zht043/MicroMouse-Team1/README.md

# MicroMouse-Team1

************************************************************************************************************************************

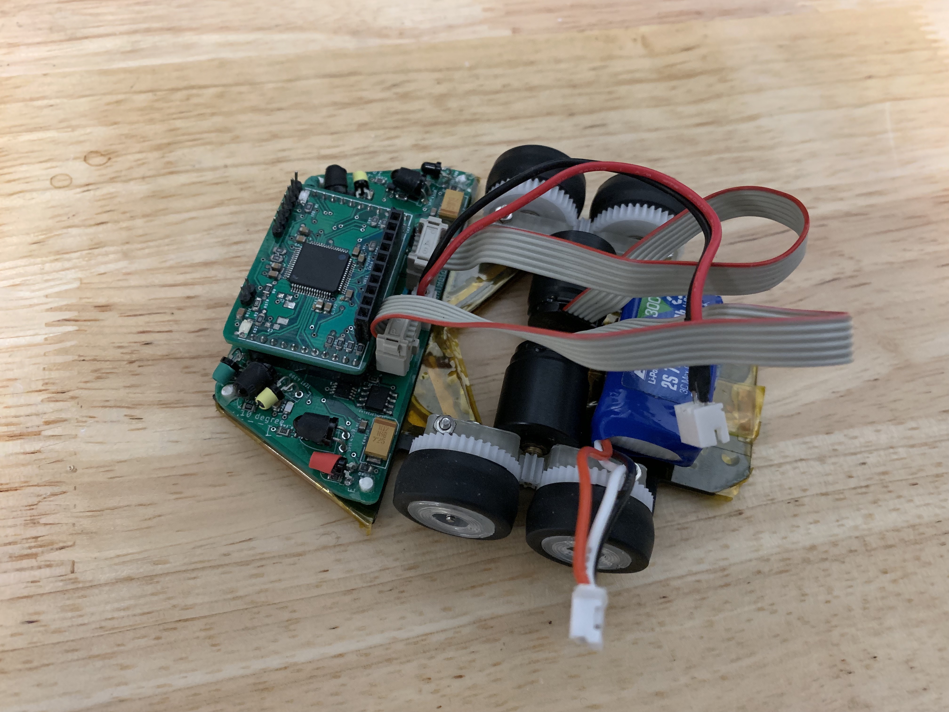
[picture p1: MicromouseRobot.jpg]
Micromouse Robot
