zht043/MicroMouse-Team1/Electrical Hardware/Datasheet/DOWN_ALL.PNG

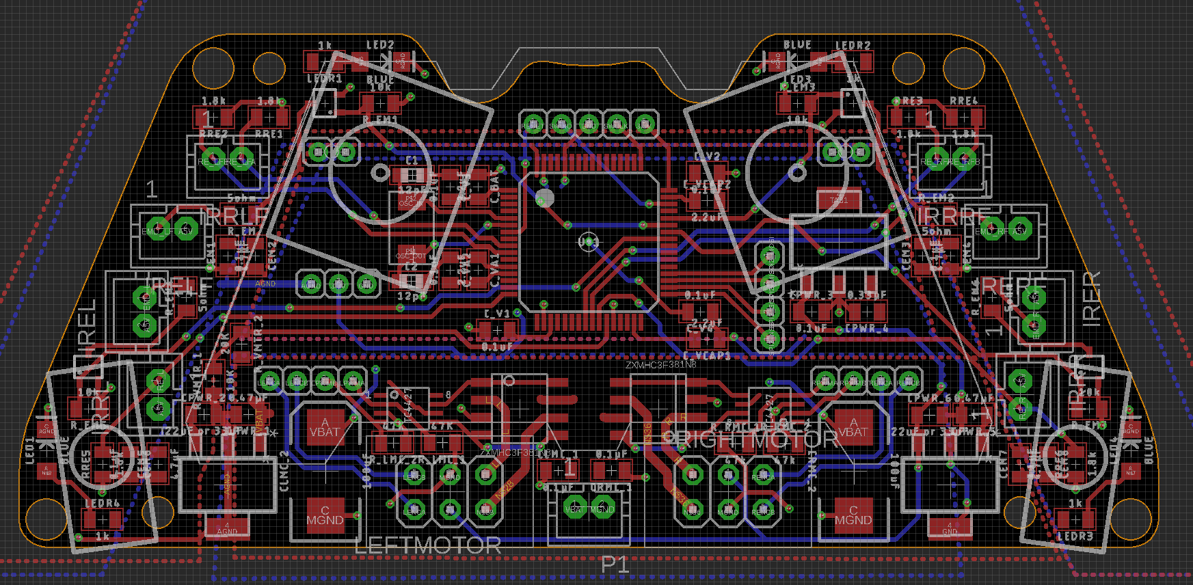
Electrical Hardware/Datasheet/DOWN_ALL.PNG
