zht043/MicroMouse-Team1/Electrical Hardware/Datasheet/DOWN_REST2.PNG

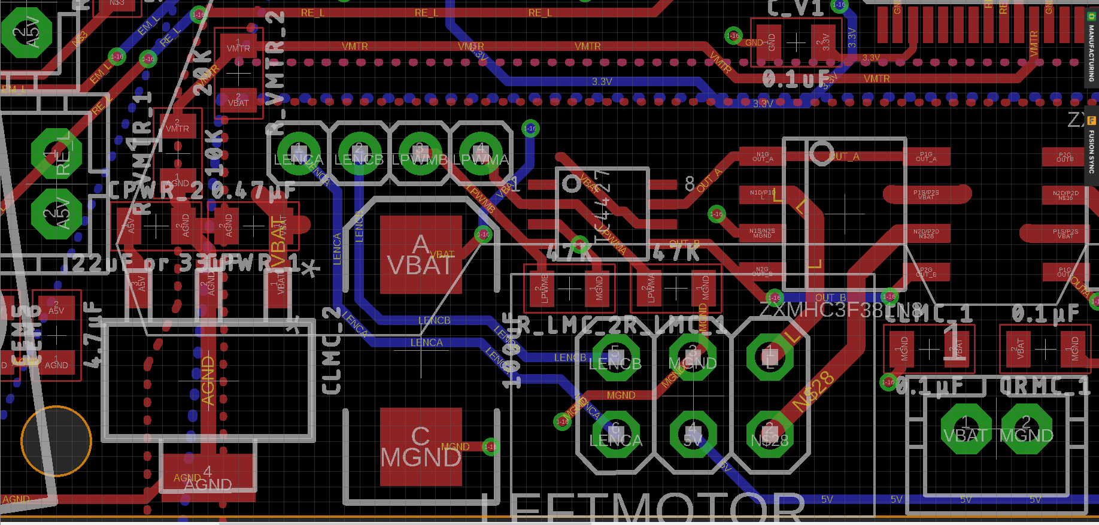
Electrical Hardware/Datasheet/DOWN_REST2.PNG
