zht043/MicroMouse-Team1/Electrical Hardware/Datasheet/DOWN_REST3.PNG

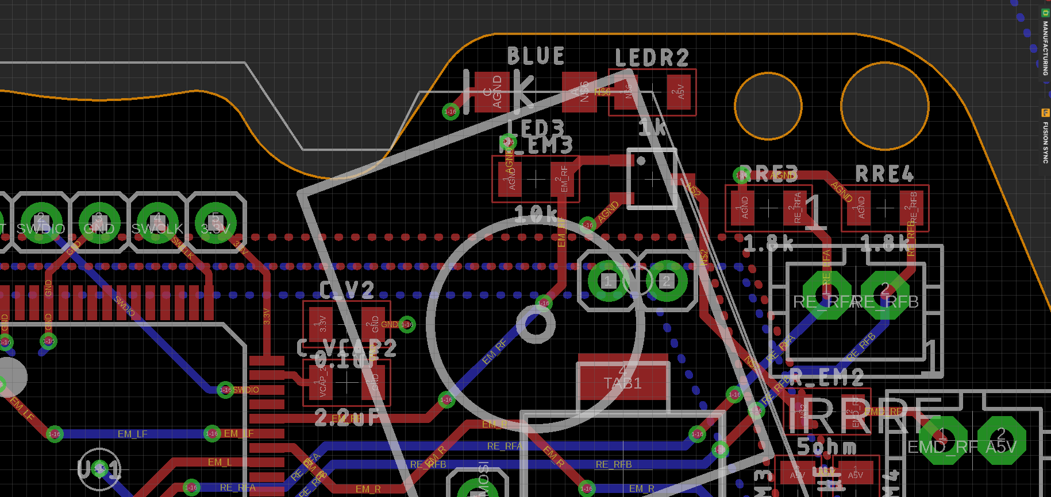
Electrical Hardware/Datasheet/DOWN_REST3.PNG
