zht043/MicroMouse-Team1/Electrical Hardware/Datasheet/DOWN_REST.PNG

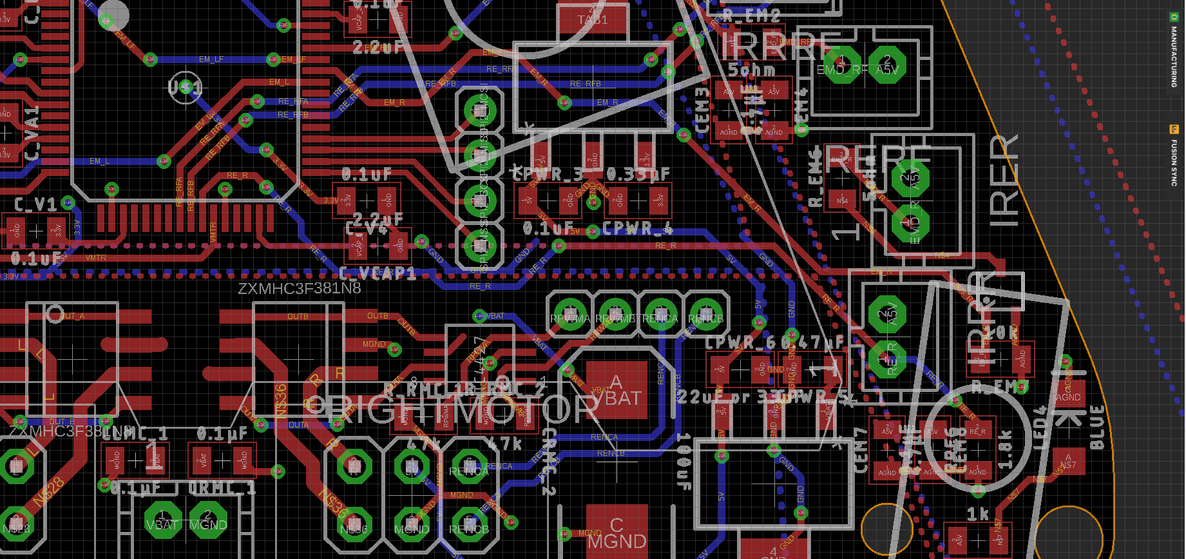
Electrical Hardware/Datasheet/DOWN_REST.PNG
