zht043/MicroMouse-Team1/Electrical Hardware/Datasheet/DOWN_uC.PNG

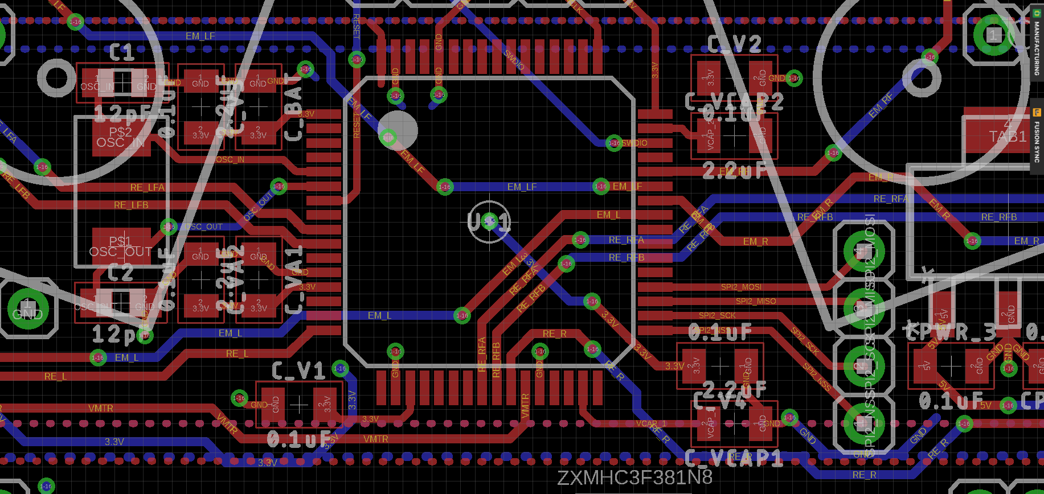
Electrical Hardware/Datasheet/DOWN_uC.PNG
