zht043/MicroMouse-Team1/Electrical Hardware/Datasheet/UP.PNG

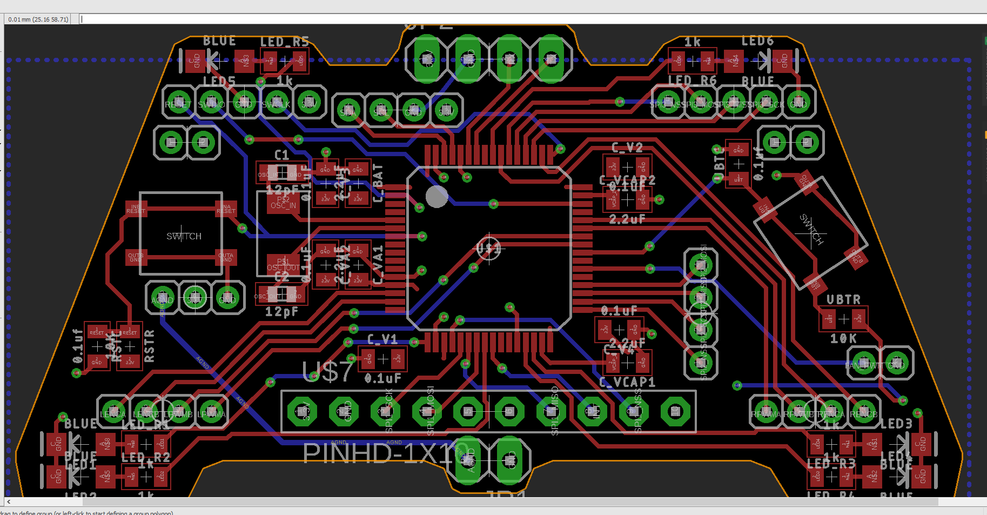
Electrical Hardware/Datasheet/UP.PNG
