zht043/MicroMouse-Team1/Electrical Hardware/Datasheet/UP_SCH.PNG

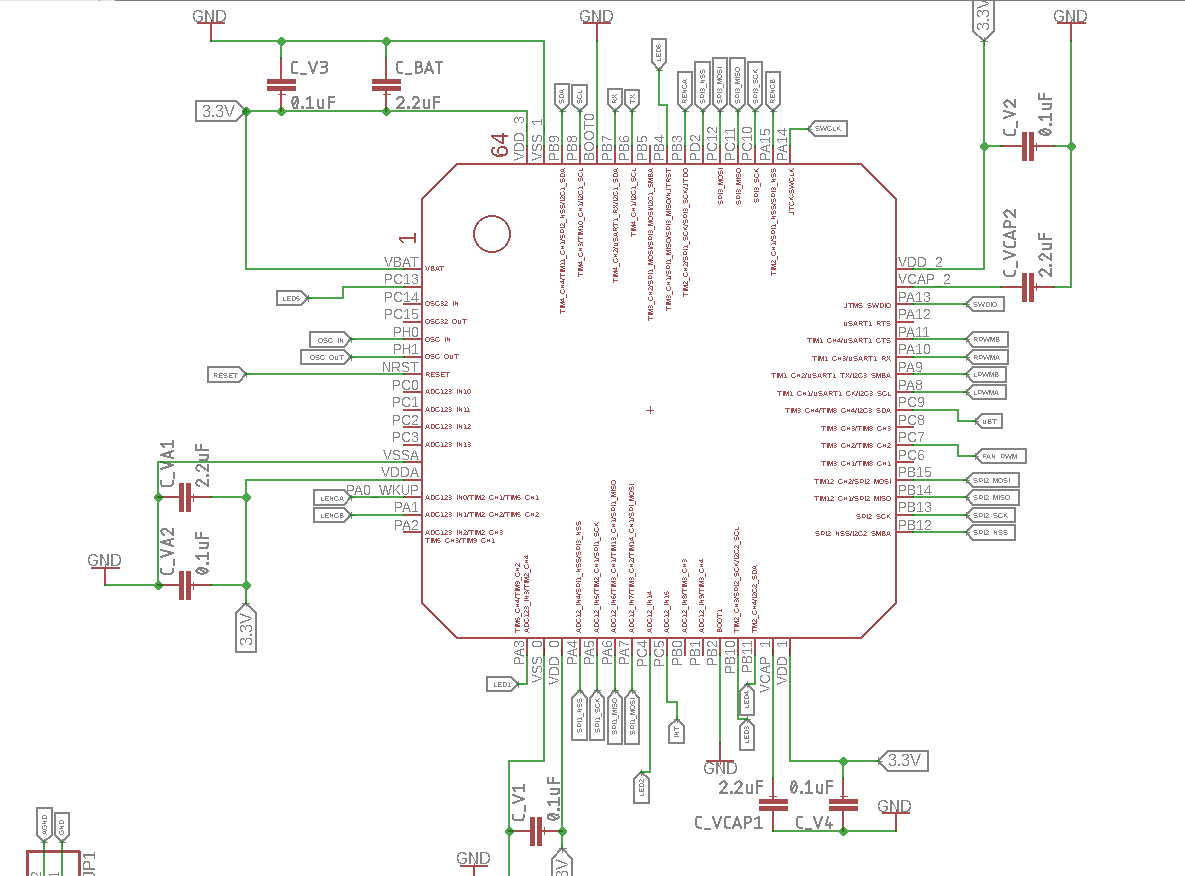
Electrical Hardware/Datasheet/UP_SCH.PNG
