zht043/MicroMouse-Team1/Reference materials/STM32 F4 block diagram.docx

Reference: STM32F40x Datasheet (Doc ID 022152 Rev 3) p. 18

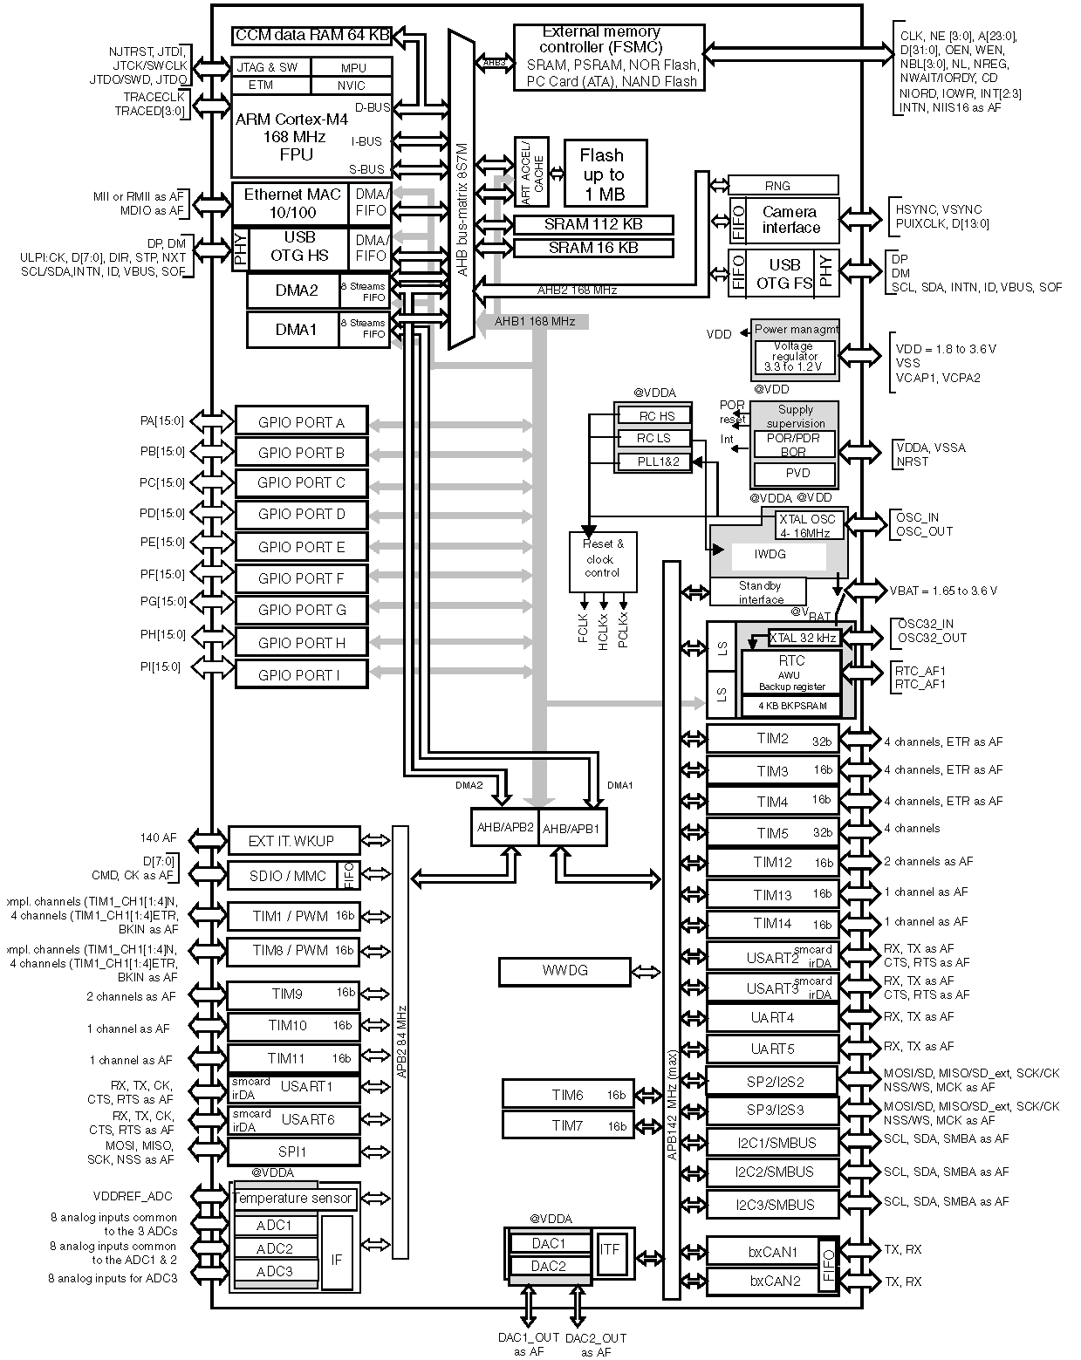
[picture p9: figure]
stm32f40x_block_diagram
