zht043/MicroMouse-Team1/Reference materials/Futura/week-1-lec-2-Peripherals-Intro.pptx

## Lecture 2

Peripharals Hardware Introduction

## IR Emitter Single

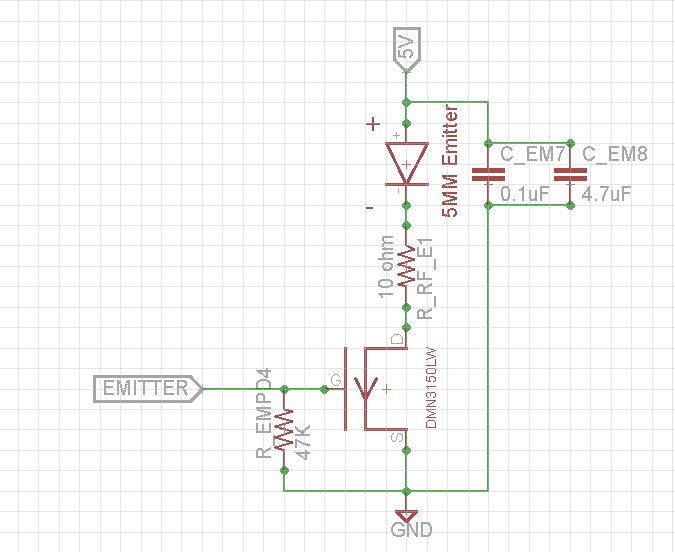
[picture p54: figure]

## Emitter Serial

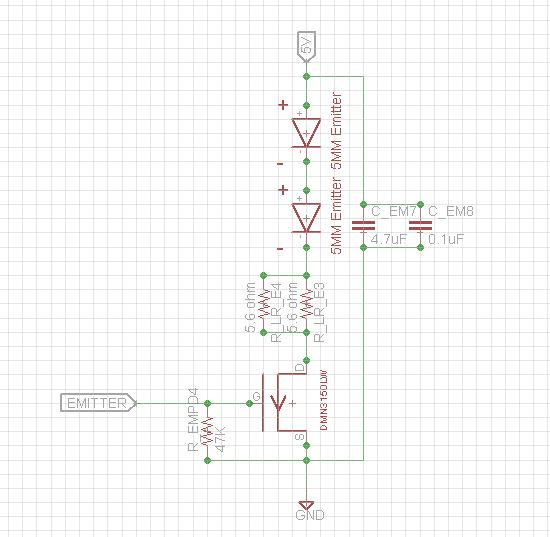
[picture p55: figure]

## IR Receiver

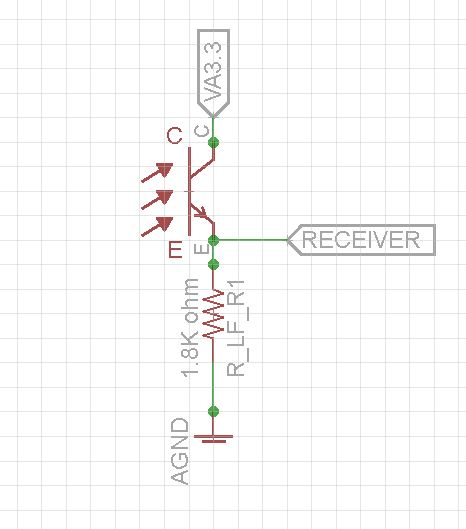
[picture p56: figure]

## IR Sensor Pulsing Timing

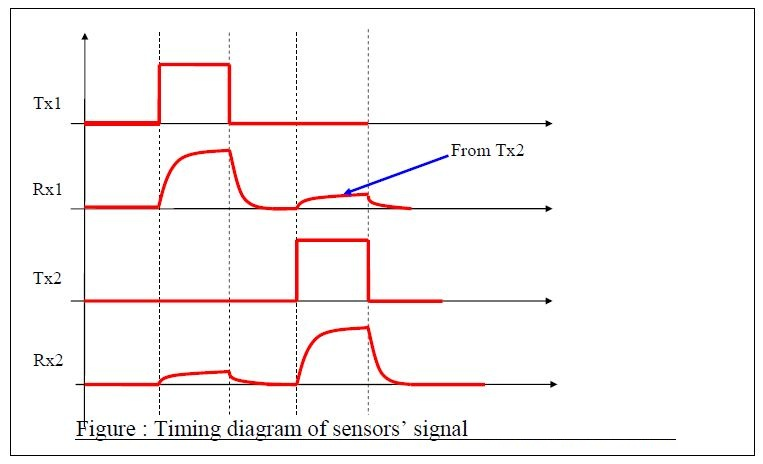
[picture p57: figure]

Delay between each sensor reading until all residues are gone

## Gyro

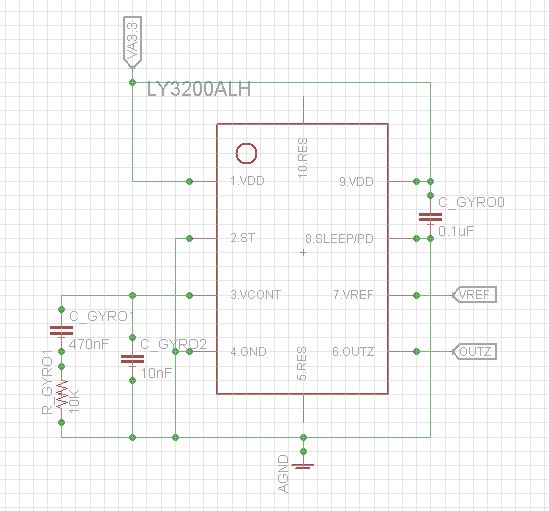
[picture p58: figure]

## Gyro Zero Point Drift

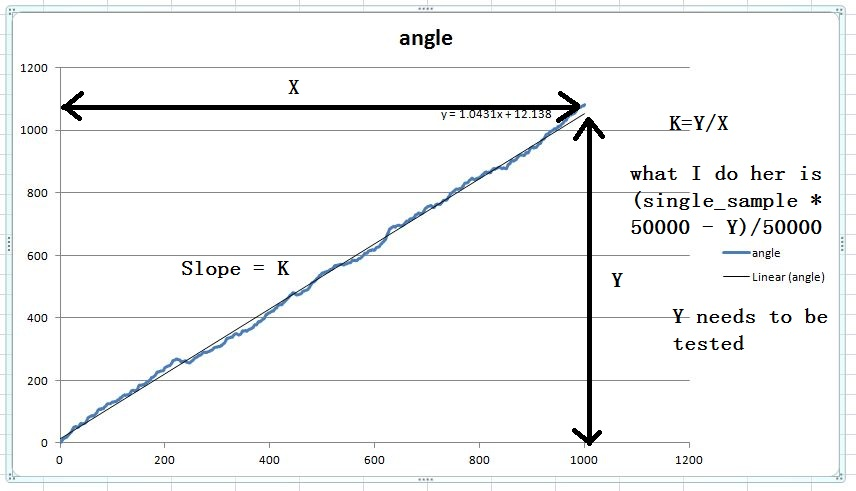
[picture p59: figure]

The accumulated angled when mouse is mouse moving with gyro zero point drifting is increased linearly

## Buzzer

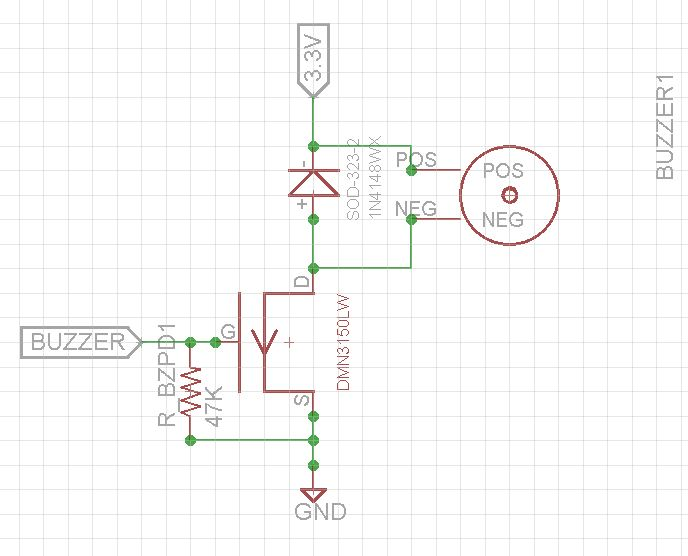
[picture p60: figure]

## Display

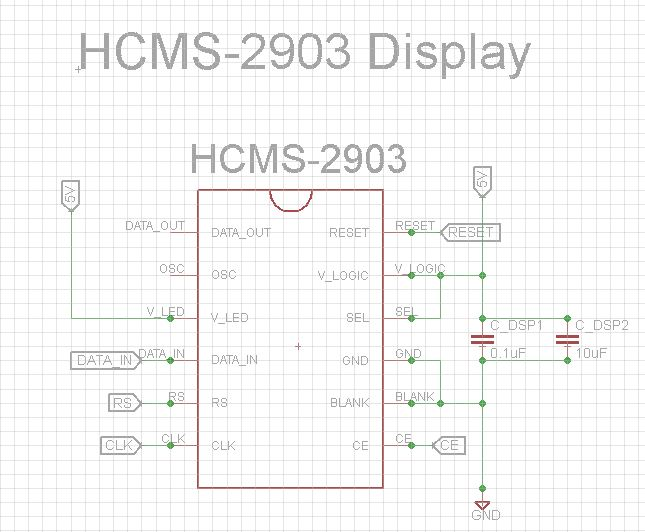
[picture p61: figure]

## Motor Driver

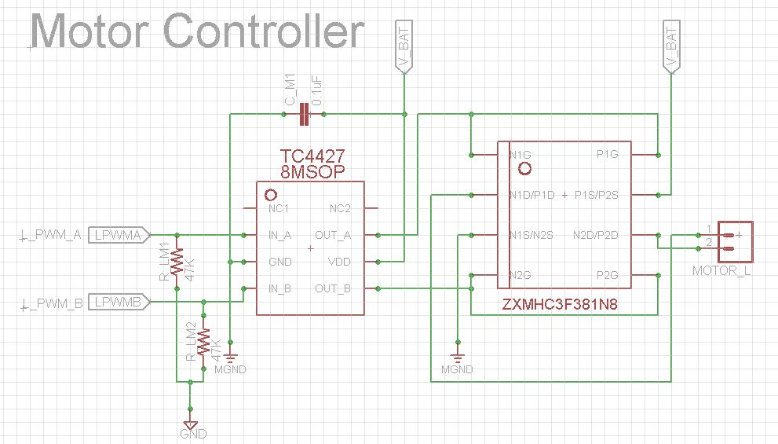
[picture p62: figure]

## Voltage Meter

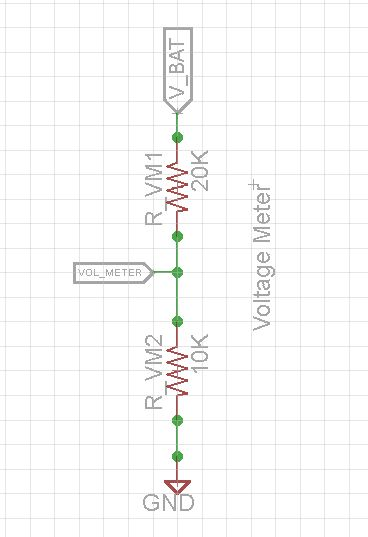
[picture p63: figure]

Keep track of the battery voltage to protect the batter from over discharging

## Power V_bat

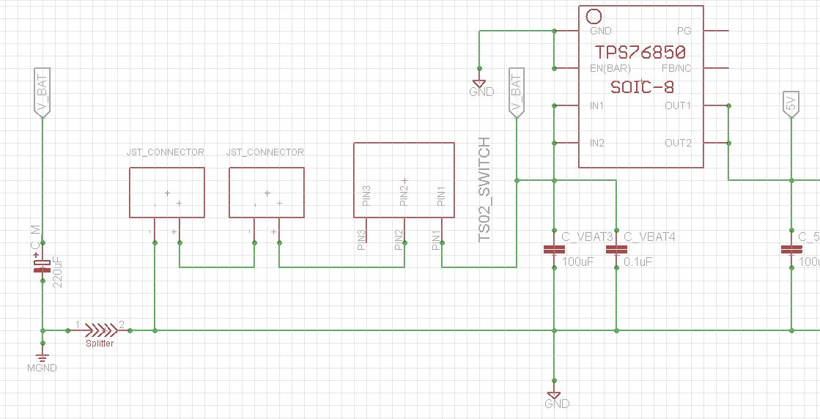
[picture p64: figure]

## Power 5V

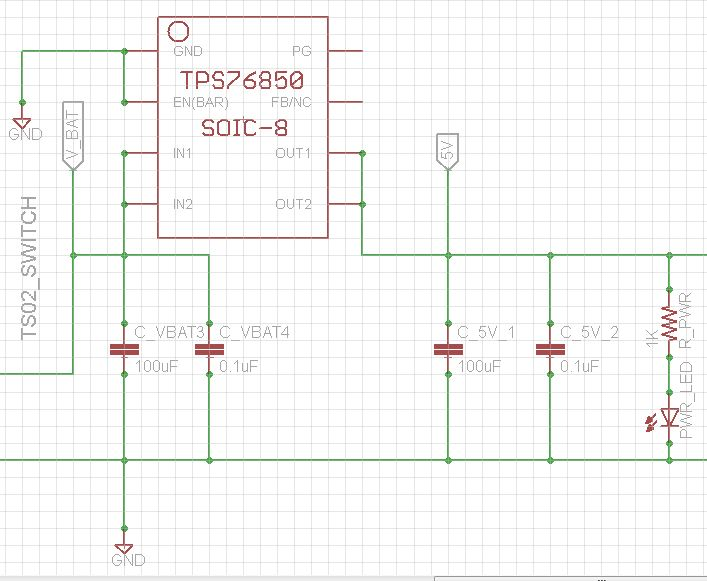
[picture p65: figure]

## Power 3.3V

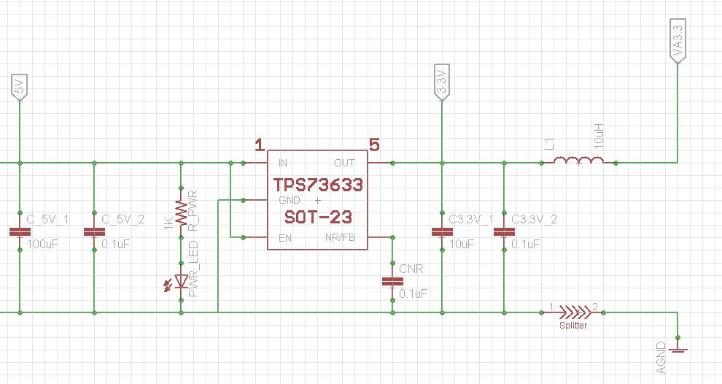
[picture p66: figure]
