zht043/MicroMouse-Team1/Reference materials/DMA Mapping.docx

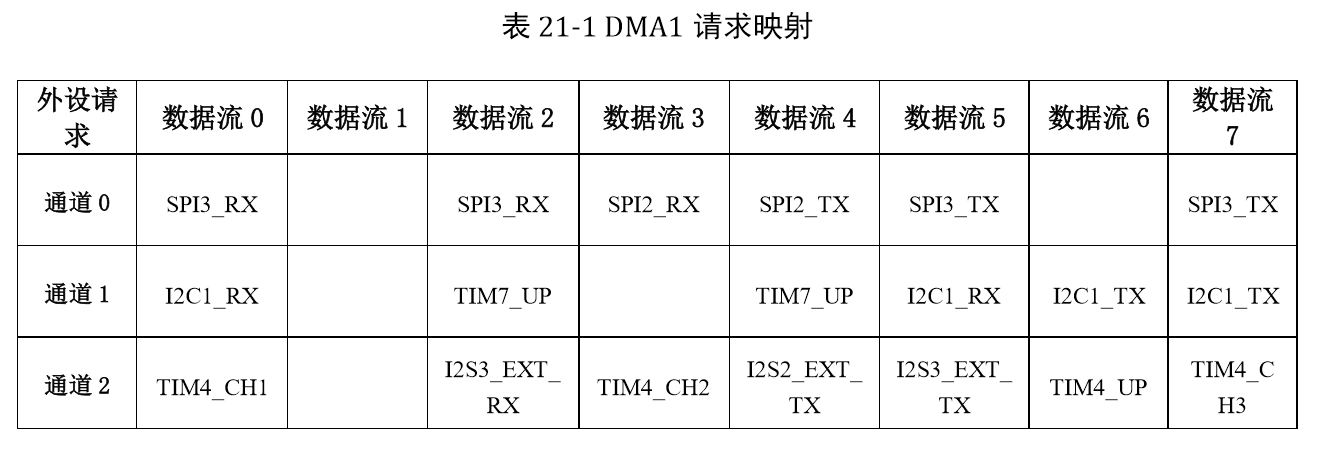
[picture p67: figure]
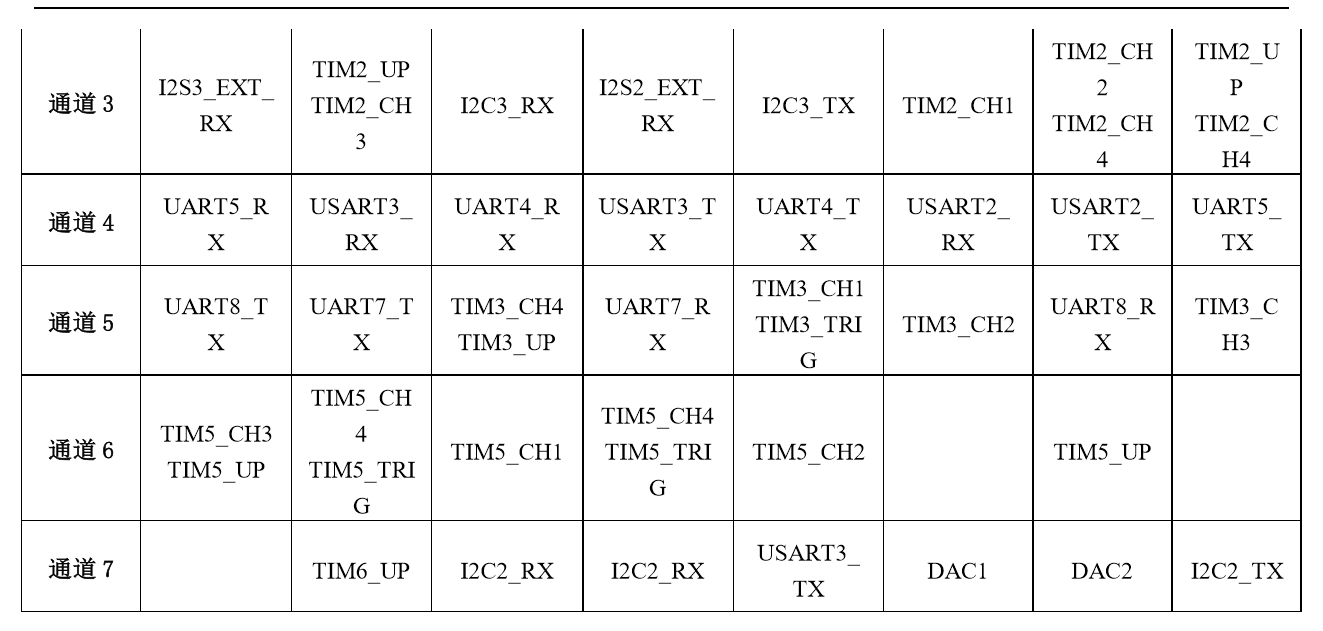
[picture p68: figure]
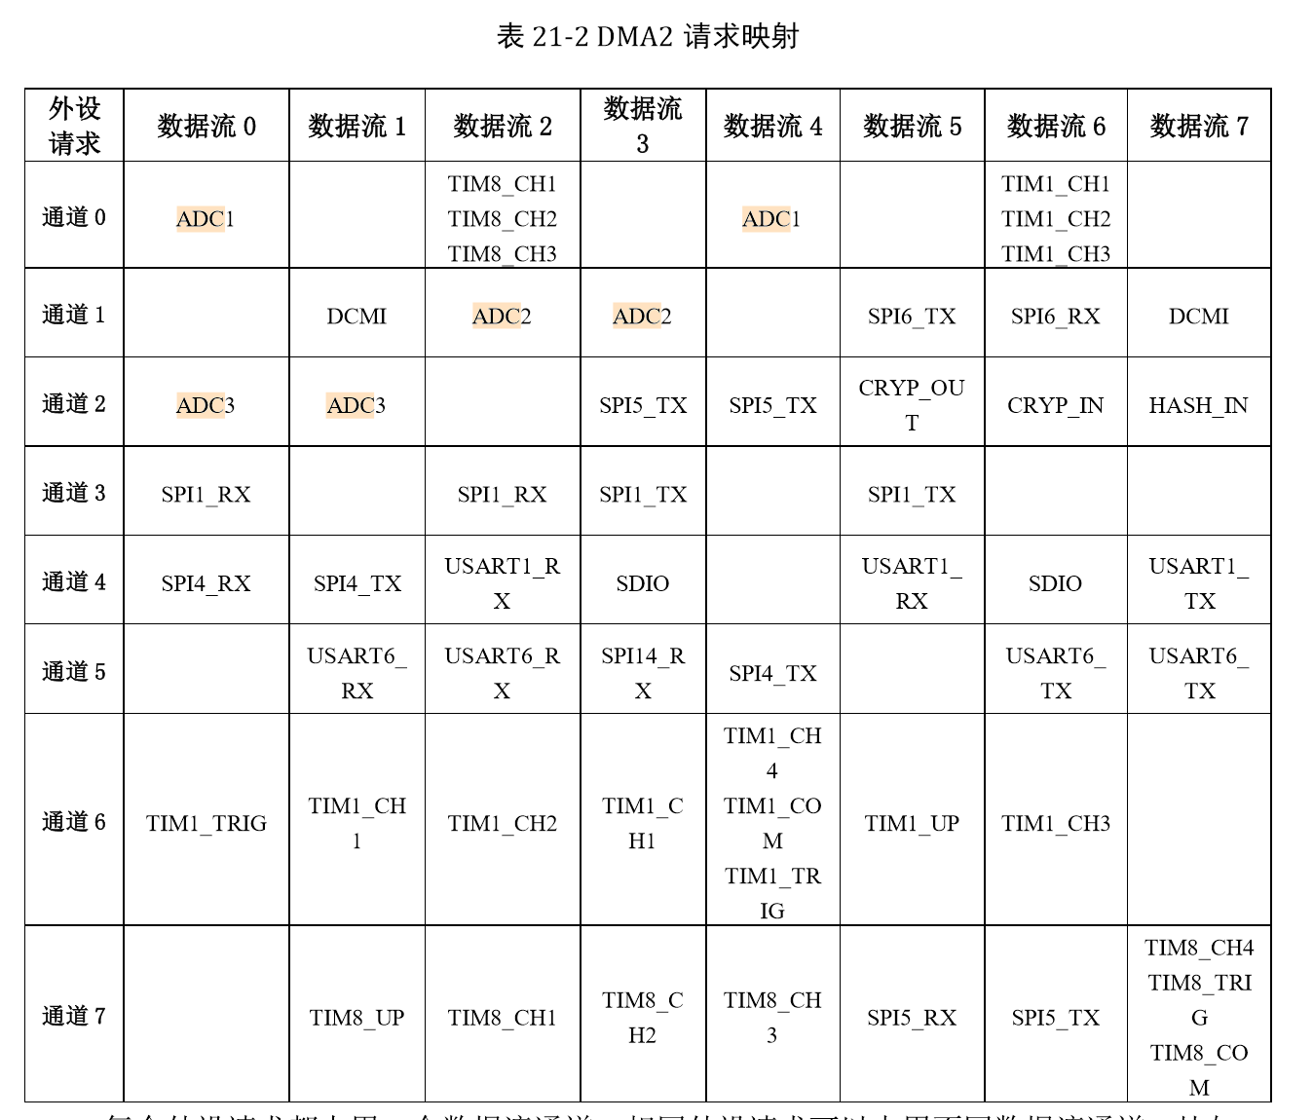
[picture p69: figure]
