zht043/MicroMouse-Team1/Reference materials/Capture2.PNG

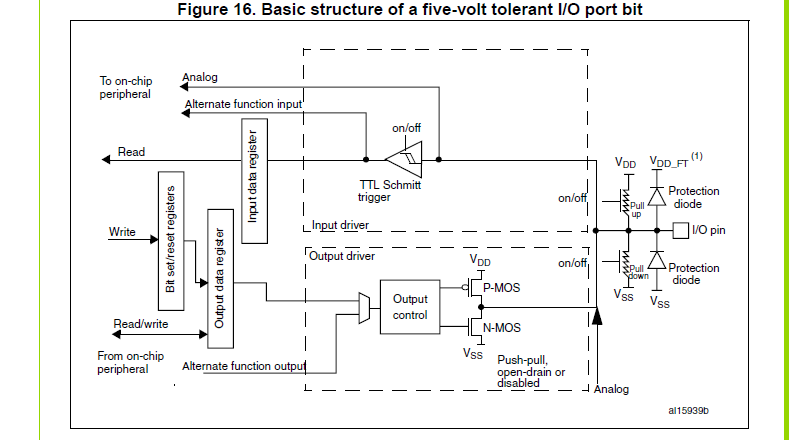
Reference materials/Capture2.PNG
