zht043/MicroMouse-Team1/Reference materials/Capture3.PNG

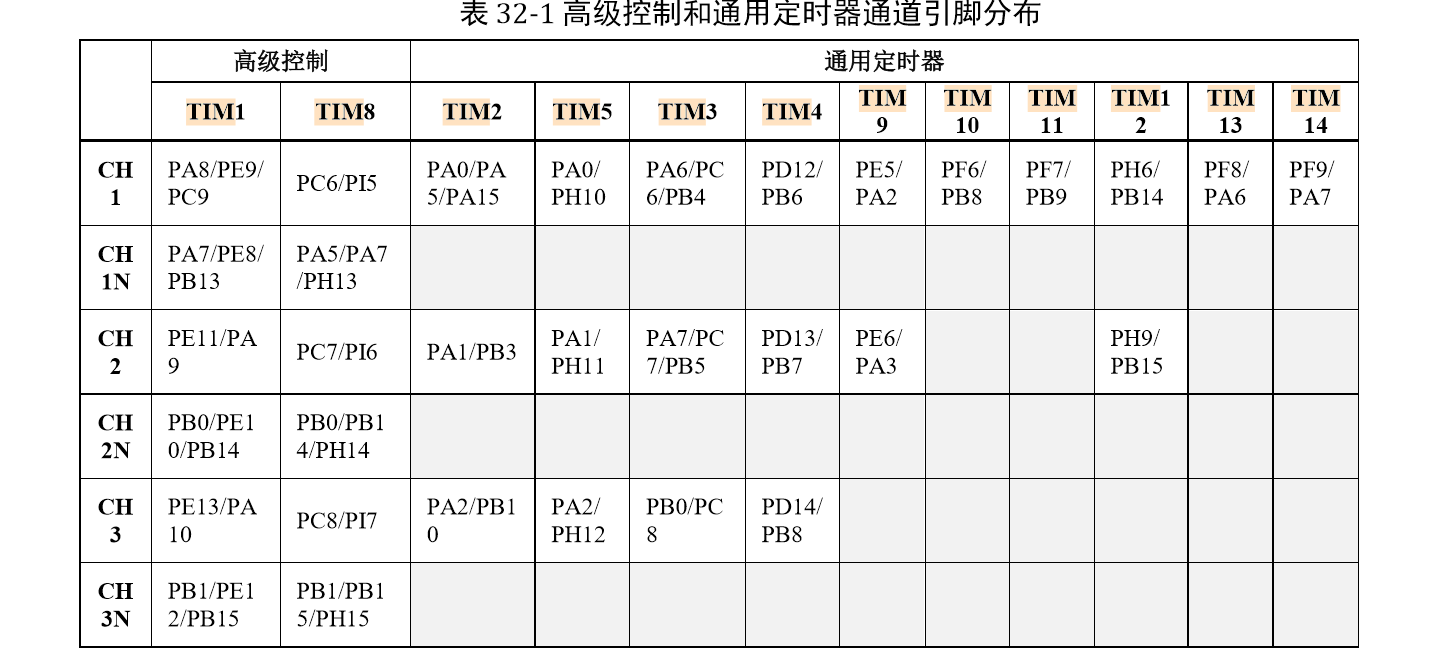
Reference materials/Capture3.PNG
