zht043/MicroMouse-Team1/Reference materials/Capture4.PNG

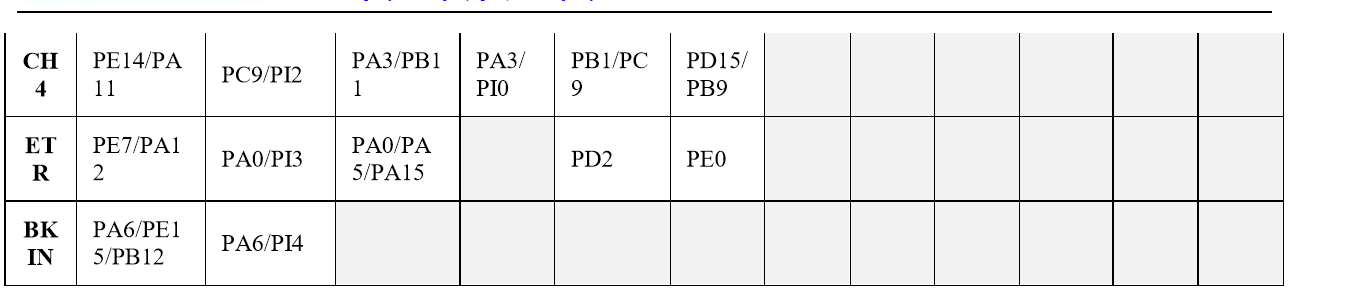
Reference materials/Capture4.PNG
