zht043/MicroMouse-Team1/Reference materials/Capture.PNG

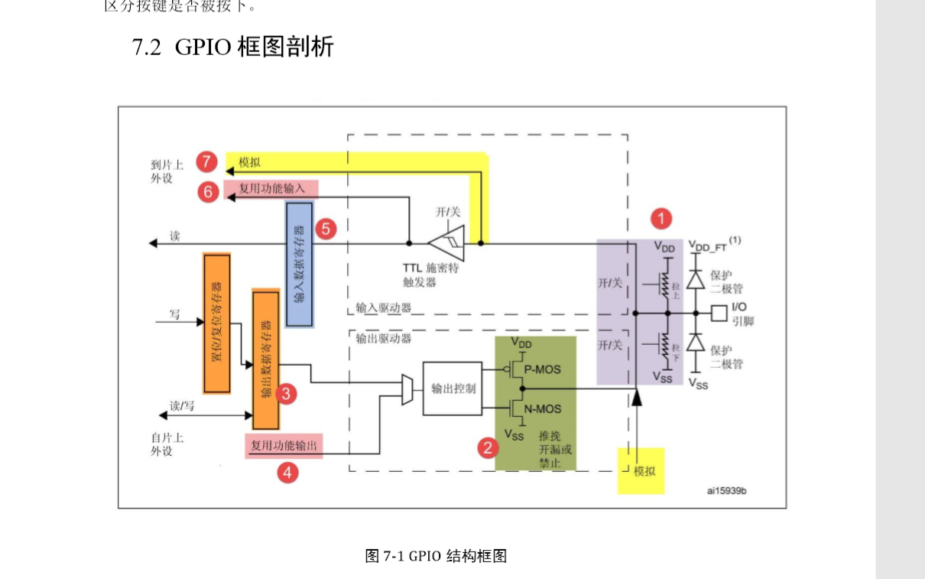
Reference materials/Capture.PNG
