zht043/MicroMouse-Team1/Reference materials/Pin_reference.jpg

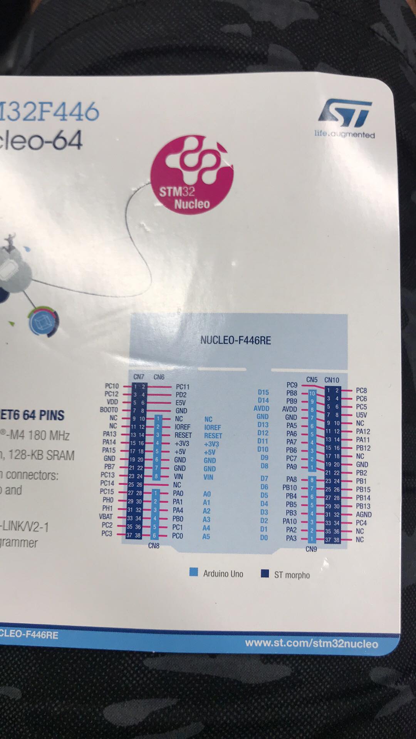
Reference materials/Pin_reference.jpg
