zht043/MicroMouse-Team1/Reference materials/stlink2.png

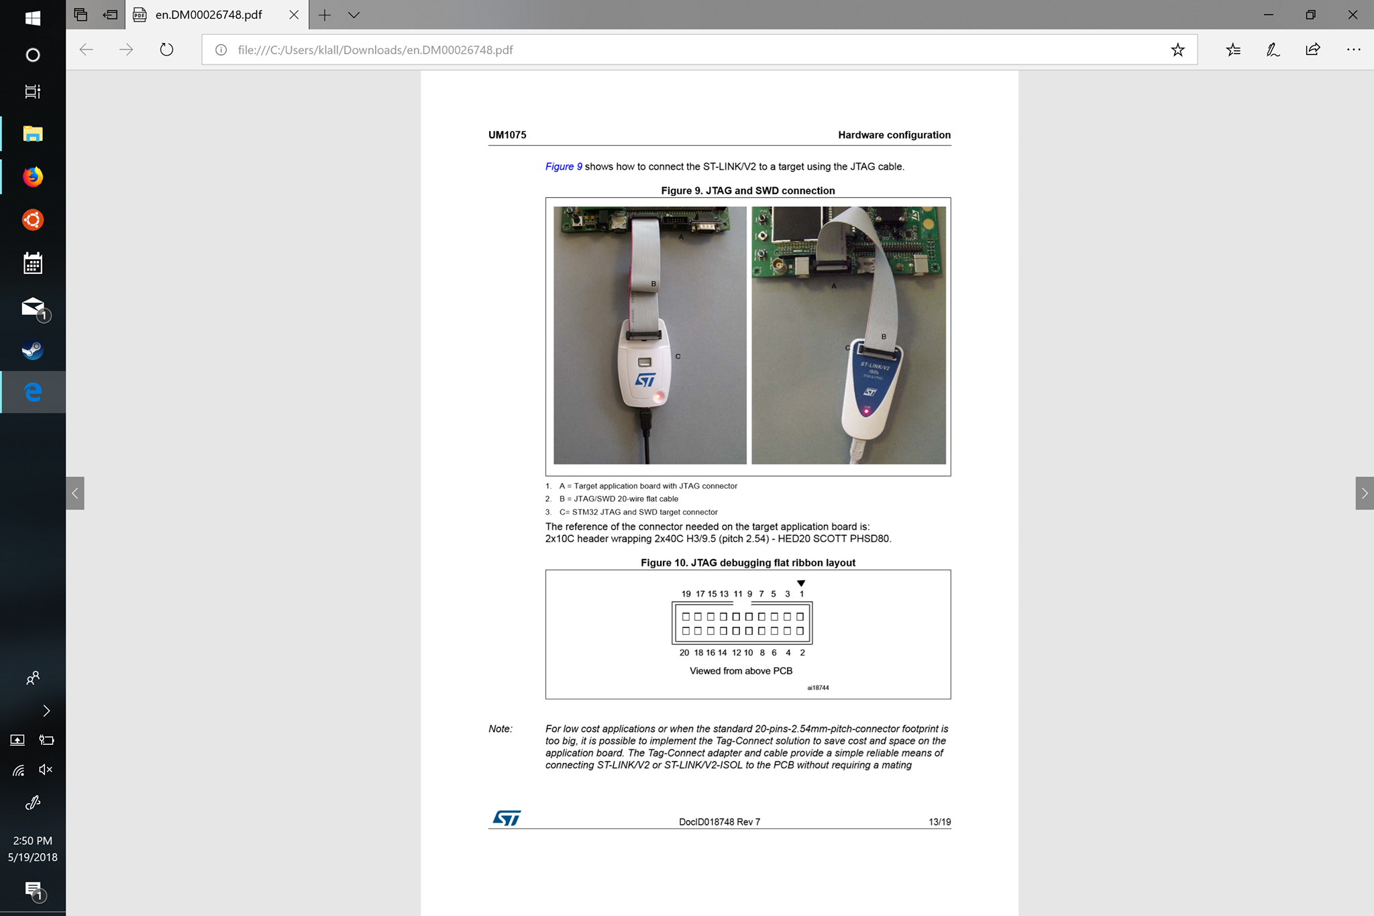
Reference materials/stlink2.png
