zht043/MicroMouse-Team1/Reference materials/stlink.png

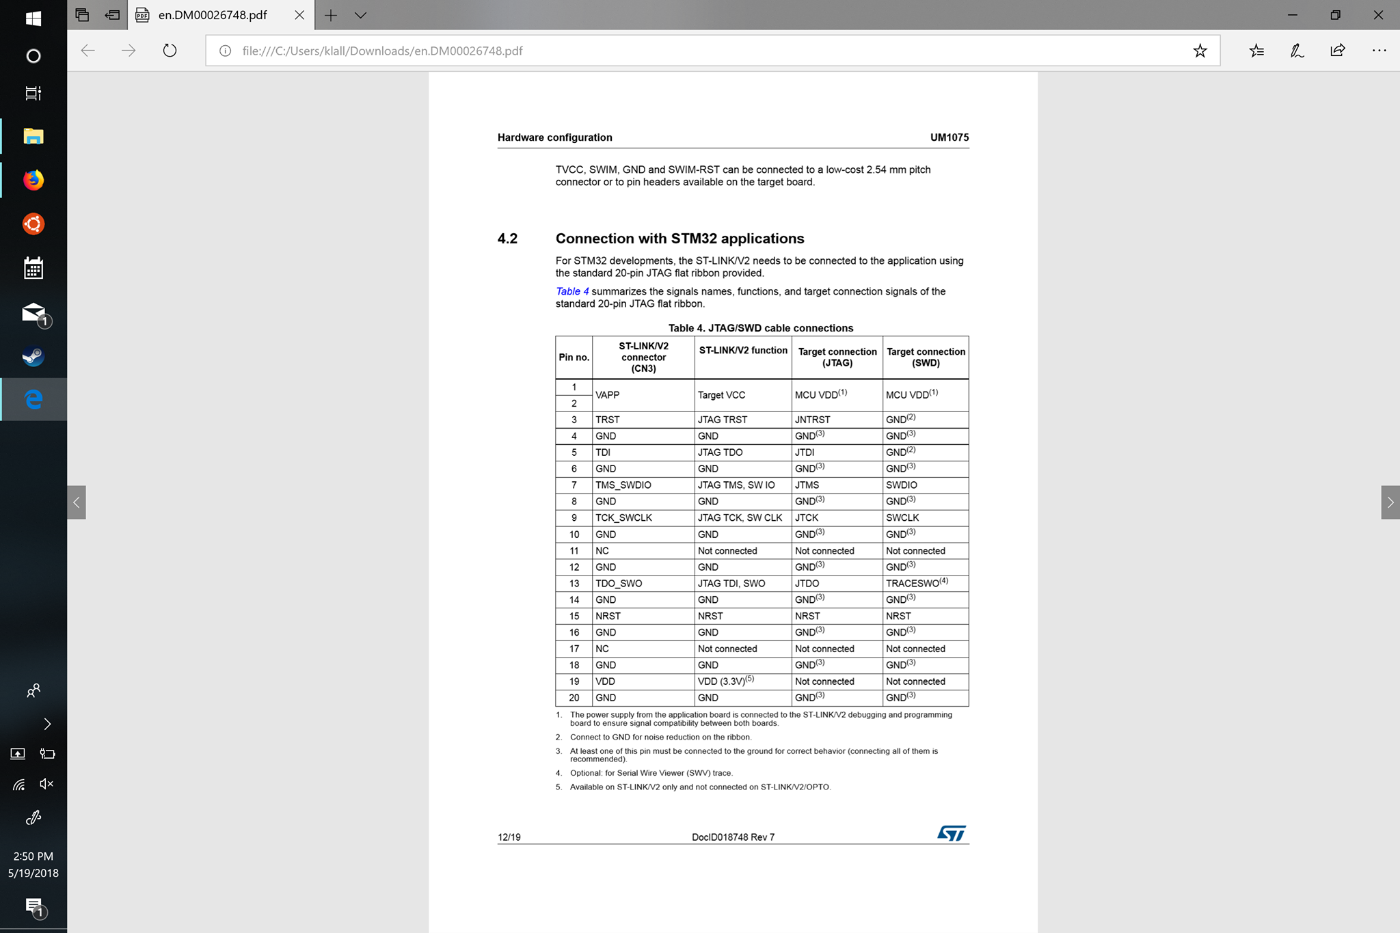
Reference materials/stlink.png
