zht043/MicroMouse-Team1/Mechanical Hardware/dxf files/ChassisFInalVersion.dxf

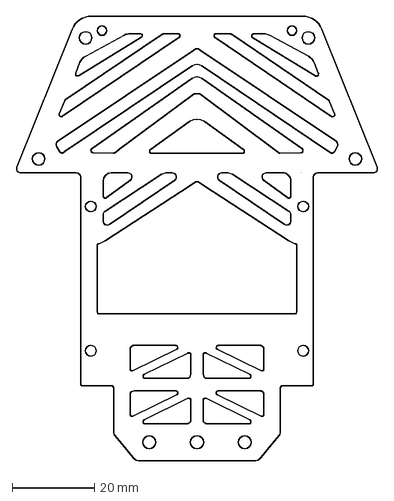
[picture p81: CAD file, 2018-03-11]
Mechanical Hardware/dxf files/ChassisFInalVersion.dxf
87.6 x 107.9 mm
