zht043/MicroMouse-Team1/Reference materials/Futura/FuturaProject/obj/micromouse_test.htm

# Static Call Graph for image ..\obj\micromouse_test.axf

#<CALLGRAPH># ARM Linker, 5.03 [Build 24]: Last Updated: Fri Feb 03 22:17:40 2017

### Maximum Stack Usage = 320 bytes + Unknown(Functions without stacksize, Cycles, Untraceable Function Pointers)

### Call chain for Maximum Stack Depth:

_printf_f ⇒ _printf_fp_dec ⇒ _printf_fp_dec_real ⇒ _fp_digits ⇒ _btod_etento ⇒ _btod_emul ⇒ _e2e

### Functions with no stack information

- __user_initial_stackheap

### Mutually Recursive functions

- ADC_IRQHandler ⇒ ADC_IRQHandler

### Function Pointers

- ADC_IRQHandler from startup_stm32f4xx.o(.text) referenced from startup_stm32f4xx.o(RESET)
- BusFault_Handler from stm32f4xx_it.o(.text) referenced from startup_stm32f4xx.o(RESET)
- CAN1_RX0_IRQHandler from startup_stm32f4xx.o(.text) referenced from startup_stm32f4xx.o(RESET)
- CAN1_RX1_IRQHandler from startup_stm32f4xx.o(.text) referenced from startup_stm32f4xx.o(RESET)
- CAN1_SCE_IRQHandler from startup_stm32f4xx.o(.text) referenced from startup_stm32f4xx.o(RESET)
- CAN1_TX_IRQHandler from startup_stm32f4xx.o(.text) referenced from startup_stm32f4xx.o(RESET)
- CAN2_RX0_IRQHandler from startup_stm32f4xx.o(.text) referenced from startup_stm32f4xx.o(RESET)
- CAN2_RX1_IRQHandler from startup_stm32f4xx.o(.text) referenced from startup_stm32f4xx.o(RESET)
- CAN2_SCE_IRQHandler from startup_stm32f4xx.o(.text) referenced from startup_stm32f4xx.o(RESET)
- CAN2_TX_IRQHandler from startup_stm32f4xx.o(.text) referenced from startup_stm32f4xx.o(RESET)
- CRYP_IRQHandler from startup_stm32f4xx.o(.text) referenced from startup_stm32f4xx.o(RESET)
- DCMI_IRQHandler from startup_stm32f4xx.o(.text) referenced from startup_stm32f4xx.o(RESET)
- DMA1_Stream0_IRQHandler from startup_stm32f4xx.o(.text) referenced from startup_stm32f4xx.o(RESET)
- DMA1_Stream1_IRQHandler from startup_stm32f4xx.o(.text) referenced from startup_stm32f4xx.o(RESET)
- DMA1_Stream2_IRQHandler from startup_stm32f4xx.o(.text) referenced from startup_stm32f4xx.o(RESET)
- DMA1_Stream3_IRQHandler from startup_stm32f4xx.o(.text) referenced from startup_stm32f4xx.o(RESET)
- DMA1_Stream4_IRQHandler from startup_stm32f4xx.o(.text) referenced from startup_stm32f4xx.o(RESET)
- DMA1_Stream5_IRQHandler from startup_stm32f4xx.o(.text) referenced from startup_stm32f4xx.o(RESET)
- DMA1_Stream6_IRQHandler from startup_stm32f4xx.o(.text) referenced from startup_stm32f4xx.o(RESET)
- DMA1_Stream7_IRQHandler from startup_stm32f4xx.o(.text) referenced from startup_stm32f4xx.o(RESET)
- DMA2_Stream0_IRQHandler from startup_stm32f4xx.o(.text) referenced from startup_stm32f4xx.o(RESET)
- DMA2_Stream1_IRQHandler from startup_stm32f4xx.o(.text) referenced from startup_stm32f4xx.o(RESET)
- DMA2_Stream2_IRQHandler from startup_stm32f4xx.o(.text) referenced from startup_stm32f4xx.o(RESET)
- DMA2_Stream3_IRQHandler from startup_stm32f4xx.o(.text) referenced from startup_stm32f4xx.o(RESET)
- DMA2_Stream4_IRQHandler from startup_stm32f4xx.o(.text) referenced from startup_stm32f4xx.o(RESET)
- DMA2_Stream5_IRQHandler from startup_stm32f4xx.o(.text) referenced from startup_stm32f4xx.o(RESET)
- DMA2_Stream6_IRQHandler from startup_stm32f4xx.o(.text) referenced from startup_stm32f4xx.o(RESET)
- DMA2_Stream7_IRQHandler from startup_stm32f4xx.o(.text) referenced from startup_stm32f4xx.o(RESET)
- DebugMon_Handler from stm32f4xx_it.o(.text) referenced from startup_stm32f4xx.o(RESET)
- ETH_IRQHandler from startup_stm32f4xx.o(.text) referenced from startup_stm32f4xx.o(RESET)
- ETH_WKUP_IRQHandler from startup_stm32f4xx.o(.text) referenced from startup_stm32f4xx.o(RESET)
- EXTI0_IRQHandler from startup_stm32f4xx.o(.text) referenced from startup_stm32f4xx.o(RESET)
- EXTI15_10_IRQHandler from stm32f4xx_it.o(.text) referenced from startup_stm32f4xx.o(RESET)
- EXTI1_IRQHandler from startup_stm32f4xx.o(.text) referenced from startup_stm32f4xx.o(RESET)
- EXTI2_IRQHandler from startup_stm32f4xx.o(.text) referenced from startup_stm32f4xx.o(RESET)
- EXTI3_IRQHandler from startup_stm32f4xx.o(.text) referenced from startup_stm32f4xx.o(RESET)
- EXTI4_IRQHandler from startup_stm32f4xx.o(.text) referenced from startup_stm32f4xx.o(RESET)
- EXTI9_5_IRQHandler from stm32f4xx_it.o(.text) referenced from startup_stm32f4xx.o(RESET)
- FLASH_IRQHandler from startup_stm32f4xx.o(.text) referenced from startup_stm32f4xx.o(RESET)
- FPU_IRQHandler from startup_stm32f4xx.o(.text) referenced from startup_stm32f4xx.o(RESET)
- FSMC_IRQHandler from startup_stm32f4xx.o(.text) referenced from startup_stm32f4xx.o(RESET)
- HASH_RNG_IRQHandler from startup_stm32f4xx.o(.text) referenced from startup_stm32f4xx.o(RESET)
- HardFault_Handler from stm32f4xx_it.o(.text) referenced from startup_stm32f4xx.o(RESET)
- I2C1_ER_IRQHandler from startup_stm32f4xx.o(.text) referenced from startup_stm32f4xx.o(RESET)
- I2C1_EV_IRQHandler from startup_stm32f4xx.o(.text) referenced from startup_stm32f4xx.o(RESET)
- I2C2_ER_IRQHandler from startup_stm32f4xx.o(.text) referenced from startup_stm32f4xx.o(RESET)
- I2C2_EV_IRQHandler from startup_stm32f4xx.o(.text) referenced from startup_stm32f4xx.o(RESET)
- I2C3_ER_IRQHandler from startup_stm32f4xx.o(.text) referenced from startup_stm32f4xx.o(RESET)
- I2C3_EV_IRQHandler from startup_stm32f4xx.o(.text) referenced from startup_stm32f4xx.o(RESET)
- MemManage_Handler from stm32f4xx_it.o(.text) referenced from startup_stm32f4xx.o(RESET)
- NMI_Handler from stm32f4xx_it.o(.text) referenced from startup_stm32f4xx.o(RESET)
- OTG_FS_IRQHandler from startup_stm32f4xx.o(.text) referenced from startup_stm32f4xx.o(RESET)
- OTG_FS_WKUP_IRQHandler from startup_stm32f4xx.o(.text) referenced from startup_stm32f4xx.o(RESET)
- OTG_HS_EP1_IN_IRQHandler from startup_stm32f4xx.o(.text) referenced from startup_stm32f4xx.o(RESET)
- OTG_HS_EP1_OUT_IRQHandler from startup_stm32f4xx.o(.text) referenced from startup_stm32f4xx.o(RESET)
- OTG_HS_IRQHandler from startup_stm32f4xx.o(.text) referenced from startup_stm32f4xx.o(RESET)
- OTG_HS_WKUP_IRQHandler from startup_stm32f4xx.o(.text) referenced from startup_stm32f4xx.o(RESET)
- PVD_IRQHandler from startup_stm32f4xx.o(.text) referenced from startup_stm32f4xx.o(RESET)
- PendSV_Handler from stm32f4xx_it.o(.text) referenced from startup_stm32f4xx.o(RESET)
- RCC_IRQHandler from startup_stm32f4xx.o(.text) referenced from startup_stm32f4xx.o(RESET)
- RTC_Alarm_IRQHandler from startup_stm32f4xx.o(.text) referenced from startup_stm32f4xx.o(RESET)
- RTC_WKUP_IRQHandler from startup_stm32f4xx.o(.text) referenced from startup_stm32f4xx.o(RESET)
- Reset_Handler from startup_stm32f4xx.o(.text) referenced from startup_stm32f4xx.o(RESET)
- SDIO_IRQHandler from startup_stm32f4xx.o(.text) referenced from startup_stm32f4xx.o(RESET)
- SPI1_IRQHandler from startup_stm32f4xx.o(.text) referenced from startup_stm32f4xx.o(RESET)
- SPI2_IRQHandler from startup_stm32f4xx.o(.text) referenced from startup_stm32f4xx.o(RESET)
- SPI3_IRQHandler from startup_stm32f4xx.o(.text) referenced from startup_stm32f4xx.o(RESET)
- SVC_Handler from stm32f4xx_it.o(.text) referenced from startup_stm32f4xx.o(RESET)
- SysTick_Handler from stm32f4xx_it.o(.text) referenced from startup_stm32f4xx.o(RESET)
- SystemInit from system_stm32f4xx.o(.text) referenced from startup_stm32f4xx.o(.text)
- TAMP_STAMP_IRQHandler from startup_stm32f4xx.o(.text) referenced from startup_stm32f4xx.o(RESET)
- TIM1_BRK_TIM9_IRQHandler from startup_stm32f4xx.o(.text) referenced from startup_stm32f4xx.o(RESET)
- TIM1_CC_IRQHandler from startup_stm32f4xx.o(.text) referenced from startup_stm32f4xx.o(RESET)
- TIM1_TRG_COM_TIM11_IRQHandler from startup_stm32f4xx.o(.text) referenced from startup_stm32f4xx.o(RESET)
- TIM1_UP_TIM10_IRQHandler from startup_stm32f4xx.o(.text) referenced from startup_stm32f4xx.o(RESET)
- TIM2_IRQHandler from startup_stm32f4xx.o(.text) referenced from startup_stm32f4xx.o(RESET)
- TIM3_IRQHandler from startup_stm32f4xx.o(.text) referenced from startup_stm32f4xx.o(RESET)
- TIM4_IRQHandler from startup_stm32f4xx.o(.text) referenced from startup_stm32f4xx.o(RESET)
- TIM5_IRQHandler from startup_stm32f4xx.o(.text) referenced from startup_stm32f4xx.o(RESET)
- TIM6_DAC_IRQHandler from startup_stm32f4xx.o(.text) referenced from startup_stm32f4xx.o(RESET)
- TIM7_IRQHandler from startup_stm32f4xx.o(.text) referenced from startup_stm32f4xx.o(RESET)
- TIM8_BRK_TIM12_IRQHandler from startup_stm32f4xx.o(.text) referenced from startup_stm32f4xx.o(RESET)
- TIM8_CC_IRQHandler from startup_stm32f4xx.o(.text) referenced from startup_stm32f4xx.o(RESET)
- TIM8_TRG_COM_TIM14_IRQHandler from startup_stm32f4xx.o(.text) referenced from startup_stm32f4xx.o(RESET)
- TIM8_UP_TIM13_IRQHandler from startup_stm32f4xx.o(.text) referenced from startup_stm32f4xx.o(RESET)
- UART4_IRQHandler from startup_stm32f4xx.o(.text) referenced from startup_stm32f4xx.o(RESET)
- UART5_IRQHandler from startup_stm32f4xx.o(.text) referenced from startup_stm32f4xx.o(RESET)
- USART1_IRQHandler from startup_stm32f4xx.o(.text) referenced from startup_stm32f4xx.o(RESET)
- USART2_IRQHandler from startup_stm32f4xx.o(.text) referenced from startup_stm32f4xx.o(RESET)
- USART3_IRQHandler from startup_stm32f4xx.o(.text) referenced from startup_stm32f4xx.o(RESET)
- USART6_IRQHandler from startup_stm32f4xx.o(.text) referenced from startup_stm32f4xx.o(RESET)
- UsageFault_Handler from stm32f4xx_it.o(.text) referenced from startup_stm32f4xx.o(RESET)
- WWDG_IRQHandler from startup_stm32f4xx.o(.text) referenced from startup_stm32f4xx.o(RESET)
- __backspace from backspace.o(.text) referenced from scanf_char_file.o(.text)
- __main from __main.o(!!!main) referenced from startup_stm32f4xx.o(.text)
- _get_lc_ctype from lc_ctype_c.o(locale$$code) referenced from rt_ctype_table.o(.text)
- _printf_input_char from _printf_char_common.o(.text) referenced from _printf_char_common.o(.text)
- _scanf_char_input from scanf_char.o(.text) referenced from scanf_char.o(.text)
- _snputc from _snputc.o(.text) referenced from noretval__2snprintf.o(.text)
- fgetc from usart.o(.text) referenced from scanf_char_file.o(.text)
- fputc from usart.o(.text) referenced from _printf_char_file.o(.text)
- isspace from isspace.o(.text) referenced from scanf_char.o(.text)

### Global Symbols

__main (Thumb, 8 bytes, Stack size 0 bytes, __main.o(!!!main))

[Calls]

- >> __rt_entry
- >> __scatterload

__scatterload (Thumb, 0 bytes, Stack size unknown bytes, __scatter.o(!!!scatter))

[Called By]

- >> __main

__scatterload_rt2 (Thumb, 44 bytes, Stack size unknown bytes, __scatter.o(!!!scatter), UNUSED)

[Calls]

- >> __rt_entry

__scatterload_rt2_thumb_only (Thumb, 0 bytes, Stack size unknown bytes, __scatter.o(!!!scatter), UNUSED)

__scatterload_null (Thumb, 0 bytes, Stack size unknown bytes, __scatter.o(!!!scatter), UNUSED)

__scatterload_copy (Thumb, 26 bytes, Stack size unknown bytes, __scatter_copy.o(!!handler_copy), UNUSED)

[Calls]

- >> __scatterload_copy

[Called By]

- >> __scatterload_copy

__scatterload_zeroinit (Thumb, 28 bytes, Stack size unknown bytes, __scatter_zi.o(!!handler_zi), UNUSED)

_printf_f (Thumb, 0 bytes, Stack size unknown bytes, _printf_f.o(.ARM.Collect$$_printf_percent$$00000003))

[Stack]

- Max Depth = 320 + Unknown Stack Size
- Call Chain = _printf_f ⇒ _printf_fp_dec ⇒ _printf_fp_dec_real ⇒ _fp_digits ⇒ _btod_etento ⇒ _btod_emul ⇒ _e2e

[Calls]

- >> _printf_fp_dec

_printf_percent (Thumb, 0 bytes, Stack size unknown bytes, _printf_percent.o(.ARM.Collect$$_printf_percent$$00000000))

[Called By]

- >> __printf

_printf_d (Thumb, 0 bytes, Stack size unknown bytes, _printf_d.o(.ARM.Collect$$_printf_percent$$00000009))

[Stack]

- Max Depth = 72 + Unknown Stack Size
- Call Chain = _printf_d ⇒ _printf_int_dec ⇒ _printf_int_common ⇒ _printf_post_padding

[Calls]

- >> _printf_int_dec

_printf_c (Thumb, 0 bytes, Stack size unknown bytes, _printf_c.o(.ARM.Collect$$_printf_percent$$00000013))

[Stack]

- Max Depth = 40 + Unknown Stack Size
- Call Chain = _printf_c ⇒ _printf_char ⇒ _printf_cs_common ⇒ _printf_str ⇒ _printf_post_padding

[Calls]

- >> _printf_char

_printf_s (Thumb, 0 bytes, Stack size unknown bytes, _printf_s.o(.ARM.Collect$$_printf_percent$$00000014))

[Stack]

- Max Depth = 40 + Unknown Stack Size
- Call Chain = _printf_s ⇒ _printf_string ⇒ _printf_cs_common ⇒ _printf_str ⇒ _printf_post_padding

[Calls]

- >> _printf_string

_printf_percent_end (Thumb, 0 bytes, Stack size unknown bytes, _printf_percent_end.o(.ARM.Collect$$_printf_percent$$00000017))

__rt_lib_init (Thumb, 0 bytes, Stack size unknown bytes, libinit.o(.ARM.Collect$$libinit$$00000000))

[Called By]

- >> __rt_entry_li

__rt_lib_init_fp_1 (Thumb, 0 bytes, Stack size unknown bytes, libinit2.o(.ARM.Collect$$libinit$$00000001))

[Calls]

- >> _fp_init

__rt_lib_init_heap_1 (Thumb, 0 bytes, Stack size unknown bytes, libinit2.o(.ARM.Collect$$libinit$$00000008))

__rt_lib_init_lc_common (Thumb, 0 bytes, Stack size unknown bytes, libinit2.o(.ARM.Collect$$libinit$$0000000D))

[Calls]

- >> __rt_locale

__rt_lib_init_rand_1 (Thumb, 0 bytes, Stack size unknown bytes, libinit2.o(.ARM.Collect$$libinit$$0000000C))

__rt_lib_init_user_alloc_1 (Thumb, 0 bytes, Stack size unknown bytes, libinit2.o(.ARM.Collect$$libinit$$0000000A))

__rt_lib_init_lc_collate_1 (Thumb, 0 bytes, Stack size unknown bytes, libinit2.o(.ARM.Collect$$libinit$$0000000F))

__rt_lib_init_lc_ctype_2 (Thumb, 0 bytes, Stack size unknown bytes, libinit2.o(.ARM.Collect$$libinit$$00000010))

[Stack]

- Max Depth = 8 + Unknown Stack Size
- Call Chain = __rt_lib_init_lc_ctype_2 ⇒ _get_lc_ctype

[Calls]

- >> _get_lc_ctype

__rt_lib_init_lc_ctype_1 (Thumb, 0 bytes, Stack size unknown bytes, libinit2.o(.ARM.Collect$$libinit$$00000011))

__rt_lib_init_lc_monetary_1 (Thumb, 0 bytes, Stack size unknown bytes, libinit2.o(.ARM.Collect$$libinit$$00000013))

__rt_lib_init_lc_numeric_2 (Thumb, 0 bytes, Stack size unknown bytes, libinit2.o(.ARM.Collect$$libinit$$00000014))

[Stack]

- Max Depth = 8 + Unknown Stack Size
- Call Chain = __rt_lib_init_lc_numeric_2 ⇒ _get_lc_numeric

[Calls]

- >> _get_lc_numeric

__rt_lib_init_alloca_1 (Thumb, 0 bytes, Stack size unknown bytes, libinit2.o(.ARM.Collect$$libinit$$0000002C))

__rt_lib_init_argv_1 (Thumb, 0 bytes, Stack size unknown bytes, libinit2.o(.ARM.Collect$$libinit$$0000002A))

__rt_lib_init_atexit_1 (Thumb, 0 bytes, Stack size unknown bytes, libinit2.o(.ARM.Collect$$libinit$$00000019))

__rt_lib_init_clock_1 (Thumb, 0 bytes, Stack size unknown bytes, libinit2.o(.ARM.Collect$$libinit$$0000001F))

__rt_lib_init_cpp_1 (Thumb, 0 bytes, Stack size unknown bytes, libinit2.o(.ARM.Collect$$libinit$$00000030))

__rt_lib_init_exceptions_1 (Thumb, 0 bytes, Stack size unknown bytes, libinit2.o(.ARM.Collect$$libinit$$0000002E))

__rt_lib_init_fp_trap_1 (Thumb, 0 bytes, Stack size unknown bytes, libinit2.o(.ARM.Collect$$libinit$$0000001D))

__rt_lib_init_getenv_1 (Thumb, 0 bytes, Stack size unknown bytes, libinit2.o(.ARM.Collect$$libinit$$00000021))

__rt_lib_init_lc_numeric_1 (Thumb, 0 bytes, Stack size unknown bytes, libinit2.o(.ARM.Collect$$libinit$$00000015))

__rt_lib_init_lc_time_1 (Thumb, 0 bytes, Stack size unknown bytes, libinit2.o(.ARM.Collect$$libinit$$00000017))

__rt_lib_init_return (Thumb, 0 bytes, Stack size unknown bytes, libinit2.o(.ARM.Collect$$libinit$$00000031))

__rt_lib_init_signal_1 (Thumb, 0 bytes, Stack size unknown bytes, libinit2.o(.ARM.Collect$$libinit$$0000001B))

__rt_lib_init_stdio_1 (Thumb, 0 bytes, Stack size unknown bytes, libinit2.o(.ARM.Collect$$libinit$$00000023))

__rt_lib_shutdown (Thumb, 0 bytes, Stack size unknown bytes, libshutdown.o(.ARM.Collect$$libshutdown$$00000000))

[Called By]

- >> __rt_exit_ls

__rt_lib_shutdown_fp_trap_1 (Thumb, 0 bytes, Stack size unknown bytes, libshutdown2.o(.ARM.Collect$$libshutdown$$00000006))

__rt_lib_shutdown_heap_1 (Thumb, 0 bytes, Stack size unknown bytes, libshutdown2.o(.ARM.Collect$$libshutdown$$0000000E))

__rt_lib_shutdown_return (Thumb, 0 bytes, Stack size unknown bytes, libshutdown2.o(.ARM.Collect$$libshutdown$$0000000F))

__rt_lib_shutdown_signal_1 (Thumb, 0 bytes, Stack size unknown bytes, libshutdown2.o(.ARM.Collect$$libshutdown$$00000009))

__rt_lib_shutdown_stdio_1 (Thumb, 0 bytes, Stack size unknown bytes, libshutdown2.o(.ARM.Collect$$libshutdown$$00000003))

__rt_lib_shutdown_user_alloc_1 (Thumb, 0 bytes, Stack size unknown bytes, libshutdown2.o(.ARM.Collect$$libshutdown$$0000000B))

__rt_entry (Thumb, 0 bytes, Stack size unknown bytes, rtentry.o(.ARM.Collect$$rtentry$$00000000))

[Called By]

- >> __main
- >> __scatterload_rt2

__rt_entry_presh_1 (Thumb, 0 bytes, Stack size unknown bytes, rtentry2.o(.ARM.Collect$$rtentry$$00000002))

__rt_entry_sh (Thumb, 0 bytes, Stack size unknown bytes, rtentry4.o(.ARM.Collect$$rtentry$$00000004))

[Stack]

- Max Depth = 8 + Unknown Stack Size
- Call Chain = __rt_entry_sh ⇒ __user_setup_stackheap

[Calls]

- >> __user_setup_stackheap

__rt_entry_li (Thumb, 0 bytes, Stack size unknown bytes, rtentry2.o(.ARM.Collect$$rtentry$$0000000A))

[Calls]

- >> __rt_lib_init

__rt_entry_postsh_1 (Thumb, 0 bytes, Stack size unknown bytes, rtentry2.o(.ARM.Collect$$rtentry$$00000009))

__rt_entry_main (Thumb, 0 bytes, Stack size unknown bytes, rtentry2.o(.ARM.Collect$$rtentry$$0000000D))

[Stack]

- Max Depth = 168 + Unknown Stack Size
- Call Chain = __rt_entry_main ⇒ main ⇒ __2printf ⇒ _printf_char_file ⇒ _printf_char_common ⇒ __printf

[Calls]

- >> main
- >> exit

__rt_entry_postli_1 (Thumb, 0 bytes, Stack size unknown bytes, rtentry2.o(.ARM.Collect$$rtentry$$0000000C))

__rt_exit (Thumb, 0 bytes, Stack size unknown bytes, rtexit.o(.ARM.Collect$$rtexit$$00000000))

[Called By]

- >> exit

__rt_exit_ls (Thumb, 0 bytes, Stack size unknown bytes, rtexit2.o(.ARM.Collect$$rtexit$$00000003))

[Calls]

- >> __rt_lib_shutdown

__rt_exit_prels_1 (Thumb, 0 bytes, Stack size unknown bytes, rtexit2.o(.ARM.Collect$$rtexit$$00000002))

__rt_exit_exit (Thumb, 0 bytes, Stack size unknown bytes, rtexit2.o(.ARM.Collect$$rtexit$$00000004))

[Calls]

- >> _sys_exit

NVIC_PriorityGroupConfig (Thumb, 10 bytes, Stack size 0 bytes, misc.o(.text))

[Called By]

- >> Systick_Configuration

NVIC_Init (Thumb, 108 bytes, Stack size 16 bytes, misc.o(.text))

[Stack]

- Max Depth = 16
- Call Chain = NVIC_Init

[Called By]

- >> button_Configuration

NVIC_SetVectorTable (Thumb, 14 bytes, Stack size 0 bytes, misc.o(.text), UNUSED)

NVIC_SystemLPConfig (Thumb, 34 bytes, Stack size 0 bytes, misc.o(.text), UNUSED)

SysTick_CLKSourceConfig (Thumb, 40 bytes, Stack size 0 bytes, misc.o(.text), UNUSED)

ADC_DeInit (Thumb, 22 bytes, Stack size 8 bytes, stm32f4xx_adc.o(.text), UNUSED)

[Calls]

- >> RCC_APB2PeriphResetCmd

ADC_Init (Thumb, 74 bytes, Stack size 12 bytes, stm32f4xx_adc.o(.text))

[Stack]

- Max Depth = 12
- Call Chain = ADC_Init

[Called By]

- >> ADC_Config

ADC_StructInit (Thumb, 20 bytes, Stack size 0 bytes, stm32f4xx_adc.o(.text), UNUSED)

ADC_CommonInit (Thumb, 44 bytes, Stack size 0 bytes, stm32f4xx_adc.o(.text))

[Called By]

- >> ADC_Config

ADC_CommonStructInit (Thumb, 12 bytes, Stack size 0 bytes, stm32f4xx_adc.o(.text), UNUSED)

ADC_Cmd (Thumb, 22 bytes, Stack size 0 bytes, stm32f4xx_adc.o(.text))

[Called By]

- >> ADC_Config

ADC_AnalogWatchdogCmd (Thumb, 16 bytes, Stack size 0 bytes, stm32f4xx_adc.o(.text), UNUSED)

ADC_AnalogWatchdogThresholdsConfig (Thumb, 6 bytes, Stack size 0 bytes, stm32f4xx_adc.o(.text), UNUSED)

ADC_AnalogWatchdogSingleChannelConfig (Thumb, 16 bytes, Stack size 0 bytes, stm32f4xx_adc.o(.text), UNUSED)

ADC_TempSensorVrefintCmd (Thumb, 34 bytes, Stack size 0 bytes, stm32f4xx_adc.o(.text), UNUSED)

ADC_VBATCmd (Thumb, 34 bytes, Stack size 0 bytes, stm32f4xx_adc.o(.text), UNUSED)

ADC_RegularChannelConfig (Thumb, 184 bytes, Stack size 20 bytes, stm32f4xx_adc.o(.text))

[Stack]

- Max Depth = 20
- Call Chain = ADC_RegularChannelConfig

[Called By]

- >> readADC

ADC_SoftwareStartConv (Thumb, 10 bytes, Stack size 0 bytes, stm32f4xx_adc.o(.text))

[Called By]

- >> readADC

ADC_GetSoftwareStartConvStatus (Thumb, 20 bytes, Stack size 0 bytes, stm32f4xx_adc.o(.text), UNUSED)

ADC_EOCOnEachRegularChannelCmd (Thumb, 22 bytes, Stack size 0 bytes, stm32f4xx_adc.o(.text), UNUSED)

ADC_ContinuousModeCmd (Thumb, 22 bytes, Stack size 0 bytes, stm32f4xx_adc.o(.text), UNUSED)

ADC_DiscModeChannelCountConfig (Thumb, 24 bytes, Stack size 8 bytes, stm32f4xx_adc.o(.text), UNUSED)

ADC_DiscModeCmd (Thumb, 22 bytes, Stack size 0 bytes, stm32f4xx_adc.o(.text), UNUSED)

ADC_GetConversionValue (Thumb, 8 bytes, Stack size 0 bytes, stm32f4xx_adc.o(.text))

[Called By]

- >> readADC

ADC_GetMultiModeConversionValue (Thumb, 6 bytes, Stack size 0 bytes, stm32f4xx_adc.o(.text), UNUSED)

ADC_DMACmd (Thumb, 22 bytes, Stack size 0 bytes, stm32f4xx_adc.o(.text), UNUSED)

ADC_DMARequestAfterLastTransferCmd (Thumb, 22 bytes, Stack size 0 bytes, stm32f4xx_adc.o(.text), UNUSED)

ADC_MultiModeDMARequestAfterLastTransferCmd (Thumb, 34 bytes, Stack size 0 bytes, stm32f4xx_adc.o(.text), UNUSED)

ADC_InjectedChannelConfig (Thumb, 130 bytes, Stack size 20 bytes, stm32f4xx_adc.o(.text), UNUSED)

ADC_InjectedSequencerLengthConfig (Thumb, 24 bytes, Stack size 8 bytes, stm32f4xx_adc.o(.text), UNUSED)

ADC_SetInjectedOffset (Thumb, 20 bytes, Stack size 8 bytes, stm32f4xx_adc.o(.text), UNUSED)

ADC_ExternalTrigInjectedConvConfig (Thumb, 16 bytes, Stack size 0 bytes, stm32f4xx_adc.o(.text), UNUSED)

ADC_ExternalTrigInjectedConvEdgeConfig (Thumb, 16 bytes, Stack size 0 bytes, stm32f4xx_adc.o(.text), UNUSED)

ADC_SoftwareStartInjectedConv (Thumb, 10 bytes, Stack size 0 bytes, stm32f4xx_adc.o(.text), UNUSED)

ADC_GetSoftwareStartInjectedConvCmdStatus (Thumb, 20 bytes, Stack size 0 bytes, stm32f4xx_adc.o(.text), UNUSED)

ADC_AutoInjectedConvCmd (Thumb, 22 bytes, Stack size 0 bytes, stm32f4xx_adc.o(.text), UNUSED)

ADC_InjectedDiscModeCmd (Thumb, 22 bytes, Stack size 0 bytes, stm32f4xx_adc.o(.text), UNUSED)

ADC_GetInjectedConversionValue (Thumb, 28 bytes, Stack size 8 bytes, stm32f4xx_adc.o(.text), UNUSED)

ADC_ITConfig (Thumb, 60 bytes, Stack size 8 bytes, stm32f4xx_adc.o(.text))

[Stack]

- Max Depth = 8
- Call Chain = ADC_ITConfig

[Called By]

- >> ADC_Config

ADC_GetFlagStatus (Thumb, 18 bytes, Stack size 0 bytes, stm32f4xx_adc.o(.text))

[Called By]

- >> readADC

ADC_ClearFlag (Thumb, 6 bytes, Stack size 0 bytes, stm32f4xx_adc.o(.text), UNUSED)

ADC_GetITStatus (Thumb, 38 bytes, Stack size 16 bytes, stm32f4xx_adc.o(.text), UNUSED)

ADC_ClearITPendingBit (Thumb, 10 bytes, Stack size 0 bytes, stm32f4xx_adc.o(.text), UNUSED)

EXTI_DeInit (Thumb, 28 bytes, Stack size 0 bytes, stm32f4xx_exti.o(.text), UNUSED)

EXTI_Init (Thumb, 142 bytes, Stack size 0 bytes, stm32f4xx_exti.o(.text))

[Called By]

- >> button_Configuration

EXTI_StructInit (Thumb, 16 bytes, Stack size 0 bytes, stm32f4xx_exti.o(.text), UNUSED)

EXTI_GenerateSWInterrupt (Thumb, 16 bytes, Stack size 0 bytes, stm32f4xx_exti.o(.text), UNUSED)

EXTI_GetFlagStatus (Thumb, 22 bytes, Stack size 0 bytes, stm32f4xx_exti.o(.text), UNUSED)

EXTI_ClearFlag (Thumb, 8 bytes, Stack size 0 bytes, stm32f4xx_exti.o(.text), UNUSED)

EXTI_GetITStatus (Thumb, 34 bytes, Stack size 0 bytes, stm32f4xx_exti.o(.text))

[Called By]

- >> EXTI15_10_IRQHandler
- >> EXTI9_5_IRQHandler

EXTI_ClearITPendingBit (Thumb, 8 bytes, Stack size 0 bytes, stm32f4xx_exti.o(.text))

[Called By]

- >> EXTI15_10_IRQHandler
- >> EXTI9_5_IRQHandler

GPIO_DeInit (Thumb, 220 bytes, Stack size 8 bytes, stm32f4xx_gpio.o(.text), UNUSED)

[Calls]

- >> RCC_AHB1PeriphResetCmd

GPIO_Init (Thumb, 144 bytes, Stack size 20 bytes, stm32f4xx_gpio.o(.text))

[Stack]

- Max Depth = 20
- Call Chain = GPIO_Init

[Called By]

- >> usart1_Configuration
- >> buzzer_Configuration
- >> button_Configuration
- >> SPI_Configuration
- >> LED_Configuration
- >> Encoder_Configration
- >> ADC_Config
- >> TIM4_GPIO_Config
- >> usart2_Configuration

GPIO_StructInit (Thumb, 18 bytes, Stack size 0 bytes, stm32f4xx_gpio.o(.text), UNUSED)

GPIO_PinLockConfig (Thumb, 34 bytes, Stack size 8 bytes, stm32f4xx_gpio.o(.text), UNUSED)

GPIO_ReadInputDataBit (Thumb, 18 bytes, Stack size 0 bytes, stm32f4xx_gpio.o(.text), UNUSED)

GPIO_ReadInputData (Thumb, 8 bytes, Stack size 0 bytes, stm32f4xx_gpio.o(.text), UNUSED)

GPIO_ReadOutputDataBit (Thumb, 18 bytes, Stack size 0 bytes, stm32f4xx_gpio.o(.text), UNUSED)

GPIO_ReadOutputData (Thumb, 8 bytes, Stack size 0 bytes, stm32f4xx_gpio.o(.text), UNUSED)

GPIO_SetBits (Thumb, 4 bytes, Stack size 0 bytes, stm32f4xx_gpio.o(.text))

[Called By]

- >> readSensor
- >> displayMatrix
- >> SPI_Configuration
- >> lowBatCheck
- >> WriteControlRegister
- >> clearScreen

GPIO_ResetBits (Thumb, 4 bytes, Stack size 0 bytes, stm32f4xx_gpio.o(.text))

[Called By]

- >> readSensor
- >> displayMatrix
- >> LED_Configuration
- >> ADC_Config
- >> lowBatCheck
- >> WriteControlRegister
- >> clearScreen

GPIO_WriteBit (Thumb, 10 bytes, Stack size 0 bytes, stm32f4xx_gpio.o(.text), UNUSED)

GPIO_Write (Thumb, 4 bytes, Stack size 0 bytes, stm32f4xx_gpio.o(.text), UNUSED)

GPIO_ToggleBits (Thumb, 8 bytes, Stack size 0 bytes, stm32f4xx_gpio.o(.text), UNUSED)

GPIO_PinAFConfig (Thumb, 70 bytes, Stack size 20 bytes, stm32f4xx_gpio.o(.text))

[Stack]

- Max Depth = 20
- Call Chain = GPIO_PinAFConfig

[Called By]

- >> usart1_Configuration
- >> buzzer_Configuration
- >> SPI_Configuration
- >> Encoder_Configration
- >> TIM4_GPIO_Config
- >> usart2_Configuration

RCC_DeInit (Thumb, 60 bytes, Stack size 0 bytes, stm32f4xx_rcc.o(.text), UNUSED)

RCC_HSEConfig (Thumb, 14 bytes, Stack size 0 bytes, stm32f4xx_rcc.o(.text), UNUSED)

RCC_GetFlagStatus (Thumb, 60 bytes, Stack size 8 bytes, stm32f4xx_rcc.o(.text), UNUSED)

[Called By]

- >> RCC_WaitForHSEStartUp

RCC_WaitForHSEStartUp (Thumb, 56 bytes, Stack size 16 bytes, stm32f4xx_rcc.o(.text), UNUSED)

[Calls]

- >> RCC_GetFlagStatus

RCC_AdjustHSICalibrationValue (Thumb, 20 bytes, Stack size 0 bytes, stm32f4xx_rcc.o(.text), UNUSED)

RCC_HSICmd (Thumb, 6 bytes, Stack size 0 bytes, stm32f4xx_rcc.o(.text), UNUSED)

RCC_LSEConfig (Thumb, 46 bytes, Stack size 0 bytes, stm32f4xx_rcc.o(.text), UNUSED)

RCC_LSICmd (Thumb, 6 bytes, Stack size 0 bytes, stm32f4xx_rcc.o(.text), UNUSED)

RCC_PLLConfig (Thumb, 32 bytes, Stack size 16 bytes, stm32f4xx_rcc.o(.text), UNUSED)

RCC_PLLCmd (Thumb, 6 bytes, Stack size 0 bytes, stm32f4xx_rcc.o(.text), UNUSED)

RCC_PLLI2SConfig (Thumb, 14 bytes, Stack size 0 bytes, stm32f4xx_rcc.o(.text), UNUSED)

RCC_PLLI2SCmd (Thumb, 6 bytes, Stack size 0 bytes, stm32f4xx_rcc.o(.text), UNUSED)

RCC_ClockSecuritySystemCmd (Thumb, 6 bytes, Stack size 0 bytes, stm32f4xx_rcc.o(.text), UNUSED)

RCC_MCO1Config (Thumb, 28 bytes, Stack size 0 bytes, stm32f4xx_rcc.o(.text), UNUSED)

RCC_MCO2Config (Thumb, 28 bytes, Stack size 0 bytes, stm32f4xx_rcc.o(.text), UNUSED)

RCC_SYSCLKConfig (Thumb, 20 bytes, Stack size 0 bytes, stm32f4xx_rcc.o(.text), UNUSED)

RCC_GetSYSCLKSource (Thumb, 12 bytes, Stack size 0 bytes, stm32f4xx_rcc.o(.text), UNUSED)

RCC_HCLKConfig (Thumb, 20 bytes, Stack size 0 bytes, stm32f4xx_rcc.o(.text), UNUSED)

RCC_PCLK1Config (Thumb, 20 bytes, Stack size 0 bytes, stm32f4xx_rcc.o(.text), UNUSED)

RCC_PCLK2Config (Thumb, 22 bytes, Stack size 0 bytes, stm32f4xx_rcc.o(.text), UNUSED)

RCC_GetClocksFreq (Thumb, 222 bytes, Stack size 20 bytes, stm32f4xx_rcc.o(.text))

[Stack]

- Max Depth = 20
- Call Chain = RCC_GetClocksFreq

[Called By]

- >> USART_Init

RCC_RTCCLKConfig (Thumb, 54 bytes, Stack size 0 bytes, stm32f4xx_rcc.o(.text), UNUSED)

RCC_RTCCLKCmd (Thumb, 8 bytes, Stack size 0 bytes, stm32f4xx_rcc.o(.text), UNUSED)

RCC_BackupResetCmd (Thumb, 8 bytes, Stack size 0 bytes, stm32f4xx_rcc.o(.text), UNUSED)

RCC_I2SCLKConfig (Thumb, 6 bytes, Stack size 0 bytes, stm32f4xx_rcc.o(.text), UNUSED)

RCC_AHB1PeriphClockCmd (Thumb, 34 bytes, Stack size 0 bytes, stm32f4xx_rcc.o(.text))

[Called By]

- >> usart1_Configuration
- >> button_Configuration
- >> SPI_Configuration
- >> LED_Configuration
- >> usart2_Configuration

RCC_AHB2PeriphClockCmd (Thumb, 34 bytes, Stack size 0 bytes, stm32f4xx_rcc.o(.text), UNUSED)

RCC_AHB3PeriphClockCmd (Thumb, 34 bytes, Stack size 0 bytes, stm32f4xx_rcc.o(.text), UNUSED)

RCC_APB1PeriphClockCmd (Thumb, 34 bytes, Stack size 0 bytes, stm32f4xx_rcc.o(.text))

[Called By]

- >> buzzer_Configuration
- >> SPI_Configuration
- >> Encoder_Configration
- >> TIM4_GPIO_Config
- >> usart2_Configuration

RCC_APB2PeriphClockCmd (Thumb, 34 bytes, Stack size 0 bytes, stm32f4xx_rcc.o(.text))

[Called By]

- >> usart1_Configuration
- >> button_Configuration
- >> ADC_Config

RCC_AHB1PeriphResetCmd (Thumb, 34 bytes, Stack size 0 bytes, stm32f4xx_rcc.o(.text), UNUSED)

[Called By]

- >> GPIO_DeInit

RCC_AHB2PeriphResetCmd (Thumb, 72 bytes, Stack size 0 bytes, stm32f4xx_rcc.o(.text), UNUSED)

RCC_AHB3PeriphResetCmd (Thumb, 34 bytes, Stack size 0 bytes, stm32f4xx_rcc.o(.text), UNUSED)

RCC_APB1PeriphResetCmd (Thumb, 34 bytes, Stack size 0 bytes, stm32f4xx_rcc.o(.text))

[Called By]

- >> USART_DeInit
- >> TIM_DeInit
- >> SPI_I2S_DeInit

RCC_APB2PeriphResetCmd (Thumb, 34 bytes, Stack size 0 bytes, stm32f4xx_rcc.o(.text))

[Called By]

- >> USART_DeInit
- >> TIM_DeInit
- >> SYSCFG_DeInit
- >> SPI_I2S_DeInit
- >> ADC_DeInit

RCC_AHB1PeriphClockLPModeCmd (Thumb, 34 bytes, Stack size 0 bytes, stm32f4xx_rcc.o(.text), UNUSED)

RCC_AHB2PeriphClockLPModeCmd (Thumb, 34 bytes, Stack size 0 bytes, stm32f4xx_rcc.o(.text), UNUSED)

RCC_AHB3PeriphClockLPModeCmd (Thumb, 34 bytes, Stack size 0 bytes, stm32f4xx_rcc.o(.text), UNUSED)

RCC_APB1PeriphClockLPModeCmd (Thumb, 34 bytes, Stack size 0 bytes, stm32f4xx_rcc.o(.text), UNUSED)

RCC_APB2PeriphClockLPModeCmd (Thumb, 34 bytes, Stack size 0 bytes, stm32f4xx_rcc.o(.text), UNUSED)

RCC_ITConfig (Thumb, 34 bytes, Stack size 0 bytes, stm32f4xx_rcc.o(.text), UNUSED)

RCC_ClearFlag (Thumb, 18 bytes, Stack size 0 bytes, stm32f4xx_rcc.o(.text), UNUSED)

RCC_GetITStatus (Thumb, 22 bytes, Stack size 0 bytes, stm32f4xx_rcc.o(.text), UNUSED)

RCC_ClearITPendingBit (Thumb, 8 bytes, Stack size 0 bytes, stm32f4xx_rcc.o(.text), UNUSED)

SPI_I2S_DeInit (Thumb, 76 bytes, Stack size 8 bytes, stm32f4xx_spi.o(.text))

[Stack]

- Max Depth = 8
- Call Chain = SPI_I2S_DeInit

[Calls]

- >> RCC_APB1PeriphResetCmd
- >> RCC_APB2PeriphResetCmd

[Called By]

- >> SPI_Configuration

SPI_Init (Thumb, 60 bytes, Stack size 8 bytes, stm32f4xx_spi.o(.text))

[Stack]

- Max Depth = 8
- Call Chain = SPI_Init

[Called By]

- >> SPI_Configuration

I2S_Init (Thumb, 346 bytes, Stack size 36 bytes, stm32f4xx_spi.o(.text), UNUSED)

SPI_StructInit (Thumb, 24 bytes, Stack size 0 bytes, stm32f4xx_spi.o(.text))

[Called By]

- >> SPI_Configuration

I2S_StructInit (Thumb, 20 bytes, Stack size 0 bytes, stm32f4xx_spi.o(.text), UNUSED)

SPI_Cmd (Thumb, 24 bytes, Stack size 0 bytes, stm32f4xx_spi.o(.text))

[Called By]

- >> SPI_Configuration

I2S_Cmd (Thumb, 24 bytes, Stack size 0 bytes, stm32f4xx_spi.o(.text), UNUSED)

SPI_DataSizeConfig (Thumb, 18 bytes, Stack size 0 bytes, stm32f4xx_spi.o(.text), UNUSED)

SPI_BiDirectionalLineConfig (Thumb, 28 bytes, Stack size 0 bytes, stm32f4xx_spi.o(.text), UNUSED)

SPI_NSSInternalSoftwareConfig (Thumb, 30 bytes, Stack size 0 bytes, stm32f4xx_spi.o(.text))

[Called By]

- >> SPI_Configuration

SPI_SSOutputCmd (Thumb, 24 bytes, Stack size 0 bytes, stm32f4xx_spi.o(.text))

[Called By]

- >> SPI_Configuration

SPI_TIModeCmd (Thumb, 24 bytes, Stack size 0 bytes, stm32f4xx_spi.o(.text), UNUSED)

I2S_FullDuplexConfig (Thumb, 80 bytes, Stack size 12 bytes, stm32f4xx_spi.o(.text), UNUSED)

SPI_I2S_ReceiveData (Thumb, 6 bytes, Stack size 0 bytes, stm32f4xx_spi.o(.text), UNUSED)

SPI_I2S_SendData (Thumb, 4 bytes, Stack size 0 bytes, stm32f4xx_spi.o(.text))

[Called By]

- >> displayMatrix
- >> WriteControlRegister
- >> clearScreen

SPI_CalculateCRC (Thumb, 24 bytes, Stack size 0 bytes, stm32f4xx_spi.o(.text), UNUSED)

SPI_TransmitCRC (Thumb, 10 bytes, Stack size 0 bytes, stm32f4xx_spi.o(.text), UNUSED)

SPI_GetCRC (Thumb, 16 bytes, Stack size 0 bytes, stm32f4xx_spi.o(.text), UNUSED)

SPI_GetCRCPolynomial (Thumb, 6 bytes, Stack size 0 bytes, stm32f4xx_spi.o(.text), UNUSED)

SPI_I2S_DMACmd (Thumb, 18 bytes, Stack size 0 bytes, stm32f4xx_spi.o(.text), UNUSED)

SPI_I2S_ITConfig (Thumb, 32 bytes, Stack size 12 bytes, stm32f4xx_spi.o(.text), UNUSED)

SPI_I2S_GetFlagStatus (Thumb, 18 bytes, Stack size 0 bytes, stm32f4xx_spi.o(.text))

[Called By]

- >> displayMatrix
- >> WriteControlRegister
- >> clearScreen

SPI_I2S_ClearFlag (Thumb, 6 bytes, Stack size 0 bytes, stm32f4xx_spi.o(.text), UNUSED)

SPI_I2S_GetITStatus (Thumb, 52 bytes, Stack size 20 bytes, stm32f4xx_spi.o(.text), UNUSED)

SPI_I2S_ClearITPendingBit (Thumb, 20 bytes, Stack size 8 bytes, stm32f4xx_spi.o(.text), UNUSED)

SYSCFG_DeInit (Thumb, 22 bytes, Stack size 8 bytes, stm32f4xx_syscfg.o(.text), UNUSED)

[Calls]

- >> RCC_APB2PeriphResetCmd

SYSCFG_MemoryRemapConfig (Thumb, 6 bytes, Stack size 0 bytes, stm32f4xx_syscfg.o(.text), UNUSED)

SYSCFG_EXTILineConfig (Thumb, 66 bytes, Stack size 12 bytes, stm32f4xx_syscfg.o(.text))

[Stack]

- Max Depth = 12
- Call Chain = SYSCFG_EXTILineConfig

[Called By]

- >> button_Configuration

SYSCFG_ETH_MediaInterfaceConfig (Thumb, 6 bytes, Stack size 0 bytes, stm32f4xx_syscfg.o(.text), UNUSED)

SYSCFG_CompensationCellCmd (Thumb, 6 bytes, Stack size 0 bytes, stm32f4xx_syscfg.o(.text), UNUSED)

SYSCFG_GetCompensationCellStatus (Thumb, 22 bytes, Stack size 0 bytes, stm32f4xx_syscfg.o(.text), UNUSED)

TIM_DeInit (Thumb, 346 bytes, Stack size 8 bytes, stm32f4xx_tim.o(.text), UNUSED)

[Calls]

- >> RCC_APB1PeriphResetCmd
- >> RCC_APB2PeriphResetCmd

TIM_TimeBaseInit (Thumb, 104 bytes, Stack size 0 bytes, stm32f4xx_tim.o(.text))

[Called By]

- >> buzzer_Configuration
- >> TIM4_Mode_Config

TIM_TimeBaseStructInit (Thumb, 18 bytes, Stack size 0 bytes, stm32f4xx_tim.o(.text), UNUSED)

TIM_PrescalerConfig (Thumb, 6 bytes, Stack size 0 bytes, stm32f4xx_tim.o(.text), UNUSED)

TIM_CounterModeConfig (Thumb, 18 bytes, Stack size 0 bytes, stm32f4xx_tim.o(.text), UNUSED)

TIM_SetCounter (Thumb, 4 bytes, Stack size 0 bytes, stm32f4xx_tim.o(.text), UNUSED)

TIM_SetAutoreload (Thumb, 4 bytes, Stack size 0 bytes, stm32f4xx_tim.o(.text))

[Called By]

- >> Encoder_Configration

TIM_GetCounter (Thumb, 6 bytes, Stack size 0 bytes, stm32f4xx_tim.o(.text), UNUSED)

TIM_GetPrescaler (Thumb, 6 bytes, Stack size 0 bytes, stm32f4xx_tim.o(.text), UNUSED)

TIM_UpdateDisableConfig (Thumb, 24 bytes, Stack size 0 bytes, stm32f4xx_tim.o(.text), UNUSED)

TIM_UpdateRequestConfig (Thumb, 24 bytes, Stack size 0 bytes, stm32f4xx_tim.o(.text), UNUSED)

TIM_ARRPreloadConfig (Thumb, 24 bytes, Stack size 0 bytes, stm32f4xx_tim.o(.text))

[Called By]

- >> buzzer_Configuration
- >> TIM4_Mode_Config

TIM_SelectOnePulseMode (Thumb, 18 bytes, Stack size 0 bytes, stm32f4xx_tim.o(.text), UNUSED)

TIM_SetClockDivision (Thumb, 18 bytes, Stack size 0 bytes, stm32f4xx_tim.o(.text), UNUSED)

TIM_Cmd (Thumb, 24 bytes, Stack size 0 bytes, stm32f4xx_tim.o(.text))

[Called By]

- >> buzzer_Configuration
- >> Encoder_Configration
- >> TIM4_Mode_Config

TIM_OC1Init (Thumb, 114 bytes, Stack size 16 bytes, stm32f4xx_tim.o(.text))

[Stack]

- Max Depth = 16
- Call Chain = TIM_OC1Init

[Called By]

- >> buzzer_Configuration
- >> TIM4_Mode_Config

TIM_OC2Init (Thumb, 154 bytes, Stack size 16 bytes, stm32f4xx_tim.o(.text))

[Stack]

- Max Depth = 16
- Call Chain = TIM_OC2Init

[Called By]

- >> TIM4_Mode_Config

TIM_OC3Init (Thumb, 204 bytes, Stack size 16 bytes, stm32f4xx_tim.o(.text))

[Stack]

- Max Depth = 16
- Call Chain = TIM_OC3Init

[Called By]

- >> TIM4_Mode_Config

TIM_OC4Init (Thumb, 112 bytes, Stack size 16 bytes, stm32f4xx_tim.o(.text))

[Stack]

- Max Depth = 16
- Call Chain = TIM_OC4Init

[Called By]

- >> TIM4_Mode_Config

TIM_OCStructInit (Thumb, 20 bytes, Stack size 0 bytes, stm32f4xx_tim.o(.text), UNUSED)

TIM_SelectOCxM (Thumb, 86 bytes, Stack size 16 bytes, stm32f4xx_tim.o(.text), UNUSED)

TIM_SetCompare1 (Thumb, 4 bytes, Stack size 0 bytes, stm32f4xx_tim.o(.text), UNUSED)

TIM_SetCompare2 (Thumb, 4 bytes, Stack size 0 bytes, stm32f4xx_tim.o(.text), UNUSED)

TIM_SetCompare3 (Thumb, 4 bytes, Stack size 0 bytes, stm32f4xx_tim.o(.text), UNUSED)

TIM_SetCompare4 (Thumb, 4 bytes, Stack size 0 bytes, stm32f4xx_tim.o(.text), UNUSED)

TIM_ForcedOC1Config (Thumb, 18 bytes, Stack size 0 bytes, stm32f4xx_tim.o(.text), UNUSED)

TIM_ForcedOC2Config (Thumb, 26 bytes, Stack size 0 bytes, stm32f4xx_tim.o(.text), UNUSED)

TIM_ForcedOC3Config (Thumb, 18 bytes, Stack size 0 bytes, stm32f4xx_tim.o(.text), UNUSED)

TIM_ForcedOC4Config (Thumb, 26 bytes, Stack size 0 bytes, stm32f4xx_tim.o(.text), UNUSED)

TIM_OC1PreloadConfig (Thumb, 18 bytes, Stack size 0 bytes, stm32f4xx_tim.o(.text))

[Called By]

- >> buzzer_Configuration
- >> TIM4_Mode_Config

TIM_OC2PreloadConfig (Thumb, 26 bytes, Stack size 0 bytes, stm32f4xx_tim.o(.text))

[Called By]

- >> TIM4_Mode_Config

TIM_OC3PreloadConfig (Thumb, 18 bytes, Stack size 0 bytes, stm32f4xx_tim.o(.text))

[Called By]

- >> TIM4_Mode_Config

TIM_OC4PreloadConfig (Thumb, 26 bytes, Stack size 0 bytes, stm32f4xx_tim.o(.text))

[Called By]

- >> TIM4_Mode_Config

TIM_OC1FastConfig (Thumb, 18 bytes, Stack size 0 bytes, stm32f4xx_tim.o(.text), UNUSED)

TIM_OC2FastConfig (Thumb, 26 bytes, Stack size 0 bytes, stm32f4xx_tim.o(.text), UNUSED)

TIM_OC3FastConfig (Thumb, 18 bytes, Stack size 0 bytes, stm32f4xx_tim.o(.text), UNUSED)

TIM_OC4FastConfig (Thumb, 26 bytes, Stack size 0 bytes, stm32f4xx_tim.o(.text), UNUSED)

TIM_ClearOC1Ref (Thumb, 18 bytes, Stack size 0 bytes, stm32f4xx_tim.o(.text), UNUSED)

TIM_ClearOC2Ref (Thumb, 24 bytes, Stack size 0 bytes, stm32f4xx_tim.o(.text), UNUSED)

TIM_ClearOC3Ref (Thumb, 18 bytes, Stack size 0 bytes, stm32f4xx_tim.o(.text), UNUSED)

TIM_ClearOC4Ref (Thumb, 24 bytes, Stack size 0 bytes, stm32f4xx_tim.o(.text), UNUSED)

TIM_OC1PolarityConfig (Thumb, 18 bytes, Stack size 0 bytes, stm32f4xx_tim.o(.text), UNUSED)

TIM_OC1NPolarityConfig (Thumb, 18 bytes, Stack size 0 bytes, stm32f4xx_tim.o(.text), UNUSED)

TIM_OC2PolarityConfig (Thumb, 26 bytes, Stack size 0 bytes, stm32f4xx_tim.o(.text), UNUSED)

TIM_OC2NPolarityConfig (Thumb, 26 bytes, Stack size 0 bytes, stm32f4xx_tim.o(.text), UNUSED)

TIM_OC3PolarityConfig (Thumb, 26 bytes, Stack size 0 bytes, stm32f4xx_tim.o(.text), UNUSED)

TIM_OC3NPolarityConfig (Thumb, 26 bytes, Stack size 0 bytes, stm32f4xx_tim.o(.text), UNUSED)

TIM_OC4PolarityConfig (Thumb, 26 bytes, Stack size 0 bytes, stm32f4xx_tim.o(.text), UNUSED)

TIM_CCxCmd (Thumb, 30 bytes, Stack size 12 bytes, stm32f4xx_tim.o(.text), UNUSED)

TIM_CCxNCmd (Thumb, 30 bytes, Stack size 12 bytes, stm32f4xx_tim.o(.text), UNUSED)

TIM_SetIC4Prescaler (Thumb, 26 bytes, Stack size 0 bytes, stm32f4xx_tim.o(.text), UNUSED)

[Called By]

- >> TIM_ICInit

TIM_SetIC3Prescaler (Thumb, 18 bytes, Stack size 0 bytes, stm32f4xx_tim.o(.text), UNUSED)

[Called By]

- >> TIM_ICInit

TIM_SetIC2Prescaler (Thumb, 26 bytes, Stack size 0 bytes, stm32f4xx_tim.o(.text), UNUSED)

[Called By]

- >> TIM_PWMIConfig
- >> TIM_ICInit

TIM_SetIC1Prescaler (Thumb, 18 bytes, Stack size 0 bytes, stm32f4xx_tim.o(.text), UNUSED)

[Called By]

- >> TIM_PWMIConfig
- >> TIM_ICInit

TIM_ICInit (Thumb, 110 bytes, Stack size 16 bytes, stm32f4xx_tim.o(.text), UNUSED)

[Calls]

- >> TIM_SetIC1Prescaler
- >> TIM_SetIC2Prescaler
- >> TIM_SetIC3Prescaler
- >> TIM_SetIC4Prescaler
- >> TI1_Config
- >> TI2_Config
- >> TI3_Config
- >> TI4_Config

TIM_ICStructInit (Thumb, 18 bytes, Stack size 0 bytes, stm32f4xx_tim.o(.text), UNUSED)

TIM_PWMIConfig (Thumb, 124 bytes, Stack size 24 bytes, stm32f4xx_tim.o(.text), UNUSED)

[Calls]

- >> TIM_SetIC1Prescaler
- >> TIM_SetIC2Prescaler
- >> TI1_Config
- >> TI2_Config

TIM_GetCapture1 (Thumb, 6 bytes, Stack size 0 bytes, stm32f4xx_tim.o(.text), UNUSED)

TIM_GetCapture2 (Thumb, 6 bytes, Stack size 0 bytes, stm32f4xx_tim.o(.text), UNUSED)

TIM_GetCapture3 (Thumb, 6 bytes, Stack size 0 bytes, stm32f4xx_tim.o(.text), UNUSED)

TIM_GetCapture4 (Thumb, 6 bytes, Stack size 0 bytes, stm32f4xx_tim.o(.text), UNUSED)

TIM_BDTRConfig (Thumb, 32 bytes, Stack size 0 bytes, stm32f4xx_tim.o(.text), UNUSED)

TIM_BDTRStructInit (Thumb, 18 bytes, Stack size 0 bytes, stm32f4xx_tim.o(.text), UNUSED)

TIM_CtrlPWMOutputs (Thumb, 30 bytes, Stack size 0 bytes, stm32f4xx_tim.o(.text), UNUSED)

TIM_SelectCOM (Thumb, 24 bytes, Stack size 0 bytes, stm32f4xx_tim.o(.text), UNUSED)

TIM_CCPreloadControl (Thumb, 24 bytes, Stack size 0 bytes, stm32f4xx_tim.o(.text), UNUSED)

TIM_ITConfig (Thumb, 18 bytes, Stack size 0 bytes, stm32f4xx_tim.o(.text), UNUSED)

TIM_GenerateEvent (Thumb, 4 bytes, Stack size 0 bytes, stm32f4xx_tim.o(.text), UNUSED)

TIM_GetFlagStatus (Thumb, 18 bytes, Stack size 0 bytes, stm32f4xx_tim.o(.text), UNUSED)

TIM_ClearFlag (Thumb, 6 bytes, Stack size 0 bytes, stm32f4xx_tim.o(.text), UNUSED)

TIM_GetITStatus (Thumb, 34 bytes, Stack size 12 bytes, stm32f4xx_tim.o(.text), UNUSED)

TIM_ClearITPendingBit (Thumb, 6 bytes, Stack size 0 bytes, stm32f4xx_tim.o(.text), UNUSED)

TIM_DMAConfig (Thumb, 10 bytes, Stack size 0 bytes, stm32f4xx_tim.o(.text), UNUSED)

TIM_DMACmd (Thumb, 18 bytes, Stack size 0 bytes, stm32f4xx_tim.o(.text), UNUSED)

TIM_SelectCCDMA (Thumb, 24 bytes, Stack size 0 bytes, stm32f4xx_tim.o(.text), UNUSED)

TIM_InternalClockConfig (Thumb, 12 bytes, Stack size 0 bytes, stm32f4xx_tim.o(.text), UNUSED)

TIM_SelectInputTrigger (Thumb, 18 bytes, Stack size 0 bytes, stm32f4xx_tim.o(.text), UNUSED)

[Called By]

- >> TIM_TIxExternalClockConfig
- >> TIM_ITRxExternalClockConfig

TIM_ITRxExternalClockConfig (Thumb, 24 bytes, Stack size 12 bytes, stm32f4xx_tim.o(.text), UNUSED)

[Calls]

- >> TIM_SelectInputTrigger

TIM_TIxExternalClockConfig (Thumb, 62 bytes, Stack size 24 bytes, stm32f4xx_tim.o(.text), UNUSED)

[Calls]

- >> TIM_SelectInputTrigger
- >> TI1_Config
- >> TI2_Config

TIM_ETRConfig (Thumb, 28 bytes, Stack size 12 bytes, stm32f4xx_tim.o(.text), UNUSED)

[Called By]

- >> TIM_ETRClockMode2Config
- >> TIM_ETRClockMode1Config

TIM_ETRClockMode1Config (Thumb, 54 bytes, Stack size 24 bytes, stm32f4xx_tim.o(.text), UNUSED)

[Calls]

- >> TIM_ETRConfig

TIM_ETRClockMode2Config (Thumb, 32 bytes, Stack size 20 bytes, stm32f4xx_tim.o(.text), UNUSED)

[Calls]

- >> TIM_ETRConfig

TIM_SelectOutputTrigger (Thumb, 18 bytes, Stack size 0 bytes, stm32f4xx_tim.o(.text), UNUSED)

TIM_SelectSlaveMode (Thumb, 18 bytes, Stack size 0 bytes, stm32f4xx_tim.o(.text), UNUSED)

TIM_SelectMasterSlaveMode (Thumb, 18 bytes, Stack size 0 bytes, stm32f4xx_tim.o(.text), UNUSED)

TIM_EncoderInterfaceConfig (Thumb, 66 bytes, Stack size 20 bytes, stm32f4xx_tim.o(.text))

[Stack]

- Max Depth = 20
- Call Chain = TIM_EncoderInterfaceConfig

[Called By]

- >> Encoder_Configration

TIM_SelectHallSensor (Thumb, 24 bytes, Stack size 0 bytes, stm32f4xx_tim.o(.text), UNUSED)

TIM_RemapConfig (Thumb, 6 bytes, Stack size 0 bytes, stm32f4xx_tim.o(.text), UNUSED)

USART_DeInit (Thumb, 156 bytes, Stack size 8 bytes, stm32f4xx_usart.o(.text), UNUSED)

[Calls]

- >> RCC_APB1PeriphResetCmd
- >> RCC_APB2PeriphResetCmd

USART_Init (Thumb, 204 bytes, Stack size 48 bytes, stm32f4xx_usart.o(.text))

[Stack]

- Max Depth = 68
- Call Chain = USART_Init ⇒ RCC_GetClocksFreq

[Calls]

- >> RCC_GetClocksFreq

[Called By]

- >> usart1_Configuration
- >> usart2_Configuration

USART_StructInit (Thumb, 24 bytes, Stack size 0 bytes, stm32f4xx_usart.o(.text), UNUSED)

USART_ClockInit (Thumb, 32 bytes, Stack size 8 bytes, stm32f4xx_usart.o(.text))

[Stack]

- Max Depth = 8
- Call Chain = USART_ClockInit

[Called By]

- >> usart1_Configuration
- >> usart2_Configuration

USART_ClockStructInit (Thumb, 12 bytes, Stack size 0 bytes, stm32f4xx_usart.o(.text), UNUSED)

USART_Cmd (Thumb, 24 bytes, Stack size 0 bytes, stm32f4xx_usart.o(.text))

[Called By]

- >> usart1_Configuration
- >> usart2_Configuration

USART_SetPrescaler (Thumb, 16 bytes, Stack size 0 bytes, stm32f4xx_usart.o(.text), UNUSED)

USART_OverSampling8Cmd (Thumb, 22 bytes, Stack size 0 bytes, stm32f4xx_usart.o(.text))

[Called By]

- >> usart1_Configuration
- >> usart2_Configuration

USART_OneBitMethodCmd (Thumb, 24 bytes, Stack size 0 bytes, stm32f4xx_usart.o(.text), UNUSED)

USART_SendData (Thumb, 8 bytes, Stack size 0 bytes, stm32f4xx_usart.o(.text))

[Called By]

- >> PutChar
- >> fputc

USART_ReceiveData (Thumb, 10 bytes, Stack size 0 bytes, stm32f4xx_usart.o(.text), UNUSED)

[Called By]

- >> inputDigit
- >> inputChar
- >> GetChar

USART_SetAddress (Thumb, 18 bytes, Stack size 0 bytes, stm32f4xx_usart.o(.text), UNUSED)

USART_ReceiverWakeUpCmd (Thumb, 24 bytes, Stack size 0 bytes, stm32f4xx_usart.o(.text), UNUSED)

USART_WakeUpConfig (Thumb, 18 bytes, Stack size 0 bytes, stm32f4xx_usart.o(.text), UNUSED)

USART_LINBreakDetectLengthConfig (Thumb, 18 bytes, Stack size 0 bytes, stm32f4xx_usart.o(.text), UNUSED)

USART_LINCmd (Thumb, 24 bytes, Stack size 0 bytes, stm32f4xx_usart.o(.text), UNUSED)

USART_SendBreak (Thumb, 10 bytes, Stack size 0 bytes, stm32f4xx_usart.o(.text), UNUSED)

USART_HalfDuplexCmd (Thumb, 24 bytes, Stack size 0 bytes, stm32f4xx_usart.o(.text), UNUSED)

USART_SetGuardTime (Thumb, 16 bytes, Stack size 0 bytes, stm32f4xx_usart.o(.text), UNUSED)

USART_SmartCardCmd (Thumb, 24 bytes, Stack size 0 bytes, stm32f4xx_usart.o(.text), UNUSED)

USART_SmartCardNACKCmd (Thumb, 24 bytes, Stack size 0 bytes, stm32f4xx_usart.o(.text), UNUSED)

USART_IrDAConfig (Thumb, 18 bytes, Stack size 0 bytes, stm32f4xx_usart.o(.text), UNUSED)

USART_IrDACmd (Thumb, 24 bytes, Stack size 0 bytes, stm32f4xx_usart.o(.text), UNUSED)

USART_DMACmd (Thumb, 18 bytes, Stack size 0 bytes, stm32f4xx_usart.o(.text), UNUSED)

USART_ITConfig (Thumb, 74 bytes, Stack size 20 bytes, stm32f4xx_usart.o(.text), UNUSED)

USART_GetFlagStatus (Thumb, 26 bytes, Stack size 0 bytes, stm32f4xx_usart.o(.text))

[Called By]

- >> inputDigit
- >> inputChar
- >> GetChar
- >> PutChar
- >> fputc

USART_ClearFlag (Thumb, 18 bytes, Stack size 0 bytes, stm32f4xx_usart.o(.text), UNUSED)

USART_GetITStatus (Thumb, 110 bytes, Stack size 16 bytes, stm32f4xx_usart.o(.text), UNUSED)

USART_ClearITPendingBit (Thumb, 30 bytes, Stack size 8 bytes, stm32f4xx_usart.o(.text), UNUSED)

systick (Thumb, 2 bytes, Stack size 0 bytes, main.o(.text))

[Called By]

- >> SysTick_Handler

button1_interrupt (Thumb, 2 bytes, Stack size 0 bytes, main.o(.text))

[Called By]

- >> EXTI9_5_IRQHandler

button2_interrupt (Thumb, 2 bytes, Stack size 0 bytes, main.o(.text))

[Called By]

- >> EXTI15_10_IRQHandler

main (Thumb, 152 bytes, Stack size 24 bytes, main.o(.text))

[Stack]

- Max Depth = 168 + Unknown Stack Size
- Call Chain = main ⇒ __2printf ⇒ _printf_char_file ⇒ _printf_char_common ⇒ __printf

[Calls]

- >> usart1_Configuration
- >> shortBeep
- >> setRightPwm
- >> setLeftPwm
- >> readVolMeter
- >> readSensor
- >> readGyro
- >> getRightEncCount
- >> getLeftEncCount
- >> displayMatrix
- >> delay_ms
- >> buzzer_Configuration
- >> button_Configuration
- >> TIM4_PWM_Init
- >> Systick_Configuration
- >> SPI_Configuration
- >> LED_Configuration
- >> Encoder_Configration
- >> ADC_Config
- >> __2printf

[Called By]

- >> __rt_entry_main

NMI_Handler (Thumb, 2 bytes, Stack size 0 bytes, stm32f4xx_it.o(.text))
[Address Reference Count : 1]

- startup_stm32f4xx.o(RESET)

HardFault_Handler (Thumb, 4 bytes, Stack size 0 bytes, stm32f4xx_it.o(.text))
[Address Reference Count : 1]

- startup_stm32f4xx.o(RESET)

MemManage_Handler (Thumb, 4 bytes, Stack size 0 bytes, stm32f4xx_it.o(.text))
[Address Reference Count : 1]

- startup_stm32f4xx.o(RESET)

BusFault_Handler (Thumb, 4 bytes, Stack size 0 bytes, stm32f4xx_it.o(.text))
[Address Reference Count : 1]

- startup_stm32f4xx.o(RESET)

UsageFault_Handler (Thumb, 4 bytes, Stack size 0 bytes, stm32f4xx_it.o(.text))
[Address Reference Count : 1]

- startup_stm32f4xx.o(RESET)

SVC_Handler (Thumb, 2 bytes, Stack size 0 bytes, stm32f4xx_it.o(.text))
[Address Reference Count : 1]

- startup_stm32f4xx.o(RESET)

DebugMon_Handler (Thumb, 2 bytes, Stack size 0 bytes, stm32f4xx_it.o(.text))
[Address Reference Count : 1]

- startup_stm32f4xx.o(RESET)

PendSV_Handler (Thumb, 2 bytes, Stack size 0 bytes, stm32f4xx_it.o(.text))
[Address Reference Count : 1]

- startup_stm32f4xx.o(RESET)

SysTick_Handler (Thumb, 42 bytes, Stack size 8 bytes, stm32f4xx_it.o(.text))

[Stack]

- Max Depth = 8
- Call Chain = SysTick_Handler

[Calls]

- >> systick

[Address Reference Count : 1]

- startup_stm32f4xx.o(RESET)

EXTI9_5_IRQHandler (Thumb, 28 bytes, Stack size 8 bytes, stm32f4xx_it.o(.text))

[Stack]

- Max Depth = 8
- Call Chain = EXTI9_5_IRQHandler

[Calls]

- >> delay_ms
- >> button1_interrupt
- >> EXTI_ClearITPendingBit
- >> EXTI_GetITStatus

[Address Reference Count : 1]

- startup_stm32f4xx.o(RESET)

EXTI15_10_IRQHandler (Thumb, 32 bytes, Stack size 8 bytes, stm32f4xx_it.o(.text))

[Stack]

- Max Depth = 8
- Call Chain = EXTI15_10_IRQHandler

[Calls]

- >> delay_ms
- >> button2_interrupt
- >> EXTI_ClearITPendingBit
- >> EXTI_GetITStatus

[Address Reference Count : 1]

- startup_stm32f4xx.o(RESET)

Systick_Configuration (Thumb, 96 bytes, Stack size 8 bytes, delay.o(.text))

[Stack]

- Max Depth = 28
- Call Chain = Systick_Configuration ⇒ SystemInit ⇒ SetSysClock

[Calls]

- >> SystemInit
- >> SystemCoreClockUpdate
- >> NVIC_SetPriority
- >> NVIC_PriorityGroupConfig

[Called By]

- >> main

micros (Thumb, 44 bytes, Stack size 0 bytes, delay.o(.text))

[Called By]

- >> elapseMicros
- >> delay_us
- >> readSensor

millis (Thumb, 6 bytes, Stack size 0 bytes, delay.o(.text), UNUSED)

[Called By]

- >> elapseMillis

delay_ms (Thumb, 18 bytes, Stack size 0 bytes, delay.o(.text))

[Called By]

- >> EXTI15_10_IRQHandler
- >> EXTI9_5_IRQHandler
- >> main
- >> lowBatCheck
- >> beep
- >> displayMatrixScroll

delay_us (Thumb, 24 bytes, Stack size 8 bytes, delay.o(.text), UNUSED)

[Calls]

- >> micros

elapseMicros (Thumb, 20 bytes, Stack size 8 bytes, delay.o(.text))

[Stack]

- Max Depth = 8
- Call Chain = elapseMicros

[Calls]

- >> micros

[Called By]

- >> readSensor

elapseMillis (Thumb, 18 bytes, Stack size 4 bytes, delay.o(.text), UNUSED)

[Calls]

- >> millis

LED_Configuration (Thumb, 174 bytes, Stack size 16 bytes, led.o(.text))

[Stack]

- Max Depth = 36
- Call Chain = LED_Configuration ⇒ GPIO_Init

[Calls]

- >> RCC_AHB1PeriphClockCmd
- >> GPIO_ResetBits
- >> GPIO_Init

[Called By]

- >> main

button_Configuration (Thumb, 204 bytes, Stack size 24 bytes, button.o(.text))

[Stack]

- Max Depth = 44
- Call Chain = button_Configuration ⇒ GPIO_Init

[Calls]

- >> SYSCFG_EXTILineConfig
- >> RCC_APB2PeriphClockCmd
- >> RCC_AHB1PeriphClockCmd
- >> GPIO_Init
- >> EXTI_Init
- >> NVIC_Init

[Called By]

- >> main

usart1_Configuration (Thumb, 166 bytes, Stack size 40 bytes, usart.o(.text))

[Stack]

- Max Depth = 108
- Call Chain = usart1_Configuration ⇒ USART_Init ⇒ RCC_GetClocksFreq

[Calls]

- >> USART_OverSampling8Cmd
- >> USART_Cmd
- >> USART_ClockInit
- >> USART_Init
- >> RCC_APB2PeriphClockCmd
- >> RCC_AHB1PeriphClockCmd
- >> GPIO_PinAFConfig
- >> GPIO_Init

[Called By]

- >> main

usart2_Configuration (Thumb, 164 bytes, Stack size 40 bytes, usart.o(.text), UNUSED)

[Calls]

- >> USART_OverSampling8Cmd
- >> USART_Cmd
- >> USART_ClockInit
- >> USART_Init
- >> RCC_APB1PeriphClockCmd
- >> RCC_AHB1PeriphClockCmd
- >> GPIO_PinAFConfig
- >> GPIO_Init

_sys_exit (Thumb, 6 bytes, Stack size 0 bytes, usart.o(.text))

[Called By]

- >> __rt_exit_exit

fputc (Thumb, 32 bytes, Stack size 16 bytes, usart.o(.text))

[Stack]

- Max Depth = 16
- Call Chain = fputc

[Calls]

- >> USART_GetFlagStatus
- >> USART_SendData

[Address Reference Count : 1]

- _printf_char_file.o(.text)

fgetc (Thumb, 24 bytes, Stack size 0 bytes, usart.o(.text))
[Address Reference Count : 1]

- scanf_char_file.o(.text)

PutChar (Thumb, 30 bytes, Stack size 8 bytes, usart.o(.text), UNUSED)

[Calls]

- >> USART_GetFlagStatus
- >> USART_SendData

GetChar (Thumb, 32 bytes, Stack size 8 bytes, usart.o(.text), UNUSED)

[Calls]

- >> USART_GetFlagStatus
- >> USART_ReceiveData
- >> __2printf

inputChar (Thumb, 48 bytes, Stack size 8 bytes, usart.o(.text), UNUSED)

[Calls]

- >> USART_GetFlagStatus
- >> USART_ReceiveData
- >> __2printf

inputDigit (Thumb, 50 bytes, Stack size 8 bytes, usart.o(.text), UNUSED)

[Calls]

- >> USART_GetFlagStatus
- >> USART_ReceiveData
- >> __2printf

inputString (Thumb, 72 bytes, Stack size 32 bytes, usart.o(.text), UNUSED)

[Calls]

- >> strcmp
- >> __0scanf
- >> __2printf

inputDigits (Thumb, 62 bytes, Stack size 16 bytes, usart.o(.text), UNUSED)

[Calls]

- >> __0scanf
- >> __2printf

displayMatrix (Thumb, 118 bytes, Stack size 24 bytes, matrixdisplay.o(.text))

[Stack]

- Max Depth = 24
- Call Chain = displayMatrix

[Calls]

- >> SPI_I2S_GetFlagStatus
- >> SPI_I2S_SendData
- >> GPIO_ResetBits
- >> GPIO_SetBits

[Called By]

- >> main
- >> lowBatCheck
- >> displayMatrixScroll
- >> displayInt
- >> displayFloat
- >> displayErr

displayErr (Thumb, 24 bytes, Stack size 16 bytes, matrixdisplay.o(.text), UNUSED)

[Calls]

- >> displayMatrix
- >> __2snprintf

displayFloat (Thumb, 60 bytes, Stack size 40 bytes, matrixdisplay.o(.text), UNUSED)

[Calls]

- >> displayMatrix
- >> __aeabi_f2d
- >> __2snprintf

displayInt (Thumb, 24 bytes, Stack size 16 bytes, matrixdisplay.o(.text), UNUSED)

[Calls]

- >> displayMatrix
- >> __2snprintf

[Called By]

- >> lowBatCheck

displayMatrixScroll (Thumb, 58 bytes, Stack size 16 bytes, matrixdisplay.o(.text), UNUSED)

[Calls]

- >> displayMatrix
- >> delay_ms

clearScreen (Thumb, 90 bytes, Stack size 8 bytes, matrixdisplay.o(.text))

[Stack]

- Max Depth = 8
- Call Chain = clearScreen

[Calls]

- >> SPI_I2S_GetFlagStatus
- >> SPI_I2S_SendData
- >> GPIO_ResetBits
- >> GPIO_SetBits

[Called By]

- >> SPI_Configuration
- >> lowBatCheck

WriteControlRegister (Thumb, 92 bytes, Stack size 8 bytes, spi.o(.text))

[Stack]

- Max Depth = 8
- Call Chain = WriteControlRegister

[Calls]

- >> SPI_I2S_GetFlagStatus
- >> SPI_I2S_SendData
- >> GPIO_ResetBits
- >> GPIO_SetBits

[Called By]

- >> SPI_Configuration

SPI_Configuration (Thumb, 252 bytes, Stack size 32 bytes, spi.o(.text))

[Stack]

- Max Depth = 52
- Call Chain = SPI_Configuration ⇒ GPIO_PinAFConfig

[Calls]

- >> SPI_SSOutputCmd
- >> SPI_NSSInternalSoftwareConfig
- >> SPI_Cmd
- >> SPI_StructInit
- >> SPI_Init
- >> SPI_I2S_DeInit
- >> RCC_APB1PeriphClockCmd
- >> RCC_AHB1PeriphClockCmd
- >> GPIO_PinAFConfig
- >> GPIO_SetBits
- >> GPIO_Init
- >> WriteControlRegister
- >> clearScreen

[Called By]

- >> main

TIM4_GPIO_Config (Thumb, 88 bytes, Stack size 16 bytes, pwm.o(.text))

[Stack]

- Max Depth = 36
- Call Chain = TIM4_GPIO_Config ⇒ GPIO_PinAFConfig

[Calls]

- >> RCC_APB1PeriphClockCmd
- >> GPIO_PinAFConfig
- >> GPIO_Init

[Called By]

- >> TIM4_PWM_Init

TIM4_Mode_Config (Thumb, 178 bytes, Stack size 40 bytes, pwm.o(.text))

[Stack]

- Max Depth = 56
- Call Chain = TIM4_Mode_Config ⇒ TIM_OC4Init

[Calls]

- >> TIM_OC4PreloadConfig
- >> TIM_OC3PreloadConfig
- >> TIM_OC2PreloadConfig
- >> TIM_OC1PreloadConfig
- >> TIM_OC4Init
- >> TIM_OC3Init
- >> TIM_OC2Init
- >> TIM_OC1Init
- >> TIM_Cmd
- >> TIM_ARRPreloadConfig
- >> TIM_TimeBaseInit

[Called By]

- >> TIM4_PWM_Init

TIM4_PWM_Init (Thumb, 12 bytes, Stack size 8 bytes, pwm.o(.text))

[Stack]

- Max Depth = 64
- Call Chain = TIM4_PWM_Init ⇒ TIM4_Mode_Config ⇒ TIM_OC4Init

[Calls]

- >> TIM4_Mode_Config
- >> TIM4_GPIO_Config

[Called By]

- >> main

setLeftPwm (Thumb, 54 bytes, Stack size 0 bytes, pwm.o(.text))

[Called By]

- >> main
- >> lowBatCheck

setRightPwm (Thumb, 54 bytes, Stack size 0 bytes, pwm.o(.text))

[Called By]

- >> main
- >> lowBatCheck

buzzer_Configuration (Thumb, 142 bytes, Stack size 48 bytes, buzzer.o(.text))

[Stack]

- Max Depth = 68
- Call Chain = buzzer_Configuration ⇒ GPIO_PinAFConfig

[Calls]

- >> TIM_OC1PreloadConfig
- >> TIM_OC1Init
- >> TIM_Cmd
- >> TIM_ARRPreloadConfig
- >> TIM_TimeBaseInit
- >> RCC_APB1PeriphClockCmd
- >> GPIO_PinAFConfig
- >> GPIO_Init

[Called By]

- >> main

beep (Thumb, 68 bytes, Stack size 16 bytes, buzzer.o(.text), UNUSED)

[Calls]

- >> delay_ms

shortBeep (Thumb, 42 bytes, Stack size 0 bytes, buzzer.o(.text))

[Called By]

- >> main

Encoder_Configration (Thumb, 152 bytes, Stack size 16 bytes, encoder.o(.text))

[Stack]

- Max Depth = 36
- Call Chain = Encoder_Configration ⇒ TIM_EncoderInterfaceConfig

[Calls]

- >> TIM_EncoderInterfaceConfig
- >> TIM_Cmd
- >> TIM_SetAutoreload
- >> RCC_APB1PeriphClockCmd
- >> GPIO_PinAFConfig
- >> GPIO_Init

[Called By]

- >> main

getRightEncCount (Thumb, 8 bytes, Stack size 0 bytes, encoder.o(.text))

[Called By]

- >> main

resetRightEncCount (Thumb, 10 bytes, Stack size 0 bytes, encoder.o(.text), UNUSED)

getLeftEncCount (Thumb, 8 bytes, Stack size 0 bytes, encoder.o(.text))

[Called By]

- >> main

resetLeftEncCount (Thumb, 10 bytes, Stack size 0 bytes, encoder.o(.text), UNUSED)

ADC_Config (Thumb, 186 bytes, Stack size 56 bytes, adc.o(.text))

[Stack]

- Max Depth = 76
- Call Chain = ADC_Config ⇒ GPIO_Init

[Calls]

- >> RCC_APB2PeriphClockCmd
- >> GPIO_ResetBits
- >> GPIO_Init
- >> ADC_ITConfig
- >> ADC_Cmd
- >> ADC_CommonInit
- >> ADC_Init

[Called By]

- >> main

readADC (Thumb, 48 bytes, Stack size 16 bytes, adc.o(.text))

[Stack]

- Max Depth = 36
- Call Chain = readADC ⇒ ADC_RegularChannelConfig

[Calls]

- >> ADC_GetFlagStatus
- >> ADC_GetConversionValue
- >> ADC_SoftwareStartConv
- >> ADC_RegularChannelConfig

[Called By]

- >> readVolMeter
- >> readSensor
- >> readGyro

readVolMeter (Thumb, 40 bytes, Stack size 8 bytes, sensor_function.o(.text))

[Stack]

- Max Depth = 44
- Call Chain = readVolMeter ⇒ readADC ⇒ ADC_RegularChannelConfig

[Calls]

- >> readADC

[Called By]

- >> readSensor
- >> main

readSensor (Thumb, 386 bytes, Stack size 8 bytes, sensor_function.o(.text))

[Stack]

- Max Depth = 52
- Call Chain = readSensor ⇒ readVolMeter ⇒ readADC ⇒ ADC_RegularChannelConfig

[Calls]

- >> elapseMicros
- >> micros
- >> readVolMeter
- >> GPIO_ResetBits
- >> GPIO_SetBits
- >> readADC

[Called By]

- >> main

readGyro (Thumb, 116 bytes, Stack size 16 bytes, sensor_function.o(.text))

[Stack]

- Max Depth = 52
- Call Chain = readGyro ⇒ readADC ⇒ ADC_RegularChannelConfig

[Calls]

- >> readADC

[Called By]

- >> main

lowBatCheck (Thumb, 278 bytes, Stack size 8 bytes, sensor_function.o(.text), UNUSED)

[Calls]

- >> setRightPwm
- >> setLeftPwm
- >> displayMatrix
- >> delay_ms
- >> GPIO_ResetBits
- >> GPIO_SetBits
- >> clearScreen
- >> displayInt

Reset_Handler (Thumb, 8 bytes, Stack size 0 bytes, startup_stm32f4xx.o(.text))
[Address Reference Count : 1]

- startup_stm32f4xx.o(RESET)

ADC_IRQHandler (Thumb, 0 bytes, Stack size 0 bytes, startup_stm32f4xx.o(.text))

[Calls]

- >> ADC_IRQHandler

[Called By]

- >> ADC_IRQHandler

[Address Reference Count : 1]

- startup_stm32f4xx.o(RESET)

CAN1_RX0_IRQHandler (Thumb, 0 bytes, Stack size 0 bytes, startup_stm32f4xx.o(.text))
[Address Reference Count : 1]

- startup_stm32f4xx.o(RESET)

CAN1_RX1_IRQHandler (Thumb, 0 bytes, Stack size 0 bytes, startup_stm32f4xx.o(.text))
[Address Reference Count : 1]

- startup_stm32f4xx.o(RESET)

CAN1_SCE_IRQHandler (Thumb, 0 bytes, Stack size 0 bytes, startup_stm32f4xx.o(.text))
[Address Reference Count : 1]

- startup_stm32f4xx.o(RESET)

CAN1_TX_IRQHandler (Thumb, 0 bytes, Stack size 0 bytes, startup_stm32f4xx.o(.text))
[Address Reference Count : 1]

- startup_stm32f4xx.o(RESET)

CAN2_RX0_IRQHandler (Thumb, 0 bytes, Stack size 0 bytes, startup_stm32f4xx.o(.text))
[Address Reference Count : 1]

- startup_stm32f4xx.o(RESET)

CAN2_RX1_IRQHandler (Thumb, 0 bytes, Stack size 0 bytes, startup_stm32f4xx.o(.text))
[Address Reference Count : 1]

- startup_stm32f4xx.o(RESET)

CAN2_SCE_IRQHandler (Thumb, 0 bytes, Stack size 0 bytes, startup_stm32f4xx.o(.text))
[Address Reference Count : 1]

- startup_stm32f4xx.o(RESET)

CAN2_TX_IRQHandler (Thumb, 0 bytes, Stack size 0 bytes, startup_stm32f4xx.o(.text))
[Address Reference Count : 1]

- startup_stm32f4xx.o(RESET)

CRYP_IRQHandler (Thumb, 0 bytes, Stack size 0 bytes, startup_stm32f4xx.o(.text))
[Address Reference Count : 1]

- startup_stm32f4xx.o(RESET)

DCMI_IRQHandler (Thumb, 0 bytes, Stack size 0 bytes, startup_stm32f4xx.o(.text))
[Address Reference Count : 1]

- startup_stm32f4xx.o(RESET)

DMA1_Stream0_IRQHandler (Thumb, 0 bytes, Stack size 0 bytes, startup_stm32f4xx.o(.text))
[Address Reference Count : 1]

- startup_stm32f4xx.o(RESET)

DMA1_Stream1_IRQHandler (Thumb, 0 bytes, Stack size 0 bytes, startup_stm32f4xx.o(.text))
[Address Reference Count : 1]

- startup_stm32f4xx.o(RESET)

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
[Address Reference Count : 1]

- startup_stm32f4xx.o(RESET)

TIM1_UP_TIM10_IRQHandler (Thumb, 0 bytes, Stack size 0 bytes, startup_stm32f4xx.o(.text))
[Address Reference Count : 1]

- startup_stm32f4xx.o(RESET)

TIM2_IRQHandler (Thumb, 0 bytes, Stack size 0 bytes, startup_stm32f4xx.o(.text))
[Address Reference Count : 1]

- startup_stm32f4xx.o(RESET)

TIM3_IRQHandler (Thumb, 0 bytes, Stack size 0 bytes, startup_stm32f4xx.o(.text))
[Address Reference Count : 1]

- startup_stm32f4xx.o(RESET)

TIM4_IRQHandler (Thumb, 0 bytes, Stack size 0 bytes, startup_stm32f4xx.o(.text))
[Address Reference Count : 1]

- startup_stm32f4xx.o(RESET)

TIM5_IRQHandler (Thumb, 0 bytes, Stack size 0 bytes, startup_stm32f4xx.o(.text))
[Address Reference Count : 1]

- startup_stm32f4xx.o(RESET)

TIM6_DAC_IRQHandler (Thumb, 0 bytes, Stack size 0 bytes, startup_stm32f4xx.o(.text))
[Address Reference Count : 1]

- startup_stm32f4xx.o(RESET)

TIM7_IRQHandler (Thumb, 0 bytes, Stack size 0 bytes, startup_stm32f4xx.o(.text))
[Address Reference Count : 1]

- startup_stm32f4xx.o(RESET)

TIM8_BRK_TIM12_IRQHandler (Thumb, 0 bytes, Stack size 0 bytes, startup_stm32f4xx.o(.text))
[Address Reference Count : 1]

- startup_stm32f4xx.o(RESET)

TIM8_CC_IRQHandler (Thumb, 0 bytes, Stack size 0 bytes, startup_stm32f4xx.o(.text))
[Address Reference Count : 1]

- startup_stm32f4xx.o(RESET)

TIM8_TRG_COM_TIM14_IRQHandler (Thumb, 0 bytes, Stack size 0 bytes, startup_stm32f4xx.o(.text))
[Address Reference Count : 1]

- startup_stm32f4xx.o(RESET)

TIM8_UP_TIM13_IRQHandler (Thumb, 0 bytes, Stack size 0 bytes, startup_stm32f4xx.o(.text))
[Address Reference Count : 1]

- startup_stm32f4xx.o(RESET)

UART4_IRQHandler (Thumb, 0 bytes, Stack size 0 bytes, startup_stm32f4xx.o(.text))
[Address Reference Count : 1]

- startup_stm32f4xx.o(RESET)

UART5_IRQHandler (Thumb, 0 bytes, Stack size 0 bytes, startup_stm32f4xx.o(.text))
[Address Reference Count : 1]

- startup_stm32f4xx.o(RESET)

USART1_IRQHandler (Thumb, 0 bytes, Stack size 0 bytes, startup_stm32f4xx.o(.text))
[Address Reference Count : 1]

- startup_stm32f4xx.o(RESET)

USART2_IRQHandler (Thumb, 0 bytes, Stack size 0 bytes, startup_stm32f4xx.o(.text))
[Address Reference Count : 1]

- startup_stm32f4xx.o(RESET)

USART3_IRQHandler (Thumb, 0 bytes, Stack size 0 bytes, startup_stm32f4xx.o(.text))
[Address Reference Count : 1]

- startup_stm32f4xx.o(RESET)

USART6_IRQHandler (Thumb, 0 bytes, Stack size 0 bytes, startup_stm32f4xx.o(.text))
[Address Reference Count : 1]

- startup_stm32f4xx.o(RESET)

WWDG_IRQHandler (Thumb, 0 bytes, Stack size 0 bytes, startup_stm32f4xx.o(.text))
[Address Reference Count : 1]

- startup_stm32f4xx.o(RESET)

__user_initial_stackheap (Thumb, 0 bytes, Stack size unknown bytes, startup_stm32f4xx.o(.text))

[Called By]

- >> __user_setup_stackheap

SystemInit (Thumb, 88 bytes, Stack size 8 bytes, system_stm32f4xx.o(.text))

[Stack]

- Max Depth = 20
- Call Chain = SystemInit ⇒ SetSysClock

[Calls]

- >> SetSysClock

[Called By]

- >> Systick_Configuration

[Address Reference Count : 1]

- startup_stm32f4xx.o(.text)

SystemCoreClockUpdate (Thumb, 174 bytes, Stack size 16 bytes, system_stm32f4xx.o(.text))

[Stack]

- Max Depth = 16
- Call Chain = SystemCoreClockUpdate

[Called By]

- >> Systick_Configuration

__use_no_semihosting (Thumb, 2 bytes, Stack size 0 bytes, use_no_semi_2.o(.text), UNUSED)

__2printf (Thumb, 20 bytes, Stack size 24 bytes, noretval__2printf.o(.text))

[Stack]

- Max Depth = 144 + Unknown Stack Size
- Call Chain = __2printf ⇒ _printf_char_file ⇒ _printf_char_common ⇒ __printf

[Calls]

- >> _printf_char_file

[Called By]

- >> main
- >> inputDigits
- >> inputString
- >> inputDigit
- >> inputChar
- >> GetChar

__2snprintf (Thumb, 48 bytes, Stack size 32 bytes, noretval__2snprintf.o(.text), UNUSED)

[Calls]

- >> _sputc
- >> _printf_char_common

[Called By]

- >> displayInt
- >> displayFloat
- >> displayErr

_printf_pre_padding (Thumb, 46 bytes, Stack size 16 bytes, _printf_pad.o(.text))

[Stack]

- Max Depth = 16
- Call Chain = _printf_pre_padding

[Called By]

- >> _printf_fp_infnan
- >> _printf_fp_dec_real
- >> _printf_int_common
- >> _printf_str

_printf_post_padding (Thumb, 36 bytes, Stack size 16 bytes, _printf_pad.o(.text))

[Stack]

- Max Depth = 16
- Call Chain = _printf_post_padding

[Called By]

- >> _printf_fp_infnan
- >> _printf_fp_dec_real
- >> _printf_int_common
- >> _printf_str

_printf_str (Thumb, 82 bytes, Stack size 16 bytes, _printf_str.o(.text))

[Stack]

- Max Depth = 32
- Call Chain = _printf_str ⇒ _printf_post_padding

[Calls]

- >> _printf_post_padding
- >> _printf_pre_padding

[Called By]

- >> _printf_cs_common

_printf_int_dec (Thumb, 102 bytes, Stack size 24 bytes, _printf_dec.o(.text))

[Stack]

- Max Depth = 72
- Call Chain = _printf_int_dec ⇒ _printf_int_common ⇒ _printf_post_padding

[Calls]

- >> _printf_int_common

[Called By]

- >> _printf_d

__printf (Thumb, 310 bytes, Stack size 40 bytes, __printf_flags_wp.o(.text))

[Stack]

- Max Depth = 40 + Unknown Stack Size
- Call Chain = __printf

[Calls]

- >> _printf_percent
- >> _is_digit

[Called By]

- >> _printf_char_common

__0scanf (Thumb, 26 bytes, Stack size 56 bytes, __0scanf.o(.text), UNUSED)

[Calls]

- >> __vfscanf_char_file

[Called By]

- >> inputDigits
- >> inputString

_scanf_int (Thumb, 336 bytes, Stack size 56 bytes, _scanf_int.o(.text), UNUSED)

[Calls]

- >> _chval

[Called By]

- >> __vfscanf

_scanf_string (Thumb, 218 bytes, Stack size 56 bytes, _scanf_str.o(.text), UNUSED)

[Called By]

- >> __vfscanf

strcmp (Thumb, 128 bytes, Stack size 0 bytes, strcmpv7m.o(.text))

[Called By]

- >> _get_lc_numeric
- >> inputString
- >> _get_lc_ctype

__use_two_region_memory (Thumb, 2 bytes, Stack size 0 bytes, heapauxi.o(.text), UNUSED)

__rt_heap_escrow$2region (Thumb, 2 bytes, Stack size 0 bytes, heapauxi.o(.text), UNUSED)

__rt_heap_expand$2region (Thumb, 2 bytes, Stack size 0 bytes, heapauxi.o(.text), UNUSED)

__I$use$semihosting (Thumb, 0 bytes, Stack size 0 bytes, use_no_semi.o(.text), UNUSED)

__use_no_semihosting_swi (Thumb, 2 bytes, Stack size 0 bytes, use_no_semi.o(.text), UNUSED)

_printf_int_common (Thumb, 184 bytes, Stack size 32 bytes, _printf_intcommon.o(.text))

[Stack]

- Max Depth = 48
- Call Chain = _printf_int_common ⇒ _printf_post_padding

[Calls]

- >> _printf_post_padding
- >> _printf_pre_padding

[Called By]

- >> _printf_int_dec

__lib_sel_fp_printf (Thumb, 2 bytes, Stack size 0 bytes, _printf_fp_dec.o(.text), UNUSED)

_printf_fp_dec_real (Thumb, 628 bytes, Stack size 104 bytes, _printf_fp_dec.o(.text))

[Stack]

- Max Depth = 320
- Call Chain = _printf_fp_dec_real ⇒ _fp_digits ⇒ _btod_etento ⇒ _btod_emul ⇒ _e2e

[Calls]

- >> __ARM_fpclassify
- >> _printf_fp_infnan
- >> __rt_locale
- >> _fp_digits
- >> _printf_post_padding
- >> _printf_pre_padding

[Called By]

- >> _printf_fp_dec

_printf_char_common (Thumb, 32 bytes, Stack size 64 bytes, _printf_char_common.o(.text))

[Stack]

- Max Depth = 104 + Unknown Stack Size
- Call Chain = _printf_char_common ⇒ __printf

[Calls]

- >> __printf

[Called By]

- >> _printf_char_file
- >> __2snprintf

_sputc (Thumb, 10 bytes, Stack size 0 bytes, _sputc.o(.text), UNUSED)

[Called By]

- >> __2snprintf

_snputc (Thumb, 16 bytes, Stack size 0 bytes, _snputc.o(.text))
[Address Reference Count : 1]

- noretval__2snprintf.o(.text)

_printf_cs_common (Thumb, 20 bytes, Stack size 8 bytes, _printf_char.o(.text))

[Stack]

- Max Depth = 40
- Call Chain = _printf_cs_common ⇒ _printf_str ⇒ _printf_post_padding

[Calls]

- >> _printf_str

[Called By]

- >> _printf_string
- >> _printf_char

_printf_char (Thumb, 16 bytes, Stack size 0 bytes, _printf_char.o(.text))

[Stack]

- Max Depth = 40
- Call Chain = _printf_char ⇒ _printf_cs_common ⇒ _printf_str ⇒ _printf_post_padding

[Calls]

- >> _printf_cs_common

[Called By]

- >> _printf_c

_printf_string (Thumb, 8 bytes, Stack size 0 bytes, _printf_char.o(.text))

[Stack]

- Max Depth = 40
- Call Chain = _printf_string ⇒ _printf_cs_common ⇒ _printf_str ⇒ _printf_post_padding

[Calls]

- >> _printf_cs_common

[Called By]

- >> _printf_s

_printf_char_file (Thumb, 32 bytes, Stack size 16 bytes, _printf_char_file.o(.text))

[Stack]

- Max Depth = 120 + Unknown Stack Size
- Call Chain = _printf_char_file ⇒ _printf_char_common ⇒ __printf

[Calls]

- >> ferror
- >> _printf_char_common

[Called By]

- >> __2printf

_chval (Thumb, 28 bytes, Stack size 0 bytes, _chval.o(.text), UNUSED)

[Called By]

- >> _scanf_int

__vfscanf_char_file (Thumb, 16 bytes, Stack size 0 bytes, scanf_char_file.o(.text), UNUSED)

[Calls]

- >> __vfscanf_char

[Called By]

- >> __0scanf

__rt_locale (Thumb, 8 bytes, Stack size 0 bytes, rt_locale_intlibspace.o(.text))

[Called By]

- >> __rt_lib_init_lc_common
- >> _printf_fp_dec_real
- >> __rt_ctype_table

_ll_udiv10 (Thumb, 138 bytes, Stack size 12 bytes, lludiv10.o(.text))

[Stack]

- Max Depth = 12
- Call Chain = _ll_udiv10

[Called By]

- >> _fp_digits

_printf_fp_infnan (Thumb, 112 bytes, Stack size 24 bytes, _printf_fp_infnan.o(.text))

[Stack]

- Max Depth = 40
- Call Chain = _printf_fp_infnan ⇒ _printf_post_padding

[Calls]

- >> _printf_post_padding
- >> _printf_pre_padding

[Called By]

- >> _printf_fp_dec_real

__vfscanf_char (Thumb, 24 bytes, Stack size 0 bytes, scanf_char.o(.text), UNUSED)

[Calls]

- >> __vfscanf

[Called By]

- >> __vfscanf_char_file

_btod_etento (Thumb, 222 bytes, Stack size 72 bytes, bigflt0.o(.text))

[Stack]

- Max Depth = 120
- Call Chain = _btod_etento ⇒ _btod_emul ⇒ _e2e

[Calls]

- >> _btod_emul
- >> _btod_ediv

[Called By]

- >> _fp_digits

___backspace$unlocked (Thumb, 2 bytes, Stack size 0 bytes, backspace.o(.text), UNUSED)

__backspace (Thumb, 70 bytes, Stack size 8 bytes, backspace.o(.text))

[Stack]

- Max Depth = 8
- Call Chain = __backspace

[Calls]

- >> _ungetc_internal

[Address Reference Count : 1]

- scanf_char_file.o(.text)

ferror (Thumb, 8 bytes, Stack size 0 bytes, ferror.o(.text))

[Called By]

- >> _printf_char_file

__user_libspace (Thumb, 8 bytes, Stack size 0 bytes, libspace.o(.text), UNUSED)

__user_perproc_libspace (Thumb, 0 bytes, Stack size 0 bytes, libspace.o(.text))

[Called By]

- >> __user_setup_stackheap

__user_perthread_libspace (Thumb, 0 bytes, Stack size 0 bytes, libspace.o(.text), UNUSED)

__user_setup_stackheap (Thumb, 74 bytes, Stack size 8 bytes, sys_stackheap_outer.o(.text))

[Stack]

- Max Depth = 8 + Unknown Stack Size
- Call Chain = __user_setup_stackheap

[Calls]

- >> __user_perproc_libspace
- >> __user_initial_stackheap

[Called By]

- >> __rt_entry_sh

isspace (Thumb, 18 bytes, Stack size 8 bytes, isspace.o(.text))

[Stack]

- Max Depth = 16
- Call Chain = isspace ⇒ __rt_ctype_table

[Calls]

- >> __rt_ctype_table

[Address Reference Count : 1]

- scanf_char.o(.text)

__vfscanf (Thumb, 876 bytes, Stack size 96 bytes, _scanf.o(.text), UNUSED)

[Calls]

- >> _scanf_string
- >> _scanf_int

[Called By]

- >> __vfscanf_char

_ungetc_internal (Thumb, 60 bytes, Stack size 0 bytes, ungetc.o(.text))

[Called By]

- >> __backspace

ungetc (Thumb, 0 bytes, Stack size 0 bytes, ungetc.o(.text), UNUSED)

exit (Thumb, 12 bytes, Stack size 0 bytes, exit.o(.text))

[Calls]

- >> __rt_exit

[Called By]

- >> __rt_entry_main

__rt_ctype_table (Thumb, 16 bytes, Stack size 8 bytes, rt_ctype_table.o(.text))

[Stack]

- Max Depth = 8
- Call Chain = __rt_ctype_table

[Calls]

- >> __rt_locale

[Called By]

- >> isspace

_btod_d2e (Thumb, 62 bytes, Stack size 0 bytes, btod.o(CL$$btod_d2e))

[Calls]

- >> _d2e_norm_op1

[Called By]

- >> _fp_digits

_d2e_denorm_low (Thumb, 70 bytes, Stack size 0 bytes, btod.o(CL$$btod_d2e_denorm_low))

[Called By]

- >> _d2e_norm_op1

_d2e_norm_op1 (Thumb, 96 bytes, Stack size 0 bytes, btod.o(CL$$btod_d2e_norm_op1))

[Calls]

- >> _d2e_denorm_low

[Called By]

- >> _btod_d2e

__btod_div_common (Thumb, 696 bytes, Stack size 24 bytes, btod.o(CL$$btod_div_common))

[Stack]

- Max Depth = 24
- Call Chain = __btod_div_common

[Called By]

- >> _btod_ediv

_e2e (Thumb, 198 bytes, Stack size 24 bytes, btod.o(CL$$btod_e2e))

[Stack]

- Max Depth = 24
- Call Chain = _e2e

[Called By]

- >> _btod_emul
- >> _btod_ediv

_btod_ediv (Thumb, 40 bytes, Stack size 24 bytes, btod.o(CL$$btod_ediv))

[Stack]

- Max Depth = 48
- Call Chain = _btod_ediv ⇒ _e2e

[Calls]

- >> _e2e
- >> __btod_div_common

[Called By]

- >> _btod_etento
- >> _fp_digits

_btod_emul (Thumb, 40 bytes, Stack size 24 bytes, btod.o(CL$$btod_emul))

[Stack]

- Max Depth = 48
- Call Chain = _btod_emul ⇒ _e2e

[Calls]

- >> __btod_mult_common
- >> _e2e

[Called By]

- >> _btod_etento
- >> _fp_digits

__btod_mult_common (Thumb, 580 bytes, Stack size 16 bytes, btod.o(CL$$btod_mult_common))

[Stack]

- Max Depth = 16
- Call Chain = __btod_mult_common

[Called By]

- >> _btod_emul

__ARM_fpclassify (Thumb, 48 bytes, Stack size 8 bytes, fpclassify.o(i.__ARM_fpclassify))

[Stack]

- Max Depth = 8
- Call Chain = __ARM_fpclassify

[Called By]

- >> _printf_fp_dec_real

_is_digit (Thumb, 14 bytes, Stack size 0 bytes, __printf_wp.o(i._is_digit))

[Called By]

- >> __printf

_get_lc_numeric (Thumb, 44 bytes, Stack size 8 bytes, lc_numeric_c.o(locale$$code))

[Stack]

- Max Depth = 8
- Call Chain = _get_lc_numeric

[Calls]

- >> strcmp

[Called By]

- >> __rt_lib_init_lc_numeric_2

_get_lc_ctype (Thumb, 44 bytes, Stack size 8 bytes, lc_ctype_c.o(locale$$code))

[Stack]

- Max Depth = 8
- Call Chain = _get_lc_ctype

[Calls]

- >> strcmp

[Called By]

- >> __rt_lib_init_lc_ctype_2

[Address Reference Count : 1]

- rt_ctype_table.o(.text)

__fpl_dretinf (Thumb, 12 bytes, Stack size 0 bytes, dretinf.o(x$fpl$dretinf), UNUSED)

[Called By]

- >> _f2d

__aeabi_f2d (Thumb, 0 bytes, Stack size 16 bytes, f2d.o(x$fpl$f2d), UNUSED)

[Called By]

- >> displayFloat

_f2d (Thumb, 86 bytes, Stack size 16 bytes, f2d.o(x$fpl$f2d), UNUSED)

[Calls]

- >> __fpl_fnaninf
- >> __fpl_dretinf

__fpl_fnaninf (Thumb, 140 bytes, Stack size 8 bytes, fnaninf.o(x$fpl$fnaninf), UNUSED)

[Called By]

- >> _f2d

_fp_init (Thumb, 10 bytes, Stack size 0 bytes, fpinit.o(x$fpl$fpinit))

[Called By]

- >> __rt_lib_init_fp_1

__fplib_config_fpu_vfp (Thumb, 0 bytes, Stack size unknown bytes, fpinit.o(x$fpl$fpinit), UNUSED)

__fplib_config_pureend_doubles (Thumb, 0 bytes, Stack size unknown bytes, fpinit.o(x$fpl$fpinit), UNUSED)

_printf_fp_dec (Thumb, 4 bytes, Stack size 0 bytes, printf1.o(x$fpl$printf1))

[Stack]

- Max Depth = 320
- Call Chain = _printf_fp_dec ⇒ _printf_fp_dec_real ⇒ _fp_digits ⇒ _btod_etento ⇒ _btod_emul ⇒ _e2e

[Calls]

- >> _printf_fp_dec_real

[Called By]

- >> _printf_f

### Local Symbols

TI4_Config (Thumb, 80 bytes, Stack size 20 bytes, stm32f4xx_tim.o(.text), UNUSED)

[Called By]

- >> TIM_ICInit

TI3_Config (Thumb, 72 bytes, Stack size 20 bytes, stm32f4xx_tim.o(.text), UNUSED)

[Called By]

- >> TIM_ICInit

TI2_Config (Thumb, 90 bytes, Stack size 20 bytes, stm32f4xx_tim.o(.text), UNUSED)

[Called By]

- >> TIM_TIxExternalClockConfig
- >> TIM_PWMIConfig
- >> TIM_ICInit

TI1_Config (Thumb, 58 bytes, Stack size 20 bytes, stm32f4xx_tim.o(.text), UNUSED)

[Called By]

- >> TIM_TIxExternalClockConfig
- >> TIM_PWMIConfig
- >> TIM_ICInit

NVIC_SetPriority (Thumb, 32 bytes, Stack size 8 bytes, delay.o(.text))

[Stack]

- Max Depth = 8
- Call Chain = NVIC_SetPriority

[Called By]

- >> Systick_Configuration

SetSysClock (Thumb, 382 bytes, Stack size 12 bytes, system_stm32f4xx.o(.text))

[Stack]

- Max Depth = 12
- Call Chain = SetSysClock

[Called By]

- >> SystemInit

_fp_digits (Thumb, 426 bytes, Stack size 96 bytes, _printf_fp_dec.o(.text))

[Stack]

- Max Depth = 216
- Call Chain = _fp_digits ⇒ _btod_etento ⇒ _btod_emul ⇒ _e2e

[Calls]

- >> _btod_emul
- >> _btod_ediv
- >> _btod_d2e
- >> _btod_etento
- >> _ll_udiv10

[Called By]

- >> _printf_fp_dec_real

_printf_input_char (Thumb, 10 bytes, Stack size 0 bytes, _printf_char_common.o(.text))
[Address Reference Count : 1]

- _printf_char_common.o(.text)

_scanf_char_input (Thumb, 12 bytes, Stack size 0 bytes, scanf_char.o(.text))
[Address Reference Count : 1]

- scanf_char.o(.text)

### Undefined Global Symbols
