zht043/MicroMouse-Team1/Reference materials/STM32_NucleoBoard_Experiment/XXXXXCLICK HEREXXXXX/Code/MDK-ARM/STM32F446xx/STM32F446xx.htm

# Static Call Graph for image STM32F446xx\STM32F446xx.axf

#<CALLGRAPH># ARM Linker, 5060528: Last Updated: Sun May 27 01:53:18 2018

### Maximum Stack Usage = 200 bytes + Unknown(Cycles, Untraceable Function Pointers)

### Call chain for Maximum Stack Depth:

main ⇒ goodLuck ⇒ initUSART ⇒ Pxx_decoder

### Mutually Recursive functions

- ADC_IRQHandler ⇒ ADC_IRQHandler
- BusFault_Handler ⇒ BusFault_Handler
- HardFault_Handler ⇒ HardFault_Handler
- MemManage_Handler ⇒ MemManage_Handler
- UsageFault_Handler ⇒ UsageFault_Handler

### Function Pointers

- ADC_IRQHandler from startup_stm32f446xx.o(.text) referenced from startup_stm32f446xx.o(RESET)
- BusFault_Handler from stm32f4xx_it.o(i.BusFault_Handler) referenced from startup_stm32f446xx.o(RESET)
- CAN1_RX0_IRQHandler from startup_stm32f446xx.o(.text) referenced from startup_stm32f446xx.o(RESET)
- CAN1_RX1_IRQHandler from startup_stm32f446xx.o(.text) referenced from startup_stm32f446xx.o(RESET)
- CAN1_SCE_IRQHandler from startup_stm32f446xx.o(.text) referenced from startup_stm32f446xx.o(RESET)
- CAN1_TX_IRQHandler from startup_stm32f446xx.o(.text) referenced from startup_stm32f446xx.o(RESET)
- CAN2_RX0_IRQHandler from startup_stm32f446xx.o(.text) referenced from startup_stm32f446xx.o(RESET)
- CAN2_RX1_IRQHandler from startup_stm32f446xx.o(.text) referenced from startup_stm32f446xx.o(RESET)
- CAN2_SCE_IRQHandler from startup_stm32f446xx.o(.text) referenced from startup_stm32f446xx.o(RESET)
- CAN2_TX_IRQHandler from startup_stm32f446xx.o(.text) referenced from startup_stm32f446xx.o(RESET)
- CEC_IRQHandler from startup_stm32f446xx.o(.text) referenced from startup_stm32f446xx.o(RESET)
- DCMI_IRQHandler from startup_stm32f446xx.o(.text) referenced from startup_stm32f446xx.o(RESET)
- DMA1_Stream0_IRQHandler from startup_stm32f446xx.o(.text) referenced from startup_stm32f446xx.o(RESET)
- DMA1_Stream1_IRQHandler from startup_stm32f446xx.o(.text) referenced from startup_stm32f446xx.o(RESET)
- DMA1_Stream2_IRQHandler from startup_stm32f446xx.o(.text) referenced from startup_stm32f446xx.o(RESET)
- DMA1_Stream3_IRQHandler from startup_stm32f446xx.o(.text) referenced from startup_stm32f446xx.o(RESET)
- DMA1_Stream4_IRQHandler from startup_stm32f446xx.o(.text) referenced from startup_stm32f446xx.o(RESET)
- DMA1_Stream5_IRQHandler from startup_stm32f446xx.o(.text) referenced from startup_stm32f446xx.o(RESET)
- DMA1_Stream6_IRQHandler from startup_stm32f446xx.o(.text) referenced from startup_stm32f446xx.o(RESET)
- DMA1_Stream7_IRQHandler from startup_stm32f446xx.o(.text) referenced from startup_stm32f446xx.o(RESET)
- DMA2_Stream0_IRQHandler from startup_stm32f446xx.o(.text) referenced from startup_stm32f446xx.o(RESET)
- DMA2_Stream1_IRQHandler from startup_stm32f446xx.o(.text) referenced from startup_stm32f446xx.o(RESET)
- DMA2_Stream2_IRQHandler from startup_stm32f446xx.o(.text) referenced from startup_stm32f446xx.o(RESET)
- DMA2_Stream3_IRQHandler from startup_stm32f446xx.o(.text) referenced from startup_stm32f446xx.o(RESET)
- DMA2_Stream4_IRQHandler from startup_stm32f446xx.o(.text) referenced from startup_stm32f446xx.o(RESET)
- DMA2_Stream5_IRQHandler from startup_stm32f446xx.o(.text) referenced from startup_stm32f446xx.o(RESET)
- DMA2_Stream6_IRQHandler from startup_stm32f446xx.o(.text) referenced from startup_stm32f446xx.o(RESET)
- DMA2_Stream7_IRQHandler from startup_stm32f446xx.o(.text) referenced from startup_stm32f446xx.o(RESET)
- DebugMon_Handler from stm32f4xx_it.o(i.DebugMon_Handler) referenced from startup_stm32f446xx.o(RESET)
- EXTI0_IRQHandler from startup_stm32f446xx.o(.text) referenced from startup_stm32f446xx.o(RESET)
- EXTI15_10_IRQHandler from startup_stm32f446xx.o(.text) referenced from startup_stm32f446xx.o(RESET)
- EXTI1_IRQHandler from startup_stm32f446xx.o(.text) referenced from startup_stm32f446xx.o(RESET)
- EXTI2_IRQHandler from startup_stm32f446xx.o(.text) referenced from startup_stm32f446xx.o(RESET)
- EXTI3_IRQHandler from startup_stm32f446xx.o(.text) referenced from startup_stm32f446xx.o(RESET)
- EXTI4_IRQHandler from startup_stm32f446xx.o(.text) referenced from startup_stm32f446xx.o(RESET)
- EXTI9_5_IRQHandler from startup_stm32f446xx.o(.text) referenced from startup_stm32f446xx.o(RESET)
- FLASH_IRQHandler from startup_stm32f446xx.o(.text) referenced from startup_stm32f446xx.o(RESET)
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
- TIM2_IRQHandler from startup_stm32f446xx.o(.text) referenced from startup_stm32f446xx.o(RESET)
- TIM3_IRQHandler from stm32f4xx_it.o(i.TIM3_IRQHandler) referenced from startup_stm32f446xx.o(RESET)
- TIM4_IRQHandler from startup_stm32f446xx.o(.text) referenced from startup_stm32f446xx.o(RESET)
- TIM5_IRQHandler from startup_stm32f446xx.o(.text) referenced from startup_stm32f446xx.o(RESET)
- TIM6_DAC_IRQHandler from startup_stm32f446xx.o(.text) referenced from startup_stm32f446xx.o(RESET)
- TIM7_IRQHandler from startup_stm32f446xx.o(.text) referenced from startup_stm32f446xx.o(RESET)
- TIM8_BRK_TIM12_IRQHandler from startup_stm32f446xx.o(.text) referenced from startup_stm32f446xx.o(RESET)
- TIM8_CC_IRQHandler from startup_stm32f446xx.o(.text) referenced from startup_stm32f446xx.o(RESET)
- TIM8_TRG_COM_TIM14_IRQHandler from startup_stm32f446xx.o(.text) referenced from startup_stm32f446xx.o(RESET)
- TIM8_UP_TIM13_IRQHandler from startup_stm32f446xx.o(.text) referenced from startup_stm32f446xx.o(RESET)
- UART4_IRQHandler from startup_stm32f446xx.o(.text) referenced from startup_stm32f446xx.o(RESET)
- UART5_IRQHandler from startup_stm32f446xx.o(.text) referenced from startup_stm32f446xx.o(RESET)
- USART1_IRQHandler from startup_stm32f446xx.o(.text) referenced from startup_stm32f446xx.o(RESET)
- USART2_IRQHandler from startup_stm32f446xx.o(.text) referenced from startup_stm32f446xx.o(RESET)
- USART3_IRQHandler from startup_stm32f446xx.o(.text) referenced from startup_stm32f446xx.o(RESET)
- USART6_IRQHandler from startup_stm32f446xx.o(.text) referenced from startup_stm32f446xx.o(RESET)
- UsageFault_Handler from stm32f4xx_it.o(i.UsageFault_Handler) referenced from startup_stm32f446xx.o(RESET)
- WWDG_IRQHandler from startup_stm32f446xx.o(.text) referenced from startup_stm32f446xx.o(RESET)
- __main from entry.o(.ARM.Collect$$$$00000000) referenced from startup_stm32f446xx.o(.text)
- fputc from usart.o(i.fputc) referenced from printf3.o(i.__0printf$3)
- main from main.o(i.main) referenced from entry9a.o(.ARM.Collect$$$$0000000B)

### Global Symbols

__main (Thumb, 0 bytes, Stack size unknown bytes, entry.o(.ARM.Collect$$$$00000000))
[Address Reference Count : 1]

- startup_stm32f446xx.o(.text)

_main_stk (Thumb, 0 bytes, Stack size unknown bytes, entry2.o(.ARM.Collect$$$$00000001))

_main_scatterload (Thumb, 0 bytes, Stack size unknown bytes, entry5.o(.ARM.Collect$$$$00000004))

[Calls]

- >> __scatterload

__main_after_scatterload (Thumb, 0 bytes, Stack size unknown bytes, entry5.o(.ARM.Collect$$$$00000004))

[Called By]

- >> __scatterload

_main_clock (Thumb, 0 bytes, Stack size unknown bytes, entry7b.o(.ARM.Collect$$$$00000008))

_main_cpp_init (Thumb, 0 bytes, Stack size unknown bytes, entry8b.o(.ARM.Collect$$$$0000000A))

_main_init (Thumb, 0 bytes, Stack size unknown bytes, entry9a.o(.ARM.Collect$$$$0000000B))

__rt_final_cpp (Thumb, 0 bytes, Stack size unknown bytes, entry10a.o(.ARM.Collect$$$$0000000D))

__rt_final_exit (Thumb, 0 bytes, Stack size unknown bytes, entry11a.o(.ARM.Collect$$$$0000000F))

Reset_Handler (Thumb, 8 bytes, Stack size 0 bytes, startup_stm32f446xx.o(.text))
[Address Reference Count : 1]

- startup_stm32f446xx.o(RESET)

ADC_IRQHandler (Thumb, 0 bytes, Stack size 0 bytes, startup_stm32f446xx.o(.text))

[Calls]

- >> ADC_IRQHandler

[Called By]

- >> ADC_IRQHandler

[Address Reference Count : 1]

- startup_stm32f446xx.o(RESET)

CAN1_RX0_IRQHandler (Thumb, 0 bytes, Stack size 0 bytes, startup_stm32f446xx.o(.text))
[Address Reference Count : 1]

- startup_stm32f446xx.o(RESET)

CAN1_RX1_IRQHandler (Thumb, 0 bytes, Stack size 0 bytes, startup_stm32f446xx.o(.text))
[Address Reference Count : 1]

- startup_stm32f446xx.o(RESET)

CAN1_SCE_IRQHandler (Thumb, 0 bytes, Stack size 0 bytes, startup_stm32f446xx.o(.text))
[Address Reference Count : 1]

- startup_stm32f446xx.o(RESET)

CAN1_TX_IRQHandler (Thumb, 0 bytes, Stack size 0 bytes, startup_stm32f446xx.o(.text))
[Address Reference Count : 1]

- startup_stm32f446xx.o(RESET)

CAN2_RX0_IRQHandler (Thumb, 0 bytes, Stack size 0 bytes, startup_stm32f446xx.o(.text))
[Address Reference Count : 1]

- startup_stm32f446xx.o(RESET)

CAN2_RX1_IRQHandler (Thumb, 0 bytes, Stack size 0 bytes, startup_stm32f446xx.o(.text))
[Address Reference Count : 1]

- startup_stm32f446xx.o(RESET)

CAN2_SCE_IRQHandler (Thumb, 0 bytes, Stack size 0 bytes, startup_stm32f446xx.o(.text))
[Address Reference Count : 1]

- startup_stm32f446xx.o(RESET)

CAN2_TX_IRQHandler (Thumb, 0 bytes, Stack size 0 bytes, startup_stm32f446xx.o(.text))
[Address Reference Count : 1]

- startup_stm32f446xx.o(RESET)

CEC_IRQHandler (Thumb, 0 bytes, Stack size 0 bytes, startup_stm32f446xx.o(.text))
[Address Reference Count : 1]

- startup_stm32f446xx.o(RESET)

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
[Address Reference Count : 1]

- startup_stm32f446xx.o(RESET)

UART4_IRQHandler (Thumb, 0 bytes, Stack size 0 bytes, startup_stm32f446xx.o(.text))
[Address Reference Count : 1]

- startup_stm32f446xx.o(RESET)

UART5_IRQHandler (Thumb, 0 bytes, Stack size 0 bytes, startup_stm32f446xx.o(.text))
[Address Reference Count : 1]

- startup_stm32f446xx.o(RESET)

USART1_IRQHandler (Thumb, 0 bytes, Stack size 0 bytes, startup_stm32f446xx.o(.text))
[Address Reference Count : 1]

- startup_stm32f446xx.o(RESET)

USART2_IRQHandler (Thumb, 0 bytes, Stack size 0 bytes, startup_stm32f446xx.o(.text))
[Address Reference Count : 1]

- startup_stm32f446xx.o(RESET)

USART3_IRQHandler (Thumb, 0 bytes, Stack size 0 bytes, startup_stm32f446xx.o(.text))
[Address Reference Count : 1]

- startup_stm32f446xx.o(RESET)

USART6_IRQHandler (Thumb, 0 bytes, Stack size 0 bytes, startup_stm32f446xx.o(.text))
[Address Reference Count : 1]

- startup_stm32f446xx.o(RESET)

WWDG_IRQHandler (Thumb, 0 bytes, Stack size 0 bytes, startup_stm32f446xx.o(.text))
[Address Reference Count : 1]

- startup_stm32f446xx.o(RESET)

__aeabi_memcpy (Thumb, 36 bytes, Stack size 0 bytes, memcpya.o(.text), UNUSED)

__aeabi_memcpy4 (Thumb, 0 bytes, Stack size 0 bytes, memcpya.o(.text))

[Called By]

- >> initUSART
- >> initIO
- >> Pxx_decoder

__aeabi_memcpy8 (Thumb, 0 bytes, Stack size 0 bytes, memcpya.o(.text), UNUSED)

__aeabi_uidiv (Thumb, 0 bytes, Stack size 12 bytes, uidiv.o(.text), UNUSED)

__aeabi_uidivmod (Thumb, 44 bytes, Stack size 12 bytes, uidiv.o(.text), UNUSED)

[Called By]

- >> _printf_core

__scatterload (Thumb, 28 bytes, Stack size 0 bytes, init.o(.text))

[Calls]

- >> __main_after_scatterload

[Called By]

- >> _main_scatterload

__scatterload_rt2 (Thumb, 0 bytes, Stack size 0 bytes, init.o(.text), UNUSED)

ADC_Cmd (Thumb, 20 bytes, Stack size 0 bytes, stm32f4xx_adc.o(i.ADC_Cmd))

[Called By]

- >> initADC

ADC_CommonInit (Thumb, 34 bytes, Stack size 8 bytes, stm32f4xx_adc.o(i.ADC_CommonInit))

[Stack]

- Max Depth = 8
- Call Chain = ADC_CommonInit

[Called By]

- >> initADC

ADC_DMACmd (Thumb, 20 bytes, Stack size 0 bytes, stm32f4xx_adc.o(i.ADC_DMACmd))

[Called By]

- >> initADC

ADC_DMARequestAfterLastTransferCmd (Thumb, 20 bytes, Stack size 0 bytes, stm32f4xx_adc.o(i.ADC_DMARequestAfterLastTransferCmd))

[Called By]

- >> initADC

ADC_Init (Thumb, 66 bytes, Stack size 12 bytes, stm32f4xx_adc.o(i.ADC_Init))

[Stack]

- Max Depth = 12
- Call Chain = ADC_Init

[Called By]

- >> initADC

ADC_RegularChannelConfig (Thumb, 116 bytes, Stack size 16 bytes, stm32f4xx_adc.o(i.ADC_RegularChannelConfig))

[Stack]

- Max Depth = 16
- Call Chain = ADC_RegularChannelConfig

[Called By]

- >> initADC

ADC_SoftwareStartConv (Thumb, 10 bytes, Stack size 0 bytes, stm32f4xx_adc.o(i.ADC_SoftwareStartConv))

[Called By]

- >> initADC

BusFault_Handler (Thumb, 2 bytes, Stack size 0 bytes, stm32f4xx_it.o(i.BusFault_Handler))

[Calls]

- >> BusFault_Handler

[Called By]

- >> BusFault_Handler

[Address Reference Count : 1]

- startup_stm32f446xx.o(RESET)

DMA_Cmd (Thumb, 20 bytes, Stack size 0 bytes, stm32f4xx_dma.o(i.DMA_Cmd))

[Called By]

- >> initADC

DMA_GetFlagStatus (Thumb, 40 bytes, Stack size 0 bytes, stm32f4xx_dma.o(i.DMA_GetFlagStatus))

[Called By]

- >> analogRead

DMA_Init (Thumb, 80 bytes, Stack size 12 bytes, stm32f4xx_dma.o(i.DMA_Init))

[Stack]

- Max Depth = 12
- Call Chain = DMA_Init

[Called By]

- >> initADC

DebugMon_Handler (Thumb, 2 bytes, Stack size 0 bytes, stm32f4xx_it.o(i.DebugMon_Handler))
[Address Reference Count : 1]

- startup_stm32f446xx.o(RESET)

GPIO_Init (Thumb, 162 bytes, Stack size 20 bytes, stm32f4xx_gpio.o(i.GPIO_Init))

[Stack]

- Max Depth = 20
- Call Chain = GPIO_Init

[Called By]

- >> initUSART
- >> initIO
- >> addADC

GPIO_PinAFConfig (Thumb, 32 bytes, Stack size 8 bytes, stm32f4xx_gpio.o(i.GPIO_PinAFConfig))

[Stack]

- Max Depth = 8
- Call Chain = GPIO_PinAFConfig

[Called By]

- >> initUSART

GPIO_ResetBits (Thumb, 4 bytes, Stack size 0 bytes, stm32f4xx_gpio.o(i.GPIO_ResetBits))

[Called By]

- >> digitalWrite

GPIO_SetBits (Thumb, 4 bytes, Stack size 0 bytes, stm32f4xx_gpio.o(i.GPIO_SetBits))

[Called By]

- >> digitalWrite

HardFault_Handler (Thumb, 2 bytes, Stack size 0 bytes, stm32f4xx_it.o(i.HardFault_Handler))

[Calls]

- >> HardFault_Handler

[Called By]

- >> HardFault_Handler

[Address Reference Count : 1]

- startup_stm32f446xx.o(RESET)

MemManage_Handler (Thumb, 2 bytes, Stack size 0 bytes, stm32f4xx_it.o(i.MemManage_Handler))

[Calls]

- >> MemManage_Handler

[Called By]

- >> MemManage_Handler

[Address Reference Count : 1]

- startup_stm32f446xx.o(RESET)

NMI_Handler (Thumb, 2 bytes, Stack size 0 bytes, stm32f4xx_it.o(i.NMI_Handler))
[Address Reference Count : 1]

- startup_stm32f446xx.o(RESET)

PendSV_Handler (Thumb, 2 bytes, Stack size 0 bytes, stm32f4xx_it.o(i.PendSV_Handler))
[Address Reference Count : 1]

- startup_stm32f446xx.o(RESET)

Pxx_decoder (Thumb, 354 bytes, Stack size 56 bytes, gpio.o(i.Pxx_decoder))

[Stack]

- Max Depth = 56
- Call Chain = Pxx_decoder

[Calls]

- >> __aeabi_memcpy4

[Called By]

- >> initUSART
- >> initIO
- >> addADC

RCC_AHB1PeriphClockCmd (Thumb, 18 bytes, Stack size 0 bytes, stm32f4xx_rcc.o(i.RCC_AHB1PeriphClockCmd))

[Called By]

- >> initUSART
- >> initIO
- >> initADC
- >> addADC

RCC_APB1PeriphClockCmd (Thumb, 18 bytes, Stack size 0 bytes, stm32f4xx_rcc.o(i.RCC_APB1PeriphClockCmd))

[Called By]

- >> USART_decoder

RCC_APB2PeriphClockCmd (Thumb, 18 bytes, Stack size 0 bytes, stm32f4xx_rcc.o(i.RCC_APB2PeriphClockCmd))

[Called By]

- >> initADC
- >> USART_decoder

RCC_GetClocksFreq (Thumb, 174 bytes, Stack size 16 bytes, stm32f4xx_rcc.o(i.RCC_GetClocksFreq))

[Stack]

- Max Depth = 16
- Call Chain = RCC_GetClocksFreq

[Called By]

- >> USART_Init

SVC_Handler (Thumb, 2 bytes, Stack size 0 bytes, stm32f4xx_it.o(i.SVC_Handler))
[Address Reference Count : 1]

- startup_stm32f446xx.o(RESET)

SysTick_Handler (Thumb, 4 bytes, Stack size 0 bytes, stm32f4xx_it.o(i.SysTick_Handler))
[Address Reference Count : 1]

- startup_stm32f446xx.o(RESET)

SysTick_Increment (Thumb, 10 bytes, Stack size 0 bytes, systime.o(i.SysTick_Increment), UNUSED)

SysTick_Init (Thumb, 40 bytes, Stack size 0 bytes, systime.o(i.SysTick_Init))

[Called By]

- >> SysTime_Init

SysTime_Init (Thumb, 8 bytes, Stack size 0 bytes, initiation.o(i.SysTime_Init))

[Calls]

- >> SysTick_Init

[Called By]

- >> goodLuck

SystemInit (Thumb, 74 bytes, Stack size 8 bytes, system_stm32f4xx.o(i.SystemInit))

[Stack]

- Max Depth = 24
- Call Chain = SystemInit ⇒ SetSysClock

[Calls]

- >> SetSysClock

[Address Reference Count : 1]

- startup_stm32f446xx.o(.text)

TIM3_IRQHandler (Thumb, 52 bytes, Stack size 8 bytes, stm32f4xx_it.o(i.TIM3_IRQHandler))

[Stack]

- Max Depth = 48
- Call Chain = TIM3_IRQHandler ⇒ TIM3_itTask_cc1 ⇒ analogRead

[Calls]

- >> TIM_SetCompare1
- >> TIM_GetITStatus
- >> TIM_GetCapture1
- >> TIM_ClearITPendingBit
- >> TIM3_itTask_cc1

[Address Reference Count : 1]

- startup_stm32f446xx.o(RESET)

TIM3_itTask_cc1 (Thumb, 44 bytes, Stack size 24 bytes, main.o(i.TIM3_itTask_cc1))

[Stack]

- Max Depth = 40
- Call Chain = TIM3_itTask_cc1 ⇒ analogRead

[Calls]

- >> digitalWrite
- >> analogRead

[Called By]

- >> TIM3_IRQHandler

TIM_ClearITPendingBit (Thumb, 6 bytes, Stack size 0 bytes, stm32f4xx_tim.o(i.TIM_ClearITPendingBit))

[Called By]

- >> TIM3_IRQHandler

TIM_GetCapture1 (Thumb, 4 bytes, Stack size 0 bytes, stm32f4xx_tim.o(i.TIM_GetCapture1))

[Called By]

- >> TIM3_IRQHandler

TIM_GetITStatus (Thumb, 24 bytes, Stack size 0 bytes, stm32f4xx_tim.o(i.TIM_GetITStatus))

[Called By]

- >> TIM3_IRQHandler

TIM_SetCompare1 (Thumb, 4 bytes, Stack size 0 bytes, stm32f4xx_tim.o(i.TIM_SetCompare1))

[Called By]

- >> TIM3_IRQHandler

USART_Cmd (Thumb, 20 bytes, Stack size 0 bytes, stm32f4xx_usart.o(i.USART_Cmd))

[Called By]

- >> initUSART

USART_GetFlagStatus (Thumb, 14 bytes, Stack size 0 bytes, stm32f4xx_usart.o(i.USART_GetFlagStatus))

[Called By]

- >> fputc

USART_Init (Thumb, 164 bytes, Stack size 32 bytes, stm32f4xx_usart.o(i.USART_Init))

[Stack]

- Max Depth = 48
- Call Chain = USART_Init ⇒ RCC_GetClocksFreq

[Calls]

- >> RCC_GetClocksFreq

[Called By]

- >> initUSART

USART_SendData (Thumb, 8 bytes, Stack size 0 bytes, stm32f4xx_usart.o(i.USART_SendData))

[Called By]

- >> fputc

USART_decoder (Thumb, 120 bytes, Stack size 32 bytes, usart.o(i.USART_decoder))

[Stack]

- Max Depth = 32
- Call Chain = USART_decoder

[Calls]

- >> RCC_APB1PeriphClockCmd
- >> RCC_APB2PeriphClockCmd

[Called By]

- >> initUSART

UsageFault_Handler (Thumb, 2 bytes, Stack size 0 bytes, stm32f4xx_it.o(i.UsageFault_Handler))

[Calls]

- >> UsageFault_Handler

[Called By]

- >> UsageFault_Handler

[Address Reference Count : 1]

- startup_stm32f446xx.o(RESET)

__0printf$3 (Thumb, 22 bytes, Stack size 24 bytes, printf3.o(i.__0printf$3), UNUSED)

[Calls]

- >> _printf_core

__1printf$3 (Thumb, 0 bytes, Stack size 24 bytes, printf3.o(i.__0printf$3), UNUSED)

__2printf (Thumb, 0 bytes, Stack size 24 bytes, printf3.o(i.__0printf$3))

[Stack]

- Max Depth = 24
- Call Chain = __2printf

[Called By]

- >> goodLuck

__scatterload_copy (Thumb, 14 bytes, Stack size unknown bytes, handlers.o(i.__scatterload_copy), UNUSED)

__scatterload_null (Thumb, 2 bytes, Stack size unknown bytes, handlers.o(i.__scatterload_null), UNUSED)

__scatterload_zeroinit (Thumb, 14 bytes, Stack size unknown bytes, handlers.o(i.__scatterload_zeroinit), UNUSED)

addADC (Thumb, 82 bytes, Stack size 40 bytes, adc.o(i.addADC))

[Stack]

- Max Depth = 96
- Call Chain = addADC ⇒ Pxx_decoder

[Calls]

- >> RCC_AHB1PeriphClockCmd
- >> GPIO_Init
- >> Pxx_decoder

[Called By]

- >> goodLuck

analogRead (Thumb, 32 bytes, Stack size 16 bytes, adc.o(i.analogRead))

[Stack]

- Max Depth = 16
- Call Chain = analogRead

[Calls]

- >> DMA_GetFlagStatus

[Called By]

- >> goodLuck
- >> TIM3_itTask_cc1

delay_us (Thumb, 24 bytes, Stack size 8 bytes, systime.o(i.delay_us))

[Stack]

- Max Depth = 8
- Call Chain = delay_us

[Calls]

- >> micros

[Called By]

- >> goodLuck

digitalWrite (Thumb, 26 bytes, Stack size 0 bytes, gpio.o(i.digitalWrite))

[Calls]

- >> GPIO_SetBits
- >> GPIO_ResetBits

[Called By]

- >> goodLuck
- >> TIM3_itTask_cc1

fputc (Thumb, 30 bytes, Stack size 16 bytes, usart.o(i.fputc))

[Stack]

- Max Depth = 16
- Call Chain = fputc

[Calls]

- >> USART_SendData
- >> USART_GetFlagStatus

[Address Reference Count : 1]

- printf3.o(i.__0printf$3)

goodLuck (Thumb, 132 bytes, Stack size 32 bytes, main.o(i.goodLuck))

[Stack]

- Max Depth = 200
- Call Chain = goodLuck ⇒ initUSART ⇒ Pxx_decoder

[Calls]

- >> printfForUx
- >> initUSART
- >> initIO
- >> initADC
- >> digitalWrite
- >> delay_us
- >> analogRead
- >> addADC
- >> SysTime_Init
- >> __2printf

[Called By]

- >> main

initADC (Thumb, 290 bytes, Stack size 136 bytes, adc.o(i.initADC))

[Stack]

- Max Depth = 152
- Call Chain = initADC ⇒ ADC_RegularChannelConfig

[Calls]

- >> RCC_AHB1PeriphClockCmd
- >> ADC_SoftwareStartConv
- >> ADC_RegularChannelConfig
- >> ADC_Init
- >> ADC_DMARequestAfterLastTransferCmd
- >> ADC_DMACmd
- >> ADC_CommonInit
- >> ADC_Cmd
- >> RCC_APB2PeriphClockCmd
- >> DMA_Init
- >> DMA_Cmd

[Called By]

- >> goodLuck

initIO (Thumb, 162 bytes, Stack size 64 bytes, gpio.o(i.initIO))

[Stack]

- Max Depth = 120
- Call Chain = initIO ⇒ Pxx_decoder

[Calls]

- >> RCC_AHB1PeriphClockCmd
- >> GPIO_Init
- >> Pxx_decoder
- >> __aeabi_memcpy4

[Called By]

- >> goodLuck

initUSART (Thumb, 200 bytes, Stack size 112 bytes, usart.o(i.initUSART))

[Stack]

- Max Depth = 168
- Call Chain = initUSART ⇒ Pxx_decoder

[Calls]

- >> RCC_AHB1PeriphClockCmd
- >> GPIO_PinAFConfig
- >> GPIO_Init
- >> USART_Init
- >> USART_Cmd
- >> Pxx_decoder
- >> __aeabi_memcpy4
- >> USART_decoder

[Called By]

- >> goodLuck

main (Thumb, 4 bytes, Stack size 0 bytes, main.o(i.main))

[Stack]

- Max Depth = 200
- Call Chain = main ⇒ goodLuck ⇒ initUSART ⇒ Pxx_decoder

[Calls]

- >> goodLuck

[Address Reference Count : 1]

- entry9a.o(.ARM.Collect$$$$0000000B)

micros (Thumb, 42 bytes, Stack size 0 bytes, systime.o(i.micros))

[Called By]

- >> delay_us

printfForUx (Thumb, 6 bytes, Stack size 0 bytes, usart.o(i.printfForUx))

[Called By]

- >> goodLuck

### Local Symbols

SetSysClock (Thumb, 190 bytes, Stack size 16 bytes, system_stm32f4xx.o(i.SetSysClock))

[Stack]

- Max Depth = 16
- Call Chain = SetSysClock

[Called By]

- >> SystemInit

_printf_core (Thumb, 436 bytes, Stack size 96 bytes, printf3.o(i._printf_core), UNUSED)

[Calls]

- >> __aeabi_uidivmod

[Called By]

- >> __0printf$3

### Undefined Global Symbols
