zht043/MicroMouse-Team1/Reference materials/STM32_NucleoBoard_Experiment/XXXXXCLICK HEREXXXXX/Code/MDK-ARM/STM32F411xE/STM32F411xE.htm

# Static Call Graph for image STM32F411xE\STM32F411xE.axf

#<CALLGRAPH># ARM Linker, 5060528: Last Updated: Sat Apr 07 21:15:52 2018

### Maximum Stack Usage = 272 bytes + Unknown(Cycles, Untraceable Function Pointers)

### Call chain for Maximum Stack Depth:

main ⇒ USART_Tester ⇒ initUSART ⇒ Pxx_decoder

### Mutually Recursive functions

- ADC_IRQHandler ⇒ ADC_IRQHandler
- BusFault_Handler ⇒ BusFault_Handler
- HardFault_Handler ⇒ HardFault_Handler
- MemManage_Handler ⇒ MemManage_Handler
- UsageFault_Handler ⇒ UsageFault_Handler

### Function Pointers

- ADC_IRQHandler from startup_stm32f411xe.o(.text) referenced from startup_stm32f411xe.o(RESET)
- BusFault_Handler from stm32f4xx_it.o(i.BusFault_Handler) referenced from startup_stm32f411xe.o(RESET)
- DMA1_Stream0_IRQHandler from startup_stm32f411xe.o(.text) referenced from startup_stm32f411xe.o(RESET)
- DMA1_Stream1_IRQHandler from startup_stm32f411xe.o(.text) referenced from startup_stm32f411xe.o(RESET)
- DMA1_Stream2_IRQHandler from startup_stm32f411xe.o(.text) referenced from startup_stm32f411xe.o(RESET)
- DMA1_Stream3_IRQHandler from startup_stm32f411xe.o(.text) referenced from startup_stm32f411xe.o(RESET)
- DMA1_Stream4_IRQHandler from startup_stm32f411xe.o(.text) referenced from startup_stm32f411xe.o(RESET)
- DMA1_Stream5_IRQHandler from startup_stm32f411xe.o(.text) referenced from startup_stm32f411xe.o(RESET)
- DMA1_Stream6_IRQHandler from startup_stm32f411xe.o(.text) referenced from startup_stm32f411xe.o(RESET)
- DMA1_Stream7_IRQHandler from startup_stm32f411xe.o(.text) referenced from startup_stm32f411xe.o(RESET)
- DMA2_Stream0_IRQHandler from startup_stm32f411xe.o(.text) referenced from startup_stm32f411xe.o(RESET)
- DMA2_Stream1_IRQHandler from startup_stm32f411xe.o(.text) referenced from startup_stm32f411xe.o(RESET)
- DMA2_Stream2_IRQHandler from startup_stm32f411xe.o(.text) referenced from startup_stm32f411xe.o(RESET)
- DMA2_Stream3_IRQHandler from startup_stm32f411xe.o(.text) referenced from startup_stm32f411xe.o(RESET)
- DMA2_Stream4_IRQHandler from startup_stm32f411xe.o(.text) referenced from startup_stm32f411xe.o(RESET)
- DMA2_Stream5_IRQHandler from startup_stm32f411xe.o(.text) referenced from startup_stm32f411xe.o(RESET)
- DMA2_Stream6_IRQHandler from startup_stm32f411xe.o(.text) referenced from startup_stm32f411xe.o(RESET)
- DMA2_Stream7_IRQHandler from startup_stm32f411xe.o(.text) referenced from startup_stm32f411xe.o(RESET)
- DebugMon_Handler from stm32f4xx_it.o(i.DebugMon_Handler) referenced from startup_stm32f411xe.o(RESET)
- EXTI0_IRQHandler from startup_stm32f411xe.o(.text) referenced from startup_stm32f411xe.o(RESET)
- EXTI15_10_IRQHandler from startup_stm32f411xe.o(.text) referenced from startup_stm32f411xe.o(RESET)
- EXTI1_IRQHandler from startup_stm32f411xe.o(.text) referenced from startup_stm32f411xe.o(RESET)
- EXTI2_IRQHandler from startup_stm32f411xe.o(.text) referenced from startup_stm32f411xe.o(RESET)
- EXTI3_IRQHandler from startup_stm32f411xe.o(.text) referenced from startup_stm32f411xe.o(RESET)
- EXTI4_IRQHandler from startup_stm32f411xe.o(.text) referenced from startup_stm32f411xe.o(RESET)
- EXTI9_5_IRQHandler from startup_stm32f411xe.o(.text) referenced from startup_stm32f411xe.o(RESET)
- FLASH_IRQHandler from startup_stm32f411xe.o(.text) referenced from startup_stm32f411xe.o(RESET)
- FPU_IRQHandler from startup_stm32f411xe.o(.text) referenced from startup_stm32f411xe.o(RESET)
- HardFault_Handler from stm32f4xx_it.o(i.HardFault_Handler) referenced from startup_stm32f411xe.o(RESET)
- I2C1_ER_IRQHandler from startup_stm32f411xe.o(.text) referenced from startup_stm32f411xe.o(RESET)
- I2C1_EV_IRQHandler from startup_stm32f411xe.o(.text) referenced from startup_stm32f411xe.o(RESET)
- I2C2_ER_IRQHandler from startup_stm32f411xe.o(.text) referenced from startup_stm32f411xe.o(RESET)
- I2C2_EV_IRQHandler from startup_stm32f411xe.o(.text) referenced from startup_stm32f411xe.o(RESET)
- I2C3_ER_IRQHandler from startup_stm32f411xe.o(.text) referenced from startup_stm32f411xe.o(RESET)
- I2C3_EV_IRQHandler from startup_stm32f411xe.o(.text) referenced from startup_stm32f411xe.o(RESET)
- MemManage_Handler from stm32f4xx_it.o(i.MemManage_Handler) referenced from startup_stm32f411xe.o(RESET)
- NMI_Handler from stm32f4xx_it.o(i.NMI_Handler) referenced from startup_stm32f411xe.o(RESET)
- OTG_FS_IRQHandler from startup_stm32f411xe.o(.text) referenced from startup_stm32f411xe.o(RESET)
- OTG_FS_WKUP_IRQHandler from startup_stm32f411xe.o(.text) referenced from startup_stm32f411xe.o(RESET)
- PVD_IRQHandler from startup_stm32f411xe.o(.text) referenced from startup_stm32f411xe.o(RESET)
- PendSV_Handler from stm32f4xx_it.o(i.PendSV_Handler) referenced from startup_stm32f411xe.o(RESET)
- RCC_IRQHandler from startup_stm32f411xe.o(.text) referenced from startup_stm32f411xe.o(RESET)
- RTC_Alarm_IRQHandler from startup_stm32f411xe.o(.text) referenced from startup_stm32f411xe.o(RESET)
- RTC_WKUP_IRQHandler from startup_stm32f411xe.o(.text) referenced from startup_stm32f411xe.o(RESET)
- Reset_Handler from startup_stm32f411xe.o(.text) referenced from startup_stm32f411xe.o(RESET)
- SDIO_IRQHandler from startup_stm32f411xe.o(.text) referenced from startup_stm32f411xe.o(RESET)
- SPI1_IRQHandler from startup_stm32f411xe.o(.text) referenced from startup_stm32f411xe.o(RESET)
- SPI2_IRQHandler from startup_stm32f411xe.o(.text) referenced from startup_stm32f411xe.o(RESET)
- SPI3_IRQHandler from startup_stm32f411xe.o(.text) referenced from startup_stm32f411xe.o(RESET)
- SPI4_IRQHandler from startup_stm32f411xe.o(.text) referenced from startup_stm32f411xe.o(RESET)
- SPI5_IRQHandler from startup_stm32f411xe.o(.text) referenced from startup_stm32f411xe.o(RESET)
- SVC_Handler from stm32f4xx_it.o(i.SVC_Handler) referenced from startup_stm32f411xe.o(RESET)
- SysTick_Handler from stm32f4xx_it.o(i.SysTick_Handler) referenced from startup_stm32f411xe.o(RESET)
- SystemInit from system_stm32f4xx.o(i.SystemInit) referenced from startup_stm32f411xe.o(.text)
- TAMP_STAMP_IRQHandler from startup_stm32f411xe.o(.text) referenced from startup_stm32f411xe.o(RESET)
- TIM1_BRK_TIM9_IRQHandler from startup_stm32f411xe.o(.text) referenced from startup_stm32f411xe.o(RESET)
- TIM1_CC_IRQHandler from startup_stm32f411xe.o(.text) referenced from startup_stm32f411xe.o(RESET)
- TIM1_TRG_COM_TIM11_IRQHandler from startup_stm32f411xe.o(.text) referenced from startup_stm32f411xe.o(RESET)
- TIM1_UP_TIM10_IRQHandler from startup_stm32f411xe.o(.text) referenced from startup_stm32f411xe.o(RESET)
- TIM2_IRQHandler from startup_stm32f411xe.o(.text) referenced from startup_stm32f411xe.o(RESET)
- TIM3_IRQHandler from startup_stm32f411xe.o(.text) referenced from startup_stm32f411xe.o(RESET)
- TIM4_IRQHandler from startup_stm32f411xe.o(.text) referenced from startup_stm32f411xe.o(RESET)
- TIM5_IRQHandler from startup_stm32f411xe.o(.text) referenced from startup_stm32f411xe.o(RESET)
- USART1_IRQHandler from startup_stm32f411xe.o(.text) referenced from startup_stm32f411xe.o(RESET)
- USART2_IRQHandler from startup_stm32f411xe.o(.text) referenced from startup_stm32f411xe.o(RESET)
- USART6_IRQHandler from startup_stm32f411xe.o(.text) referenced from startup_stm32f411xe.o(RESET)
- UsageFault_Handler from stm32f4xx_it.o(i.UsageFault_Handler) referenced from startup_stm32f411xe.o(RESET)
- WWDG_IRQHandler from startup_stm32f411xe.o(.text) referenced from startup_stm32f411xe.o(RESET)
- __main from entry.o(.ARM.Collect$$$$00000000) referenced from startup_stm32f411xe.o(.text)
- fputc from usart.o(i.fputc) referenced from printf3.o(i.__0printf$3)
- main from main.o(i.main) referenced from entry9a.o(.ARM.Collect$$$$0000000B)

### Global Symbols

__main (Thumb, 0 bytes, Stack size unknown bytes, entry.o(.ARM.Collect$$$$00000000))
[Address Reference Count : 1]

- startup_stm32f411xe.o(.text)

_main_stk (Thumb, 0 bytes, Stack size unknown bytes, entry2.o(.ARM.Collect$$$$00000001))

_main_scatterload (Thumb, 0 bytes, Stack size unknown bytes, entry5.o(.ARM.Collect$$$$00000004))

[Calls]

- >> __scatterload

__main_after_scatterload (Thumb, 0 bytes, Stack size unknown bytes, entry5.o(.ARM.Collect$$$$00000004))

[Called By]

- >> __scatterload

_main_clock (Thumb, 0 bytes, Stack size unknown bytes, entry7b.o(.ARM.Collect$$$$00000008))

_main_cpp_init (Thumb, 0 bytes, Stack size unknown bytes, entry8b.o(.ARM.Collect$$$$0000000A))

_main_init (Thumb, 0 bytes, Stack size unknown bytes, entry9a.o(.ARM.Collect$$$$0000000B))

__rt_final_cpp (Thumb, 0 bytes, Stack size unknown bytes, entry10a.o(.ARM.Collect$$$$0000000D))

__rt_final_exit (Thumb, 0 bytes, Stack size unknown bytes, entry11a.o(.ARM.Collect$$$$0000000F))

Reset_Handler (Thumb, 8 bytes, Stack size 0 bytes, startup_stm32f411xe.o(.text))
[Address Reference Count : 1]

- startup_stm32f411xe.o(RESET)

ADC_IRQHandler (Thumb, 0 bytes, Stack size 0 bytes, startup_stm32f411xe.o(.text))

[Calls]

- >> ADC_IRQHandler

[Called By]

- >> ADC_IRQHandler

[Address Reference Count : 1]

- startup_stm32f411xe.o(RESET)

DMA1_Stream0_IRQHandler (Thumb, 0 bytes, Stack size 0 bytes, startup_stm32f411xe.o(.text))
[Address Reference Count : 1]

- startup_stm32f411xe.o(RESET)

DMA1_Stream1_IRQHandler (Thumb, 0 bytes, Stack size 0 bytes, startup_stm32f411xe.o(.text))
[Address Reference Count : 1]

- startup_stm32f411xe.o(RESET)

DMA1_Stream2_IRQHandler (Thumb, 0 bytes, Stack size 0 bytes, startup_stm32f411xe.o(.text))
[Address Reference Count : 1]

- startup_stm32f411xe.o(RESET)

DMA1_Stream3_IRQHandler (Thumb, 0 bytes, Stack size 0 bytes, startup_stm32f411xe.o(.text))
[Address Reference Count : 1]

- startup_stm32f411xe.o(RESET)

DMA1_Stream4_IRQHandler (Thumb, 0 bytes, Stack size 0 bytes, startup_stm32f411xe.o(.text))
[Address Reference Count : 1]

- startup_stm32f411xe.o(RESET)

DMA1_Stream5_IRQHandler (Thumb, 0 bytes, Stack size 0 bytes, startup_stm32f411xe.o(.text))
[Address Reference Count : 1]

- startup_stm32f411xe.o(RESET)

DMA1_Stream6_IRQHandler (Thumb, 0 bytes, Stack size 0 bytes, startup_stm32f411xe.o(.text))
[Address Reference Count : 1]

- startup_stm32f411xe.o(RESET)

DMA1_Stream7_IRQHandler (Thumb, 0 bytes, Stack size 0 bytes, startup_stm32f411xe.o(.text))
[Address Reference Count : 1]

- startup_stm32f411xe.o(RESET)

DMA2_Stream0_IRQHandler (Thumb, 0 bytes, Stack size 0 bytes, startup_stm32f411xe.o(.text))
[Address Reference Count : 1]

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

SDIO_IRQHandler (Thumb, 0 bytes, Stack size 0 bytes, startup_stm32f411xe.o(.text))
[Address Reference Count : 1]

- startup_stm32f411xe.o(RESET)

SPI1_IRQHandler (Thumb, 0 bytes, Stack size 0 bytes, startup_stm32f411xe.o(.text))
[Address Reference Count : 1]

- startup_stm32f411xe.o(RESET)

SPI2_IRQHandler (Thumb, 0 bytes, Stack size 0 bytes, startup_stm32f411xe.o(.text))
[Address Reference Count : 1]

- startup_stm32f411xe.o(RESET)

SPI3_IRQHandler (Thumb, 0 bytes, Stack size 0 bytes, startup_stm32f411xe.o(.text))
[Address Reference Count : 1]

- startup_stm32f411xe.o(RESET)

SPI4_IRQHandler (Thumb, 0 bytes, Stack size 0 bytes, startup_stm32f411xe.o(.text))
[Address Reference Count : 1]

- startup_stm32f411xe.o(RESET)

SPI5_IRQHandler (Thumb, 0 bytes, Stack size 0 bytes, startup_stm32f411xe.o(.text))
[Address Reference Count : 1]

- startup_stm32f411xe.o(RESET)

TAMP_STAMP_IRQHandler (Thumb, 0 bytes, Stack size 0 bytes, startup_stm32f411xe.o(.text))
[Address Reference Count : 1]

- startup_stm32f411xe.o(RESET)

TIM1_BRK_TIM9_IRQHandler (Thumb, 0 bytes, Stack size 0 bytes, startup_stm32f411xe.o(.text))
[Address Reference Count : 1]

- startup_stm32f411xe.o(RESET)

TIM1_CC_IRQHandler (Thumb, 0 bytes, Stack size 0 bytes, startup_stm32f411xe.o(.text))
[Address Reference Count : 1]

- startup_stm32f411xe.o(RESET)

TIM1_TRG_COM_TIM11_IRQHandler (Thumb, 0 bytes, Stack size 0 bytes, startup_stm32f411xe.o(.text))
[Address Reference Count : 1]

- startup_stm32f411xe.o(RESET)

TIM1_UP_TIM10_IRQHandler (Thumb, 0 bytes, Stack size 0 bytes, startup_stm32f411xe.o(.text))
[Address Reference Count : 1]

- startup_stm32f411xe.o(RESET)

TIM2_IRQHandler (Thumb, 0 bytes, Stack size 0 bytes, startup_stm32f411xe.o(.text))
[Address Reference Count : 1]

- startup_stm32f411xe.o(RESET)

TIM3_IRQHandler (Thumb, 0 bytes, Stack size 0 bytes, startup_stm32f411xe.o(.text))
[Address Reference Count : 1]

- startup_stm32f411xe.o(RESET)

TIM4_IRQHandler (Thumb, 0 bytes, Stack size 0 bytes, startup_stm32f411xe.o(.text))
[Address Reference Count : 1]

- startup_stm32f411xe.o(RESET)

TIM5_IRQHandler (Thumb, 0 bytes, Stack size 0 bytes, startup_stm32f411xe.o(.text))
[Address Reference Count : 1]

- startup_stm32f411xe.o(RESET)

USART1_IRQHandler (Thumb, 0 bytes, Stack size 0 bytes, startup_stm32f411xe.o(.text))
[Address Reference Count : 1]

- startup_stm32f411xe.o(RESET)

USART2_IRQHandler (Thumb, 0 bytes, Stack size 0 bytes, startup_stm32f411xe.o(.text))
[Address Reference Count : 1]

- startup_stm32f411xe.o(RESET)

USART6_IRQHandler (Thumb, 0 bytes, Stack size 0 bytes, startup_stm32f411xe.o(.text))
[Address Reference Count : 1]

- startup_stm32f411xe.o(RESET)

WWDG_IRQHandler (Thumb, 0 bytes, Stack size 0 bytes, startup_stm32f411xe.o(.text))
[Address Reference Count : 1]

- startup_stm32f411xe.o(RESET)

__aeabi_memcpy (Thumb, 36 bytes, Stack size 0 bytes, memcpya.o(.text), UNUSED)

__aeabi_memcpy4 (Thumb, 0 bytes, Stack size 0 bytes, memcpya.o(.text))

[Called By]

- >> initUSART
- >> Pxx_decoder

__aeabi_memcpy8 (Thumb, 0 bytes, Stack size 0 bytes, memcpya.o(.text), UNUSED)

__aeabi_uidiv (Thumb, 0 bytes, Stack size 12 bytes, uidiv.o(.text), UNUSED)

__aeabi_uidivmod (Thumb, 44 bytes, Stack size 12 bytes, uidiv.o(.text), UNUSED)

[Called By]

- >> _printf_core

__scatterload (Thumb, 28 bytes, Stack size 0 bytes, init.o(.text))

[Calls]

- >> __main_after_scatterload

[Called By]

- >> _main_scatterload

__scatterload_rt2 (Thumb, 0 bytes, Stack size 0 bytes, init.o(.text), UNUSED)

BusFault_Handler (Thumb, 2 bytes, Stack size 0 bytes, stm32f4xx_it.o(i.BusFault_Handler))

[Calls]

- >> BusFault_Handler

[Called By]

- >> BusFault_Handler

[Address Reference Count : 1]

- startup_stm32f411xe.o(RESET)

DebugMon_Handler (Thumb, 2 bytes, Stack size 0 bytes, stm32f4xx_it.o(i.DebugMon_Handler))
[Address Reference Count : 1]

- startup_stm32f411xe.o(RESET)

GPIO_Init (Thumb, 162 bytes, Stack size 20 bytes, stm32f4xx_gpio.o(i.GPIO_Init))

[Stack]

- Max Depth = 20
- Call Chain = GPIO_Init

[Called By]

- >> initUSART

GPIO_PinAFConfig (Thumb, 32 bytes, Stack size 8 bytes, stm32f4xx_gpio.o(i.GPIO_PinAFConfig))

[Stack]

- Max Depth = 8
- Call Chain = GPIO_PinAFConfig

[Called By]

- >> initUSART

HardFault_Handler (Thumb, 2 bytes, Stack size 0 bytes, stm32f4xx_it.o(i.HardFault_Handler))

[Calls]

- >> HardFault_Handler

[Called By]

- >> HardFault_Handler

[Address Reference Count : 1]

- startup_stm32f411xe.o(RESET)

MemManage_Handler (Thumb, 2 bytes, Stack size 0 bytes, stm32f4xx_it.o(i.MemManage_Handler))

[Calls]

- >> MemManage_Handler

[Called By]

- >> MemManage_Handler

[Address Reference Count : 1]

- startup_stm32f411xe.o(RESET)

NMI_Handler (Thumb, 2 bytes, Stack size 0 bytes, stm32f4xx_it.o(i.NMI_Handler))
[Address Reference Count : 1]

- startup_stm32f411xe.o(RESET)

PendSV_Handler (Thumb, 2 bytes, Stack size 0 bytes, stm32f4xx_it.o(i.PendSV_Handler))
[Address Reference Count : 1]

- startup_stm32f411xe.o(RESET)

Pxx_decoder (Thumb, 354 bytes, Stack size 56 bytes, gpio.o(i.Pxx_decoder))

[Stack]

- Max Depth = 56
- Call Chain = Pxx_decoder

[Calls]

- >> __aeabi_memcpy4

[Called By]

- >> initUSART

RCC_AHB1PeriphClockCmd (Thumb, 18 bytes, Stack size 0 bytes, stm32f4xx_rcc.o(i.RCC_AHB1PeriphClockCmd))

[Called By]

- >> initUSART

RCC_APB2PeriphClockCmd (Thumb, 18 bytes, Stack size 0 bytes, stm32f4xx_rcc.o(i.RCC_APB2PeriphClockCmd))

[Called By]

- >> USART_decoder

RCC_GetClocksFreq (Thumb, 132 bytes, Stack size 16 bytes, stm32f4xx_rcc.o(i.RCC_GetClocksFreq))

[Stack]

- Max Depth = 16
- Call Chain = RCC_GetClocksFreq

[Called By]

- >> USART_Init

SVC_Handler (Thumb, 2 bytes, Stack size 0 bytes, stm32f4xx_it.o(i.SVC_Handler))
[Address Reference Count : 1]

- startup_stm32f411xe.o(RESET)

SysTick_Handler (Thumb, 4 bytes, Stack size 0 bytes, stm32f4xx_it.o(i.SysTick_Handler))
[Address Reference Count : 1]

- startup_stm32f411xe.o(RESET)

SysTick_Increment (Thumb, 10 bytes, Stack size 0 bytes, systime.o(i.SysTick_Increment), UNUSED)

SysTick_Init (Thumb, 40 bytes, Stack size 0 bytes, systime.o(i.SysTick_Init))

[Called By]

- >> SysTime_Init

SysTime_Init (Thumb, 8 bytes, Stack size 0 bytes, initiation.o(i.SysTime_Init))

[Calls]

- >> SysTick_Init

[Called By]

- >> USART_Tester

SystemInit (Thumb, 74 bytes, Stack size 8 bytes, system_stm32f4xx.o(i.SystemInit))

[Stack]

- Max Depth = 8
- Call Chain = SystemInit

[Calls]

- >> SetSysClock

[Address Reference Count : 1]

- startup_stm32f411xe.o(.text)

USART_Cmd (Thumb, 20 bytes, Stack size 0 bytes, stm32f4xx_usart.o(i.USART_Cmd))

[Called By]

- >> initUSART

USART_GetFlagStatus (Thumb, 14 bytes, Stack size 0 bytes, stm32f4xx_usart.o(i.USART_GetFlagStatus))

[Called By]

- >> fputc
- >> fgetc

USART_Init (Thumb, 164 bytes, Stack size 32 bytes, stm32f4xx_usart.o(i.USART_Init))

[Stack]

- Max Depth = 48
- Call Chain = USART_Init ⇒ RCC_GetClocksFreq

[Calls]

- >> RCC_GetClocksFreq

[Called By]

- >> initUSART

USART_ReceiveData (Thumb, 8 bytes, Stack size 0 bytes, stm32f4xx_usart.o(i.USART_ReceiveData))

[Called By]

- >> fgetc

USART_SendData (Thumb, 8 bytes, Stack size 0 bytes, stm32f4xx_usart.o(i.USART_SendData))

[Called By]

- >> fputc

USART_Tester (Thumb, 56 bytes, Stack size 104 bytes, main.o(i.USART_Tester))

[Stack]

- Max Depth = 272
- Call Chain = USART_Tester ⇒ initUSART ⇒ Pxx_decoder

[Calls]

- >> scanfForUx
- >> readLine
- >> printfForUx
- >> initUSART
- >> SysTime_Init
- >> __2printf

[Called By]

- >> main

USART_decoder (Thumb, 34 bytes, Stack size 16 bytes, usart.o(i.USART_decoder))

[Stack]

- Max Depth = 16
- Call Chain = USART_decoder

[Calls]

- >> RCC_APB2PeriphClockCmd

[Called By]

- >> initUSART

UsageFault_Handler (Thumb, 2 bytes, Stack size 0 bytes, stm32f4xx_it.o(i.UsageFault_Handler))

[Calls]

- >> UsageFault_Handler

[Called By]

- >> UsageFault_Handler

[Address Reference Count : 1]

- startup_stm32f411xe.o(RESET)

__0printf$3 (Thumb, 22 bytes, Stack size 24 bytes, printf3.o(i.__0printf$3), UNUSED)

[Calls]

- >> _printf_core

__1printf$3 (Thumb, 0 bytes, Stack size 24 bytes, printf3.o(i.__0printf$3), UNUSED)

__2printf (Thumb, 0 bytes, Stack size 24 bytes, printf3.o(i.__0printf$3))

[Stack]

- Max Depth = 24
- Call Chain = __2printf

[Called By]

- >> USART_Tester

__scatterload_copy (Thumb, 14 bytes, Stack size unknown bytes, handlers.o(i.__scatterload_copy), UNUSED)

__scatterload_null (Thumb, 2 bytes, Stack size unknown bytes, handlers.o(i.__scatterload_null), UNUSED)

__scatterload_zeroinit (Thumb, 14 bytes, Stack size unknown bytes, handlers.o(i.__scatterload_zeroinit), UNUSED)

fgetc (Thumb, 26 bytes, Stack size 8 bytes, usart.o(i.fgetc))

[Stack]

- Max Depth = 8
- Call Chain = fgetc

[Calls]

- >> USART_ReceiveData
- >> USART_GetFlagStatus

[Called By]

- >> getc

fputc (Thumb, 30 bytes, Stack size 16 bytes, usart.o(i.fputc))

[Stack]

- Max Depth = 16
- Call Chain = fputc

[Calls]

- >> USART_SendData
- >> USART_GetFlagStatus

[Address Reference Count : 1]

- printf3.o(i.__0printf$3)

getc (Thumb, 4 bytes, Stack size 0 bytes, getc.o(i.getc))

[Stack]

- Max Depth = 8
- Call Chain = getc ⇒ fgetc

[Calls]

- >> fgetc

[Called By]

- >> readLine

initUSART (Thumb, 200 bytes, Stack size 112 bytes, usart.o(i.initUSART))

[Stack]

- Max Depth = 168
- Call Chain = initUSART ⇒ Pxx_decoder

[Calls]

- >> USART_Init
- >> USART_Cmd
- >> RCC_AHB1PeriphClockCmd
- >> __aeabi_memcpy4
- >> USART_decoder
- >> Pxx_decoder
- >> GPIO_PinAFConfig
- >> GPIO_Init

[Called By]

- >> USART_Tester

main (Thumb, 4 bytes, Stack size 0 bytes, main.o(i.main))

[Stack]

- Max Depth = 272
- Call Chain = main ⇒ USART_Tester ⇒ initUSART ⇒ Pxx_decoder

[Calls]

- >> USART_Tester

[Address Reference Count : 1]

- entry9a.o(.ARM.Collect$$$$0000000B)

printfForUx (Thumb, 6 bytes, Stack size 0 bytes, usart.o(i.printfForUx))

[Called By]

- >> USART_Tester

readLine (Thumb, 38 bytes, Stack size 16 bytes, usart.o(i.readLine))

[Stack]

- Max Depth = 24
- Call Chain = readLine ⇒ getc ⇒ fgetc

[Calls]

- >> getc

[Called By]

- >> USART_Tester

scanfForUx (Thumb, 6 bytes, Stack size 0 bytes, usart.o(i.scanfForUx))

[Called By]

- >> USART_Tester

### Local Symbols

SetSysClock (Thumb, 102 bytes, Stack size 0 bytes, system_stm32f4xx.o(i.SetSysClock))

[Called By]

- >> SystemInit

_printf_core (Thumb, 436 bytes, Stack size 96 bytes, printf3.o(i._printf_core), UNUSED)

[Calls]

- >> __aeabi_uidivmod

[Called By]

- >> __0printf$3

### Undefined Global Symbols
