zht043/MicroMouse-Team1/Reference materials/STM32_NucleoBoard_Experiment/STM32F4xx_AN3988_V1.1.0/STM32F4xx_Clock_Configuration_V1.1.0.xls

F WAit |  |  | M | P | Q | R | N | AHB_Pres | APB_Pres | Audiosampling | mode
0 | ON | 16-bit | 2 | 2 | 4 | 2 | 192 | 1 | 1 | 192 | Expert
1 | OFF | 32-bit | 3 | 4 | 5 | 3 | 193 | 2 | 2 | 96 | Wizard
2 |  |  | 4 | 6 | 6 | 4 | 194 | 4 | 4 | 48
3 |  |  | 5 | 8 | 7 | 5 | 195 | 8 | 8 | 44.1
4 |  |  | 6 |  | 8 | 6 | 196 | 16 | 16 | 32
5 |  |  | 7 |  | 9 | 7 | 197 | 32 |  | 22.05
6 |  |  | 8 |  | 10 |  | 198 | 64 |  | 16
7 |  |  | 9 |  | 11 |  | 199 | 128 |  | 11.025
 |  |  | 10 |  | 12 |  | 200 | 256 |  | 8
 |  |  | 11 |  | 13 |  | 201 | 512
 |  |  | 12 |  | 14 |  | 202
 |  |  | 13 |  | 15 |  | 203
 |  |  | 14 |  |  |  | 204
 |  |  | 15 |  |  |  | 205
 |  |  | 16 |  |  |  | 206
 |  |  | 17 |  |  |  | 207
 |  |  | 18 |  |  |  | 208
 |  |  | 19 |  |  |  | 209
 |  |  | 20 |  |  |  | 210
 |  |  | 21 |  |  |  | 211
 |  |  | 22 |  |  |  | 212
 |  |  | 23 |  |  |  | 213
 |  |  | 24 |  |  |  | 214
 |  |  | 25 |  |  |  | 215
 |  |  | 26 |  |  |  | 216
 |  |  | 27 |  |  |  | 217
 |  |  | 28 |  |  |  | 218
 |  |  | 29 |  |  |  | 219
 |  |  | 30 |  |  |  | 220
 |  |  | 31 |  |  |  | 221
 |  |  | 32 |  |  |  | 222
 |  |  | 33 |  |  |  | 223
 |  |  | 34 |  |  |  | 224
 |  |  | 35 |  |  |  | 225
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
