zht043/MicroMouse-Team1/Electrical Hardware/PCB 2nd version/Down/Down.brd

## EAGLE design Electrical Hardware/PCB 2nd version/Down/Down.brd (2018-05-14)

Schematic: Down.sch, sheet 1

Parts:
C1, C2: 12pF; 0603
CEM1, CEM3, CEM5, CEM7: 4.7µF; 0805
CEM2, CEM4, CEM6, CEM8: 0.1µF; 0805
CLMC_1: 0.1µF; 0805
CLMC_2: 100uF; EIA7343
CPWR_1, CPWR_5: 0.47µF; 0805
CPWR_2, CPWR_6: 22uF or 33uF; 0805
CPWR_3: 0.1uF; 0805
CPWR_4: 0.33µF; 0805
CRMC_1: 0.1µF; 0805
CRMC_2: 100uF; EIA7343
C_BAT: 2.2uF; 0805
C_V1, C_V2, C_V3, C_V4: 0.1uF; 0805
C_VA1: 2.2uF; 0805
C_VA2: 0.1uF; 0805
C_VCAP1, C_VCAP2: 2.2uF; 0805
IREL: JST-PH2
IRELF: JST-PH2
IRER: JST-PH2
IRERF: JST-PH2
IRRL: JST-PH2
IRRLF: JST-PH2
IRRR: JST-PH2
IRRRF: JST-PH2
LED1, LED2, LED3, LED4: BLUE; LED-1206
LEDR1, LEDR2, LEDR3, LEDR4: 1k; 0805
LEFTMOTOR: PINHD-2X3; 2X03
LM: 1X4
P1: JST-PH2
REG1, REG3: LM2940IMP-5.0/NOPB; MP04A
REG2: LM2937IMP-3.3/NOPB; MP04A
RIGHTMOTOR: PINHD-2X3; 2X03
RM: 1X4
RRE1, RRE2, RRE3, RRE4, RRE5, RRE6: 1.8k; 0805
R_EM, R_EM2, R_EM4, R_EM6: 5ohm; 0805
R_EM1, R_EM3, R_EM5, R_EM7: 10k; 0805
R_LMC_1, R_LMC_2: 47K; 0805
R_RMC_1, R_RMC_2: 47k; 0805
R_VMTR_1: 10K; 0805
R_VMTR_2: 20K; 0805
SPI2: 1X4
SWD: 1X5
U$1: STM32F405/415_LQFP64
U$2: OSC
U$3: 1X3
U$4, U$5, U$6, U$7: MCH3474
U$8, U$9: 1X2
U$15, U$17: TC4427(8MSOP)
U$16, U$18: ZXMHC3F381N8

Connections:
3.3V: CPWR_4.1, C_BAT.2, C_V1.2, C_V2.1, C_V3.2, C_V4.2, C_VA1.2, C_VA2.2, REG2.3 (OUT), SWD.5, U$1.VBAT, U$1.VDDA, U$1.VDD_0, U$1.VDD_1, U$1.VDD_2, U$1.VDD_3, U$3.2
5V: CPWR_3.1, CPWR_6.1, LEFTMOTOR.4, REG2.1 (IN), REG3.3 (VOUT), RIGHTMOTOR.4
A5V: CEM1.2, CEM2.1, CEM3.2, CEM4.1, CEM5.2, CEM6.1, CEM7.2, CEM8.1, CPWR_2.1, IREL.2, IRELF.2, IRER.2, IRERF.2, IRRL.2, IRRR.2, LEDR1.2, LEDR2.2, LEDR3.2, LEDR4.2, REG1.3 (VOUT)
AGND: CEM1.1, CEM2.2, CEM3.1, CEM4.2, CEM5.1, CEM6.2, CEM7.1, CEM8.2, CPWR_1.2, CPWR_2.2, LED1.C, LED2.C, LED3.C, LED4.C, REG1.2 (GND_2), REG1.4 (GND), RRE1.1, RRE2.1, RRE3.1, RRE4.1, RRE5.1, RRE6.1, R_EM1.1, R_EM3.1, R_EM5.1, R_EM7.1, R_VMTR_1.1, U$3.3, U$4.S, U$5.S, U$6.S, U$7.S
EMD_L: IREL.1, R_EM4.2
EMD_LF: IRELF.1, R_EM.2
EMD_R: IRER.1, R_EM6.2
EMD_RF: IRERF.1, R_EM2.2
EM_L: R_EM5.2, U$1.PA8, U$4.G
EM_LF: R_EM1.2, U$1.PA10, U$5.G
EM_R: R_EM7.2, U$1.PA9, U$7.G
EM_RF: R_EM3.2, U$1.PA11, U$6.G
GND: C1.2, C2.2, CPWR_3.2, CPWR_4.2, CPWR_5.2, CPWR_6.2, C_BAT.1, C_V1.1, C_V2.2, C_V3.1, C_V4.1, C_VA1.1, C_VA2.1, C_VCAP1.1, C_VCAP2.2, REG2.2 (GND), REG3.2 (GND_2), REG3.4 (GND), SWD.3, U$1.BOOT0, U$1.PB2, U$1.VSSA, U$1.VSS_0, U$1.VSS_1, U$3.1
L: LEFTMOTOR.1, U$16.N1D/P1D
LENCA: LEFTMOTOR.6, LM.1
LENCB: LEFTMOTOR.5, LM.2
LPWMA: LM.4, R_LMC_1.2, U$15.IN_A
LPWMB: LM.3, R_LMC_2.2, U$15.IN_B
MGND: CLMC_1.1, CLMC_2.C (-), CRMC_1.1, CRMC_2.C (-), LEFTMOTOR.3, P1.2, RIGHTMOTOR.3, R_LMC_1.1, R_LMC_2.1, R_RMC_1.1, R_RMC_2.1, U$15.GND, U$16.N1S/N2S, U$17.GND, U$18.N1S/N2S
unnamed: R_EM.1, U$5.D
unnamed: R_EM2.1, U$6.D
unnamed: R_EM4.1, U$4.D
unnamed: R_EM6.1, U$7.D
unnamed: LED2.A, LEDR1.1
unnamed: LED3.A, LEDR2.1
unnamed: LED4.A, LEDR3.1
unnamed: LED1.A, LEDR4.1
unnamed: LEFTMOTOR.2, U$16.N2D/P2D
unnamed: RIGHTMOTOR.1, U$18.N2D/P2D
OSC_IN: C1.1, U$1.PH0, U$2.P$2 (IN2)
OSC_OUT: C2.1, U$1.PH1, U$2.P$1 (IN1)
OUTA: U$17.OUT_A, U$18.N1G, U$18.P1G
OUTB: U$17.OUT_B, U$18.N2G, U$18.P2G
OUT_A: U$15.OUT_A, U$16.N1G, U$16.P1G
OUT_B: U$15.OUT_B, U$16.N2G, U$16.P2G
R: RIGHTMOTOR.2, U$18.N1D/P1D
RENCA: RIGHTMOTOR.6, RM.3
RENCB: RIGHTMOTOR.5, RM.4
RESET: SWD.1, U$1.NRST
RE_L: IRRL.1, RRE5.2, U$1.PA2
RE_LFA: IRRLF.2, RRE1.2, U$1.PC1
RE_LFB: IRRLF.1, RRE2.2, U$1.PC2
RE_R: IRRR.1, RRE6.2, U$1.PB0
RE_RFA: IRRRF.1, RRE3.2, U$1.PC4
RE_RFB: IRRRF.2, RRE4.2, U$1.PC5
RPWMA: RM.1, R_RMC_1.2, U$17.IN_B
RPWMB: RM.2, R_RMC_2.2, U$17.IN_A
SPI2_MISO: SPI2.3, U$1.PB14
SPI2_MOSI: SPI2.4, U$1.PB15
SPI2_NSS: SPI2.1, U$1.PB12
SPI2_SCK: SPI2.2, U$1.PB13
SWCLK: SWD.4, U$1.PA14
SWDIO: SWD.2, U$1.PA13
TAB1: REG2.4 (TAB)
VBAT: CLMC_1.2, CLMC_2.A (+), CPWR_1.1, CPWR_5.1, CRMC_1.2, CRMC_2.A (+), P1.1, REG1.1 (VIN), REG3.1 (VIN), R_VMTR_2.2, U$15.VDD, U$16.P1S/P2S, U$17.VDD, U$18.P1S/P2S
VCAP_1: C_VCAP1.2, U$1.VCAP_1
VCAP_2: C_VCAP2.1, U$1.VCAP_2
VMTR: R_VMTR_1.2, R_VMTR_2.1, U$1.PB1

Notes on the sheet:
Left Motor Controller
Right Motor Controller
Voltmeter

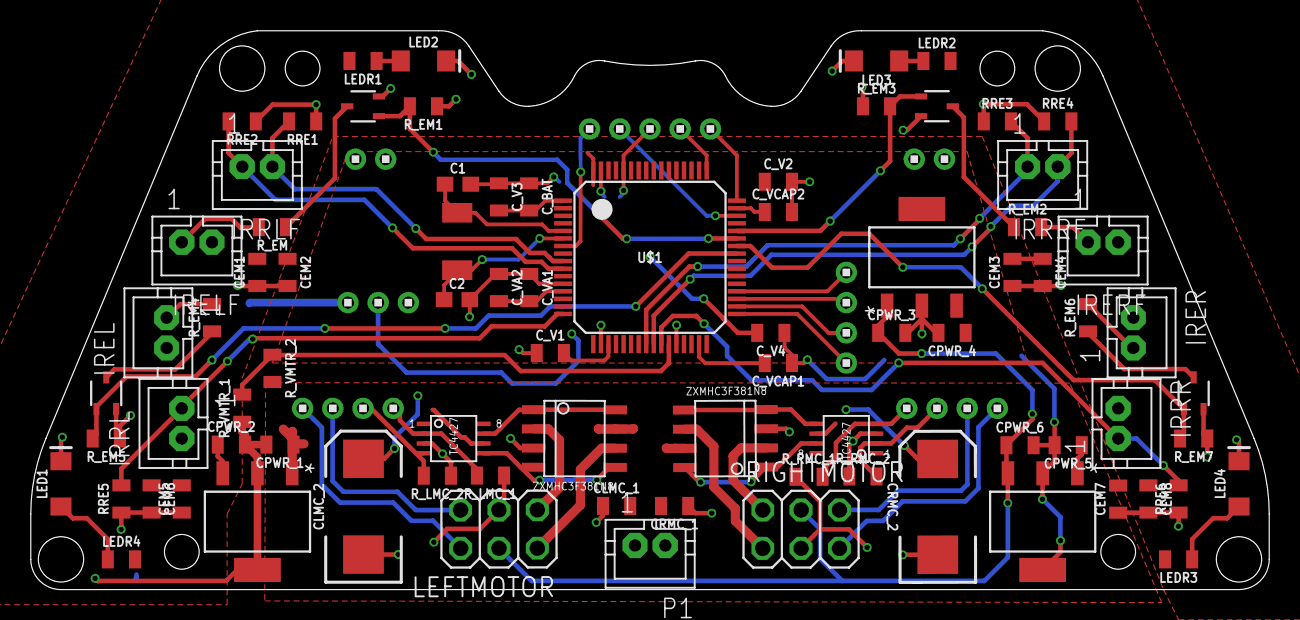
[picture p100: board Down.brd from above]

Board: 2 copper layers, 82.0 x 37.0 mm, 88 parts (0 on the bottom side), 57 nets.
