zht043/MicroMouse-Team1/Electrical Hardware/PCB 3rd version (Final Version)/MCU/MCU.brd

## EAGLE design Electrical Hardware/PCB 3rd version (Final Version)/MCU/MCU.brd (2018-05-14)

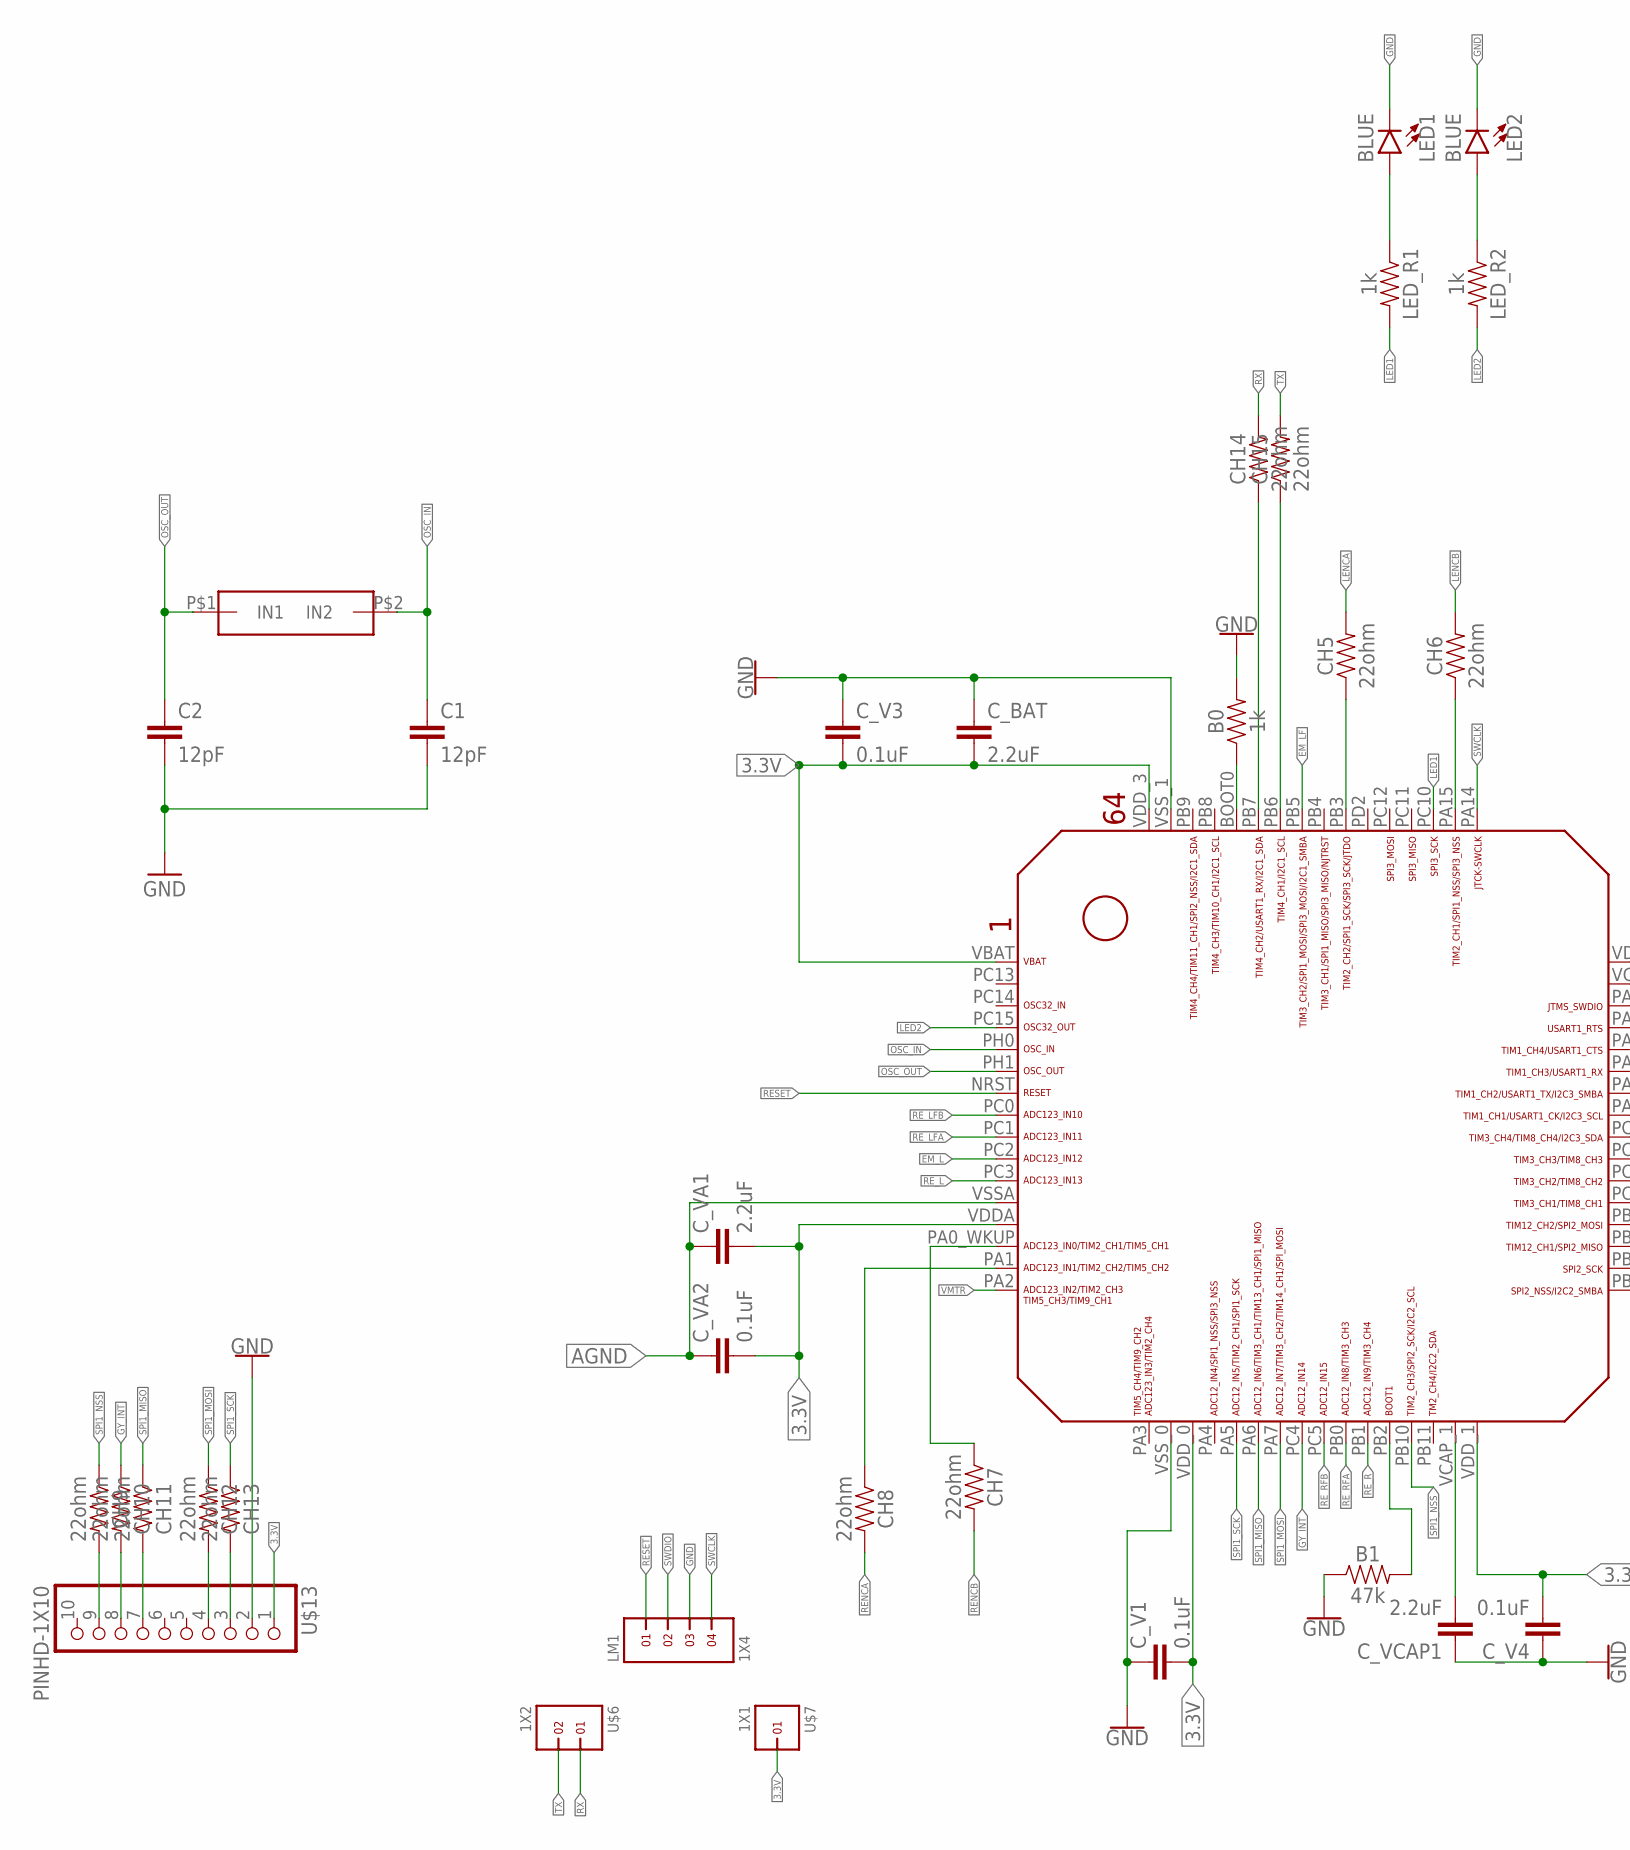
[picture p101: schematic MCU.sch, part in row 1, column 1]

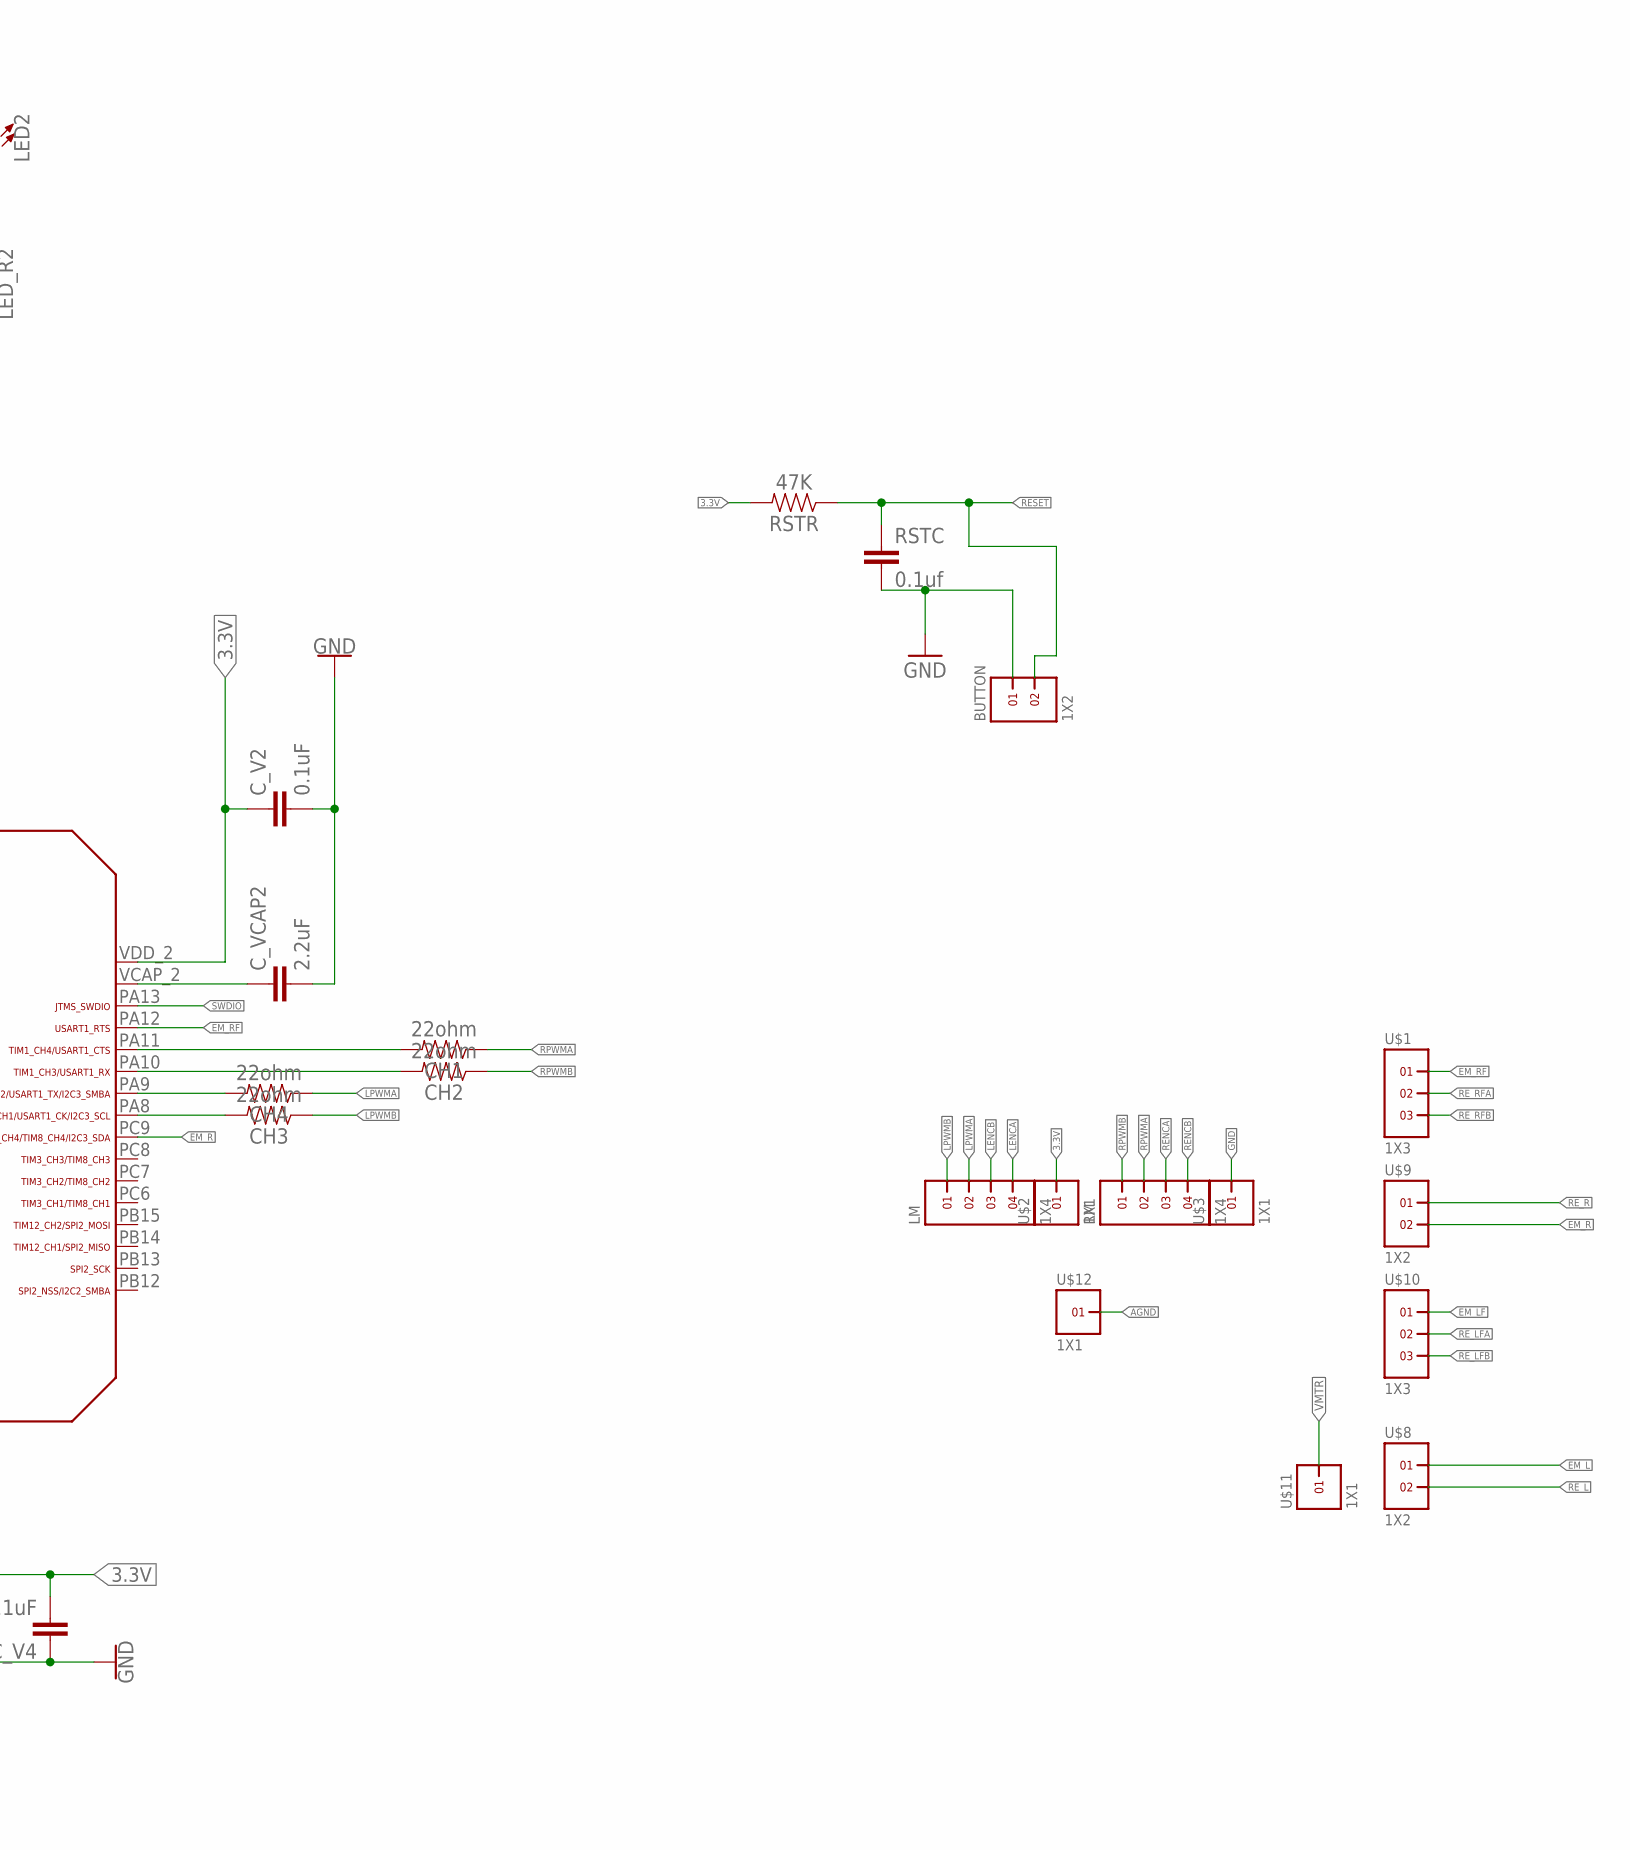
[picture p102: schematic MCU.sch, part in row 1, column 2]

Parts:
B0: 1k; 0805
B1: 47k; 0805
BUTTON: 1X2
C1, C2: 12pF; 0603
CH1, CH2, CH3, CH4, CH5, CH6, CH7, CH8, CH9, CH10, CH11, CH12, CH13, CH14, CH15: 22ohm; 0805
C_BAT: 2.2uF; 0805
C_V1, C_V2, C_V3, C_V4: 0.1uF; 0805
C_VA1: 2.2uF; 0805
C_VA2: 0.1uF; 0805
C_VCAP1, C_VCAP2: 2.2uF; 0805
LED1, LED2: BLUE; LED-1206
LED_R1, LED_R2: 1k; 0805
LM, LM1: 1X4
RM: 1X4
RSTC: 0.1uf; 0805
RSTR: 47K; 0805
U$1, U$10: 1X3
U$2, U$3, U$7, U$11, U$12: 1X1
U$4: STM32F405/415_LQFP64
U$5: OSC
U$6, U$8, U$9: 1X2
U$13: PINHD-1X10; 1X10-BIG

Connections:
3.3V: C_BAT.2, C_V1.2, C_V2.1, C_V3.2, C_V4.2, C_VA1.2, C_VA2.2, RSTR.2, U$2.1, U$4.VBAT, U$4.VDDA, U$4.VDD_0, U$4.VDD_1, U$4.VDD_2, U$4.VDD_3, U$7.1, U$13.1
AGND: C_VA1.1, C_VA2.1, U$4.VSSA, U$12.1
EM_L: U$4.PC2, U$8.1
EM_LF: U$4.PB5, U$10.1
EM_R: U$4.PC9, U$9.2
EM_RF: U$1.1, U$4.PA12
GND: B0.2, B1.1, BUTTON.1, C1.2, C2.2, C_BAT.1, C_V1.1, C_V2.2, C_V3.1, C_V4.1, C_VCAP1.1, C_VCAP2.2, LED1.C, LED2.C, LM1.3, RSTC.2, U$3.1, U$4.VSS_0, U$4.VSS_1, U$13.2
GY_INT: CH10.1, U$4.PC4
INT: CH10.2, U$13.8
LED1: LED_R1.2, U$4.PC10
LED2: LED_R2.2, U$4.PC15
LENCA: CH5.2, LM.4
LENCB: CH6.2, LM.3
LPWMA: CH4.1, LM.2
LPWMB: CH3.1, LM.1
MISO: CH11.2, U$13.7
MOSI: CH12.2, U$13.4
unnamed: CH3.2, U$4.PA8
unnamed: CH4.2, U$4.PA9
unnamed: CH1.2, U$4.PA11
unnamed: CH2.2, U$4.PA10
unnamed: CH6.1, U$4.PA15
unnamed: CH5.1, U$4.PB3
unnamed: CH7.1, U$4.PA0_WKUP (PA0_AKUP)
unnamed: CH8.1, U$4.PA1
unnamed: B1.2, U$4.PB2
unnamed: B0.1, U$4.BOOT0
unnamed: CH14.1, U$4.PB7
unnamed: CH15.1, U$4.PB6
unnamed: LED2.A, LED_R2.1
unnamed: LED1.A, LED_R1.1
NSS: CH9.2, U$13.9
OSC_IN: C1.1, U$4.PH0, U$5.P$2 (IN2)
OSC_OUT: C2.1, U$4.PH1, U$5.P$1 (IN1)
RENCA: CH8.2, RM.3
RENCB: CH7.2, RM.4
RESET: BUTTON.2, LM1.1, RSTC.1, RSTR.1, U$4.NRST
RE_L: U$4.PC3, U$8.2
RE_LFA: U$4.PC1, U$10.2
RE_LFB: U$4.PC0, U$10.3
RE_R: U$4.PB1, U$9.1
RE_RFA: U$1.2, U$4.PB0
RE_RFB: U$1.3, U$4.PC5
RPWMA: CH1.1, RM.2
RPWMB: CH2.1, RM.1
RX: CH14.2, U$6.1
SCK: CH13.2, U$13.3
SPI1_MISO: CH11.1, U$4.PA6
SPI1_MOSI: CH12.1, U$4.PA7
SPI1_NSS: CH9.1, U$4.PB10
SPI1_SCK: CH13.1, U$4.PA5
SWCLK: LM1.4, U$4.PA14
SWDIO: LM1.2, U$4.PA13
TX: CH15.2, U$6.2
VCAP_1: C_VCAP1.2, U$4.VCAP_1
VCAP_2: C_VCAP2.1, U$4.VCAP_2
VMTR: U$4.PA2, U$11.1

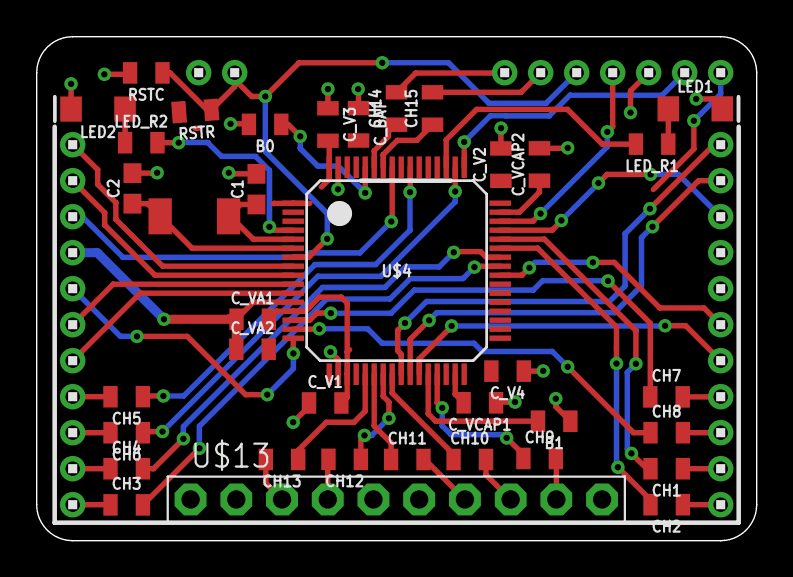
[picture p103: board MCU.brd from above]

Board: 2 copper layers, 40.0 x 28.0 mm, 51 parts (0 on the bottom side), 57 nets.
