zht043/MicroMouse-Team1/Electrical Hardware/PCB 2nd version/Up/Up.brd

## EAGLE design Electrical Hardware/PCB 2nd version/Up/Up.brd (2018-04-22)

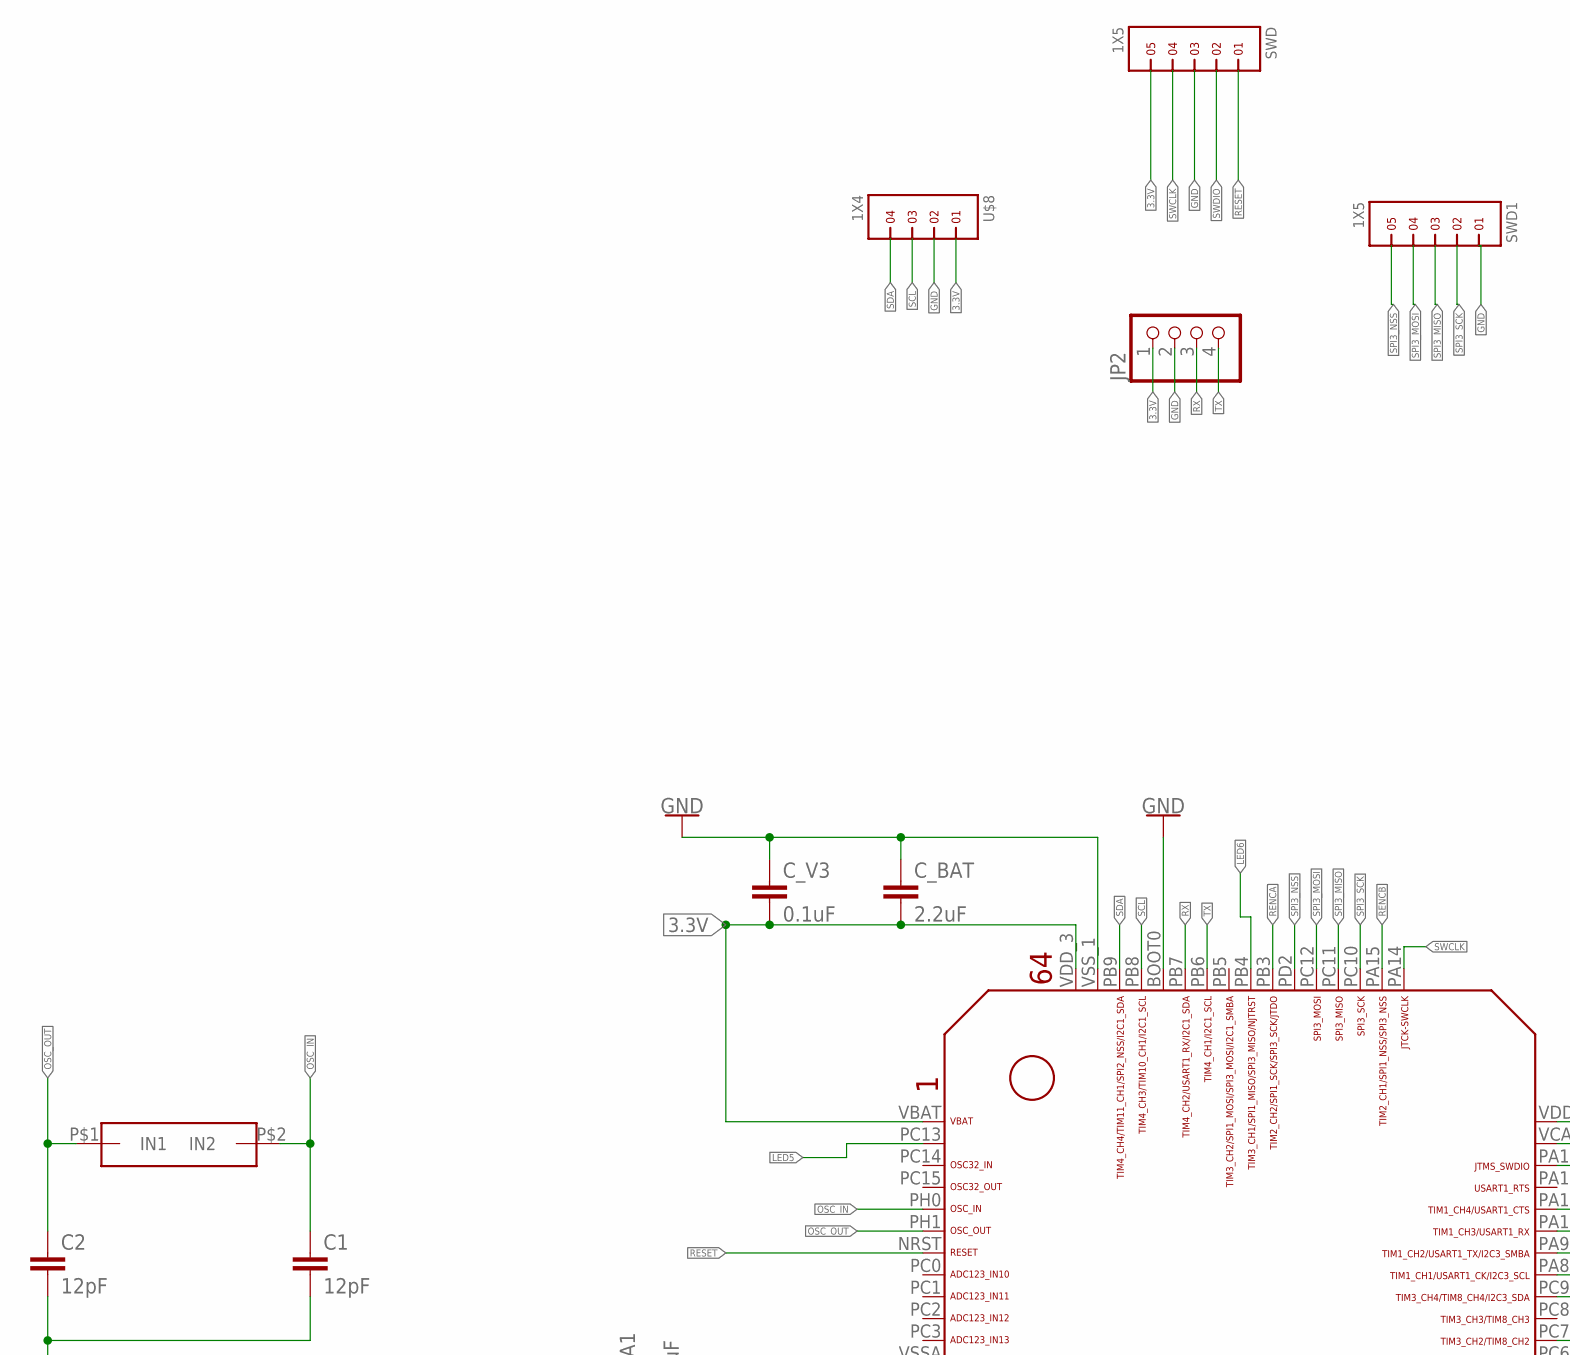
[picture p104: schematic Up.sch, part in row 1, column 1]

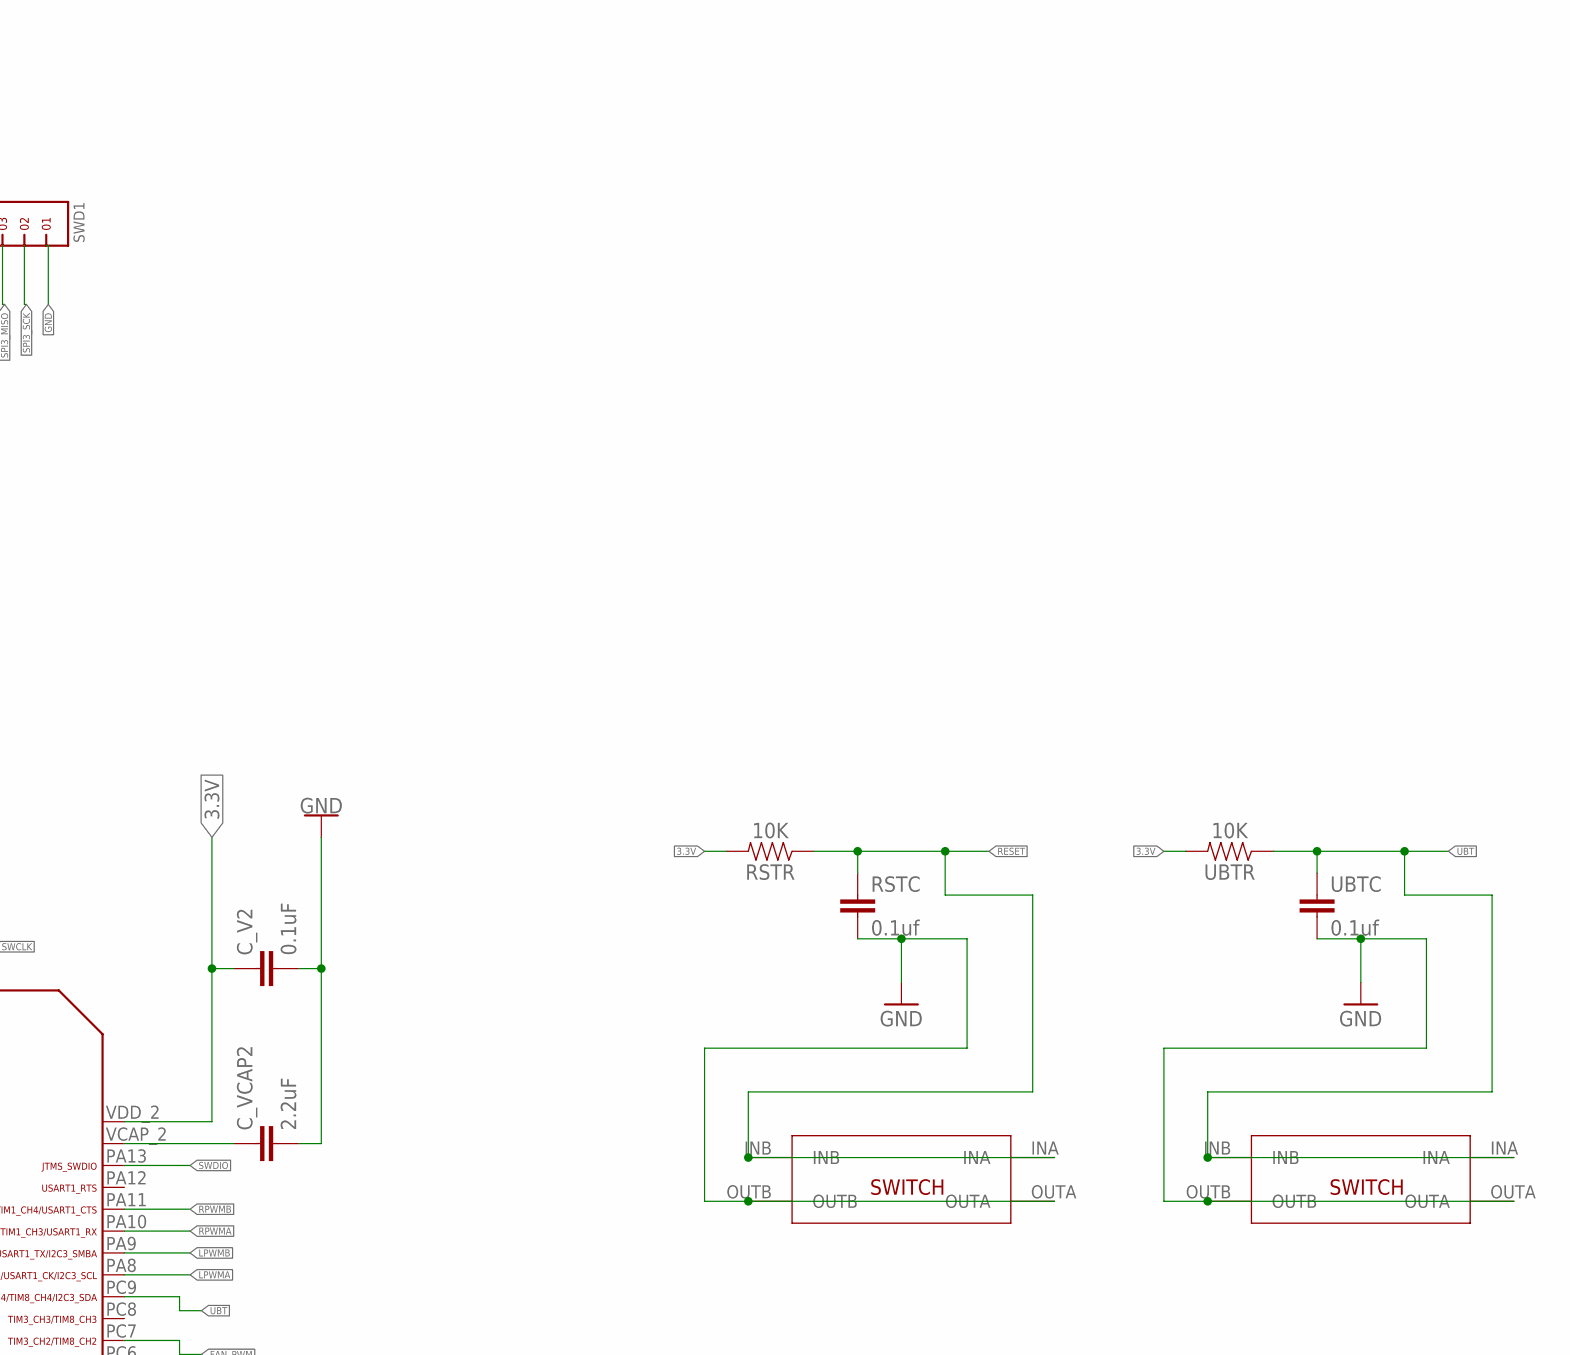
[picture p105: schematic Up.sch, part in row 1, column 2]

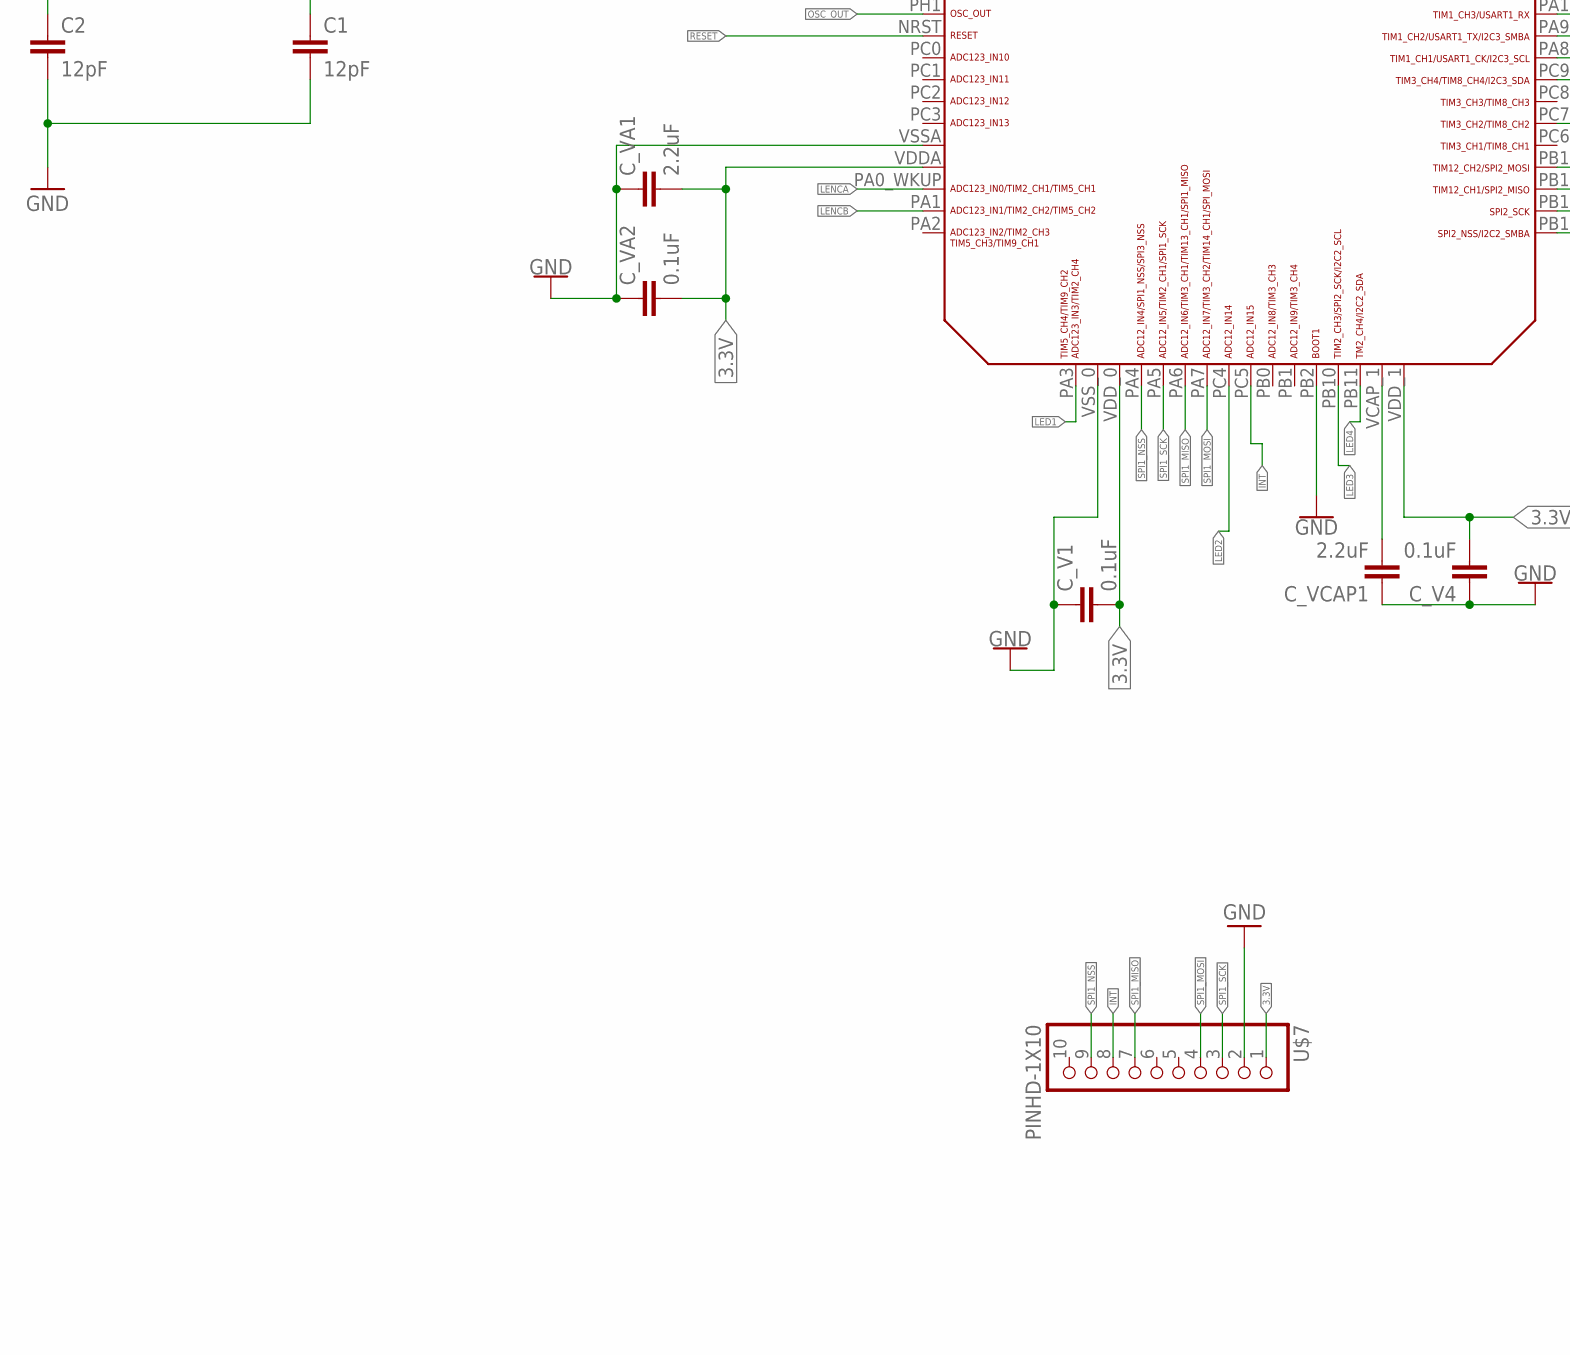
[picture p106: schematic Up.sch, part in row 2, column 1]

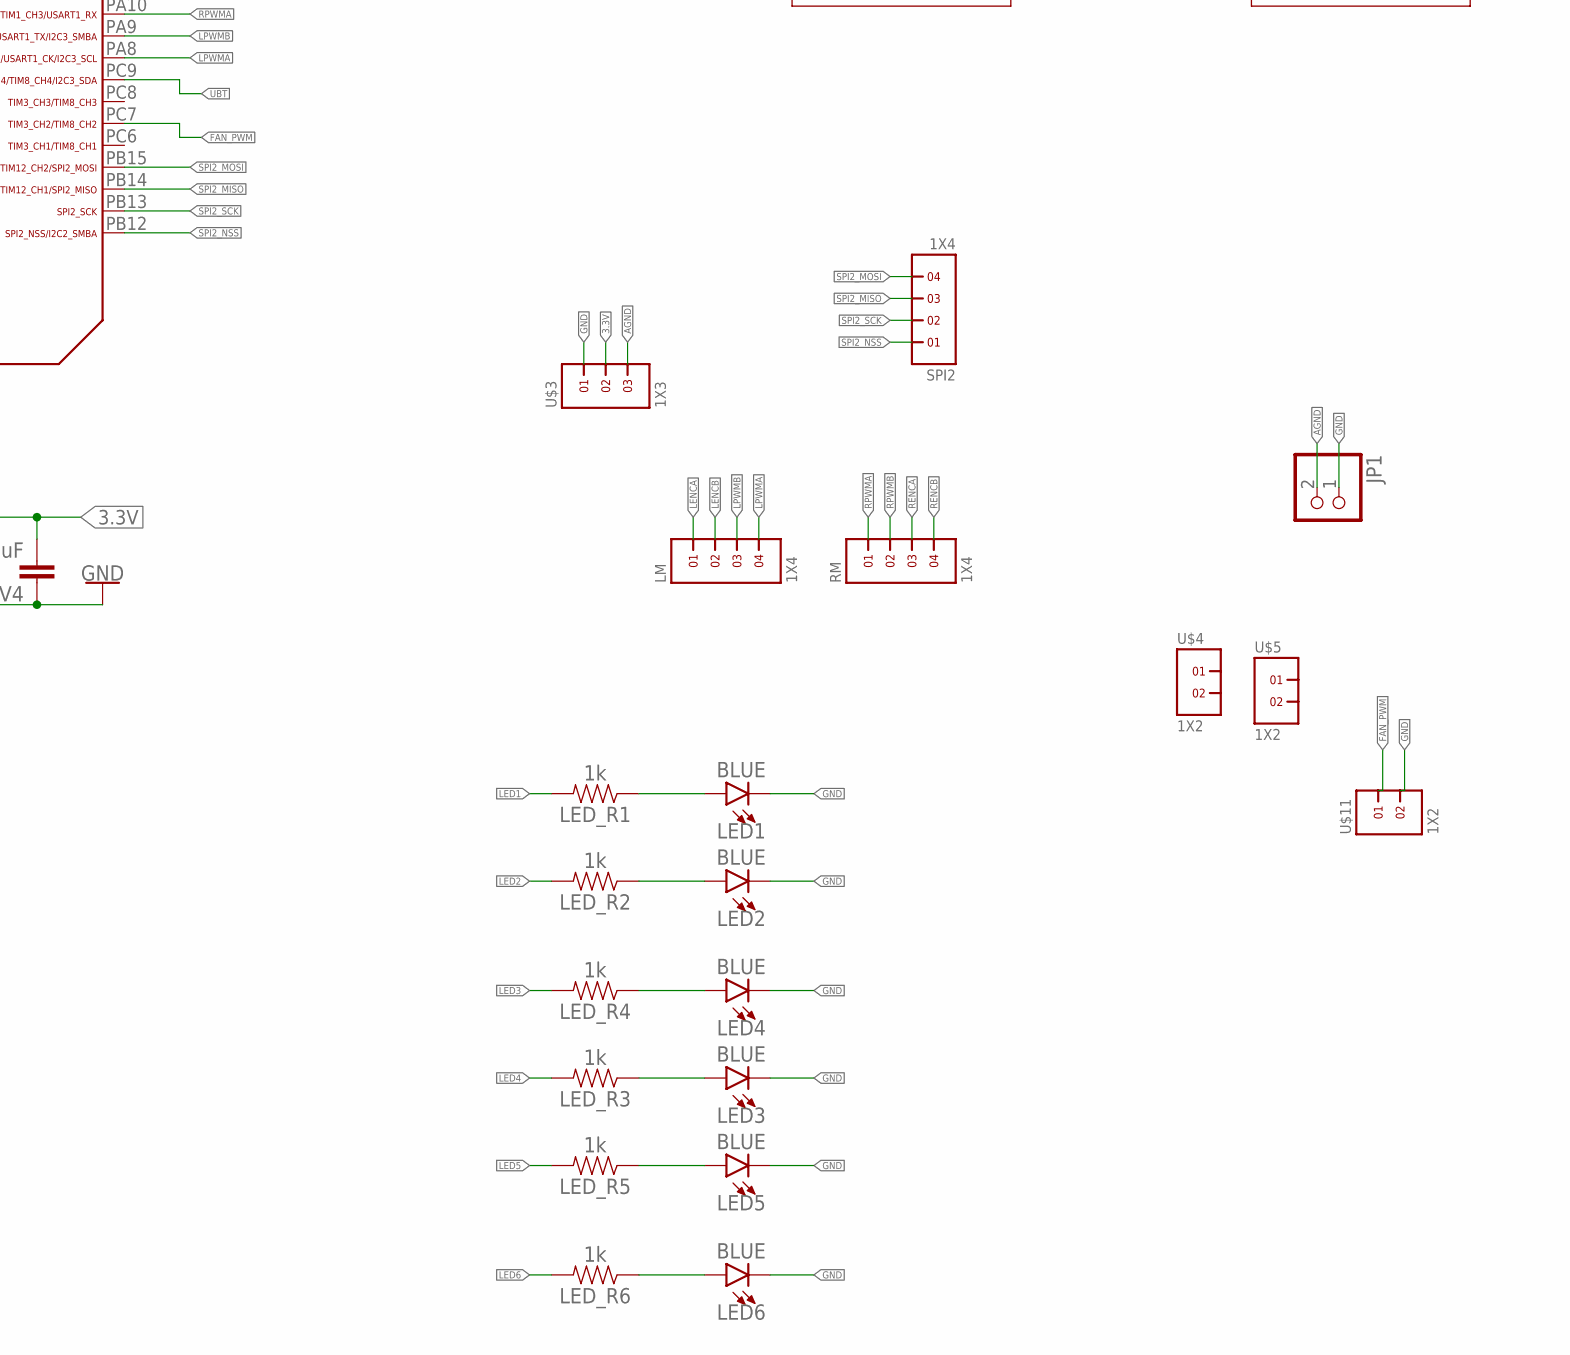
[picture p107: schematic Up.sch, part in row 2, column 2]

Parts:
C1, C2: 12pF; 0603
CX5032GA*8MHZ*CYSTAL: OSC
C_BAT: 2.2uF; 0805
C_V1, C_V2, C_V3, C_V4: 0.1uF; 0805
C_VA1: 2.2uF; 0805
C_VA2: 0.1uF; 0805
C_VCAP1, C_VCAP2: 2.2uF; 0805
JP1: PINHD-1X2; 1X02
JP2: PINHD-1X4; 1X04
LED1, LED2, LED3, LED4, LED5, LED6: BLUE; LED-1206
LED_R1, LED_R2, LED_R3, LED_R4, LED_R5, LED_R6: 1k; 0805
LM: 1X4
RM: 1X4
RSTC: 0.1uf; 0805
RSTR: 10K; 0805
SPI2: 1X4
SWD, SWD1: 1X5
U$1: STM32F405/415_LQFP64
U$3: 1X3
U$4, U$5, U$11: 1X2
U$7: PINHD-1X10; 1X10-BIG
U$8: 1X4
U$9, U$10: 4X4X1.5_SMD_SWITCH
UBTC: 0.1uf; 0805
UBTR: 10K; 0805

Connections:
3.3V: C_BAT.2, C_V1.2, C_V2.1, C_V3.2, C_V4.2, C_VA1.2, C_VA2.2, JP2.1, RSTR.2, SWD.5, U$1.VBAT, U$1.VDDA, U$1.VDD_0, U$1.VDD_1, U$1.VDD_2, U$1.VDD_3, U$3.2, U$7.1, U$8.1, UBTR.2
AGND: JP1.2, U$3.3
FAN_PWM: U$1.PC7, U$11.1
GND: C1.2, C2.2, C_BAT.1, C_V1.1, C_V2.2, C_V3.1, C_V4.1, C_VA1.1, C_VA2.1, C_VCAP1.1, C_VCAP2.2, JP1.1, JP2.2, LED1.C, LED2.C, LED3.C, LED4.C, LED5.C, LED6.C, RSTC.2, SWD.3, SWD1.1, U$1.BOOT0, U$1.PB2, U$1.VSSA, U$1.VSS_0, U$1.VSS_1, U$3.1, U$7.2, U$8.2, U$9.OUTA, U$9.OUTB, U$10.OUTA, U$10.OUTB, U$11.2, UBTC.2
INT: U$1.PC5, U$7.8
LED1: LED_R1.2, U$1.PA3
LED2: LED_R2.2, U$1.PC4
LED3: LED_R4.2, U$1.PB10
LED4: LED_R3.2, U$1.PB11
LED5: LED_R5.2, U$1.PC13
LED6: LED_R6.2, U$1.PB4
LENCA: LM.1, U$1.PA0_WKUP (PA0_AKUP)
LENCB: LM.2, U$1.PA1
LPWMA: LM.4, U$1.PA8
LPWMB: LM.3, U$1.PA9
unnamed: LED3.A, LED_R3.1
unnamed: LED4.A, LED_R4.1
unnamed: LED5.A, LED_R5.1
unnamed: LED6.A, LED_R6.1
unnamed: LED2.A, LED_R2.1
unnamed: LED1.A, LED_R1.1
OSC_IN: C1.1, CX5032GA*8MHZ*CYSTAL.P$2 (IN2), U$1.PH0; also elsewhere on the board
OSC_OUT: C2.1, CX5032GA*8MHZ*CYSTAL.P$1 (IN1), U$1.PH1; also elsewhere on the board
RENCA: RM.3, U$1.PB3
RENCB: RM.4, U$1.PA15
RESET: RSTC.1, RSTR.1, SWD.1, U$1.NRST, U$9.INA, U$9.INB
RPWMA: RM.1, U$1.PA10
RPWMB: RM.2, U$1.PA11
RX: JP2.3, U$1.PB7
SCL: U$1.PB8, U$8.3
SDA: U$1.PB9, U$8.4
SPI1_MISO: U$1.PA6, U$7.7
SPI1_MOSI: U$1.PA7, U$7.4
SPI1_NSS: U$1.PA4, U$7.9
SPI1_SCK: U$1.PA5, U$7.3
SPI2_MISO: SPI2.3, U$1.PB14
SPI2_MOSI: SPI2.4, U$1.PB15
SPI2_NSS: SPI2.1, U$1.PB12
SPI2_SCK: SPI2.2, U$1.PB13
SPI3_MISO: SWD1.3, U$1.PC11
SPI3_MOSI: SWD1.4, U$1.PC12
SPI3_NSS: SWD1.5, U$1.PD2
SPI3_SCK: SWD1.2, U$1.PC10
SWCLK: SWD.4, U$1.PA14
SWDIO: SWD.2, U$1.PA13
TX: JP2.4, U$1.PB6
UBT: U$1.PC9, U$10.INA, U$10.INB, UBTC.1, UBTR.1
VCAP_1: C_VCAP1.2, U$1.VCAP_1
VCAP_2: C_VCAP2.1, U$1.VCAP_2

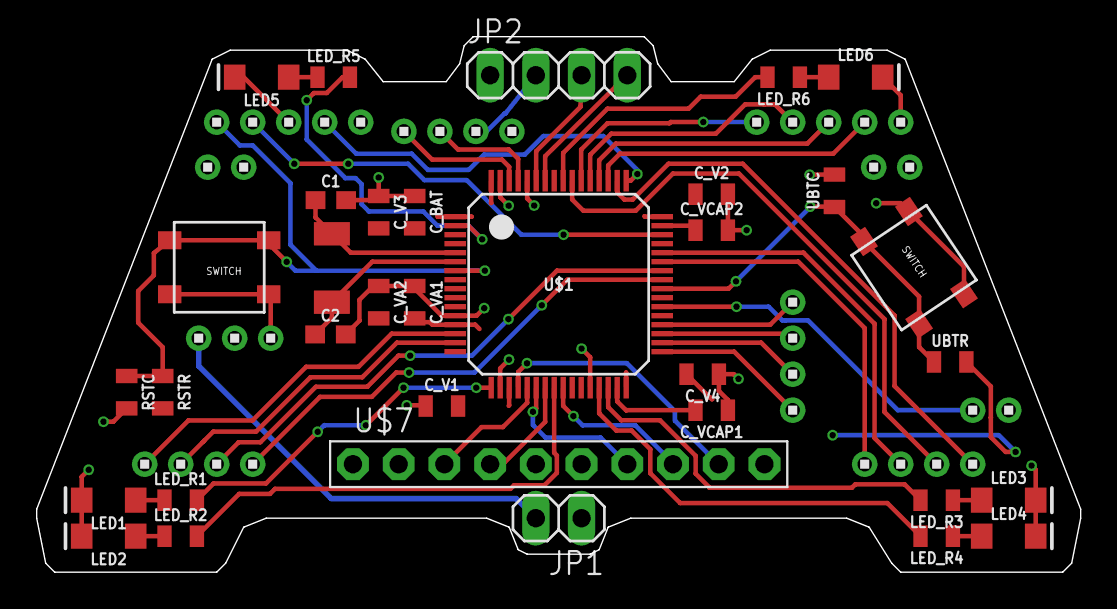
[picture p108: board Up.brd from above]

Board: 2 copper layers, 58.0 x 29.8 mm, 44 parts (0 on the bottom side), 49 nets.

Other parts of the board:
CX5032GA: OSC

Their connections:
OSC_IN: CX5032GA.P$2; also elsewhere on the board
OSC_OUT: CX5032GA.P$1; also elsewhere on the board
