zht043/MicroMouse-Team1/Electrical Hardware/PCB_failed/LEDs and Buttons/LEDs and Buttons.brd

## EAGLE design Electrical Hardware/PCB_failed/LEDs and Buttons/LEDs and Buttons.brd (2018-03-08)

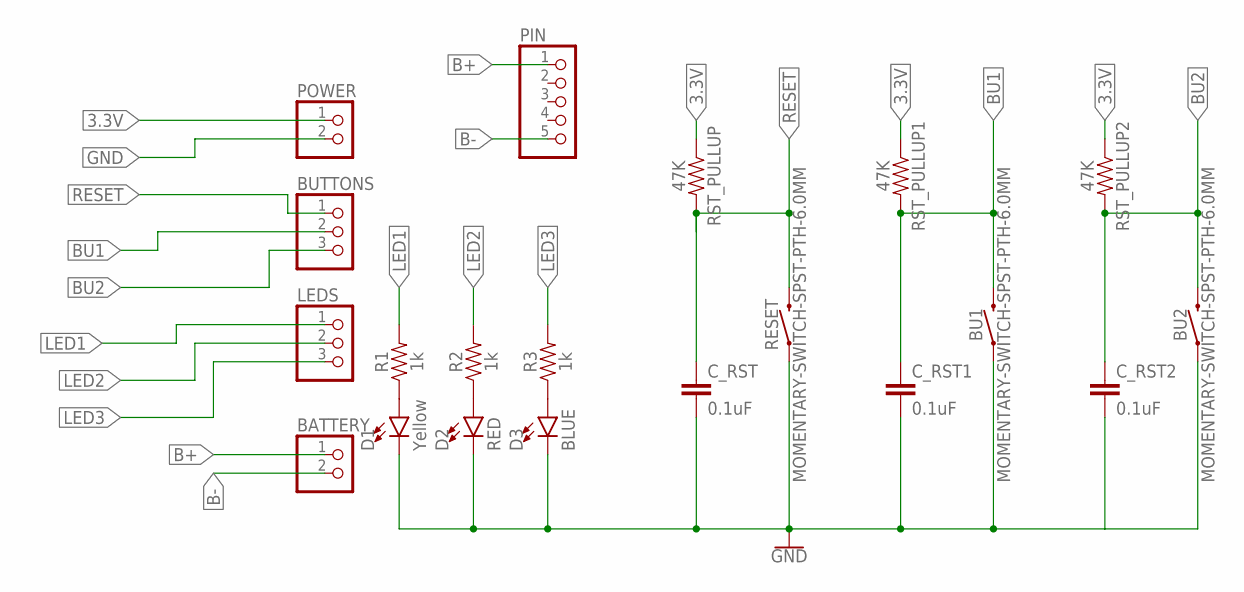
[picture p109: schematic LEDs and Buttons.sch]

Parts:
BATTERY: PINHD-1X2; 1X02
BU1, BU2: MOMENTARY-SWITCH-SPST-PTH-6.0MM; TACTILE_SWITCH_PTH_6.0MM
BUTTONS: PINHD-1X3; 1X03
C_RST, C_RST1, C_RST2: 0.1uF; 0805
D1: Yellow; LED-1206
D2: RED; LED-1206
D3: BLUE; LED-1206
LEDS: PINHD-1X3; 1X03
PIN: PINHD-1X55X2MM; 1_05X2MM
POWER: PINHD-1X2; 1X02
R1, R2, R3: 1k; 0805
RESET: MOMENTARY-SWITCH-SPST-PTH-6.0MM; TACTILE_SWITCH_PTH_6.0MM
RST_PULLUP, RST_PULLUP1, RST_PULLUP2: 47K; 0805

Connections:
3.3V: POWER.1, RST_PULLUP.1, RST_PULLUP1.1, RST_PULLUP2.1
B+: BATTERY.1, PIN.1
B-: BATTERY.2, PIN.5
BU1: BU1.3 (2), BUTTONS.2, C_RST1.1, RST_PULLUP1.2
BU2: BU2.3 (2), BUTTONS.3, C_RST2.1, RST_PULLUP2.2
GND: BU1.1, BU2.1, C_RST.2, C_RST1.2, C_RST2.2, D1.C, D2.C, D3.C, POWER.2, RESET.1
LED1: LEDS.1, R1.2
LED2: LEDS.2, R2.2
LED3: LEDS.3, R3.2
unnamed: D1.A, R1.1
unnamed: D2.A, R2.1
unnamed: D3.A, R3.1
RESET: BUTTONS.1, C_RST.1, RESET.3 (2), RST_PULLUP.2

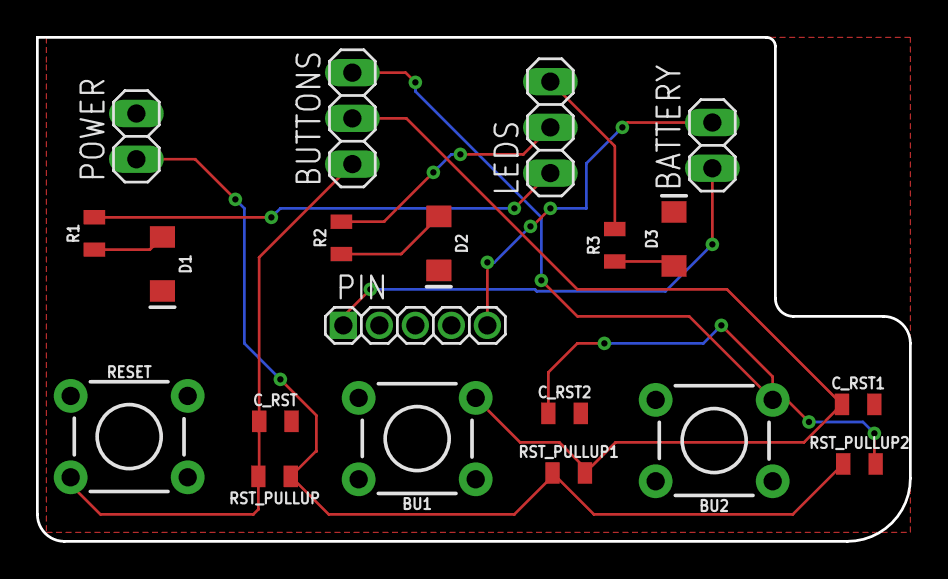
[picture p110: board Electrical Hardware/PCB_failed/LEDs and Buttons/LEDs and Buttons.brd from above]

Board: 2 copper layers, 48.5 x 28.0 mm, 20 parts (0 on the bottom side), 13 nets.
