zht043/MicroMouse-Team1/Electrical Hardware/PCB_failed/PowerSystem/PowerSysPractice.brd

## EAGLE design Electrical Hardware/PCB_failed/PowerSystem/PowerSysPractice.brd (2018-03-08)

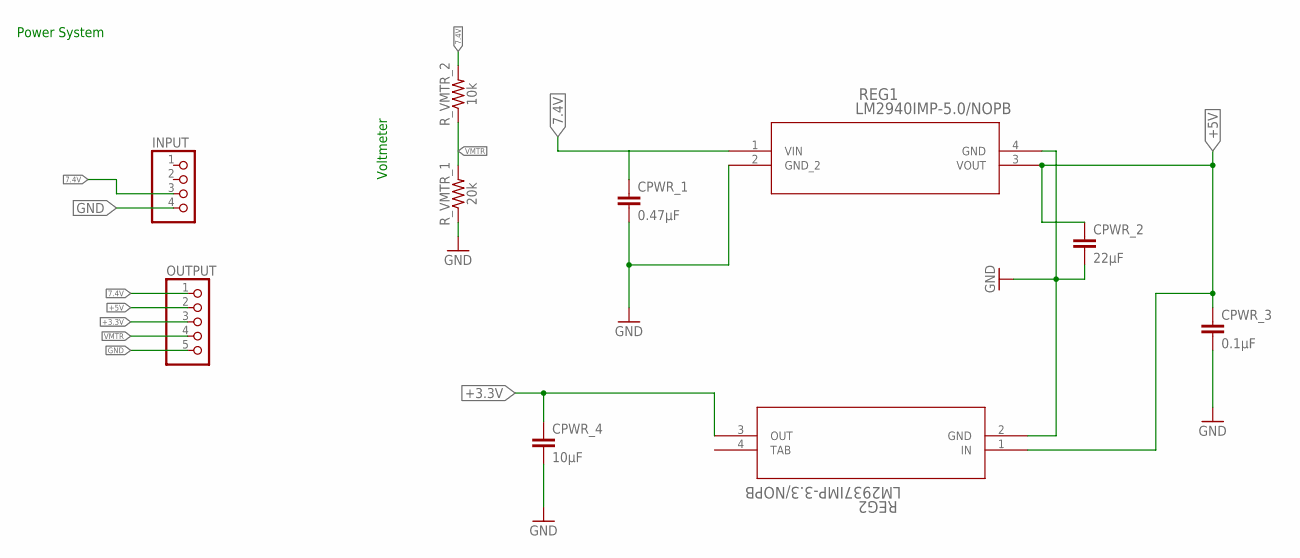
[picture p111: schematic PowerSysPractice.sch]

Parts:
CPWR_1: 0.47µF; 0805
CPWR_2: 22µF; 0805
CPWR_3: 0.1µF; 0805
CPWR_4: 10µF; 0805
INPUT: PINHD-1X4; 1X04
OUTPUT: PINHD-1X5; 1X05
REG1: LM2940IMP-5.0/NOPB; MP04A
REG2: LM2937IMP-3.3/NOPB; MP04A
R_VMTR_1: 20k; 0805
R_VMTR_2: 10k; 0805

Connections:
7.4V: CPWR_1.1, INPUT.3, OUTPUT.1, REG1.1 (VIN), R_VMTR_2.2
+3.3V: CPWR_4.1, OUTPUT.3, REG2.3 (OUT)
+5V: CPWR_2.1, CPWR_3.1, OUTPUT.2, REG1.3 (VOUT), REG2.1 (IN)
GND: CPWR_1.2, CPWR_2.2, CPWR_3.2, CPWR_4.2, INPUT.4, OUTPUT.5, REG1.2 (GND_2), REG1.4 (GND), REG2.2 (GND), R_VMTR_1.1
TAB: REG2.4 (TAB)
VMTR: OUTPUT.4, R_VMTR_1.2, R_VMTR_2.1

Notes on the sheet:
Power System
Voltmeter

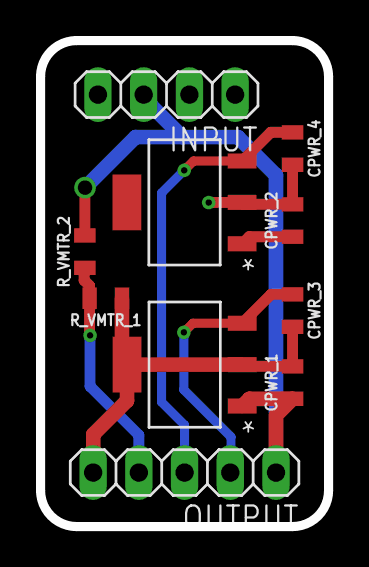
[picture p112: board PowerSysPractice.brd from above]

Board: 2 copper layers, 16.0 x 27.0 mm, 10 parts (0 on the bottom side), 5 nets.
