zht043/MicroMouse-Team1/Electrical Hardware/PCB_1st version/LEDs and Buttons/LEDs and Buttons.brd

## EAGLE design Electrical Hardware/PCB_1st version/LEDs and Buttons/LEDs and Buttons.brd (2018-03-08)

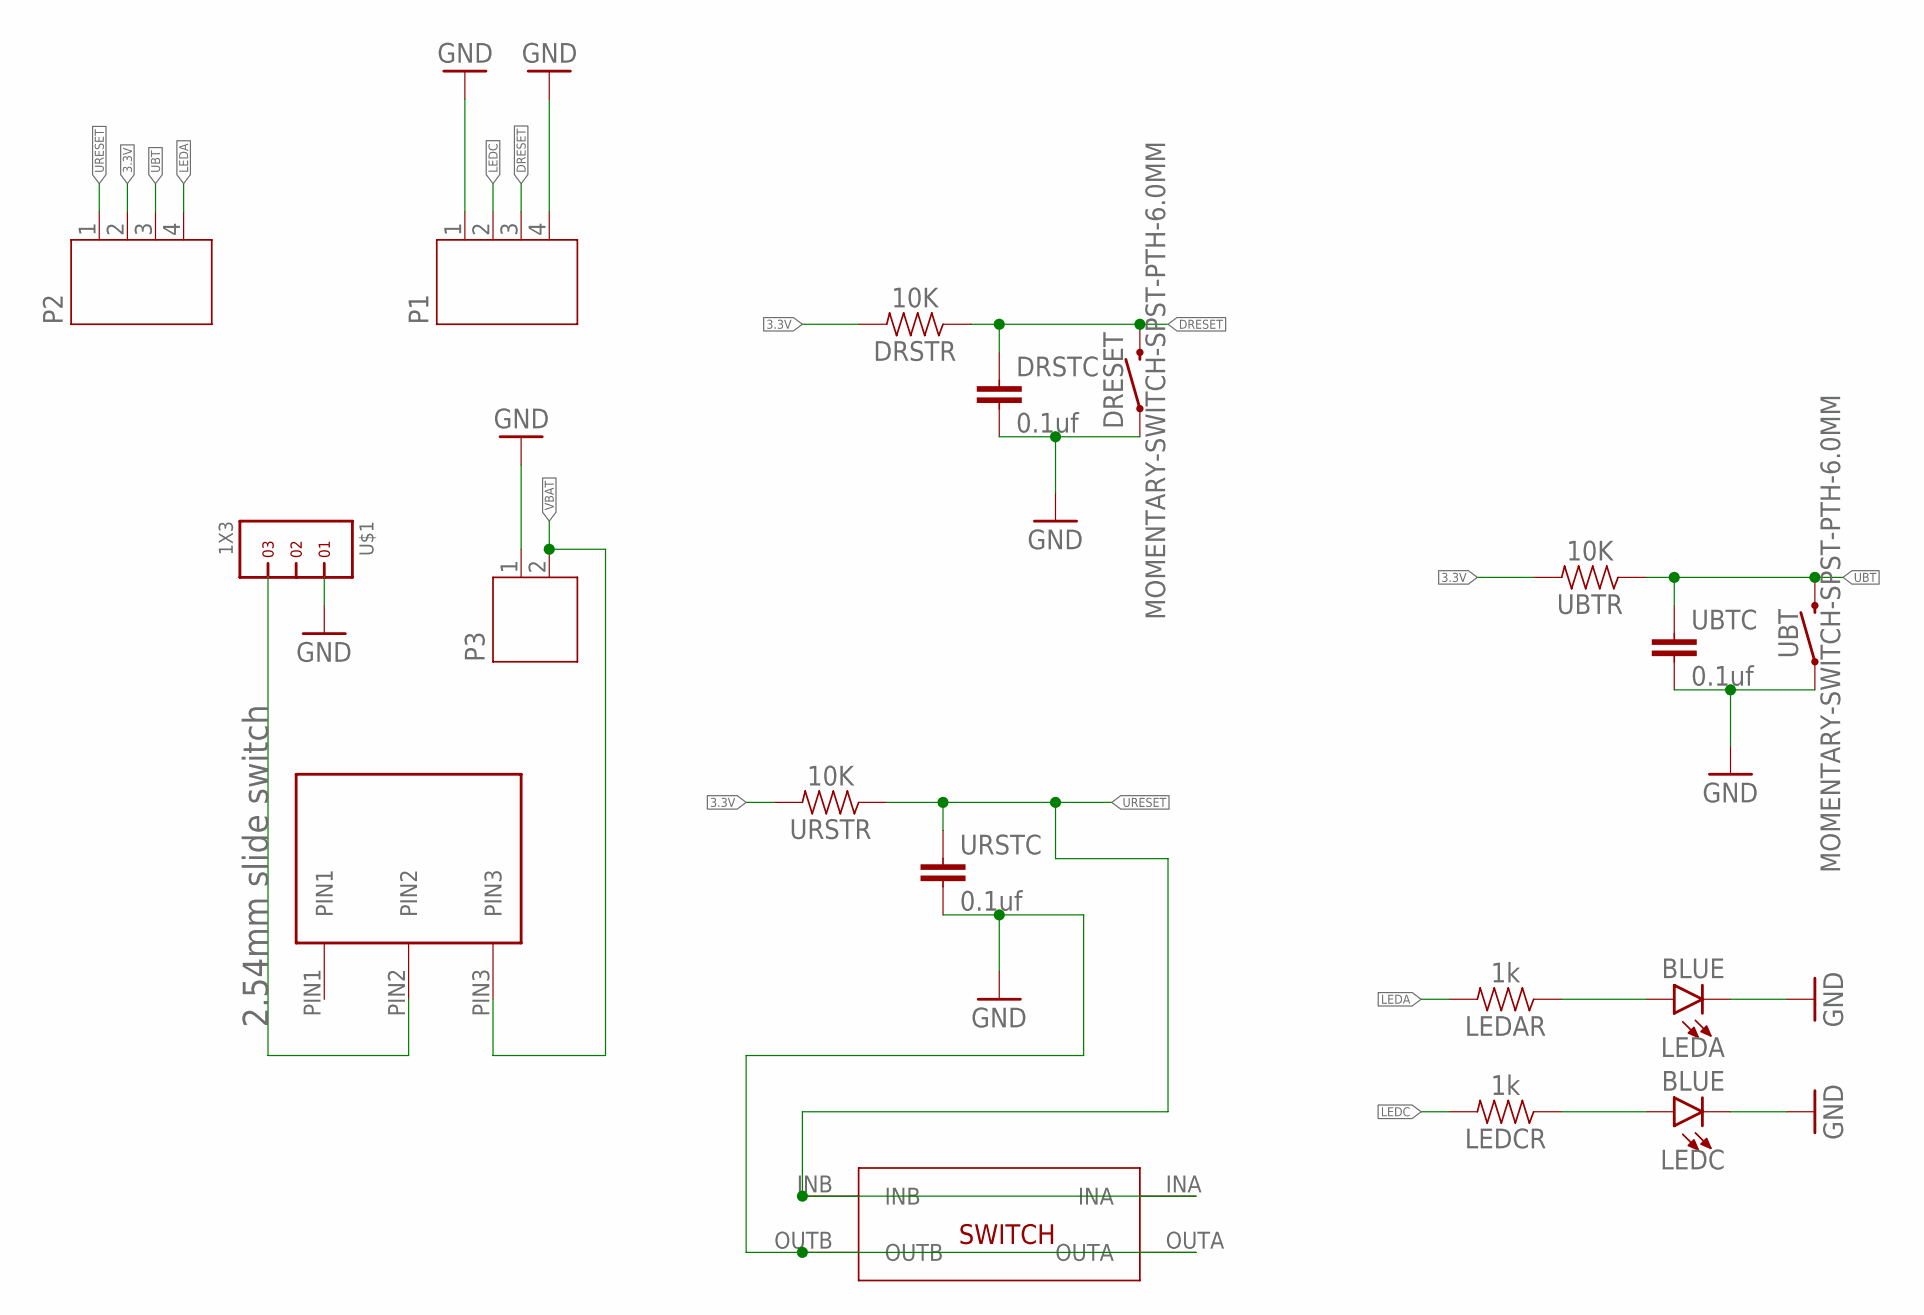
[picture p113: schematic LEDs and Buttons.sch]

Parts:
DRESET: MOMENTARY-SWITCH-SPST-PTH-6.0MM; TACTILE_SWITCH_PTH_6.0MM
DRSTC: 0.1uf; 0805
DRSTR: 10K; 0805
LEDA: BLUE; LED-1206
LEDAR: 1k; 0805
LEDC: BLUE; LED-1206
LEDCR: 1k; 0805
P1, P2: JST-PH4
P3: JST-PH2
U$1: 1X3
U$2: 4X4X1.5_SMD_SWITCH
U$14: TS02_SWITCH
UBT: MOMENTARY-SWITCH-SPST-PTH-6.0MM; TACTILE_SWITCH_PTH_6.0MM
UBTC: 0.1uf; 0805
UBTR: 10K; 0805
URSTC: 0.1uf; 0805
URSTR: 10K; 0805

Connections:
3.3V: DRSTR.2, P2.2, UBTR.2, URSTR.2
DRESET: DRESET.3 (2), DRSTC.1, DRSTR.1, P1.3
GND: DRESET.1, DRSTC.2, LEDA.C, LEDC.C, P1.1, P1.4, P3.1, U$1.1, U$2.OUTA, U$2.OUTB, UBT.1, UBTC.2, URSTC.2
LEDA: LEDAR.2, P2.4
LEDC: LEDCR.2, P1.2
unnamed: LEDC.A, LEDCR.1
unnamed: U$1.3, U$14.PIN2
unnamed: LEDA.A, LEDAR.1
UBT: P2.3, UBT.3 (2), UBTC.1, UBTR.1
URESET: P2.1, U$2.INA, U$2.INB, URSTC.1, URSTR.1
VBAT: P3.2, U$14.PIN3

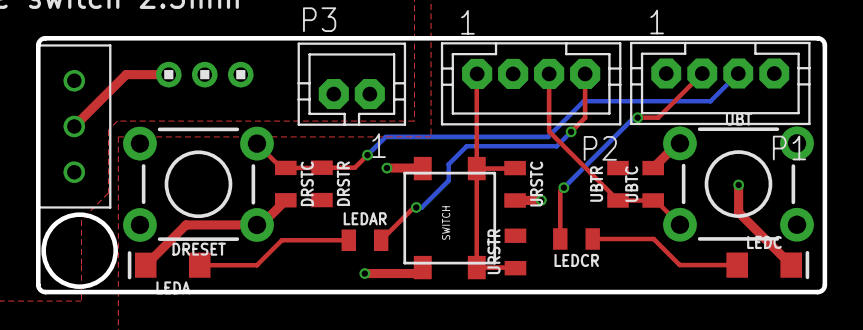
[picture p114: board Electrical Hardware/PCB_1st version/LEDs and Buttons/LEDs and Buttons… from above]

Board: 2 copper layers, 43.7 x 14.1 mm, 18 parts (0 on the bottom side), 11 nets.
