zht043/MicroMouse-Team1/Electrical Hardware/PCB_1st version/IR 1E2R/IR 1E2R.brd

## EAGLE design Electrical Hardware/PCB_1st version/IR 1E2R/IR 1E2R.brd (2018-03-08)

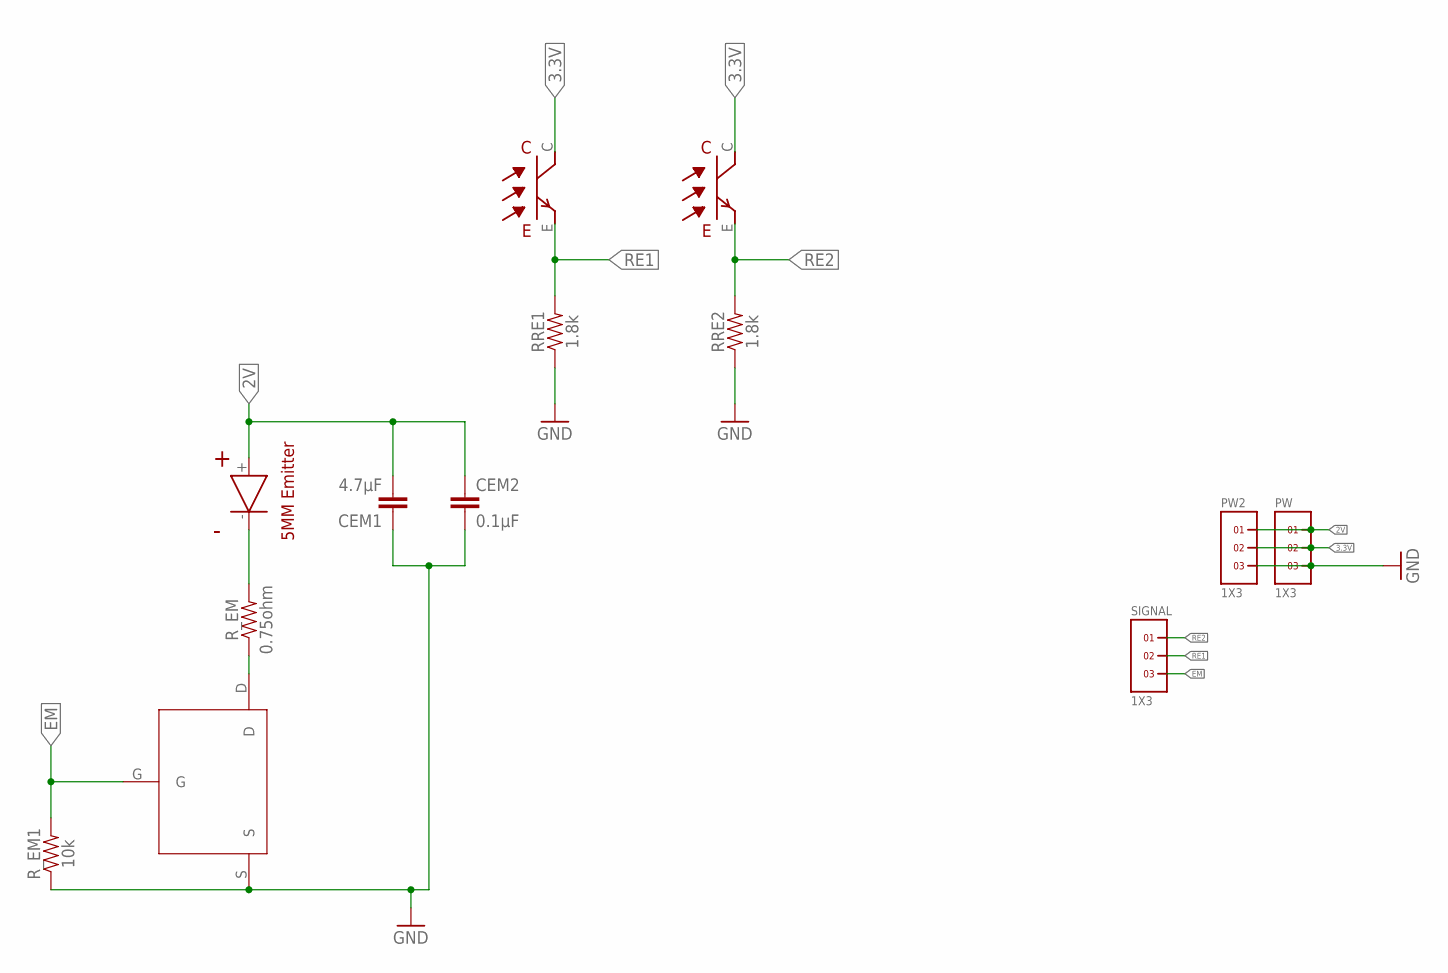
[picture p115: schematic IR 1E2R.sch]

Parts:
CEM1: 4.7µF; 0805
CEM2: 0.1µF; 0805
PW, PW2: 1X3
RECEIVER1, RECEIVER2: RECEIVER
RRE1, RRE2: 1.8k; 0805
R_EM: 0.75ohm; 0805
R_EM1: 10k; 0805
SIGNAL: 1X3
U$1: MCH3474
U$21: EMITTER

Connections:
2V: CEM1.2, CEM2.1, PW.1, PW2.1, U$21.+
3.3V: PW.2, PW2.2, RECEIVER1.C, RECEIVER2.C
EM: R_EM1.2, SIGNAL.3, U$1.G
EM-: R_EM.2, U$21.-
GND: CEM1.1, CEM2.2, PW.3, PW2.3, RRE1.1, RRE2.1, R_EM1.1, U$1.S
unnamed: R_EM.1, U$1.D
RE1: RECEIVER1.E, RRE1.2, SIGNAL.2
RE2: RECEIVER2.E, RRE2.2, SIGNAL.1

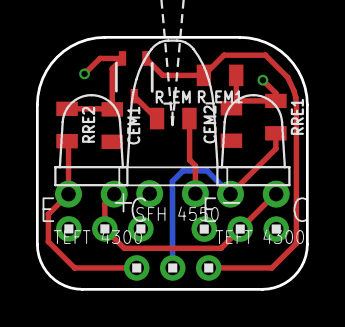
[picture p116: board IR 1E2R.brd from above]

Board: 2 copper layers, 15.0 x 14.0 mm, 13 parts (0 on the bottom side), 8 nets.
