zht043/MicroMouse-Team1/Electrical Hardware/PCB_1st version/uC/uC_Main.brd

## EAGLE design Electrical Hardware/PCB_1st version/uC/uC_Main.brd (2018-03-08)

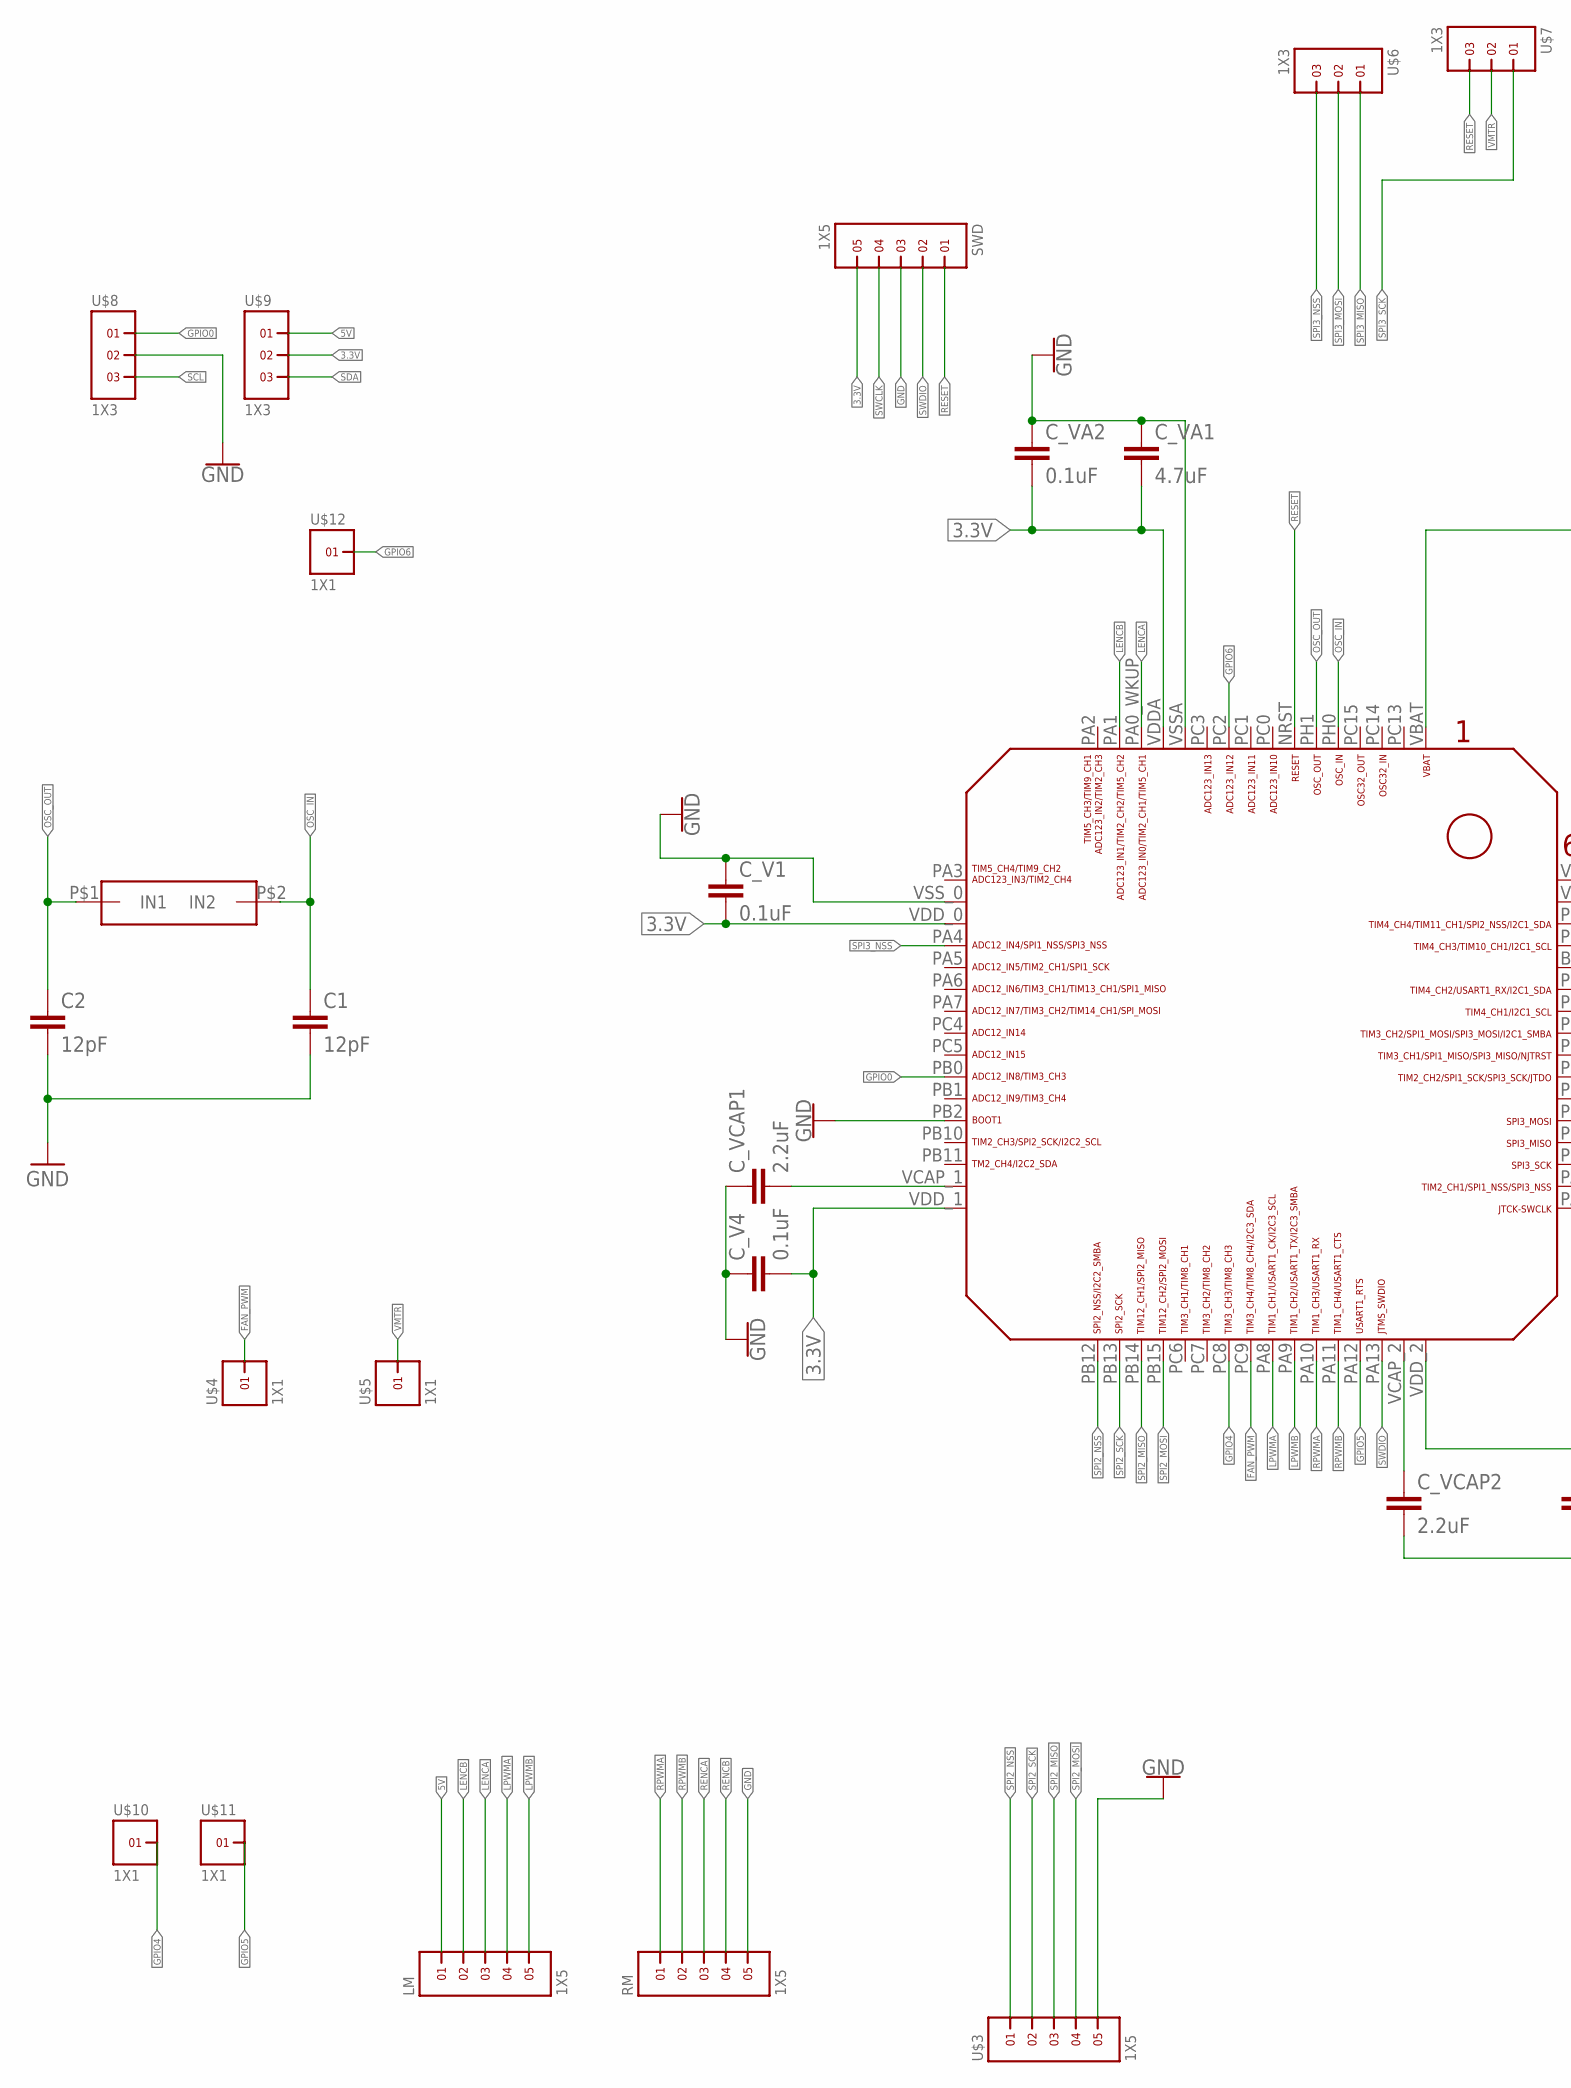
[picture p117: schematic uC_Main.sch, part in row 1, column 1]

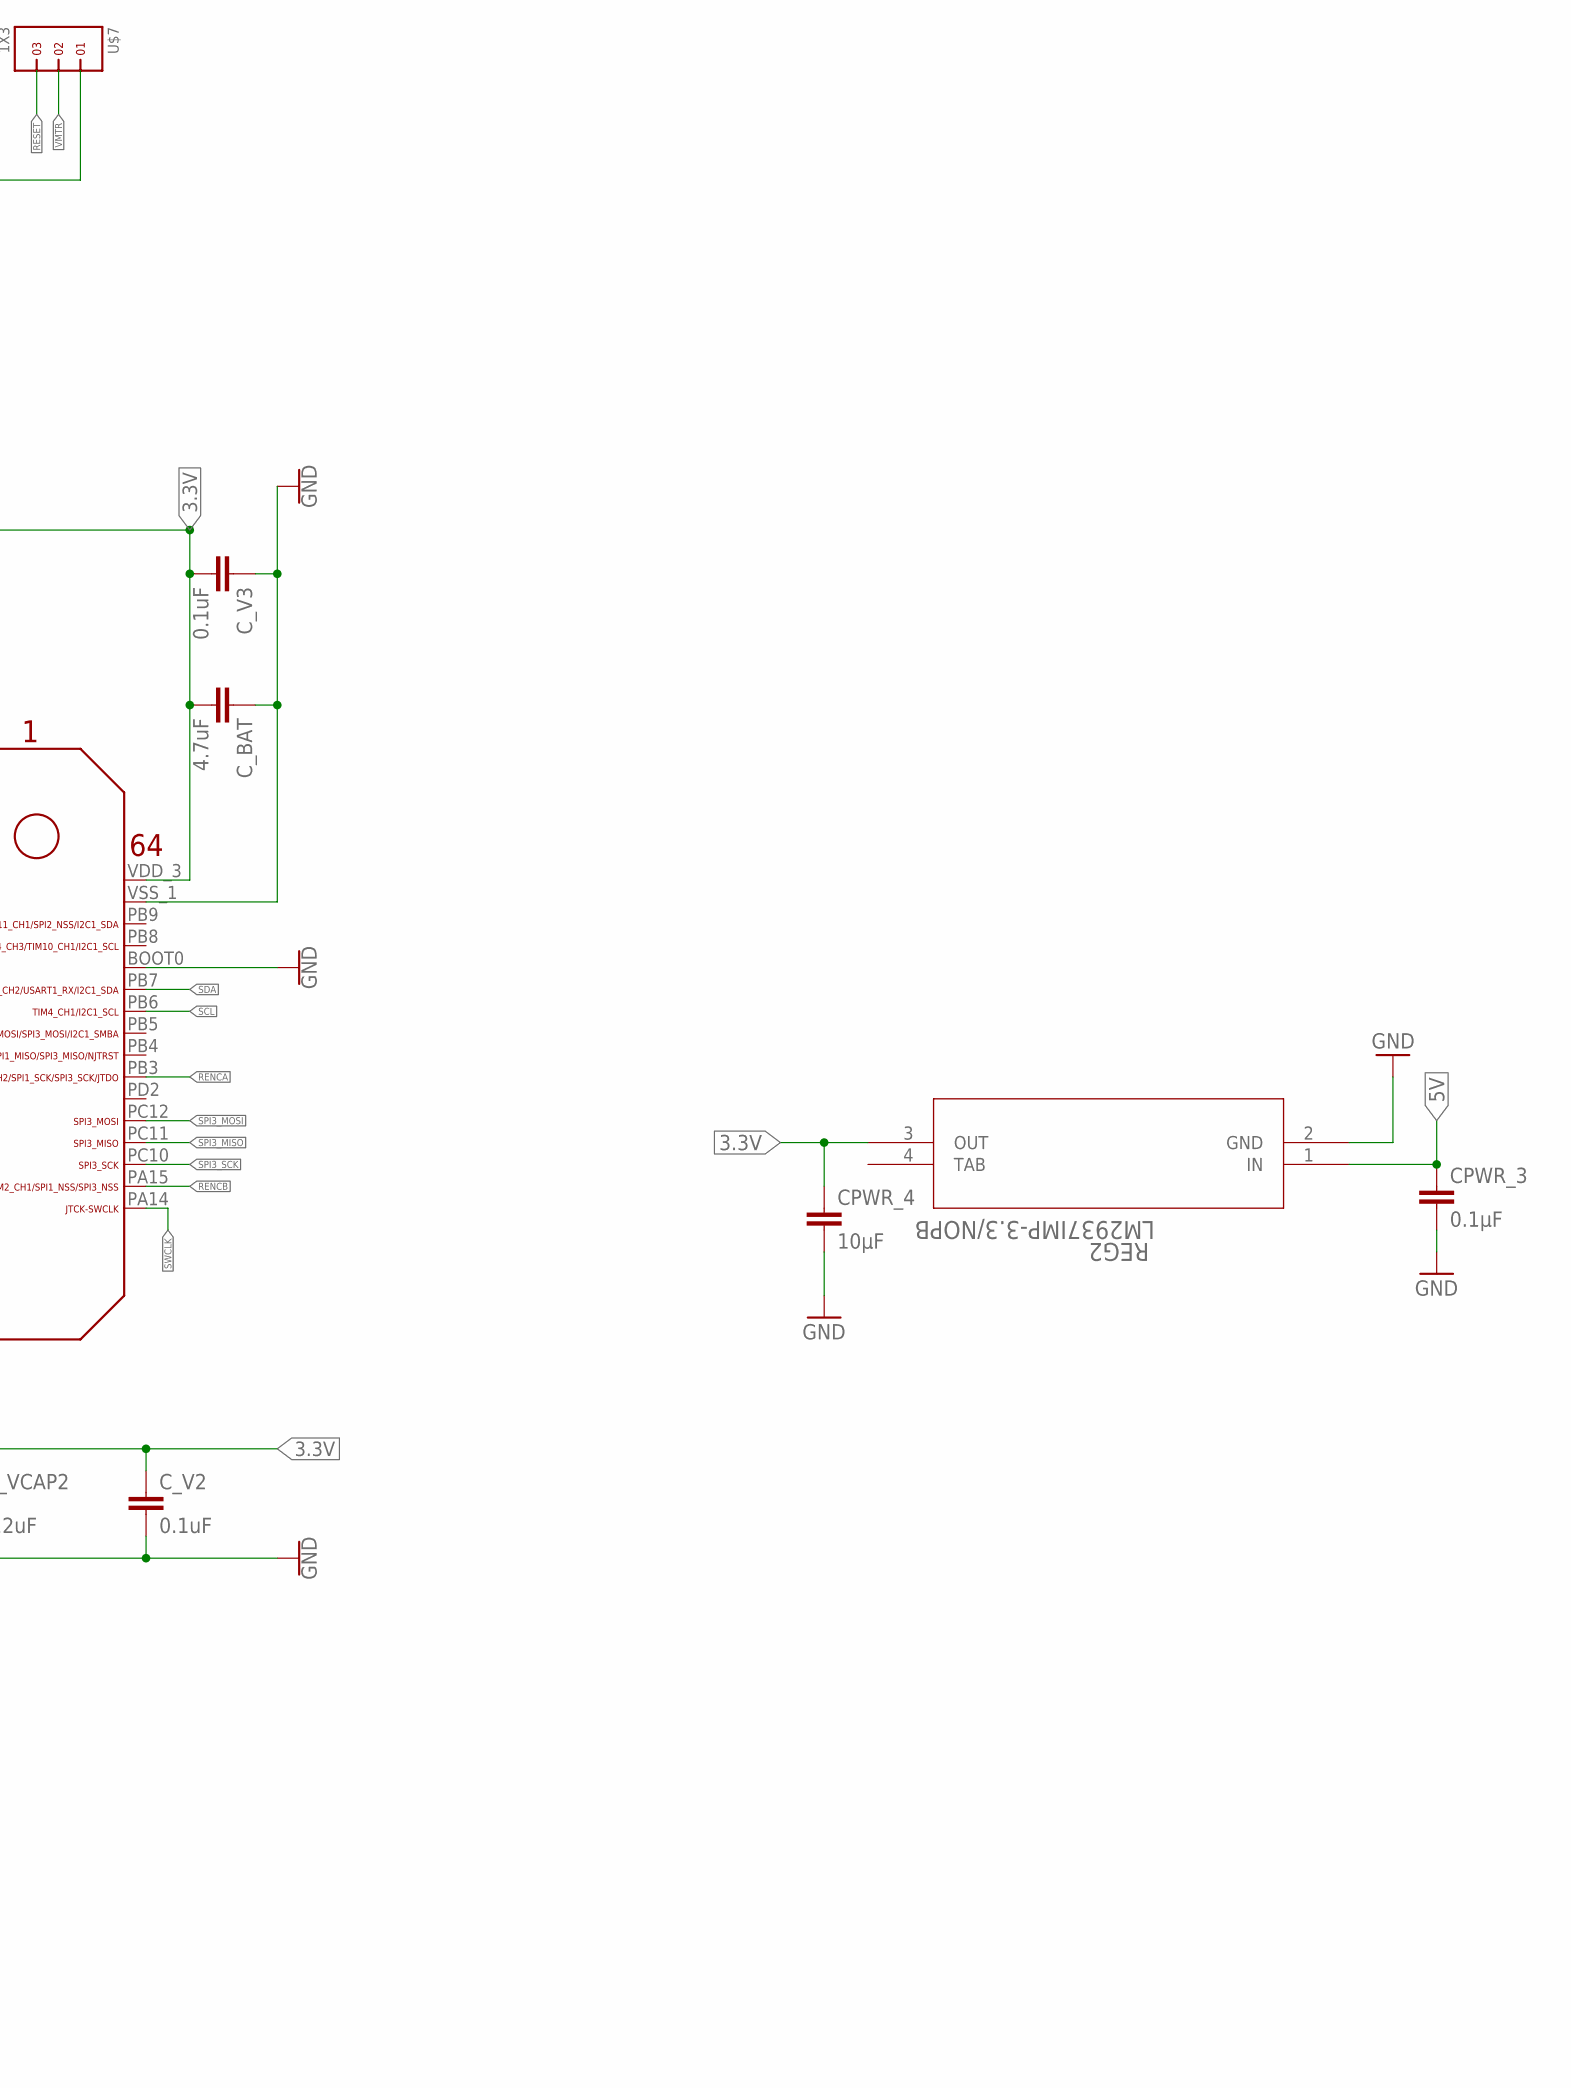
[picture p118: schematic uC_Main.sch, part in row 1, column 2]

Parts:
C1, C2: 12pF; 0603
CPWR_3: 0.1µF; 0805
CPWR_4: 10µF; 0805
C_BAT: 4.7uF; 0805@1
C_V1, C_V2, C_V3, C_V4: 0.1uF; 0805@1
C_VA1: 4.7uF; 0805@1
C_VA2: 0.1uF; 0805@1
C_VCAP1, C_VCAP2: 2.2uF; 0805@1
LM: 1X5
REG2: LM2937IMP-3.3/NOPB; MP04A
RM: 1X5
SWD: 1X5
U$1: STM32F405/415_LQFP64
U$2: OSC
U$3: 1X5
U$4, U$5, U$10, U$11, U$12: 1X1
U$6, U$7, U$8, U$9: 1X3

Connections:
3.3V: CPWR_4.1, C_BAT.2, C_V1.2, C_V2.1, C_V3.2, C_V4.2, C_VA1.2, C_VA2.2, REG2.3 (OUT), SWD.5, U$1.VBAT, U$1.VDDA, U$1.VDD_0, U$1.VDD_1, U$1.VDD_2, U$1.VDD_3, U$9.2
5V: CPWR_3.1, LM.1, REG2.1 (IN), U$9.1
FAN_PWM: U$1.PC9, U$4.1
GND: C1.2, C2.2, CPWR_3.2, CPWR_4.2, C_BAT.1, C_V1.1, C_V2.2, C_V3.1, C_V4.1, C_VA1.1, C_VA2.1, C_VCAP1.1, C_VCAP2.2, REG2.2 (GND), RM.5, SWD.3, U$1.BOOT0, U$1.PB2, U$1.VSSA, U$1.VSS_0, U$1.VSS_1, U$3.5, U$8.2
GPIO0: U$1.PB0, U$8.1
GPIO4: U$1.PC8, U$10.1
GPIO5: U$1.PA12, U$11.1
GPIO6: U$1.PC2, U$12.1
LENCA: LM.3, U$1.PA0_WKUP (PA0_AKUP)
LENCB: LM.2, U$1.PA1
LPWMA: LM.4, U$1.PA8
LPWMB: LM.5, U$1.PA9
OSC_IN: C1.1, U$1.PH0, U$2.P$2 (IN2)
OSC_OUT: C2.1, U$1.PH1, U$2.P$1 (IN1)
RENCA: RM.3, U$1.PB3
RENCB: RM.4, U$1.PA15
RESET: SWD.1, U$1.NRST, U$7.3
RPWMA: RM.1, U$1.PA10
RPWMB: RM.2, U$1.PA11
SCL: U$1.PB6, U$8.3
SDA: U$1.PB7, U$9.3
SPI2_MISO: U$1.PB14, U$3.3
SPI2_MOSI: U$1.PB15, U$3.4
SPI2_NSS: U$1.PB12, U$3.1
SPI2_SCK: U$1.PB13, U$3.2
SPI3_MISO: U$1.PC11, U$6.1
SPI3_MOSI: U$1.PC12, U$6.2
SPI3_NSS: U$1.PA4, U$6.3
SPI3_SCK: U$1.PC10, U$7.1
SWCLK: SWD.4, U$1.PA14
SWDIO: SWD.2, U$1.PA13
TAB: REG2.4 (TAB)
VCAP_1: C_VCAP1.2, U$1.VCAP_1
VCAP_2: C_VCAP2.1, U$1.VCAP_2
VMTR: U$5.1, U$7.2

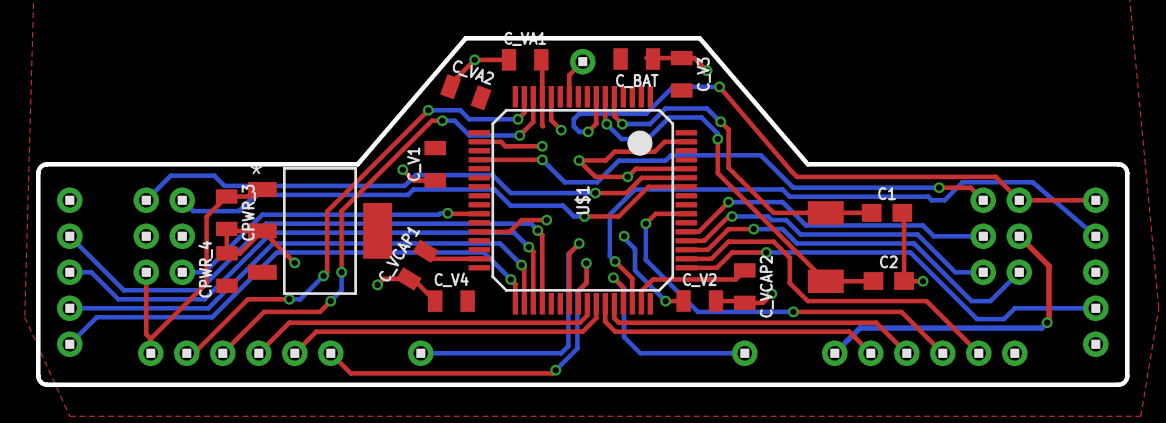
[picture p119: board Electrical Hardware/PCB_1st version/uC/uC_Main.brd from above]

Board: 2 copper layers, 60.5 x 19.2 mm, 29 parts (0 on the bottom side), 34 nets.
