zht043/MicroMouse-Team1/Electrical Hardware/PCB_1st version/uC_Sensors/uC_Sensor.brd

## EAGLE design Electrical Hardware/PCB_1st version/uC_Sensors/uC_Sensor.brd (2018-03-08)

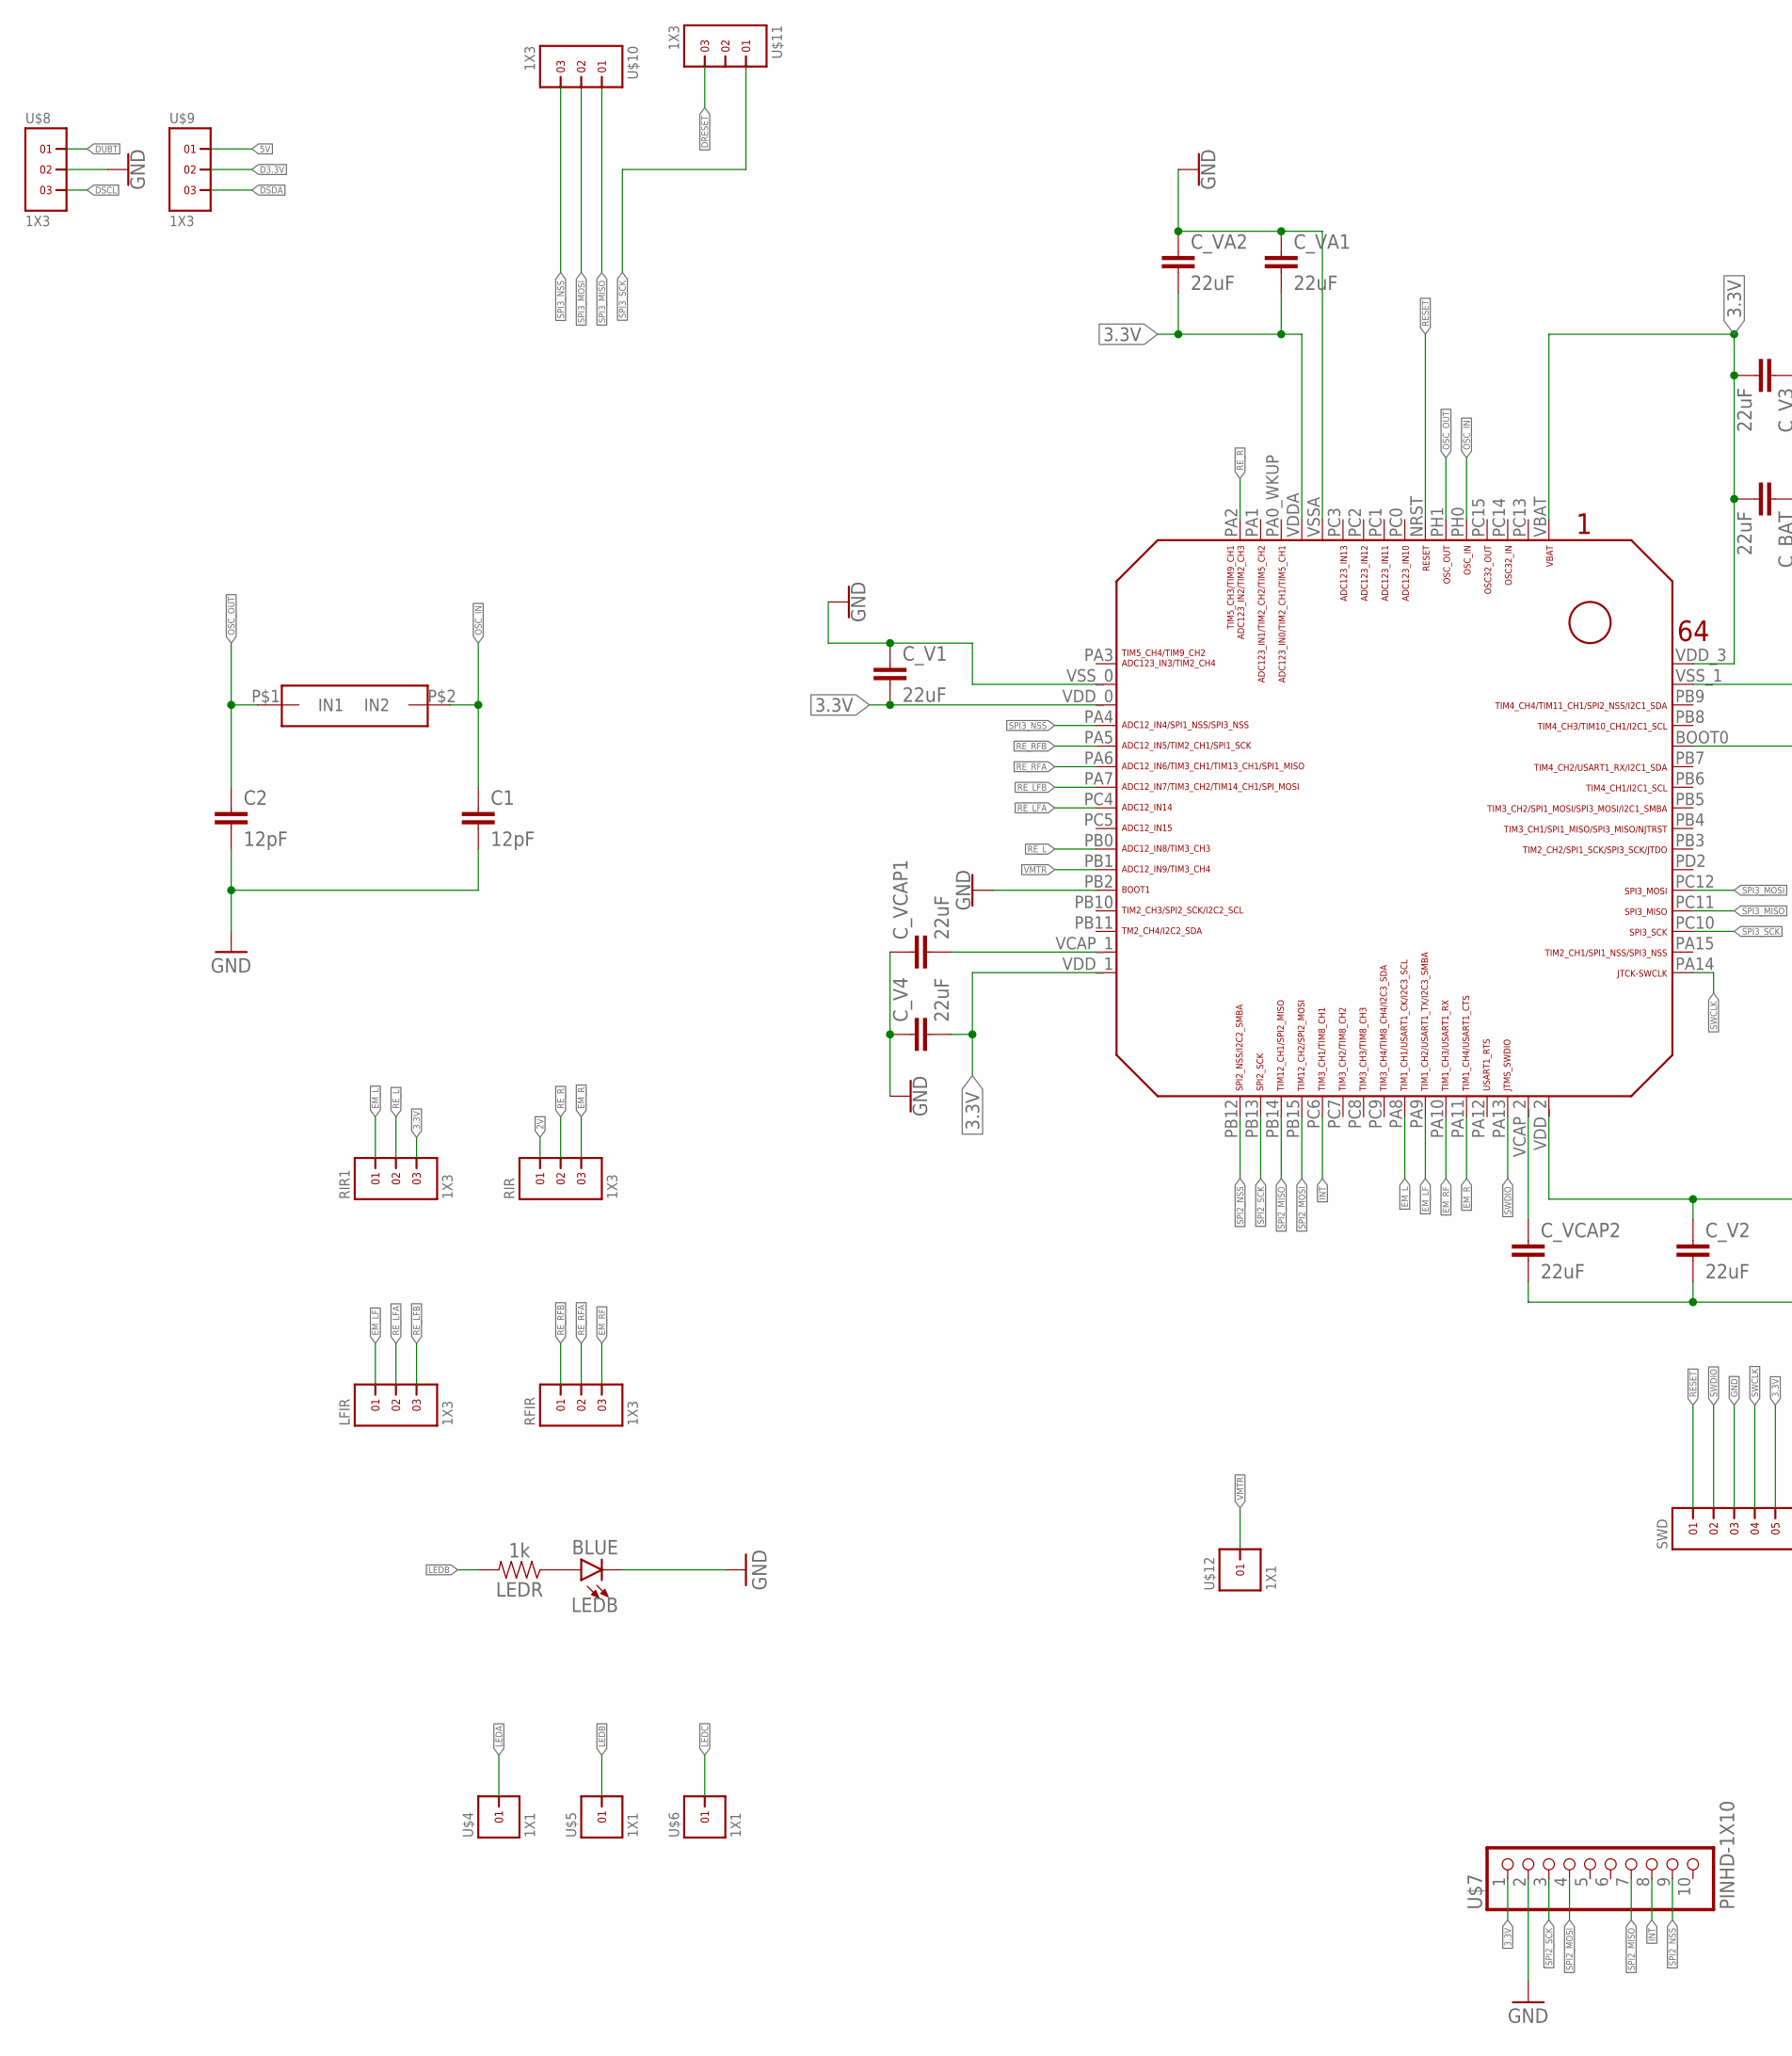
[picture p120: schematic uC_Sensor.sch, part in row 1, column 1]

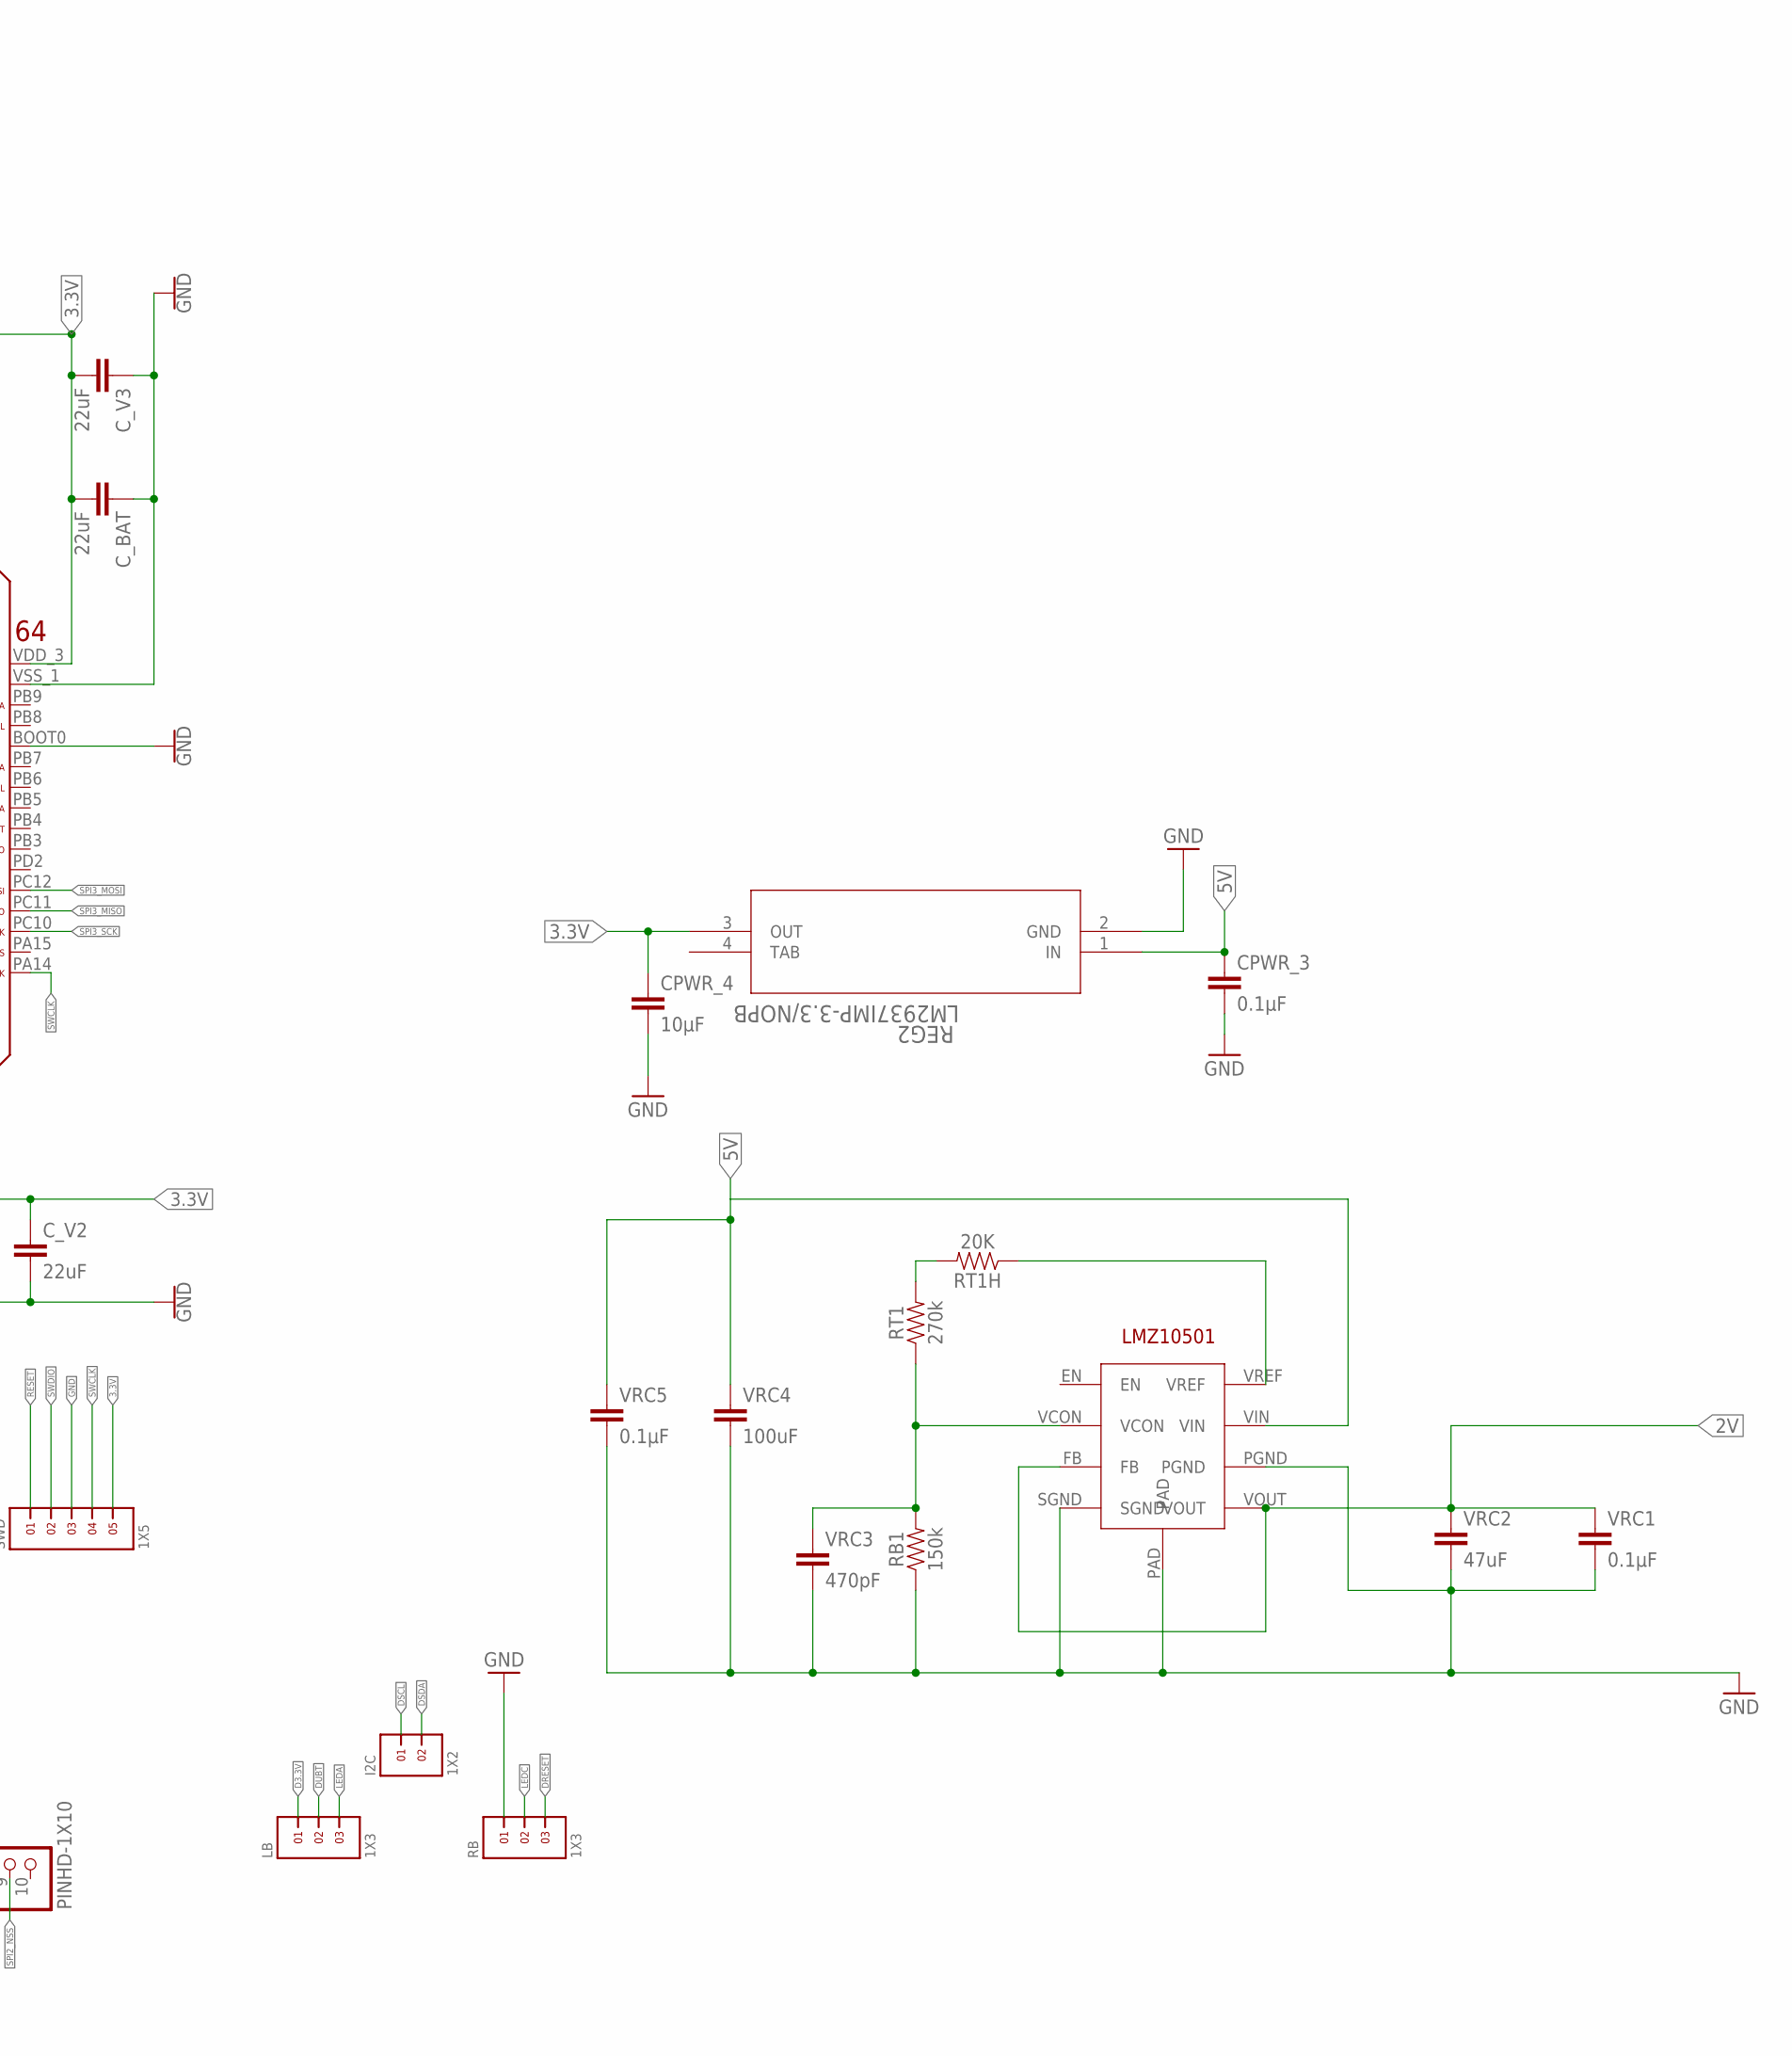
[picture p121: schematic uC_Sensor.sch, part in row 1, column 2]

Parts:
C1, C2: 12pF; 0603
CPWR_3: 0.1µF; 0805@2
CPWR_4: 10µF; 0805@2
C_BAT: 22uF; 0805
C_V1, C_V2, C_V3, C_V4: 22uF; 0805
C_VA1, C_VA2: 22uF; 0805
C_VCAP1, C_VCAP2: 22uF; 0805
I2C: 1X2
LB: 1X3
LEDB: BLUE; LED-1206
LEDR: 1k; 0805
LFIR: 1X3
RB: 1X3
RB1: 150k; 0805
REG2: LM2937IMP-3.3/NOPB; MP04A
RFIR: 1X3
RIR, RIR1: 1X3
RT1: 270k; 0805
RT1H: 20K; 0805
SWD: 1X5
U$1: STM32F405/415_LQFP64
U$2: OSC
U$3: LMZ10501
U$4, U$5, U$6, U$12: 1X1
U$7: PINHD-1X10; 1X10-BIG
U$8, U$9, U$10, U$11: 1X3
VRC1, VRC5: 0.1µF; 0805@2
VRC2: 47uF; 0805@2
VRC3: 470pF; 0805@2
VRC4: 100uF; 0805@2

Connections:
2V: RIR.1, U$3.FB, U$3.VOUT, VRC1.1, VRC2.1
3.3V: CPWR_4.1, C_BAT.2, C_V1.2, C_V2.1, C_V3.2, C_V4.2, C_VA1.2, C_VA2.2, REG2.3 (OUT), RIR1.3, SWD.5, U$1.VBAT, U$1.VDDA, U$1.VDD_0, U$1.VDD_1, U$1.VDD_2, U$1.VDD_3, U$7.1
5V: CPWR_3.1, REG2.1 (IN), U$3.VIN, U$9.1, VRC4.1, VRC5.1
D3.3V: LB.1, U$9.2
DRESET: RB.3, U$11.3
DSCL: I2C.1, U$8.3
DSDA: I2C.2, U$9.3
DUBT: LB.2, U$8.1
EM_L: RIR1.1, U$1.PA8
EM_LF: LFIR.1, U$1.PA9
EM_R: RIR.3, U$1.PA11
EM_RF: RFIR.3, U$1.PA10
GND: C1.2, C2.2, CPWR_3.2, CPWR_4.2, C_BAT.1, C_V1.1, C_V2.2, C_V3.1, C_V4.1, C_VA1.1, C_VA2.1, C_VCAP1.1, C_VCAP2.2, LEDB.C, RB.1, RB1.1, REG2.2 (GND), SWD.3, U$1.BOOT0, U$1.PB2, U$1.VSSA, U$1.VSS_0, U$1.VSS_1, U$3.PAD, U$3.PGND, U$3.SGND, U$7.2, U$8.2, VRC1.2, VRC2.2, VRC3.2, VRC4.2, VRC5.2
INT: U$1.PC6, U$7.8
LEDA: LB.3, U$4.1
LEDB: LEDR.2, U$5.1
LEDC: RB.2, U$6.1
unnamed: RT1.2, RT1H.2
unnamed: RB1.2, RT1.1, U$3.VCON, VRC3.1
unnamed: RT1H.1, U$3.VREF
unnamed: LEDB.A, LEDR.1
OSC_IN: C1.1, U$1.PH0, U$2.P$2 (IN2)
OSC_OUT: C2.1, U$1.PH1, U$2.P$1 (IN1)
RESET: SWD.1, U$1.NRST
RE_L: RIR1.2, U$1.PB0
RE_LFA: LFIR.2, U$1.PC4
RE_LFB: LFIR.3, U$1.PA7
RE_R: RIR.2, U$1.PA2
RE_RFA: RFIR.2, U$1.PA6
RE_RFB: RFIR.1, U$1.PA5
SPI2_MISO: U$1.PB14, U$7.7
SPI2_MOSI: U$1.PB15, U$7.4
SPI2_NSS: U$1.PB12, U$7.9
SPI2_SCK: U$1.PB13, U$7.3
SPI3_MISO: U$1.PC11, U$10.1
SPI3_MOSI: U$1.PC12, U$10.2
SPI3_NSS: U$1.PA4, U$10.3
SPI3_SCK: U$1.PC10, U$11.1
SWCLK: SWD.4, U$1.PA14
SWDIO: SWD.2, U$1.PA13
TAB: REG2.4 (TAB)
VCAP_1: C_VCAP1.2, U$1.VCAP_1
VCAP_2: C_VCAP2.1, U$1.VCAP_2
VMTR: U$1.PB1, U$12.1

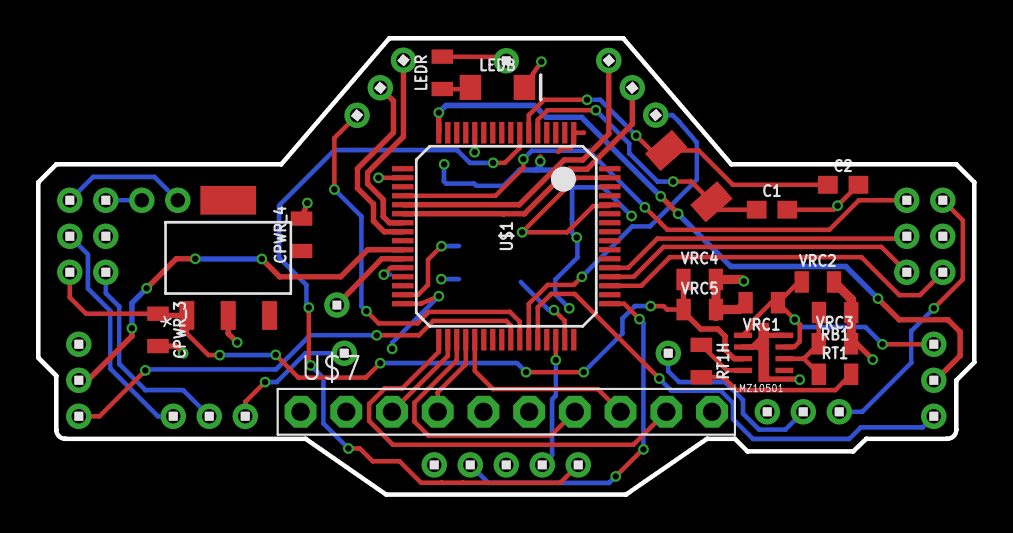
[picture p122: board uC_Sensor.brd from above]

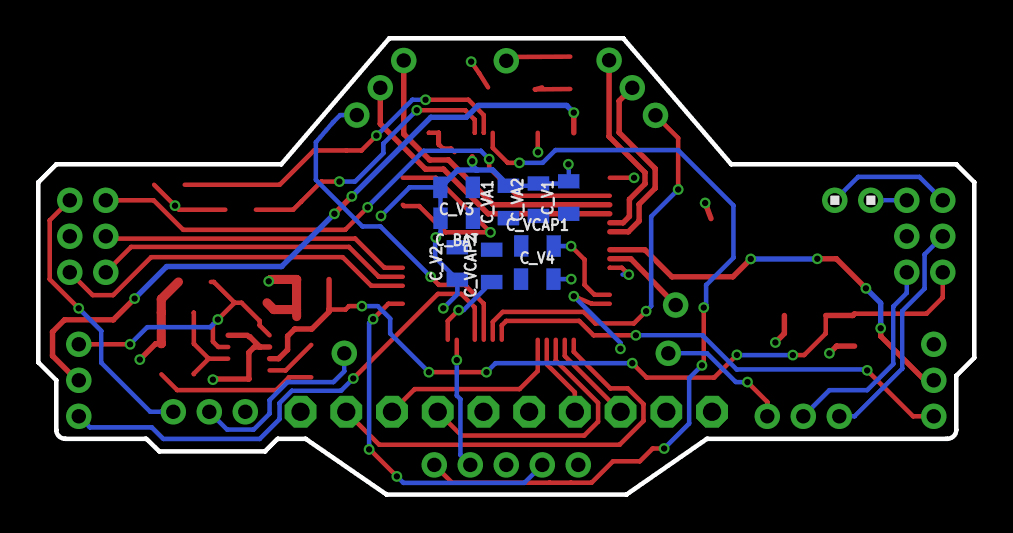
[picture p123: board uC_Sensor.brd from below]

Board: 2 copper layers, 52.0 x 25.4 mm, 44 parts (10 on the bottom side), 43 nets.
