zht043/MicroMouse-Team1/Electrical Hardware/PCB_failed/uC_MAIN/uC_Main.brd

## EAGLE design Electrical Hardware/PCB_failed/uC_MAIN/uC_Main.brd (2018-03-08)

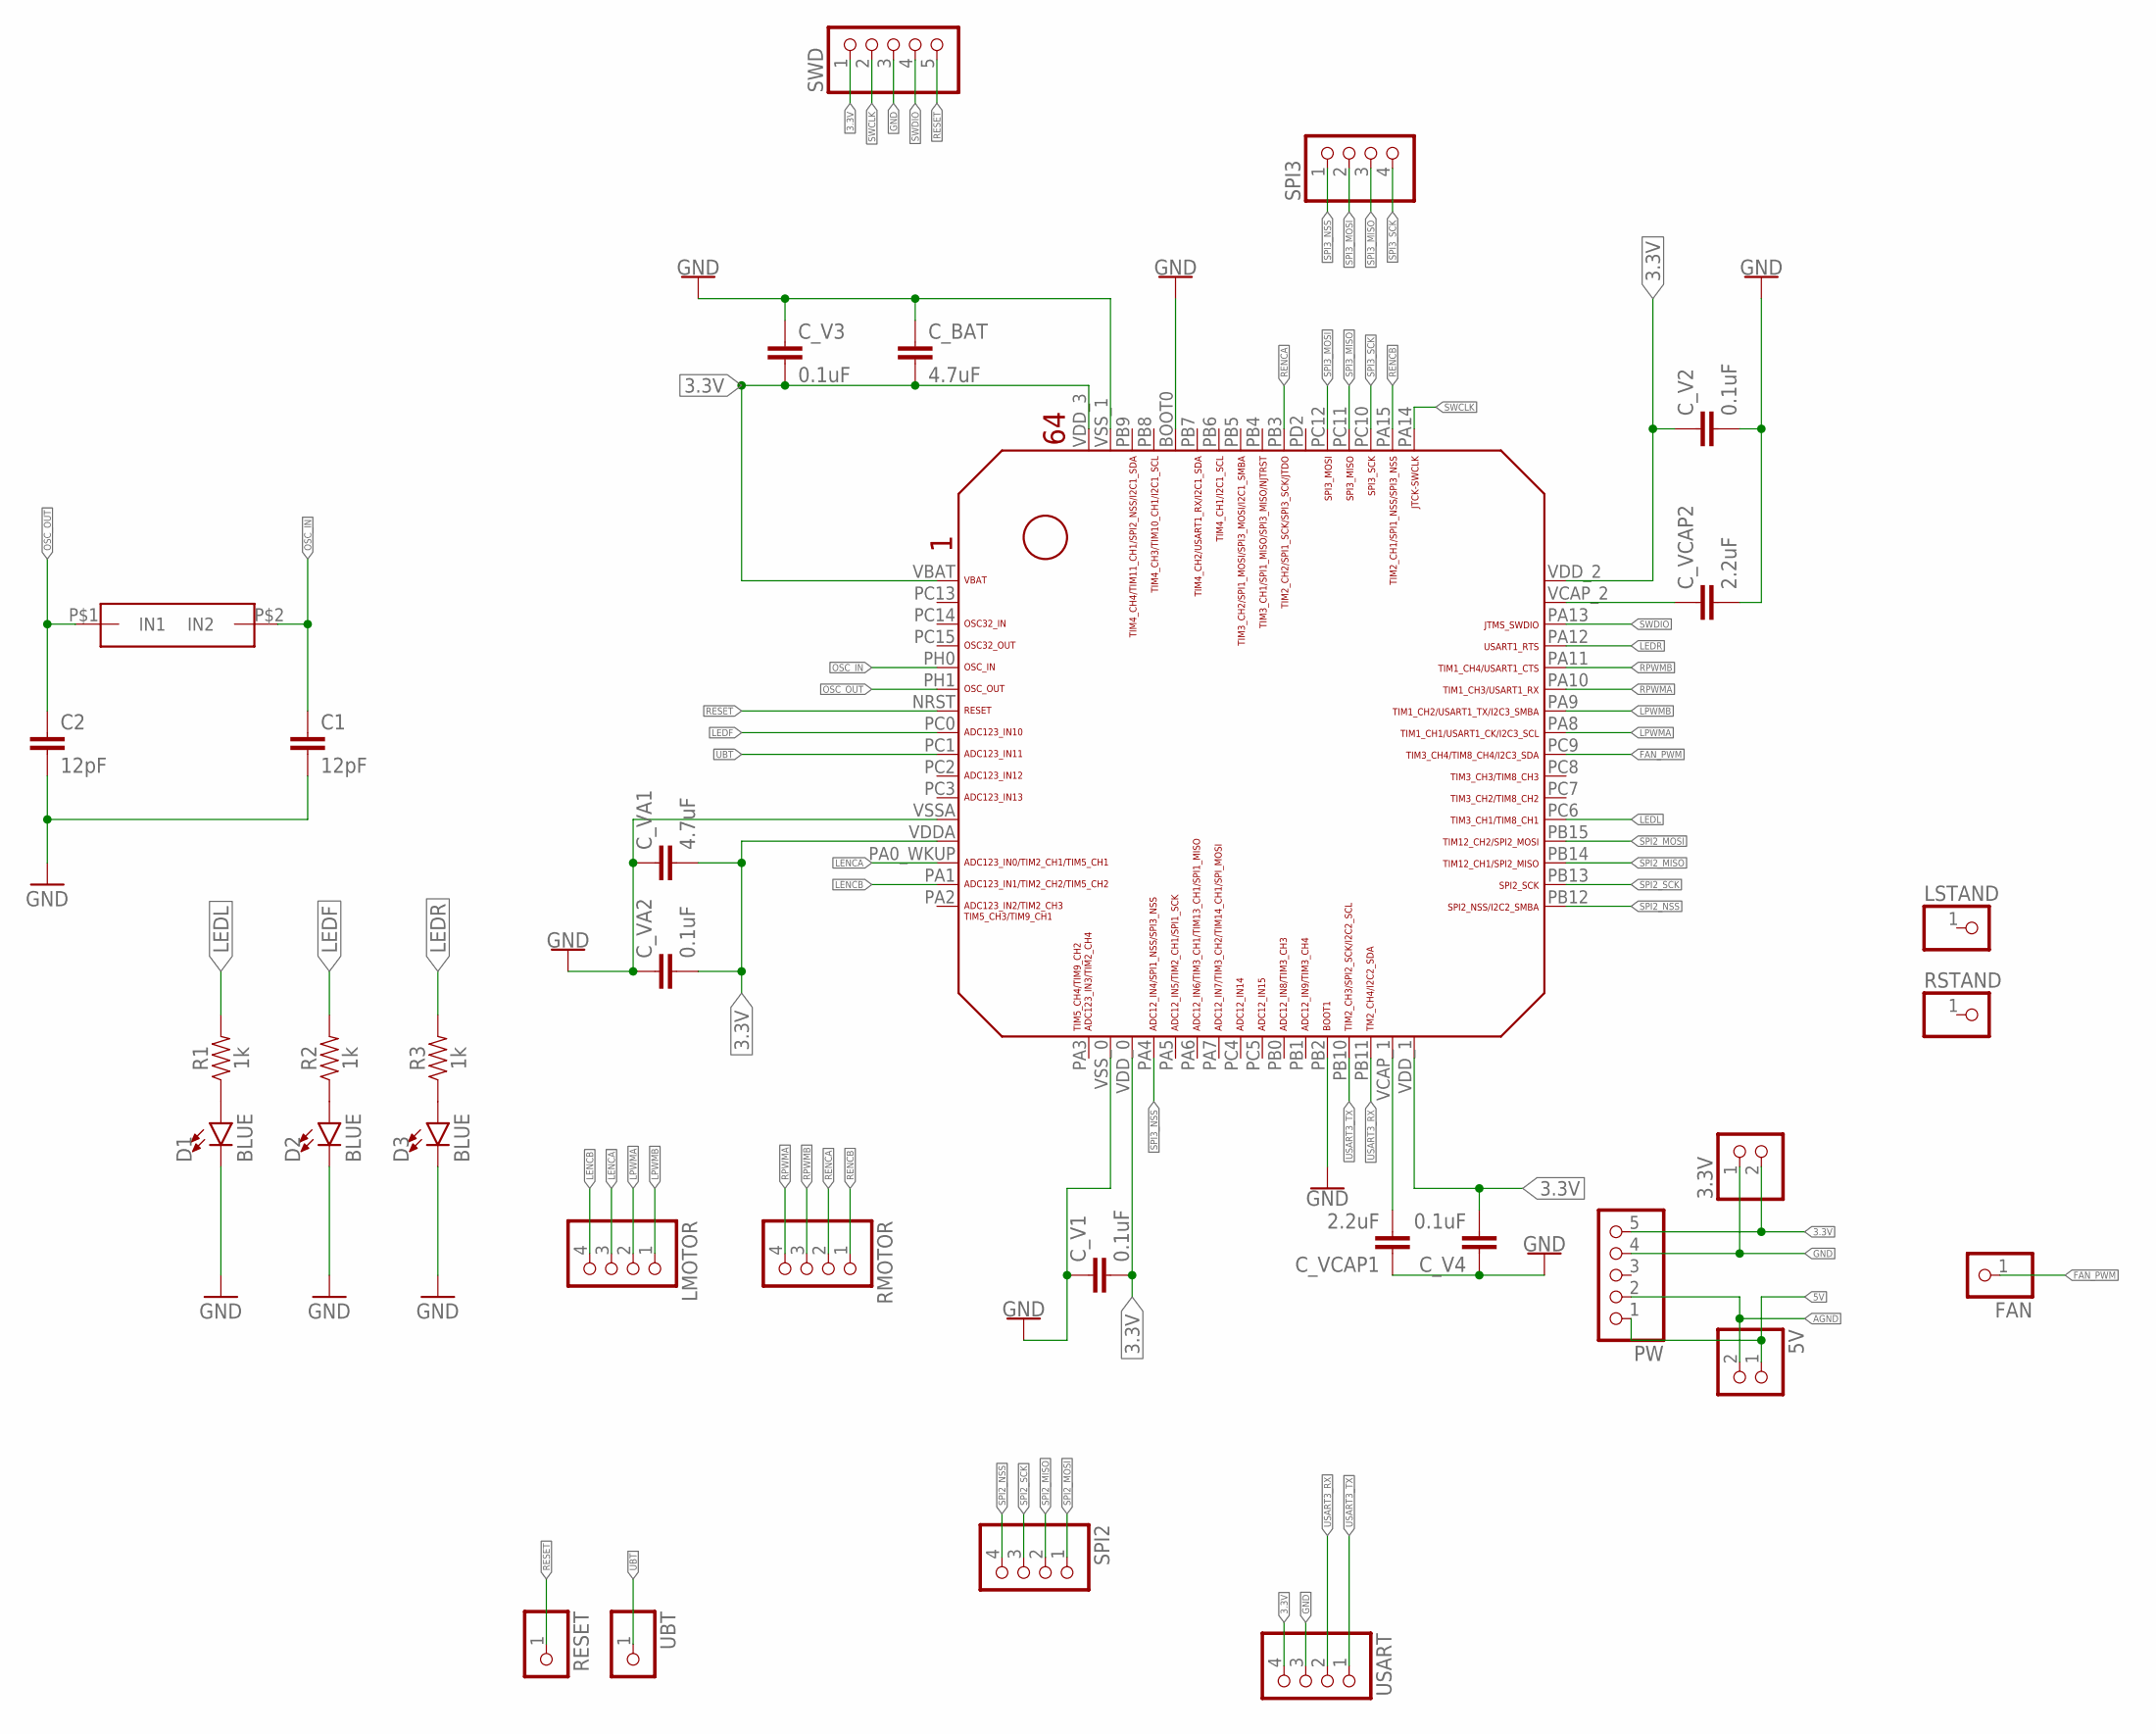
[picture p124: schematic uC_Main.sch]

Parts:
3.3V, 5V: PINHD-1X2; 1X02
C1, C2: 12pF; 0603
C_BAT: 4.7uF; 0805
C_V1, C_V2, C_V3, C_V4: 0.1uF; 0805
C_VA1: 4.7uF; 0805
C_VA2: 0.1uF; 0805
C_VCAP1, C_VCAP2: 2.2uF; 0805
D1, D2, D3: BLUE; LED-1206
FAN: PINHD-1X1; 1X01
LMOTOR: PINHD-1X4; 1X04
LSTAND: PINHD-1X1; 1X01
PW: PINHD-1X5; 1X05
R1, R2, R3: 1k; 0805
RESET: PINHD-1X1; 1X01
RMOTOR: PINHD-1X4; 1X04
RSTAND: PINHD-1X1; 1X01
SPI2, SPI3: PINHD-1X4; 1X04
SWD: PINHD-1X5; 1X05
U$1: STM32F405/415_LQFP64
U$2: OSC
UBT: PINHD-1X1; 1X01
USART: PINHD-1X4; 1X04

Connections:
3.3V: 3.3V.2, C_BAT.2, C_V1.2, C_V2.1, C_V3.2, C_V4.2, C_VA1.2, C_VA2.2, PW.5, SWD.1, U$1.VBAT, U$1.VDDA, U$1.VDD_0, U$1.VDD_1, U$1.VDD_2, U$1.VDD_3, USART.4
5V: 5V.1, PW.1
AGND: 5V.2, PW.2
FAN_PWM: FAN.1, U$1.PC9
GND: 3.3V.1, C1.2, C2.2, C_BAT.1, C_V1.1, C_V2.2, C_V3.1, C_V4.1, C_VA1.1, C_VA2.1, C_VCAP1.1, C_VCAP2.2, D1.C, D2.C, D3.C, PW.4, SWD.3, U$1.BOOT0, U$1.PB2, U$1.VSSA, U$1.VSS_0, U$1.VSS_1, USART.3
LEDF: R2.2, U$1.PC0
LEDL: R1.2, U$1.PC6
LEDR: R3.2, U$1.PA12
LENCA: LMOTOR.3, U$1.PA0_WKUP (PA0_AKUP)
LENCB: LMOTOR.4, U$1.PA1
LPWMA: LMOTOR.2, U$1.PA8
LPWMB: LMOTOR.1, U$1.PA9
unnamed: D1.A, R1.1
unnamed: D2.A, R2.1
unnamed: D3.A, R3.1
OSC_IN: C1.1, U$1.PH0, U$2.P$2 (IN2)
OSC_OUT: C2.1, U$1.PH1, U$2.P$1 (IN1)
RENCA: RMOTOR.2, U$1.PB3
RENCB: RMOTOR.1, U$1.PA15
RESET: RESET.1, SWD.5, U$1.NRST
RPWMA: RMOTOR.4, U$1.PA10
RPWMB: RMOTOR.3, U$1.PA11
SPI2_MISO: SPI2.2, U$1.PB14
SPI2_MOSI: SPI2.1, U$1.PB15
SPI2_NSS: SPI2.4, U$1.PB12
SPI2_SCK: SPI2.3, U$1.PB13
SPI3_MISO: SPI3.3, U$1.PC11
SPI3_MOSI: SPI3.2, U$1.PC12
SPI3_NSS: SPI3.1, U$1.PA4
SPI3_SCK: SPI3.4, U$1.PC10
SWCLK: SWD.2, U$1.PA14
SWDIO: SWD.4, U$1.PA13
UBT: U$1.PC1, UBT.1
USART3_RX: U$1.PB11, USART.2
USART3_TX: U$1.PB10, USART.1
VCAP_1: C_VCAP1.2, U$1.VCAP_1
VCAP_2: C_VCAP2.1, U$1.VCAP_2

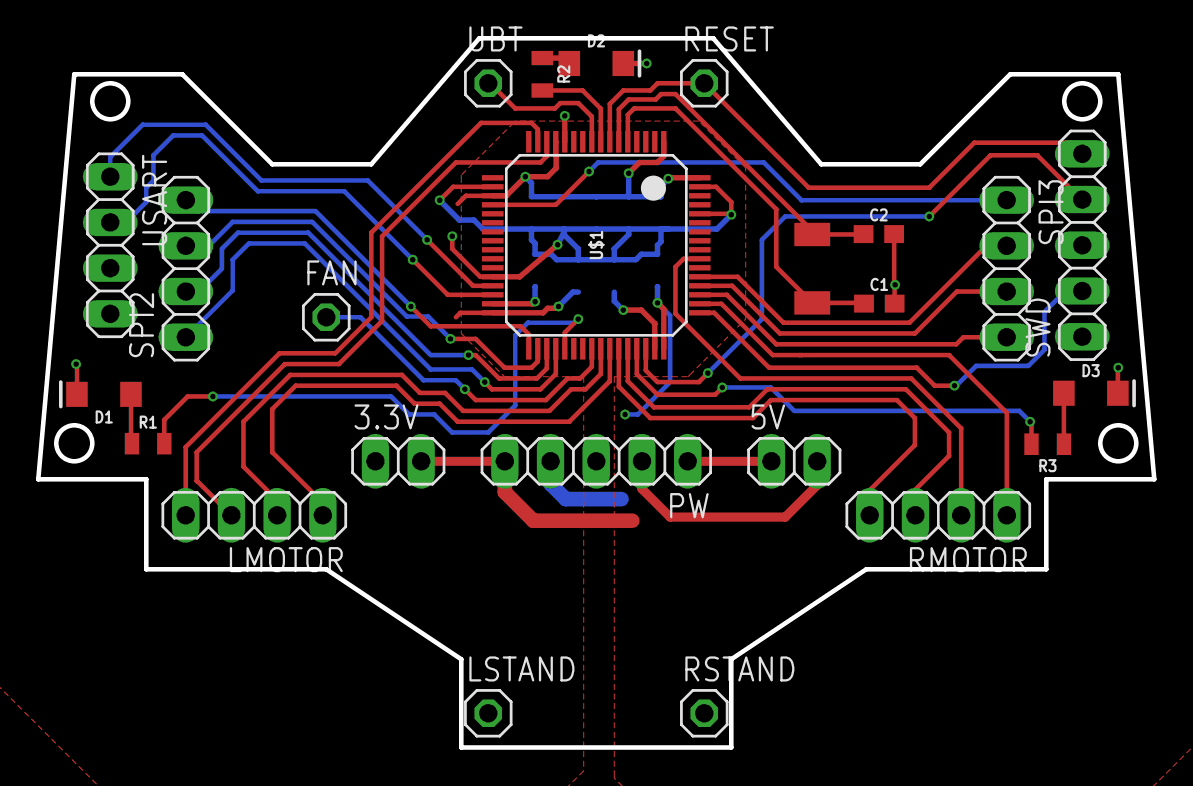
[picture p125: board Electrical Hardware/PCB_failed/uC_MAIN/uC_Main.brd from above]

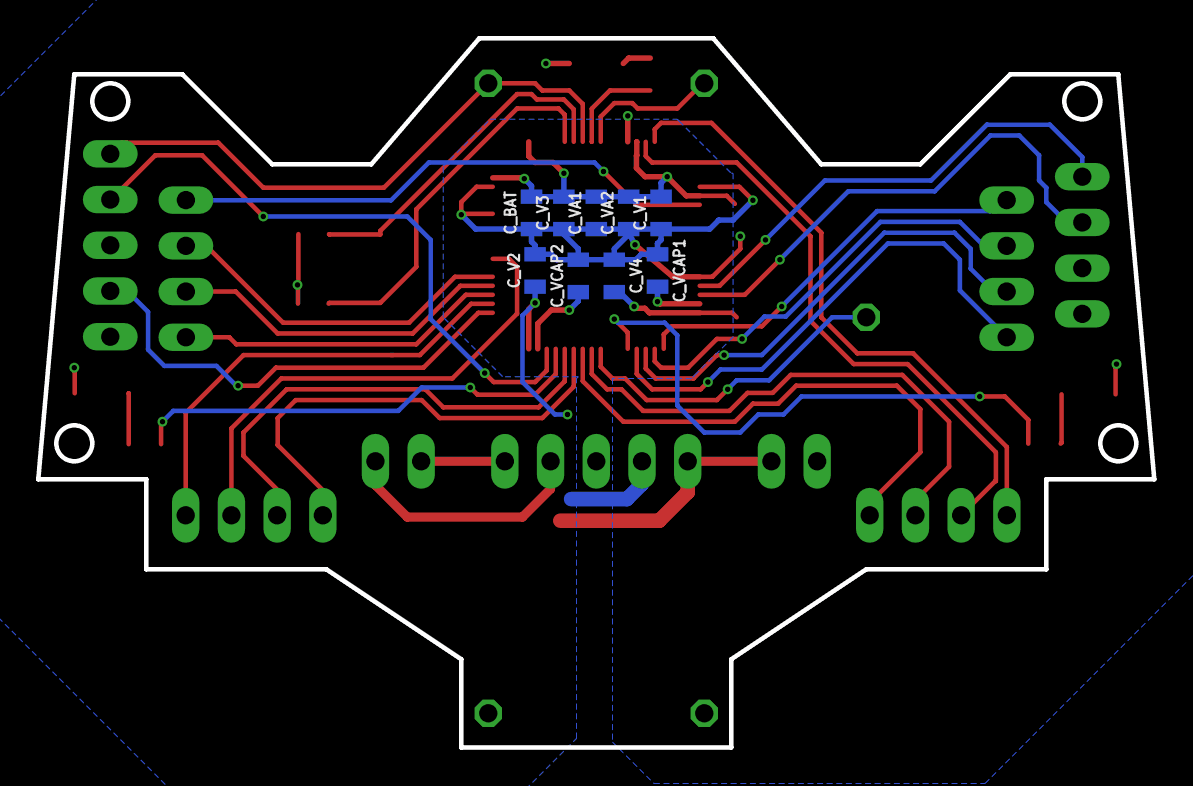
[picture p126: board Electrical Hardware/PCB_failed/uC_MAIN/uC_Main.brd from below]

Board: 2 copper layers, 62.0 x 39.4 mm, 33 parts (9 on the bottom side), 37 nets.
