zht043/MicroMouse-Team1/Electrical Hardware/PCB_failed/MM2017-18_uC_MAIN/MM2017-18_uC_Main.brd

## EAGLE design Electrical Hardware/PCB_failed/MM2017-18_uC_MAIN/MM2017-18_uC_Main.brd (2018-03-08)

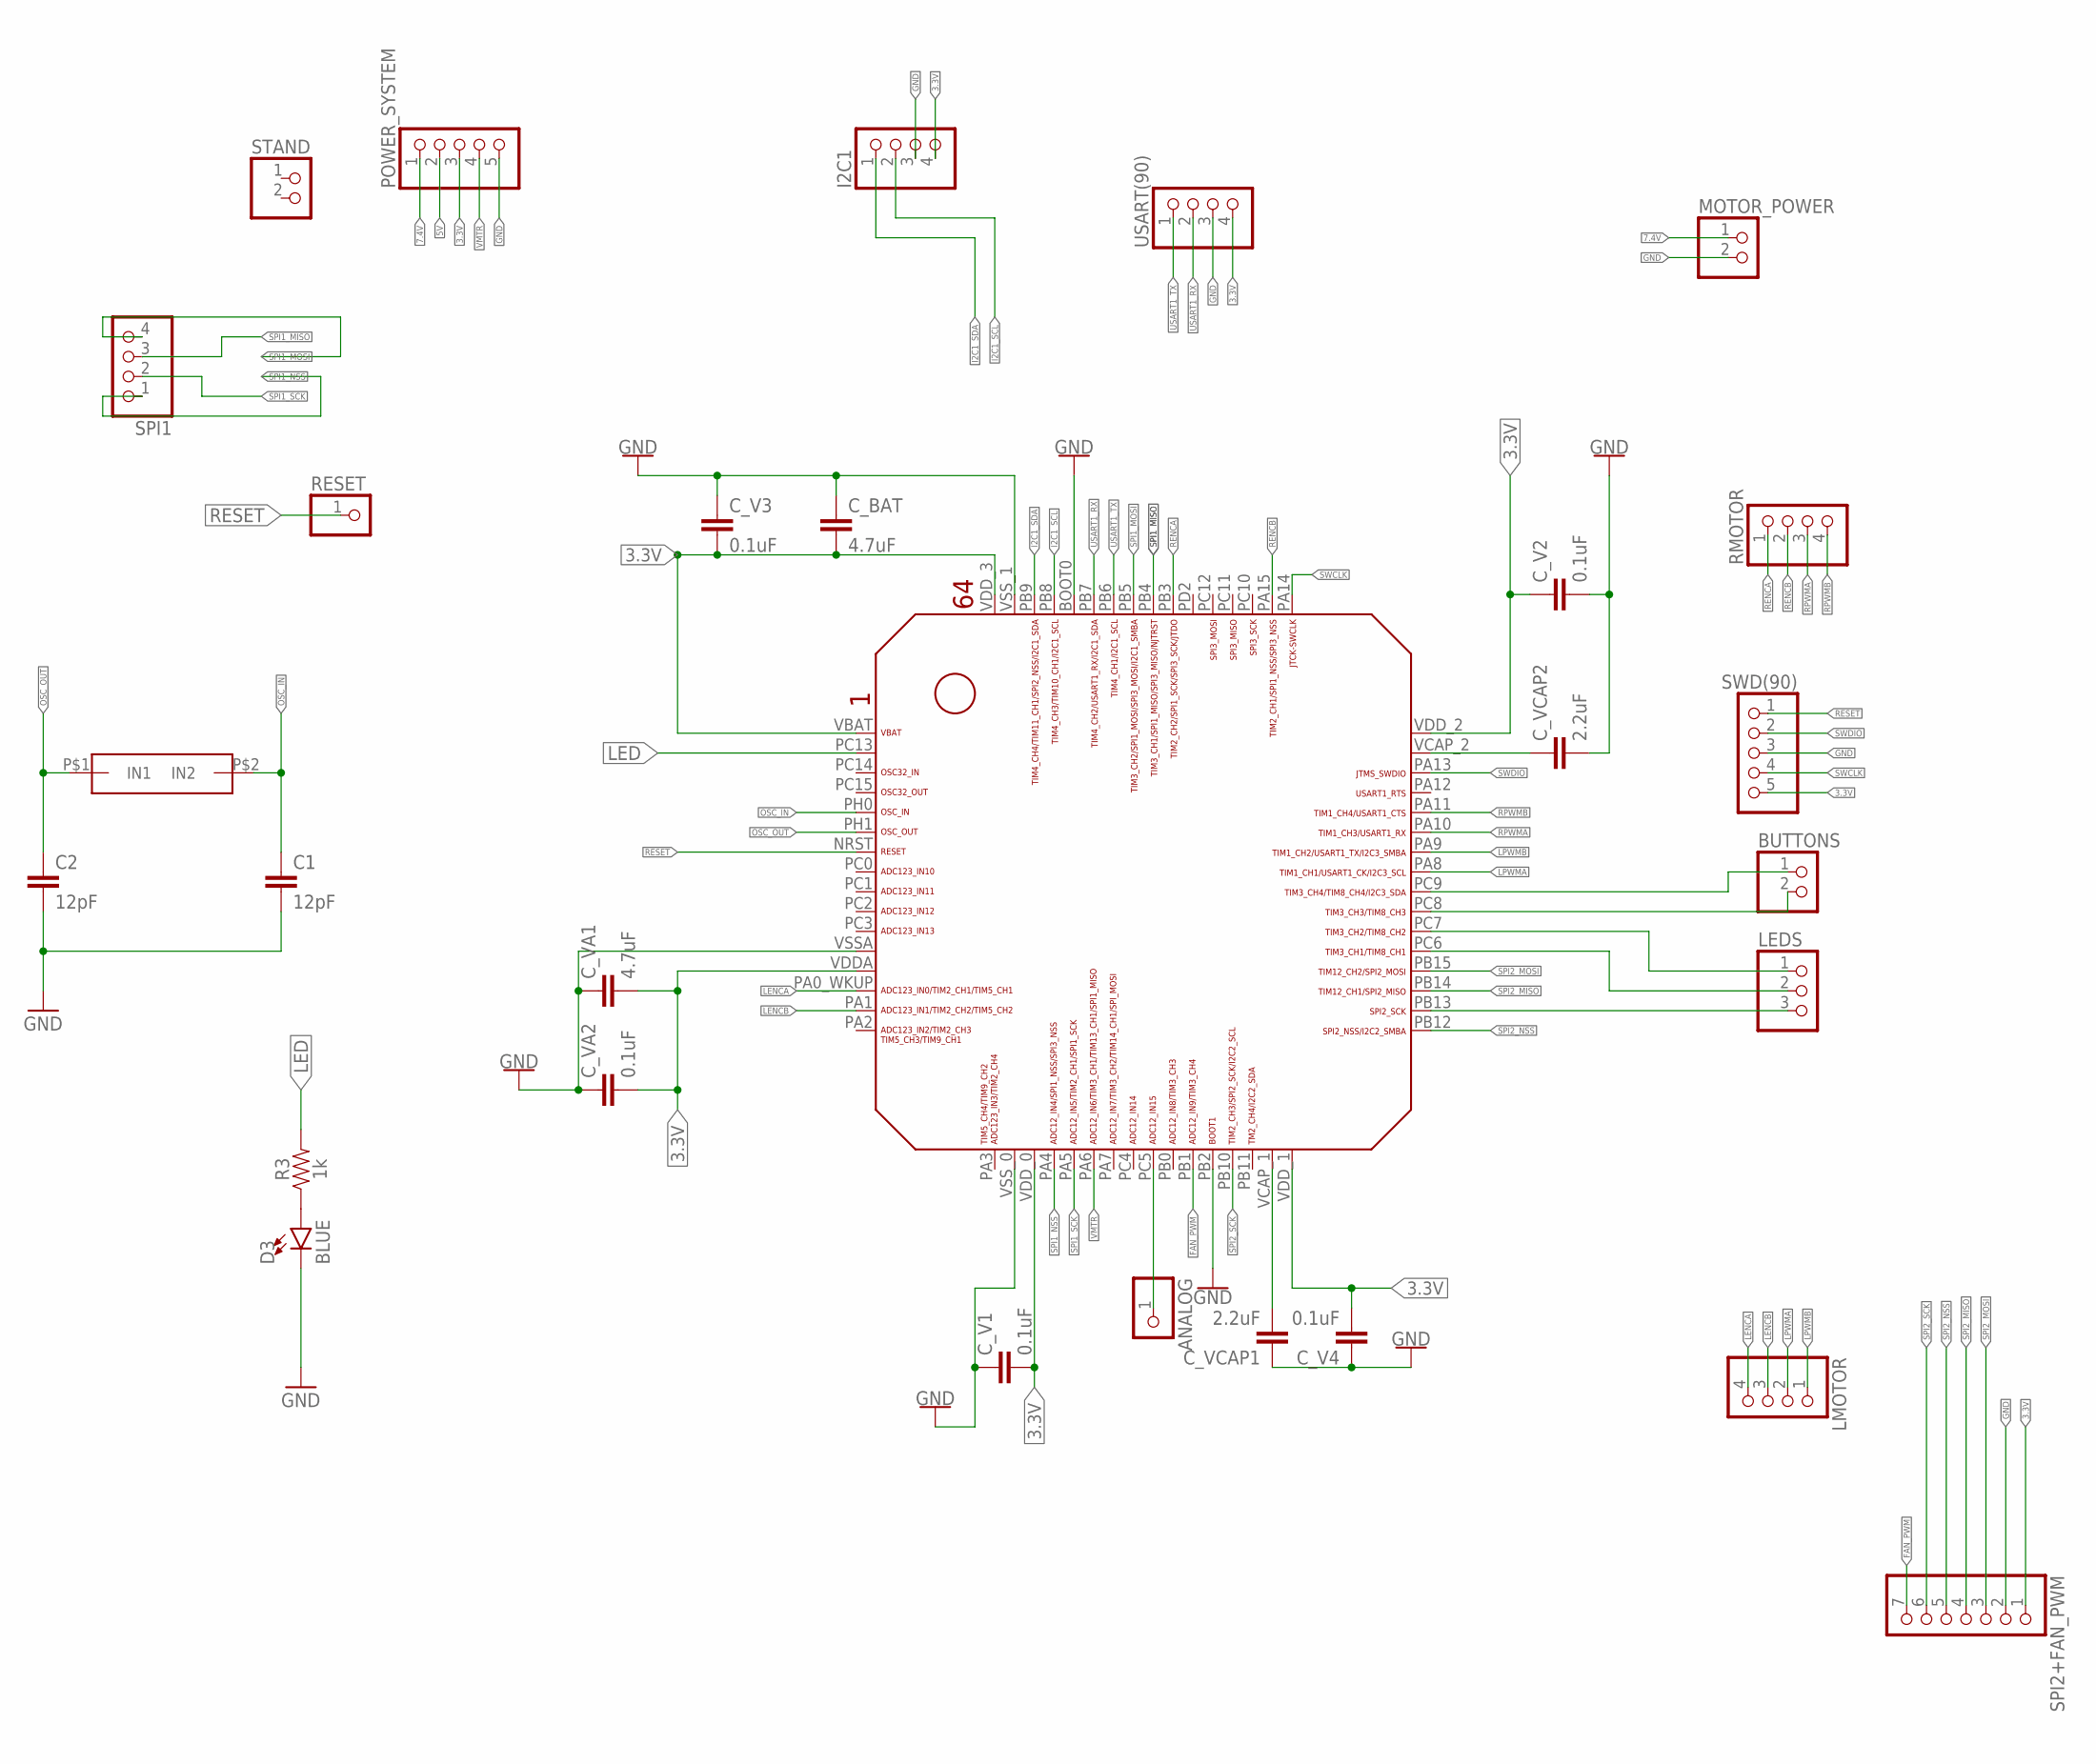
[picture p127: schematic MM2017-18_uC_Main.sch]

Parts:
ANALOG: PINHD-1X1; 1X01
BUTTONS: PINHD-1X2; 1X02
C1, C2: 12pF; 0603
C_BAT: 4.7uF; 0805
C_V1, C_V2, C_V3, C_V4: 0.1uF; 0805
C_VA1: 4.7uF; 0805
C_VA2: 0.1uF; 0805
C_VCAP1, C_VCAP2: 2.2uF; 0805
D3: BLUE; LED-1206
I2C1: PINHD-1X4; 1X04
LEDS: PINHD-1X3; 1X03
LMOTOR: PINHD-1X4; 1X04
MOTOR_POWER: PINHD-1X2; 1X02
POWER_SYSTEM: PINHD-1X5; 1X05
R3: 1k; 0805
RESET: PINHD-1X1; 1X01
RMOTOR: PINHD-1X4; 1X04
SPI1: PINHD-1X4; 1X04
SPI2+FAN_PWM: PINHD-1X7; 1X07
STAND: PINHD-1X2; 1X02
SWD(90): PINHD-1X5; 1X05
U$1: STM32F405/415_LQFP64
U$2: OSC
USART(90): PINHD-1X4; 1X04

Connections:
3.3V: C_BAT.2, C_V1.2, C_V2.1, C_V3.2, C_V4.2, C_VA1.2, C_VA2.2, I2C1.4, POWER_SYSTEM.3, SPI2+FAN_PWM.1, SWD(90).5, U$1.VBAT, U$1.VDDA, U$1.VDD_0, U$1.VDD_1, U$1.VDD_2, U$1.VDD_3, USART(90).4
5V: POWER_SYSTEM.2
7.4V: MOTOR_POWER.1, POWER_SYSTEM.1
EXTRA_ANALOG: ANALOG.1, U$1.PC5
FAN_PWM: SPI2+FAN_PWM.7, U$1.PB1
GND: C1.2, C2.2, C_BAT.1, C_V1.1, C_V2.2, C_V3.1, C_V4.1, C_VA1.1, C_VA2.1, C_VCAP1.1, C_VCAP2.2, D3.C, I2C1.3, MOTOR_POWER.2, POWER_SYSTEM.5, SPI2+FAN_PWM.2, SWD(90).3, U$1.BOOT0, U$1.PB2, U$1.VSSA, U$1.VSS_0, U$1.VSS_1, USART(90).3
GPIO1: BUTTONS.1, U$1.PC9
GPIO2: BUTTONS.2, U$1.PC8
GPIO3: LEDS.1, U$1.PC7
GPIO4: LEDS.2, U$1.PC6
GPIO5: LEDS.3, U$1.PB13
I2C1_SCL: I2C1.2, U$1.PB8
I2C1_SDA: I2C1.1, U$1.PB9
LED: R3.2, U$1.PC13
LENCA: LMOTOR.4, U$1.PA0_WKUP (PA0_AKUP)
LENCB: LMOTOR.3, U$1.PA1
LPWMA: LMOTOR.2, U$1.PA8
LPWMB: LMOTOR.1, U$1.PA9
unnamed: D3.A, R3.1
OSC_IN: C1.1, U$1.PH0, U$2.P$2 (IN2)
OSC_OUT: C2.1, U$1.PH1, U$2.P$1 (IN1)
RENCA: RMOTOR.1, U$1.PB3
RENCB: RMOTOR.2, U$1.PA15
RESET: RESET.1, SWD(90).1, U$1.NRST
RPWMA: RMOTOR.3, U$1.PA10
RPWMB: RMOTOR.4, U$1.PA11
SPI1_MISO: SPI1.3, U$1.PB4
SPI1_MOSI: SPI1.4, U$1.PB5
SPI1_NSS: SPI1.1, U$1.PA4
SPI1_SCK: SPI1.2, U$1.PA5
SPI2_MISO: SPI2+FAN_PWM.4, U$1.PB14
SPI2_MOSI: SPI2+FAN_PWM.3, U$1.PB15
SPI2_NSS: SPI2+FAN_PWM.5, U$1.PB12
SPI2_SCK: SPI2+FAN_PWM.6, U$1.PB10
SWCLK: SWD(90).4, U$1.PA14
SWDIO: SWD(90).2, U$1.PA13
USART1_RX: U$1.PB7, USART(90).2
USART1_TX: U$1.PB6, USART(90).1
VCAP_1: C_VCAP1.2, U$1.VCAP_1
VCAP_2: C_VCAP2.1, U$1.VCAP_2
VMTR: POWER_SYSTEM.4, U$1.PA6

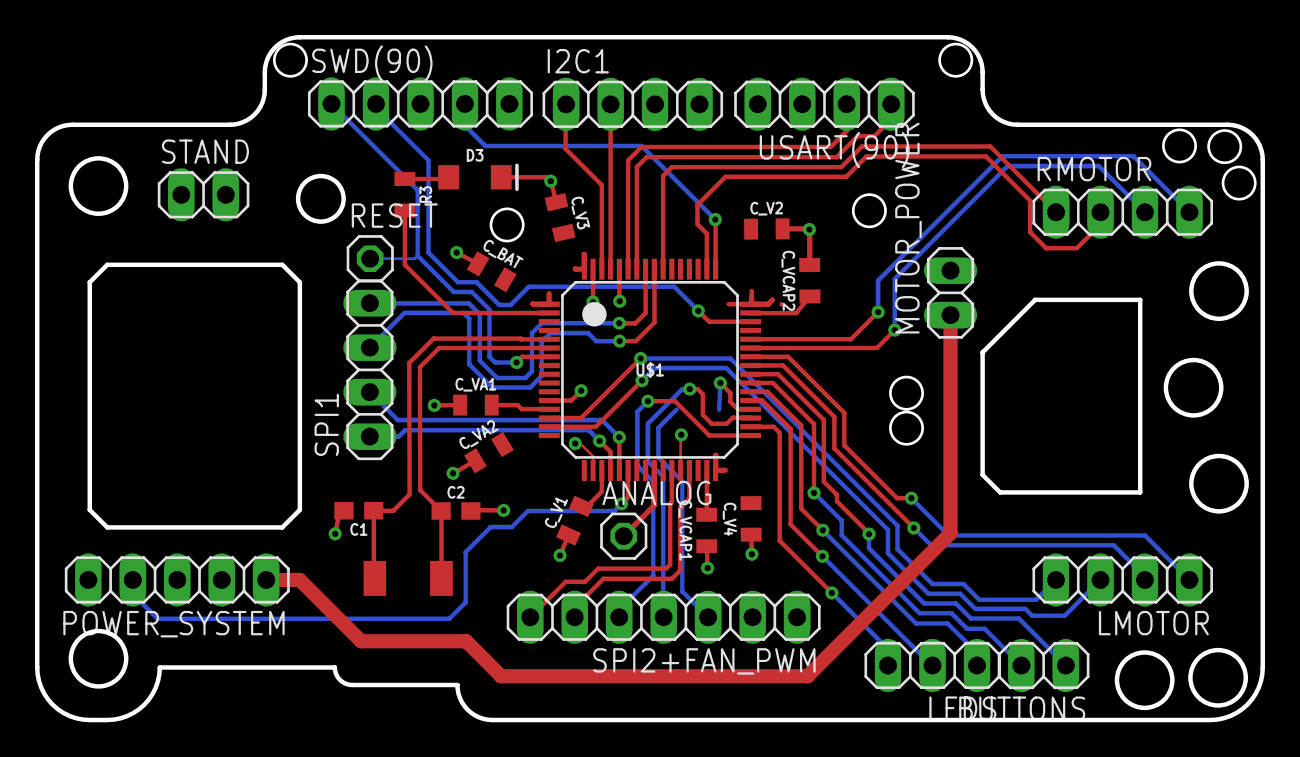
[picture p128: board MM2017-18_uC_Main.brd from above]

Board: 2 copper layers, 70.0 x 39.0 mm, 29 parts (0 on the bottom side), 40 nets.
