zht043/MicroMouse-Team1/Electrical Hardware/PCB_failed/IR/IR.brd

## EAGLE design Electrical Hardware/PCB_failed/IR/IR.brd (2018-03-08)

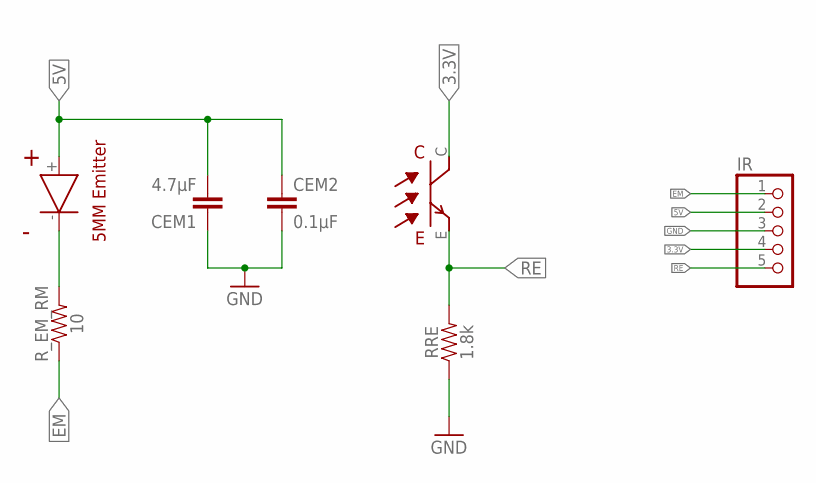
[picture p129: schematic IR.sch]

Parts:
CEM1: 4.7µF; 0805
CEM2: 0.1µF; 0805
IR: PINHD-1X5; 1X05
RRE: 1.8k; 0805
R_EM_RM: 10; 0805
U$21: EMITTER
U$23: RECEIVER

Connections:
3.3V: IR.4, U$23.C
5V: CEM1.2, CEM2.1, IR.2, U$21.+
EM: IR.1, R_EM_RM.1
EM-: R_EM_RM.2, U$21.-
GND: CEM1.1, CEM2.2, IR.3, RRE.1
RE: IR.5, RRE.2, U$23.E

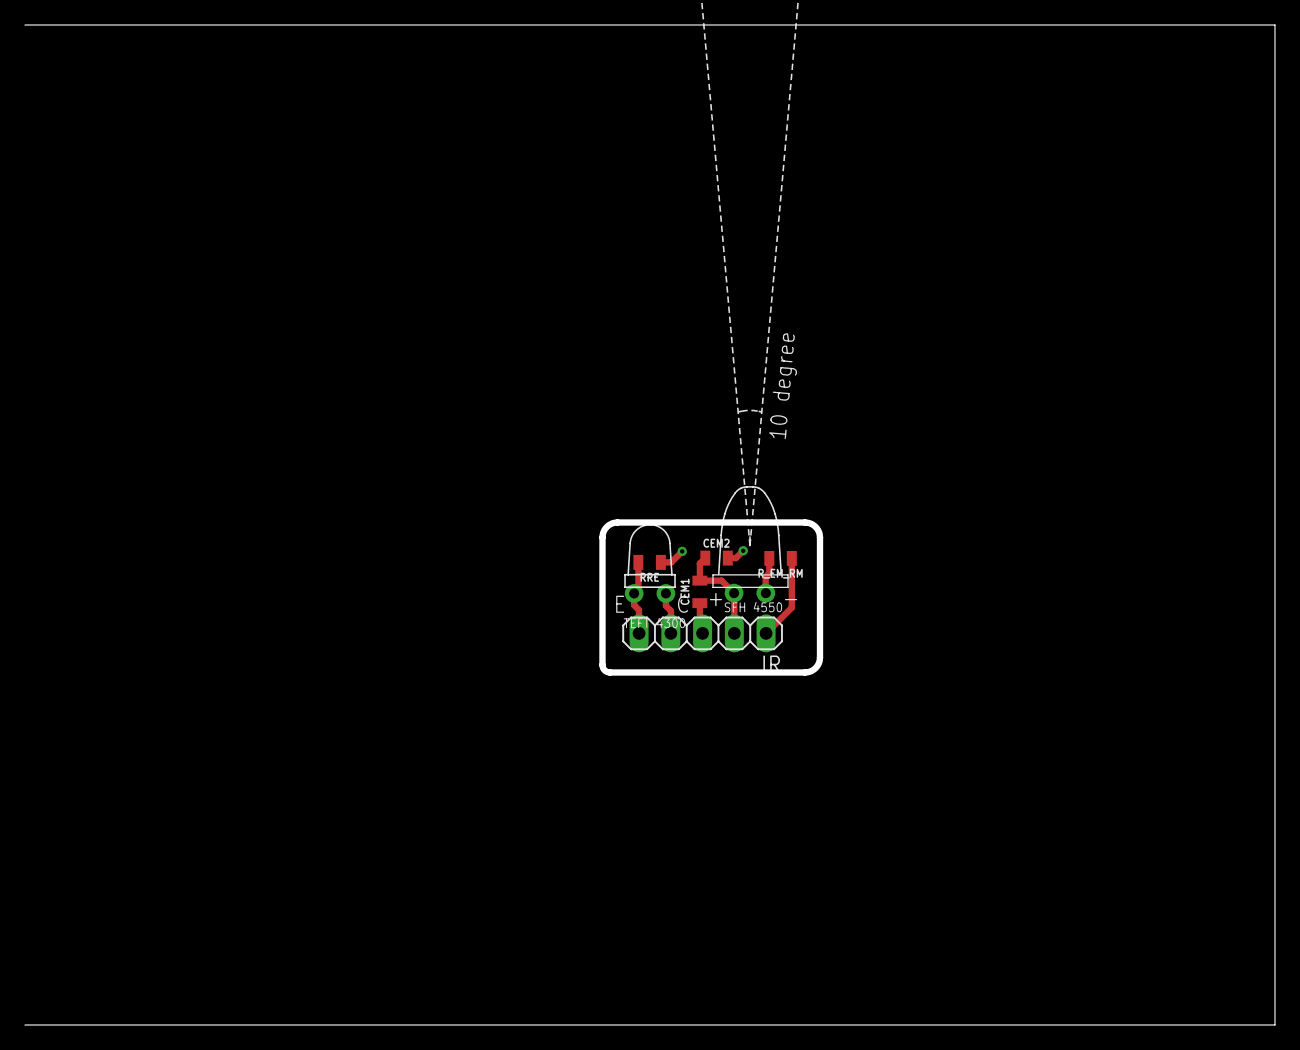
[picture p130: board IR.brd from above]

Board: 2 copper layers, 17.4 x 12.0 mm, 7 parts (0 on the bottom side), 6 nets.
