zht043/MicroMouse-Team1/Electrical Hardware/PCB_1st version/Motor Controller + 5V regulator/Motor-Controllers.brd

## EAGLE design Electrical Hardware/PCB_1st version/Motor Controller + 5V regulator/Motor-Controllers.brd (2018-03-08)

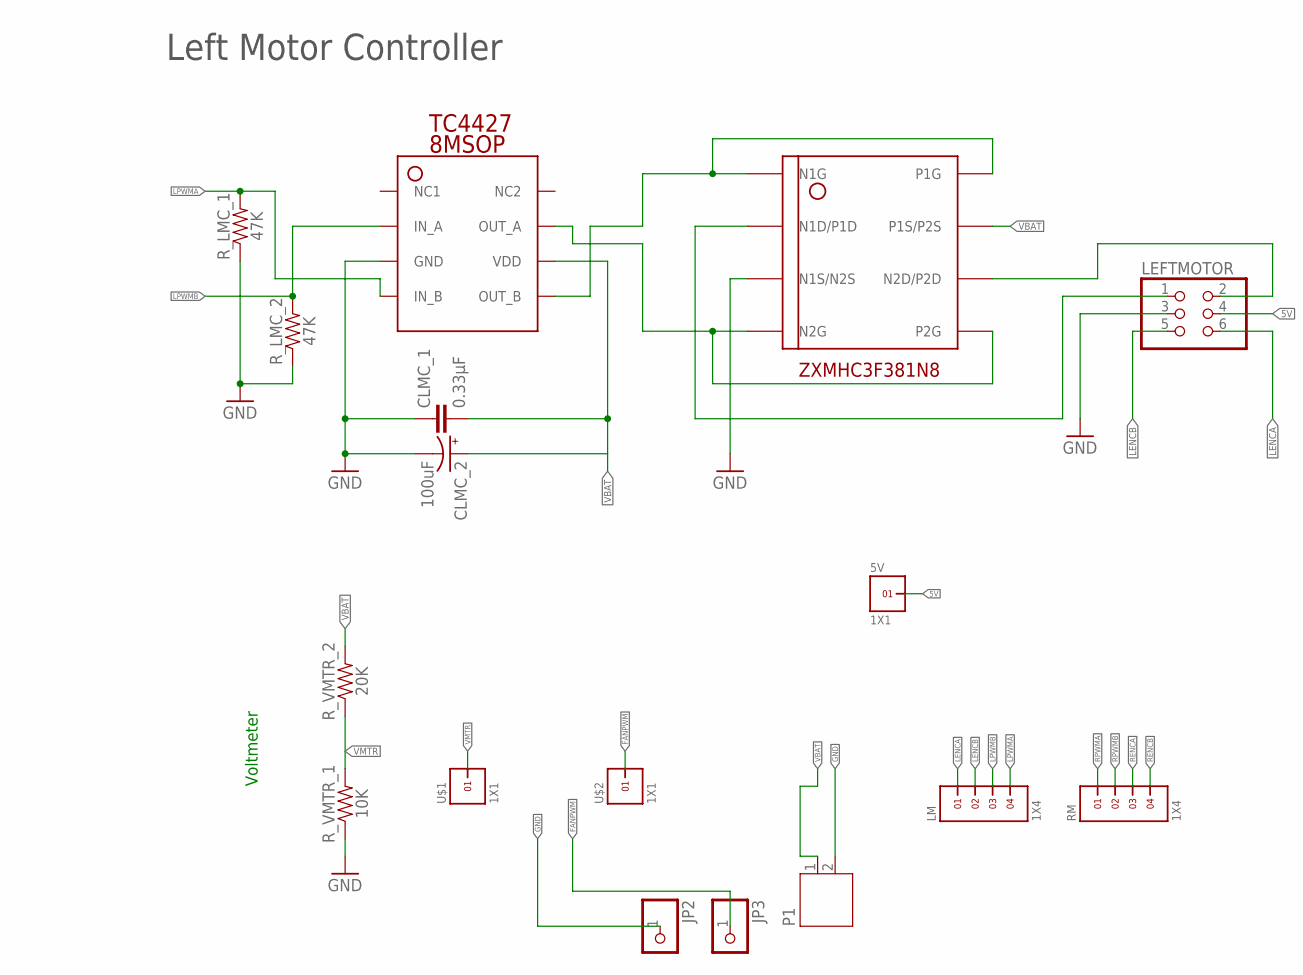
[picture p131: schematic Motor-Controllers.sch, part in row 1, column 1]

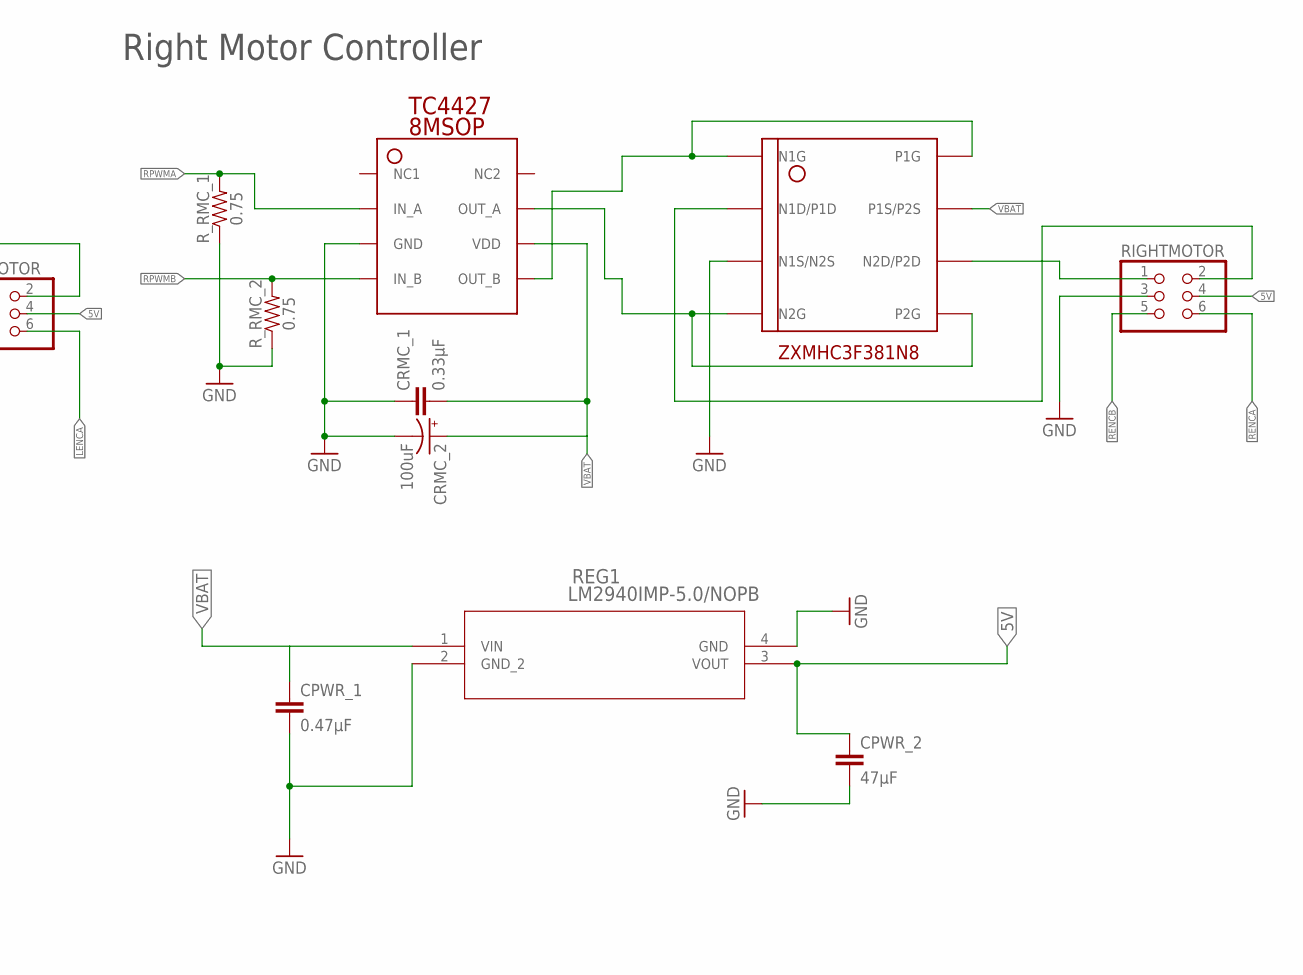
[picture p132: schematic Motor-Controllers.sch, part in row 1, column 2]

Parts:
5V: 1X1
CLMC_1: 0.33µF; 0805
CLMC_2: 100uF; EIA7343
CPWR_1: 0.47µF; 0805
CPWR_2: 47µF; 0805
CRMC_1: 0.33µF; 0805
CRMC_2: 100uF; EIA7343
JP2, JP3: PINHD-1X1; 1X01
LEFTMOTOR: PINHD-2X3; 2X03
LM: 1X4
P1: JST-PH2
REG1: LM2940IMP-5.0/NOPB; MP04A
RIGHTMOTOR: PINHD-2X3; 2X03
RM: 1X4
R_LMC_1, R_LMC_2: 47K; 0805
R_RMC_1, R_RMC_2: 0.75; 0805
R_VMTR_1: 10K; 0805
R_VMTR_2: 20K; 0805
U$1, U$2: 1X1
U$15, U$17: TC4427(8MSOP)
U$16, U$18: ZXMHC3F381N8

Connections:
5V: 5V.1, CPWR_2.1, LEFTMOTOR.4, REG1.3 (VOUT), RIGHTMOTOR.4
FANPWM: JP3.1, U$2.1
GND: CLMC_1.1, CLMC_2.C (-), CPWR_1.2, CPWR_2.2, CRMC_1.1, CRMC_2.C (-), JP2.1, LEFTMOTOR.3, P1.2, REG1.2 (GND_2), REG1.4 (GND), RIGHTMOTOR.3, R_LMC_1.1, R_LMC_2.1, R_RMC_1.1, R_RMC_2.1, R_VMTR_1.1, U$15.GND, U$16.N1S/N2S, U$17.GND, U$18.N1S/N2S
L: LEFTMOTOR.1, U$16.N1D/P1D
LENCA: LEFTMOTOR.6, LM.1
LENCB: LEFTMOTOR.5, LM.2
LPWMA: LM.4, R_LMC_1.2, U$15.IN_B
LPWMB: LM.3, R_LMC_2.2, U$15.IN_A
unnamed: LEFTMOTOR.2, U$16.N2D/P2D
unnamed: U$17.OUT_A, U$18.N2G, U$18.P2G
unnamed: U$17.OUT_B, U$18.N1G, U$18.P1G
unnamed: RIGHTMOTOR.1, U$18.N2D/P2D
OUT_A: U$15.OUT_B, U$16.N1G, U$16.P1G
OUT_B: U$15.OUT_A, U$16.N2G, U$16.P2G
R: RIGHTMOTOR.2, U$18.N1D/P1D
RENCA: RIGHTMOTOR.6, RM.3
RENCB: RIGHTMOTOR.5, RM.4
RPWMA: RM.1, R_RMC_1.2, U$17.IN_A
RPWMB: RM.2, R_RMC_2.2, U$17.IN_B
VBAT: CLMC_1.2, CLMC_2.A (+), CPWR_1.1, CRMC_1.2, CRMC_2.A (+), P1.1, REG1.1 (VIN), R_VMTR_2.2, U$15.VDD, U$16.P1S/P2S, U$17.VDD, U$18.P1S/P2S
VMTR: R_VMTR_1.2, R_VMTR_2.1, U$1.1

Notes on the sheet:
Left Motor Controller
Right Motor Controller
Voltmeter

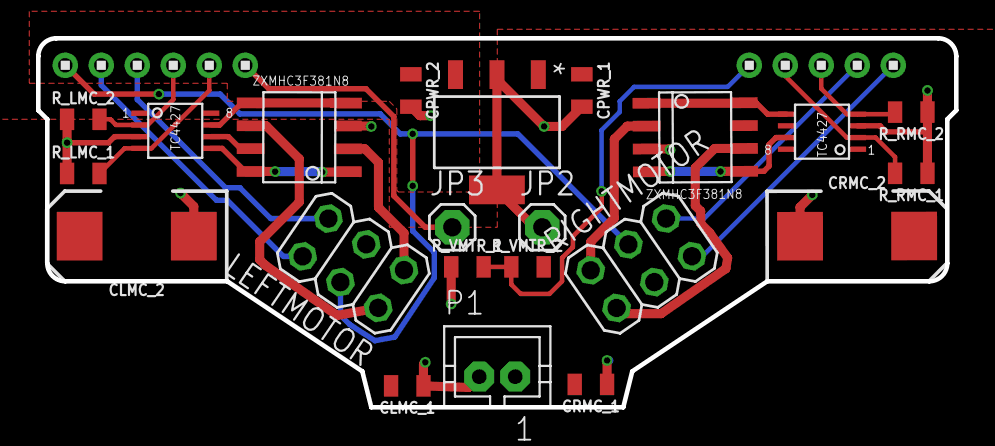
[picture p133: board Motor-Controllers.brd from above]

Board: 2 copper layers, 51.0 x 20.5 mm, 27 parts (0 on the bottom side), 21 nets.
