zht043/MicroMouse-Team1/Electrical Hardware/PCB 3rd version (Final Version)/peripheral/Peripherals.brd

## EAGLE design Electrical Hardware/PCB 3rd version (Final Version)/peripheral/Peripherals.brd (2018-05-23)

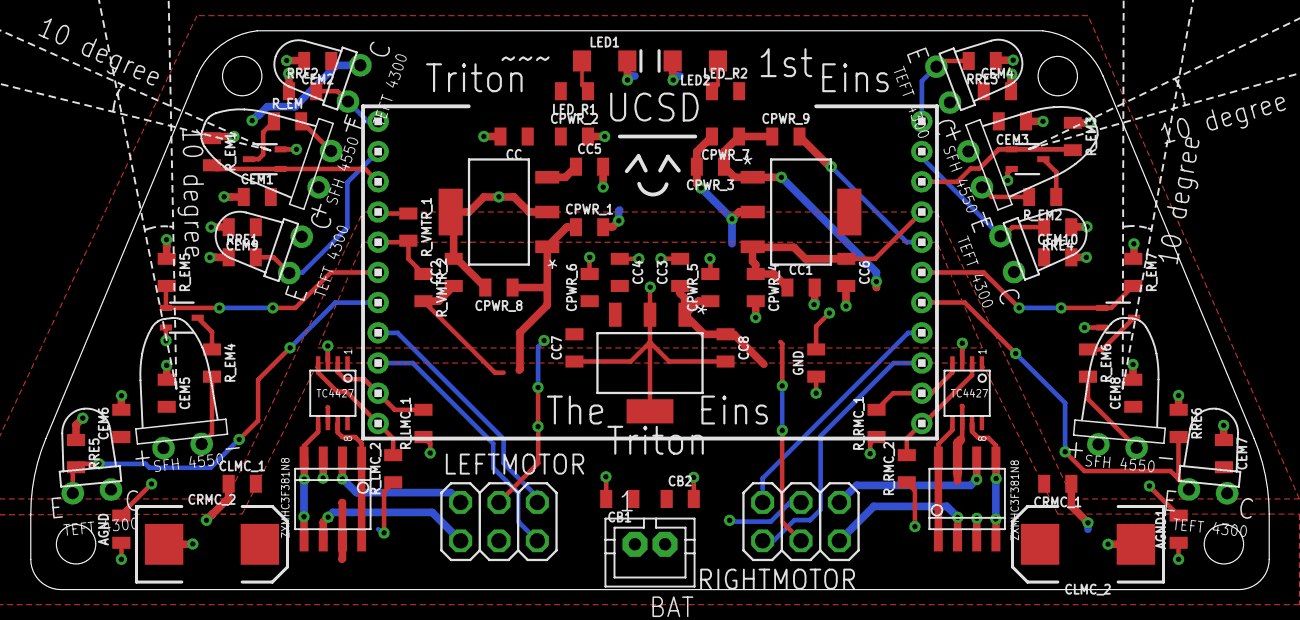
[picture p134: board Peripherals.brd from above]

Board: 2 copper layers, 82.0 x 37.0 mm, 95 parts (0 on the bottom side), 44 nets.

Parts:
AGND, AGND1: 0; 0805
BAT: JST-PH2
CB1: 0.1µF; 0805
CB2: 10µF; 0805
CC, CC1, CC2, CC3, CC4, CC5, CC6, CC7, CC8: 0.1uF; 0805
CEM1, CEM3, CEM5, CEM7: 4.7µF; 0805
CEM2, CEM4, CEM6, CEM8, CEM9, CEM10: 0.1µF; 0805
CLMC_1: 0.1µF; 0805
CLMC_2: 100uF; EIA7343
CPWR_1, CPWR_5: 0.47µF; 0805
CPWR_2, CPWR_6: 22uF or 33uF; 0805
CPWR_3, CPWR_7, CPWR_9: 0.1uF; 0805
CPWR_4: 0.33µF; 0805
CPWR_8: 0.1µF; 0805
CRMC_1: 0.1µF; 0805
CRMC_2: 100uF; EIA7343
EM_L: EMITTER
EM_LF: EMITTER
EM_R: EMITTER
EM_RF: EMITTER
GND: 0; 0805
LED1, LED2: BLUE; LED-1206
LED_R1, LED_R2: 3k; 0805
LEFTMOTOR: 2X03
LM: 1X4
REG1, REG3: LM2940IMP-5.0/NOPB; MP04A
REG2: LM2937IMP-3.3/NOPB; MP04A
RE_L: RECEIVER
RE_LFA: RECEIVER
RE_LFB: RECEIVER
RE_R: RECEIVER
RE_RFA: RECEIVER
RE_RFB: RECEIVER
RIGHTMOTOR: 2X03
RM: 1X4
RRE1, RRE2, RRE3, RRE4: ~500ohm; 0805
RRE5, RRE6: ~600ohm; 0805
R_EM, R_EM2, R_EM4, R_EM6: 5ohm; 0805
R_EM1, R_EM3, R_EM5, R_EM7: 10k; 0805
R_LMC_1, R_LMC_2: 47K; 0805
R_RMC_1, R_RMC_2: 47k; 0805
R_VMTR_1: 10K; 0805
R_VMTR_2: 20K; 0805
U$1, U$10: 1X3
U$2, U$3, U$11, U$12: 1X1
U$4, U$5, U$6, U$7: MCH3474
U$8, U$9: 1X2
U$15, U$17: TC4427(8MSOP)
U$16, U$18: ZXMHC3F381N8

Connections:
3.3V: CC1.1, CC6.1, CPWR_4.1, REG2.3, U$2.1
5V: CC4.2, CC7.2, CPWR_3.1, CPWR_6.1, CPWR_7.1, CPWR_9.1, LEFTMOTOR.4, REG2.1, REG3.3, RIGHTMOTOR.4
A5V: CC.1, CC5.1, CEM1.2, CEM2.1, CEM3.2, CEM4.1, CEM5.2, CEM6.1, CEM7.2, CEM8.1, CEM9.1, CEM10.1, CPWR_2.1, EM_L.+, EM_LF.+, EM_R.+, EM_RF.+, LED_R1.2, LED_R2.2, REG1.3, RE_L.C, RE_LFA.C, RE_LFB.C, RE_R.C, RE_RFA.C, RE_RFB.C
AGND: AGND.2, AGND1.2, CC.2, CC2.2, CC5.2, CEM1.1, CEM2.2, CEM3.1, CEM4.2, CEM5.1, CEM6.2, CEM7.1, CEM8.2, CEM9.2, CEM10.2, CPWR_1.2, CPWR_2.2, CPWR_8.2, LED1.C, LED2.C, REG1.2, REG1.4, RRE1.1, RRE2.1, RRE3.1, RRE4.1, RRE5.1, RRE6.1, R_EM1.1, R_EM3.1, R_EM5.1, R_EM7.1, R_VMTR_1.1, U$4.S, U$5.S, U$6.S, U$7.S, U$12.1
EMD_L: EM_L.-, R_EM4.2
EM_L: R_EM5.2, U$4.G, U$8.1
EM_LF: R_EM1.2, U$5.G, U$10.1
EM_R: R_EM7.2, U$7.G, U$9.2
EM_RF: R_EM3.2, U$1.1, U$6.G
GND: CC1.2, CC3.2, CC4.1, CC6.2, CC7.1, CC8.2, CPWR_3.2, CPWR_4.2, CPWR_5.2, CPWR_6.2, CPWR_7.2, CPWR_9.2, GND.2, REG2.2, REG3.2, REG3.4, U$3.1
L: LEFTMOTOR.2, U$16.N1D/P1D
LENCA: LEFTMOTOR.6, LM.1
LENCB: LEFTMOTOR.5, LM.2
LPWMA: LM.3, R_LMC_1.2, U$15.IN_A
LPWMB: LM.4, R_LMC_2.2, U$15.IN_B
MGND: AGND.1, AGND1.1, BAT.2, CB1.2, CB2.2, CLMC_1.1, CLMC_2.C, CRMC_1.1, CRMC_2.C, GND.1, LEFTMOTOR.3, RIGHTMOTOR.3, R_LMC_1.1, R_LMC_2.1, R_RMC_1.1, R_RMC_2.1, U$15.GND, U$16.N1S/N2S, U$17.GND, U$18.N1S/N2S
unnamed: R_EM.1, U$5.D
unnamed: R_EM2.1, U$6.D
unnamed: R_EM4.1, U$4.D
unnamed: R_EM6.1, U$7.D
unnamed: EM_LF.-, R_EM.2
unnamed: EM_RF.-, R_EM2.2
unnamed: EM_R.-, R_EM6.2
unnamed: LED1.A, LED_R1.1
unnamed: LEFTMOTOR.1, U$16.N2D/P2D
unnamed: LED2.A, LED_R2.1
unnamed: RIGHTMOTOR.1, U$18.N2D/P2D
OUTA: U$17.OUT_B, U$18.N1G, U$18.P1G
OUTB: U$17.OUT_A, U$18.N2G, U$18.P2G
OUT_A: U$15.OUT_A, U$16.N1G, U$16.P1G
OUT_B: U$15.OUT_B, U$16.N2G, U$16.P2G
R: RIGHTMOTOR.2, U$18.N1D/P1D
RENCA: RIGHTMOTOR.6, RM.3
RENCB: RIGHTMOTOR.5, RM.4
RE_L: RE_L.E, RRE5.2, U$8.2
RE_LFA: RE_LFA.E, RRE1.2, U$10.2
RE_LFB: RE_LFB.E, RRE2.2, U$10.3
RE_R: RE_R.E, RRE6.2, U$9.1
RE_RFA: RE_RFB.E, RRE4.2, U$1.2
RE_RFB: RE_RFA.E, RRE3.2, U$1.3
RPWMA: RM.2, R_RMC_1.2, U$17.IN_B
RPWMB: RM.1, R_RMC_2.2, U$17.IN_A
VBAT: BAT.1, CB1.1, CB2.1, CC2.1, CC3.1, CC8.1, CLMC_1.2, CLMC_2.A, CPWR_1.1, CPWR_5.1, CPWR_8.1, CRMC_1.2, CRMC_2.A, REG1.1, REG3.1, R_VMTR_2.2, U$15.VDD, U$16.P1S/P2S, U$17.VDD, U$18.P1S/P2S
VMTR: R_VMTR_1.2, R_VMTR_2.1, U$11.1
