zht043/MicroMouse-Team1/Electrical Hardware/PCB 3rd version (Final Version)/STM32 F405RGT.ioc

Mcu.UserName=STM32F405RGTx
PA0-WKUP.GPIO_Label=LencA
PA0-WKUP.Signal=S_TIM5_CH1
PA1.GPIO_Label=LencB
PA1.Signal=S_TIM5_CH2
PA10.GPIO_Label=RpwmA
PA10.Signal=S_TIM1_CH3
PA11.GPIO_Label=RpwmB
PA11.Signal=S_TIM1_CH4
PA13.Signal=SYS_JTMS-SWDIO
PA14.Signal=SYS_JTCK-SWCLK
PA15.GPIO_Label=RENCB
PA15.Signal=S_TIM2_CH1_ETR
PA2.Signal=ADCx_IN2
PA4.Signal=SPI1_NSS
PA5.Signal=SPI1_SCK
PA6.Signal=SPI1_MISO
PA7.Signal=SPI1_MOSI
PA8.GPIO_Label=LpwmA
PA8.Signal=S_TIM1_CH1
PA9.GPIO_Label=LpwmB
PA9.Signal=S_TIM1_CH2
PB0.Signal=ADCx_IN8
PB1.Signal=ADCx_IN9
PB12.Signal=SPI2_NSS
PB13.Signal=SPI2_SCK
PB14.Signal=SPI2_MISO
PB15.Signal=SPI2_MOSI
PB3.GPIO_Label=RENCA
PB3.Signal=S_TIM2_CH2
PB6.Signal=USART1_TX
PB7.Signal=USART1_RX
PC0.Signal=ADCx_IN10
PC1.Signal=ADCx_IN11
PC2.Signal=ADCx_IN12
PC3.Signal=ADCx_IN13
PC4.Signal=GPXTI4
PC5.Signal=ADCx_IN15
PC6.GPIO_Label=GY_INT
PC6.Signal=GPIO_Input
PH0-OSC_IN.Signal=RCC_OSC_IN
PH1-OSC_OUT.Signal=RCC_OSC_OUT
