zht043/MicroMouse-Team1/Reference materials/Futura/FuturaProject/user_Libraries/src/encoder.c

#include "stm32f4xx.h"
#include "encoder.h"

//PA0	TIM5_CH1	Encoder_R_CHA
//PA1	TIM5_CH2	Encoder_R_CHB

//PA15	TIM2_CH1	Encoder_L_CHA
//PB3	TIM2_CH2	Encoder_L_CHB


void Encoder_Configration(void)
{
	GPIO_InitTypeDef GPIO_InitStructure;
	RCC_APB1PeriphClockCmd(RCC_APB1Periph_TIM5|RCC_APB1Periph_TIM2, ENABLE);	
	
	GPIO_InitStructure.GPIO_Mode = GPIO_Mode_AF;
	GPIO_InitStructure.GPIO_PuPd = GPIO_PuPd_UP;
	GPIO_InitStructure.GPIO_Pin = GPIO_Pin_0 | GPIO_Pin_1 | GPIO_Pin_15;// pin 0/1/15 GPIOA: PA0 PA1 PA15
	GPIO_Init(GPIOA, &GPIO_InitStructure);
	GPIO_InitStructure.GPIO_Pin = GPIO_Pin_3;                           // pin 3 GPIOB     :  PB3
	GPIO_Init(GPIOB, &GPIO_InitStructure);	
	
	GPIO_PinAFConfig(GPIOA, GPIO_PinSource0, GPIO_AF_TIM5);
	GPIO_PinAFConfig(GPIOA, GPIO_PinSource1, GPIO_AF_TIM5);
	GPIO_PinAFConfig(GPIOA, GPIO_PinSource15, GPIO_AF_TIM2);
	GPIO_PinAFConfig(GPIOB, GPIO_PinSource3, GPIO_AF_TIM2);
	
    TIM_SetAutoreload (TIM5, 0xffffffff);//0xffffffff is the max value for 32 bit, the autoreload value will be 0xffff for 16 bit timer
	TIM_SetAutoreload (TIM2, 0xffffffff);
	/* Configure the encoder */
	TIM_EncoderInterfaceConfig(TIM5, TIM_EncoderMode_TI12, TIM_ICPolarity_Rising, TIM_ICPolarity_Rising);//rising rising or rising falling will help you to swithc the direction for encoder at quardrature mode
	TIM_EncoderInterfaceConfig(TIM2, TIM_EncoderMode_TI12, TIM_ICPolarity_Rising, TIM_ICPolarity_Falling);//if the setting is rising rising and the encoder counts decreases when wheel spin forward, just change it to rising falling
	/* TIM4 counter enable */
	TIM_Cmd(TIM5, ENABLE);	
	TIM_Cmd(TIM2, ENABLE);	
}

int32_t getRightEncCount(void) {
	//return TIM_GetCounter(TIM5);
	return TIM5->CNT;
}

void resetRightEncCount(void) {
	TIM5->CNT = 0;
}

int32_t getLeftEncCount(void) {
	//return TIM_GetCounter(TIM2);
	return TIM2->CNT;
}

void resetLeftEncCount(void) {
	TIM2->CNT = 0;
}
