zht043/MicroMouse-Team1/STM32_MicroMouse/XXXXXCLICK HEREXXXXX/Code/MDK-ARM/mm_lib/inc/Motor.h

#ifndef __Motor_H
#define __Motor_H

#include "Timer.h"
#include "GPIO.h"
#include "SysTime.h"

void initMotor(void);
void motor(double Lpwr, double Rpwr);
void motorTester(void);
void stop(void);
void curve(double v, double w);

#endif 
