zht043/MicroMouse-Team1/Reference materials/Futura/FuturaProject/user_Libraries/inc/encoder.h

#ifndef ENCODER_H
#define ENCODER_H 



void Encoder_Configration(void);
int32_t getLeftEncCount(void);
int32_t getRightEncCount(void);
void resetRightEncCount(void);
void resetLeftEncCount(void);

#endif
