zht043/MicroMouse-Team1/Reference materials/Futura/FuturaProject/user_Libraries/src/matrixDisplay.c

#include "stm32f4xx.h"
#include "matrixDisplay.h"
#include "SPI.h"
#include "delay.h"
#include <stdio.h>


/****************************************************************/
/*                    display four characters                   */
/*                this can be called during 1ms ISR             */
/****************************************************************/
void displayMatrix(const char *s)
{   
	int i, j;
	char const *ptr; //pointer for starting address of character s
	RS_0;   //select control register
	CE_0;	//enable data writing
	
	for(i=0; i<4; i++)
	{
		ptr = &fontTable[s[i]*5];
		for(j=0; j<5; j++)
		{
			while (SPI_I2S_GetFlagStatus(SPI2, SPI_I2S_FLAG_TXE) == RESET);
			SPI_I2S_SendData(SPI2, *ptr);
			ptr++;
		}//for j
	}//for i
			while (SPI_I2S_GetFlagStatus(SPI2, SPI_I2S_FLAG_TXE) == RESET);
			while (SPI_I2S_GetFlagStatus(SPI2, SPI_I2S_FLAG_BSY) == SET);
	CE_1;   //latch on
}

void displayErr(int err) {
	char str[5];
	snprintf(str, 5, "E%03d", err);
	
	displayMatrix(str);
}

void displayFloat(float f) {
	//a string with the format xx.x
	char str[5]; //need 5 because of null byte
	
	snprintf(str, 5, "%.1f", f);
	
	displayMatrix(str);
}

void displayInt(int i) {
	char str[5];
	
	snprintf(str, 5, "%04d", i);
	
	displayMatrix(str);
}

void displayMatrixScroll(char* str) {
	int i;
	
	for(i = 0; i < 3; i++) {
		if(str[i] == '\0') {
			displayMatrix(str);
			return;
		}
	}
	
	i = 0;
	while(str[i+3] != '\0') {
		displayMatrix(&str[i]);
		delay_ms(1000);
		i++;
	}
}


/****************************************************************/
/*                       clear screen                           */
/*                 write 4 spaces into screen                   */
/****************************************************************/
void clearScreen(void)
{   
	int i;
	RS_0;   //select control register
	CE_0;	//enable data writing
	
		for(i=0; i<20; i++)
		{
			while (SPI_I2S_GetFlagStatus(SPI2, SPI_I2S_FLAG_TXE) == RESET);
			SPI_I2S_SendData(SPI2, 0x00);
		}
			while (SPI_I2S_GetFlagStatus(SPI2, SPI_I2S_FLAG_TXE) == RESET);
			while (SPI_I2S_GetFlagStatus(SPI2, SPI_I2S_FLAG_BSY) == SET);
	CE_1;   //latch on
}



const char fontTable[] = {
	//0
	0x80, 0x80, 0x80, 0x80, 0x80, // (space)
	0x40, 0x40, 0x40, 0x40, 0x40, // (space)
	0x20, 0x20, 0x20, 0x20, 0x20, // (space)
	0x10, 0x10, 0x10, 0x10, 0x10, // (space)
	0x08, 0x08, 0x08, 0x08, 0x08, // (space)
	0x04, 0x04, 0x04, 0x04, 0x04, // (space)
	0x02, 0x02, 0x02, 0x02, 0x02, // (space)
	0x01, 0x01, 0x01, 0x01, 0x01, // (space)
	//8
	0x80, 0x80, 0x80, 0x80, 0x80, // (space)
	0xc0, 0xc0, 0xc0, 0xc0, 0xc0, // (space)
	0xe0, 0xe0, 0xe0, 0xe0, 0xe0, // (space)
	0xf0, 0xf0, 0xf0, 0xf0, 0xf0, // (space)
	0xf8, 0xf8, 0xf8, 0xf8, 0xf8, // (space)
	0xfc, 0xfc, 0xfc, 0xfc, 0xfc, // (space)
	0xfe, 0xfe, 0xfe, 0xfe, 0xfe, // (space)
	0xff, 0xff, 0xff, 0xff, 0xff, // (space)
	//16
	0x7f, 0x7f, 0x7f, 0x7f, 0x7f, // (space)
	0x3f, 0x3f, 0x3f, 0x3f, 0x3f, // (space)
	0x1f, 0x1f, 0x1f, 0x1f, 0x1f, // (space)
	0x0f, 0x0f, 0x0f, 0x0f, 0x0f, // (space)
	0x07, 0x07, 0x07, 0x07, 0x07, // (space)
	0x03, 0x03, 0x03, 0x03, 0x03, // (space)
	0x01, 0x01, 0x01, 0x01, 0x01, // (space)
	0x00, 0x00, 0x00, 0x00, 0x00, // (space)
	
	//24
	0x7E, 0x42, 0x43, 0x42, 0x7E,
	0x7E, 0x62, 0x63, 0x62, 0x7E,
	0x7E, 0x72, 0x73, 0x72, 0x7E,
	0x7E, 0x7A, 0x7B, 0x7A, 0x7E,
	0x7E, 0x7E, 0x7F, 0x7E, 0x7E,
	0x04, 0x0E, 0x15, 0x04, 0x04,
	0x7C, 0x72, 0x72, 0x42, 0x7C,
	0x7C, 0x42, 0x72, 0x72, 0x7C,
	//32
	0x00, 0x00, 0x00, 0x00, 0x00, // space
	0x00, 0x00, 0x2f, 0x00, 0x00, // !
	0x00, 0x07, 0x00, 0x07, 0x00, // "
	0x14, 0x7f, 0x14, 0x7f, 0x14, // #
	0x24, 0x2a, 0x7f, 0x2a, 0x12, // $
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
	0x7D, 0x15, 0x0F, 0x55 ,0x7D, //±û
	0x11, 0x21, 0x7F, 0x01 ,0x01, //¶¡
	0x66, 0x44, 0x7F, 0x44 ,0x66, //³ö 
	0x7E, 0x22, 0x22, 0x22 ,0x7E, //¿Ú
	0x08, 0x0C, 0x7E, 0x0C ,0x80, //upper arrow
	0x10, 0x30, 0x7E, 0x30 ,0x10, //down arrow


	0x7F, 0x7F, 0x7F, 0x7F ,0x7F, //full filled block

}; 
