zht043/MicroMouse-Team1/STM32_MicroMouse/XXXXXCLICK HEREXXXXX/Code/MDK-ARM/mm_lib/inc/IR.h

#ifndef __IR_H
#define __IR_H
#include "GPIO.h"
#include "SysTime.h"
#include "ADC.h"
#include "USART.h"
#include "Timer.h"
#define num_samples_IR  1 // number of samples to average over for readings
#define Impulse_period 50

#define IRv_L   IR_values[0]
#define IRv_LFA IR_values[1]
#define IRv_LFB IR_values[2]
#define IRv_RFB IR_values[3]
#define IRv_RFA IR_values[4]
#define IRv_R   IR_values[5]


#define IR_L   0
#define IR_LFA 1
#define IR_LFB 2
#define IR_RFB 3
#define IR_RFA 4
#define IR_R   5
#define IR_LF  6
#define IR_RF  7

void initIR(void);
void IR_Tester(void);
uint16_t parse_ADC_Sample(uint16_t Sarr[], uint32_t n);
void TIM3_itTask_cc1(void);


#endif
