zht043/MicroMouse-Team1/STM32_MicroMouse/XXXXXCLICK HEREXXXXX/Code/MDK-ARM/mm_lib/inc/Led.h

#ifndef __LED_H
#define __LED_H

#include "GPIO.h"
#include "SysTime.h"

void initLED(void);
void L_LED_ON(void);
void L_LED_OFF(void);
void R_LED_ON(void);
void R_LED_OFF(void);
void blinkLED(uint8_t numBlinks);
void blinkLED_Both(uint8_t numBlinks);
void blinkLED_Left(uint8_t numBlinks);
void blinkLED_Right(uint8_t numBlinks);
#endif 
