zht043/MicroMouse-Team1/STM32_MicroMouse/XXXXXCLICK HEREXXXXX/Code/MDK-ARM/mm_lib/inc/StartGesture.h

#ifndef __StartGesture_H
#define __StartGesture_H
#include "GPIO.h"
#include "IR.h"
#include "Led.h"

#define ProgramA 0x01
#define ProgramB 0x02
#define ProgramC 0x03

uint8_t startGesture(void);

#endif
