zht043/MicroMouse-Team1/Reference materials/Futura/FuturaProject/user_Libraries/inc/adc.h

#ifndef ADC_H
#define ADC_H   


void ADC_Config(void);
u16 readADC(ADC_TypeDef* ADCx, u8 channel, uint8_t sampleTime);

#define read_Vol_Meter     readADC(ADC1, 3, ADC_SampleTime_84Cycles)
#define read_LF_Sensor     readADC(ADC1, 9,  ADC_SampleTime_84Cycles)
#define read_RF_Sensor     readADC(ADC1, 4, ADC_SampleTime_84Cycles)
#define	read_DL_Sensor     readADC(ADC1, 8,  ADC_SampleTime_84Cycles)
#define read_DR_Sensor     readADC(ADC1, 5, ADC_SampleTime_84Cycles)
#define	read_Outz	       readADC(ADC1, 15,  ADC_SampleTime_84Cycles)
#define	read_Vref	       readADC(ADC1, 14,  ADC_SampleTime_84Cycles)

#endif
