zht043/MicroMouse-Team1/Reference materials/Futura/FuturaProject/user_Libraries/inc/delay.h

#ifndef DELAY_H
#define DELAY_H   
#include "stdbool.h" //for bool

void Systick_Configuration(void);//initialize systick
void delay_ms(u32 nTime);
void delay_us(u32 nTime);
u32 micros(void);
u32 millis(void);
void elapseMicros(u32 targetTime, u32 oldt);
void elapseMillis(u32 targetTime, u32 oldt);

extern volatile u32 Millis;
extern volatile u32 Micros;

#define useExternalOSC 0     //true=1/false=0
#define systemFrequency 168   //MHz


#endif
