zht043/MicroMouse-Team1/Reference materials/Futura/FuturaProject/user_Libraries/src/SPI.c

#include "stm32f4xx.h"
#include "SPI.h"
#include "matrixDisplay.h"
#include "led.h"

void SPI_Configuration(void)
{
	GPIO_InitTypeDef GPIO_InitStructure;
	SPI_InitTypeDef SPI_InitStruct;
	// enable the SPI peripheral clock
	RCC_APB1PeriphClockCmd(RCC_APB1Periph_SPI2, ENABLE);
	
	RCC_AHB1PeriphClockCmd(RCC_AHB1Periph_GPIOB, ENABLE);
	RCC_AHB1PeriphClockCmd(RCC_AHB1Periph_GPIOC, ENABLE);
	
	// Connect SPI pins to AF5
  GPIO_PinAFConfig(GPIOB, GPIO_PinSource13, GPIO_AF_SPI2);
	GPIO_PinAFConfig(GPIOB, GPIO_PinSource15, GPIO_AF_SPI2);
	
	


//GPIO_C
	GPIO_InitStructure.GPIO_Mode  = GPIO_Mode_AF;
	GPIO_InitStructure.GPIO_Speed = GPIO_Speed_50MHz;	
	GPIO_InitStructure.GPIO_OType = GPIO_OType_PP;
	GPIO_InitStructure.GPIO_PuPd  = GPIO_PuPd_NOPULL;
								   //   CLK         DATA_IN     
	GPIO_InitStructure.GPIO_Pin   = GPIO_Pin_13 | GPIO_Pin_15;
	GPIO_Init(GPIOB, &GPIO_InitStructure);	
	
	//for RS
	GPIO_InitStructure.GPIO_Pin = GPIO_Pin_14;
	GPIO_InitStructure.GPIO_Mode = GPIO_Mode_OUT;
	GPIO_InitStructure.GPIO_OType = GPIO_OType_PP;
	GPIO_InitStructure.GPIO_Speed = GPIO_Speed_100MHz;
	GPIO_InitStructure.GPIO_PuPd = GPIO_PuPd_NOPULL;
	GPIO_Init(GPIOB, &GPIO_InitStructure); 

//GPIOD
	//for CE
	GPIO_InitStructure.GPIO_Pin = GPIO_Pin_6;
	GPIO_InitStructure.GPIO_Mode = GPIO_Mode_OUT;
	GPIO_InitStructure.GPIO_OType = GPIO_OType_PP;
	GPIO_InitStructure.GPIO_Speed = GPIO_Speed_100MHz;
	GPIO_InitStructure.GPIO_PuPd = GPIO_PuPd_NOPULL;
	GPIO_Init(GPIOC, &GPIO_InitStructure); 

//SPI    APB1=AHB1(168MHz)/4=42MHz
  // now we can set up the SPI peripheral
  // Assume the target is write only and we look after the chip select ourselves
  // SPI clock rate will be system frequency/4/prescaler
  // so here we will go for 42MHz/2 = 21MHz
	SPI_I2S_DeInit(SPI2);
	SPI_StructInit(&SPI_InitStruct);
	SPI_InitStruct.SPI_Mode = SPI_Mode_Master;
	SPI_InitStruct.SPI_Direction = SPI_Direction_1Line_Tx;
	SPI_InitStruct.SPI_NSS = SPI_NSS_Soft;
	SPI_InitStruct.SPI_BaudRatePrescaler = SPI_BaudRatePrescaler_2;

	SPI_Init(SPI2, &SPI_InitStruct);
	SPI_SSOutputCmd(SPI2, ENABLE);

	SPI_Cmd(SPI2, ENABLE);
	SPI_NSSInternalSoftwareConfig(SPI2, ENABLE);

	CE_1;
	WriteControlRegister(0x77);
	clearScreen();
}

void WriteControlRegister(char c) 
{
	RS_1;   //select control register
	CE_0;	//enable data writing
	while (SPI_I2S_GetFlagStatus(SPI2, SPI_I2S_FLAG_TXE) == RESET);
	SPI_I2S_SendData(SPI2, c);
	while (SPI_I2S_GetFlagStatus(SPI2, SPI_I2S_FLAG_TXE) == RESET);
	while (SPI_I2S_GetFlagStatus(SPI2, SPI_I2S_FLAG_BSY) == SET);
	

	CE_1;   //latch on
	RS_0;	//switch back to data register
}
