zht043/MicroMouse-Team1/Reference materials/Futura/FuturaProject/user_Libraries/src/adc.c

#include "main.h"
#include "led.h"
#include "sensor_Function.h"



void ADC_Config(void)
{	
	ADC_InitTypeDef       ADC_InitStructure;
	ADC_CommonInitTypeDef ADC_CommonInitStructure; 
	GPIO_InitTypeDef GPIO_InitStructure;  
	RCC_APB2PeriphClockCmd(RCC_APB2Periph_ADC1, ENABLE);    
 
	GPIO_InitStructure.GPIO_Pin = GPIO_Pin_3 | GPIO_Pin_4 | GPIO_Pin_5;
	GPIO_InitStructure.GPIO_Mode = GPIO_Mode_AN;
	GPIO_InitStructure.GPIO_PuPd = GPIO_PuPd_NOPULL ;
	GPIO_Init(GPIOA, &GPIO_InitStructure);	
	
	GPIO_InitStructure.GPIO_Pin = GPIO_Pin_0 | GPIO_Pin_1;
	GPIO_InitStructure.GPIO_Mode = GPIO_Mode_AN;
	GPIO_InitStructure.GPIO_PuPd = GPIO_PuPd_NOPULL ;
	GPIO_Init(GPIOB, &GPIO_InitStructure);	
	
	GPIO_InitStructure.GPIO_Pin = GPIO_Pin_4 | GPIO_Pin_5;
	GPIO_InitStructure.GPIO_Mode = GPIO_Mode_AN;
	GPIO_InitStructure.GPIO_PuPd = GPIO_PuPd_NOPULL ;
	GPIO_Init(GPIOC, &GPIO_InitStructure);		
	
	/* ADC Common Init **********************************************************/
	ADC_CommonInitStructure.ADC_Mode = ADC_Mode_Independent;
	ADC_CommonInitStructure.ADC_Prescaler = ADC_Prescaler_Div4;
	ADC_CommonInitStructure.ADC_DMAAccessMode = ADC_DMAAccessMode_Disabled;
	ADC_CommonInitStructure.ADC_TwoSamplingDelay = ADC_TwoSamplingDelay_20Cycles;
	ADC_CommonInit(&ADC_CommonInitStructure);

	/* ADC1 Init ****************************************************************/
	ADC_InitStructure.ADC_Resolution = ADC_Resolution_12b;
	ADC_InitStructure.ADC_ScanConvMode = DISABLE;
	ADC_InitStructure.ADC_ContinuousConvMode = DISABLE;
	ADC_InitStructure.ADC_ExternalTrigConv = DISABLE;
	ADC_InitStructure.ADC_DataAlign = ADC_DataAlign_Right;
	ADC_InitStructure.ADC_NbrOfConversion = 1;
	ADC_Init(ADC1, &ADC_InitStructure);       
	ADC_ITConfig(ADC1, ADC_IT_EOC, ENABLE);

	/* Enable ADC1 */
	ADC_Cmd(ADC1, ENABLE);
	
	LF_EM_OFF;                	
	RF_EM_OFF;    
	SIDE_EM_OFF;	
}


u16 readADC(ADC_TypeDef* ADCx, u8 channel, uint8_t sampleTime)
{    
	ADC_RegularChannelConfig(ADCx, channel, 1, sampleTime);
	ADC_SoftwareStartConv(ADCx);
	while(ADC_GetFlagStatus(ADCx, ADC_FLAG_EOC) == RESET);
	return ADC_GetConversionValue(ADCx);
}
