zht043/MicroMouse-Team1/Reference materials/Futura/FuturaProject/user_Libraries/src/button.c

#include "stm32f4xx.h"

void button_Configuration(void)//PA0 flow input
{
    EXTI_InitTypeDef   EXTI_InitStructure;
    GPIO_InitTypeDef   GPIO_InitStructure;
    NVIC_InitTypeDef   NVIC_InitStructure;

    

    /* Enable SYSCFG clock */
    RCC_APB2PeriphClockCmd(RCC_APB2Periph_SYSCFG, ENABLE);

	
	  /* Enable GPIOA clock */
    RCC_AHB1PeriphClockCmd(RCC_AHB1Periph_GPIOB | RCC_AHB1Periph_GPIOC, ENABLE);
	
	  /* Connect EXTI Line0 to PB5 pin */
    SYSCFG_EXTILineConfig(EXTI_PortSourceGPIOB, EXTI_PinSource5);
	
    /* Configure PA0 pin as input floating */
	  /* Push button 0 */
    GPIO_InitStructure.GPIO_Mode = GPIO_Mode_IN;
    GPIO_InitStructure.GPIO_PuPd = GPIO_PuPd_NOPULL;
    GPIO_InitStructure.GPIO_Pin = GPIO_Pin_5;
    GPIO_Init(GPIOB, &GPIO_InitStructure);
	
	  /* Configure EXTI Line5 */
    EXTI_InitStructure.EXTI_Line = EXTI_Line5;
    EXTI_InitStructure.EXTI_Mode = EXTI_Mode_Interrupt;
    EXTI_InitStructure.EXTI_Trigger = EXTI_Trigger_Rising;  
    EXTI_InitStructure.EXTI_LineCmd = ENABLE;
    EXTI_Init(&EXTI_InitStructure);
		
		
		/* Enable and set EXTI Line5 Interrupt to the lowest priority */
    NVIC_InitStructure.NVIC_IRQChannel = EXTI9_5_IRQn;
    NVIC_InitStructure.NVIC_IRQChannelPreemptionPriority = 1;
    NVIC_InitStructure.NVIC_IRQChannelSubPriority = 0;
    NVIC_InitStructure.NVIC_IRQChannelCmd = ENABLE;
    NVIC_Init(&NVIC_InitStructure);
		
		
		
		
		
	
	  /* Push button 1 */
		GPIO_InitStructure.GPIO_Mode = GPIO_Mode_IN;
    GPIO_InitStructure.GPIO_PuPd = GPIO_PuPd_NOPULL;
    GPIO_InitStructure.GPIO_Pin = GPIO_Pin_13;
    GPIO_Init(GPIOC, &GPIO_InitStructure);

  
		
		/* Connect EXTI Line0 to PC13 pin */
		SYSCFG_EXTILineConfig(EXTI_PortSourceGPIOC, EXTI_PinSource13);

    
		
		EXTI_InitStructure.EXTI_Line = EXTI_Line13;
    EXTI_InitStructure.EXTI_Mode = EXTI_Mode_Interrupt;
    EXTI_InitStructure.EXTI_Trigger = EXTI_Trigger_Rising;  
    EXTI_InitStructure.EXTI_LineCmd = ENABLE;
    EXTI_Init(&EXTI_InitStructure);

    
		
		NVIC_InitStructure.NVIC_IRQChannel = EXTI15_10_IRQn;
    NVIC_InitStructure.NVIC_IRQChannelPreemptionPriority = 1;
    NVIC_InitStructure.NVIC_IRQChannelSubPriority = 0;
    NVIC_InitStructure.NVIC_IRQChannelCmd = ENABLE;
    NVIC_Init(&NVIC_InitStructure);
}
