zht043/MicroMouse-Team1/Reference materials/STM32_NucleoBoard_Experiment/XXXXXCLICK HEREXXXXX/Code/MDK-ARM/user_lib/inc/SysTime.h

#ifndef __SysTime_H
#define __SysTime_H

#include "stm32f4xx.h"

void SysTick_Init(uint32_t ticks) ; 
void SysTick_Increment(void);
uint32_t millis(void);
uint32_t micros(void);
void delay_us(uint32_t Time);
void delay(uint32_t Time); 

#endif
