zht043/MicroMouse-Team1/(commit log)

2018-03-11 fixed some error on previous update
    [GPIO.c, SysTime.c, SysTime.h, main.c]
2018-03-11 added mechanical hardware folder
    [ChassisFInalVersion.dxf]
2018-03-12 Added pic for pin reference
2018-03-12 ST reference materials
2018-03-13 Delete STD Lib Template
    Save storage space, STD template folder took too much space, we could always download this template on ST's official website
    [simulation.xls]
2018-03-13 Deleted unneccessary folders
    [STM32F4xx_Clock_Configuration_V1.1.0.xls]
2018-03-13 Added unfinished SPI.c SPI.h
2018-03-26 Updated SPI
2018-03-27 Replaced Template///Fixed Errors
    The older version's template was damaged, it won't work on device such as "f40xx 41xxx
    [STM32F4xx_Clock_Configuration_V1.1.0.xls]
2018-03-31 Added STD Example
    [simulation.xls]
2018-04-06 Lots of changes
    [STM32F4xx_Clock_Configuration_V1.1.0.xls]
2018-04-22 3week Meeting
    [STM32F4xx_Clock_Configuration_V1.1.0.xls, Up.brd, Up.sch]
2018-04-28 update USART
    [Down.brd, Down.sch, Peripherals.sch, Up.brd, Up.sch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]
2018-04-29 PCB 3rd version
    [Down.sch, Peripherals.brd]
2018-04-29 PCB 3rd v upd
    [Peripherals.brd, Peripherals.sch]
2018-05-01 Finshing PCB 3rd version Peripheral Board
    [Peripherals.brd, Peripherals.sch]
2018-05-03 motor tester
2018-05-05 update PCB 3rd v
    [MCU.brd, MCU.sch, Peripherals.brd, Peripherals.sch, Up.sch]
2018-05-05 updated ADC
    [MCU.brd]
2018-05-05 Update SPI
2018-05-06 finalized PCB
    [MCU.brd, MCU.sch, Peripherals.brd]
2018-05-06 minor updates
    [MCU.brd, MCU.sch]
2018-05-07 update Interrupt
2018-05-07 Fixed ADC problems
2018-05-12 Timer Interrupt
2018-05-14 resolve merge conflict
    [Down.brd, Down.sch, MCU.brd, MCU.sch, Peripherals.brd, Peripherals.sch, STM32F4xx_Clock_Configuration_V1.1.0.xls, Up.brd]
2018-05-14 resolve merge conflicts
    [STM32F4xx_Clock_Configuration_V1.1.0.xls]
2018-05-14 rename mm folder
    [STM32F4xx_Clock_Configuration_V1.1.0.xls]
2018-05-15 Revert "IR readings"
    This reverts commit 7ffad07f1cbb3d3cd54bcbddc103bf1a12a12f0d.
    [ADC.c, ADC.h, Timer.c, Timer.h, main.c]
2018-05-15 Revert "Revert "IR readings""
    This reverts commit c804b46515297fe7e4da5a3f733dcb047e72166f.
    [ADC.c, ADC.h, Timer.c, Timer.h, main.c]
2018-05-23 PID tuning
2018-05-23 Add safety guideline
    [Peripherals.brd]
2018-05-24 PID draft
2018-05-25 PID worked
2018-05-26 simulate PID
2023-09-12 update docs
    [STM32F4xx_Clock_Configuration_V1.1.0.xls, simulation.xls]
