zht043/MicroMouse-Team1/(notices)

Notices in the files:
parts and their libraries:
SparkFun-PowerSymbols: Licensing: Creative Commons ShareAlike 4.0 International - https://creativecommons.org/licenses/by-sa/4.0
LM2937IMP-3.3: COPYRIGHT: Copyright C 2015 Accelerated Designs. All rights reserved
